chen123037/X100-Flight-Controller-Edu/hardware/proposals/L101_BOURNS_SRP1038A_NOT_APPROVED/README.md

# L101 紧凑10µH电感候选 — 未批准正式采用

**状态更新2026-10-23：本型号已获人工批准并正式集成，见[正式接受记录](../../../docs/L101_FORMAL_ACCEPTANCE.md)。目录名与以下未批准结论保留候选评估当时的历史状态。**

本候选基于正式 `6e1b539`（MCU向右1mm后的基线），唯一CAD执行器 `plant_kicad_v1` 生成。只评估 **Bourns SRP1038A-100M / LCSC C780184** 替代原 **SRP1265A-100M**；保持10µH、Buck IC、补偿阻容、MAIN_SW/5V_MAIN、MCU/IMU/气压计、板框和安装孔。`project/X100_CleanSheet.kicad_pro` 可独立打开；不得整项目覆盖正式工程。

## 实质检查

| 项目 | 结果 |
| --- | --- |
| 元件数 / 网络 | 201电气器件+4孔；网络0变更 |
| 非目标器件 | 其余204个PCB实体的封装/值/pad/net/UUID/path/位置保持 |
| L101 | B面(114,97,0°)；pad1 MAIN_SW、pad2 5V_MAIN；无孔、无VIP |
| fresh ERC / 原生parity | 0错误0警告 / 0问题 |
| 封装一致性 | 库与板上均明确SMD，原生lib mismatch=0；未排除检查 |
| 实体/孔/跨面PTH/关键上下重叠/插拔方向 | 检查为0 |
| 庭院 | 正式172→候选170，无新配对；不是全板DRC通过 |
| L101庭院面积 | 204.913→164.721mm²，节省 **40.192mm²** |
| 电感下缘至SWD孔排的Y投影空间 | 1.73→3.83mm；其余器件仍会限制实际放置 |
| 全板DRC / 未连接 | 599条报告 /411；尚未布线，不能制造 |

按原厂机械图选 **Lead Frame** 版本：外形最大11.5×10.3×4.0mm。推荐焊盘外跨13.6mm、内间距5.4mm、竖向3.5mm，因此每焊盘为 **4.1×3.5mm**，中心距9.5mm；不能把5.4mm误读成焊盘高度。庭院保持围绕最大全包络0.5mm。实际占地收益按焊盘/最大外形计算，不按商品图估算。

电感至D103开关焊盘的最短边距0.5→1.1mm，至C108输出焊盘4.7→6.45mm；是几何距离，不是实际铜线。后续必须重新完成短、宽开关节点、输出电流/反馈取样、GND回流和热布局；不能以面积变小代替电源回路检查。

## 参数与未实测边界

[Bourns原厂](https://www.bourns.com/docs/product-datasheets/srp1038a.pdf)列出10µH±20%、DCR最大30mΩ、Irms7.5A（规定测试条件下温升40°C）、Isat12A（25°C下降20%）；这些不是热态全条件最小值。原型号DCR最大16.5mΩ，换型会增加绕组损耗。未采用更小的4A Irms型号作为当前候选。

按25.2V输入、输出5.5V上界、400kHz、3.5A负载、L=6.4µH等**工程保护性假设**，同时计入1V续流压降和估计热态绕组压降，算得纹波1.950A、峰值4.475A、RMS3.545A。峰值很接近[TI](https://www.ti.com/lit/ds/symlink/tps54360b.pdf)规定的4.5A最低开环限流；这不保证全角落3.5A输出，实际负载预算与瞬态余量必须继续闭合。25°C绕组损耗估计0.377W、125°C估计0.525W，均未包含已测核心/交流损耗。

短路灵敏度计算用6.8A最高开环限流及**假定120ns**延迟得7.273A；TI只有60ns典型延迟，120ns不是保证上界。热态电感、完整频率折返、短路/恢复、补偿和实际温升均留待进一步设计审查及首板测试；本候选 **没有实测PASS，也没有POWER_SAFETY_REVIEW=PASS**。完整输入/假设/输出在 `PARAMETER_SCREEN.json`。

[立创对应记录](https://www.lcsc.com/product-detail/C780184.html)已核对完整型号；不混用`SRP1038AA-100M`。库存与最终采购条件尚须实际确认；未采购、未下单。批准新型号与制造放行是独立事项。`FORMAL_REPLACEMENT_APPROVED=NO`、`FABRICATION_READY=NO`。

本候选保留当前正式MCU/测点位置；未包含未批准的紧凑晶体或USB新电源集成。正式采用需人工确认新exact MPN，再按差异集成并对最新正式源重新检查。
