chen123037/X100-Flight-Controller-Edu/hardware/reviews/X100_C8_LAYOUT_REVIEW/README.md

# X100 c8 中文评审资料

**当前是未完成的布局/布线评审检查点，不能制造、不能下单。** 本目录用于独立评审，不代表把35个USB供电候选正式采用，也不是main的制造放行。

- [下载完整中文评审包](download/X100_中文评审包_c8.zip)；下载后解压再打开工程。
- [先看5页中文指引](00_先读我_中文评审指引.pdf) / [文字版](00_先读我_中文评审指引.md)。
- 唯一当前源入口：[01_KiCad工程_c8/X100_CleanSheet.kicad_pro](01_KiCad工程_c8/X100_CleanSheet.kicad_pro)。
- [11页原理图阅读副本](02_图纸与定位/原理图_c8.pdf)、[定位图](02_图纸与定位/)、[原始检查和网络清单](03_检查证据/)、[邀请文字与反馈模板](04_评审反馈/)。
- [c7回退](05_回退参考_c7/)仅供对照；不把回退板当成当前工程。

电路主体50×50 mm，安装耳总外廓70×52 mm，孔距60×42 mm；240个总封装**包含**65个测试点。四层，双面贴装；没有删除器件或功能。c8还有96项未连接，原理图一致性0，独立重跑ERC0；其它装配、电源及制造问题未关闭。具体范围以中文指引和证据为准。

PCB SHA256：`edc89ce874549e805f218a019f62ca5ebd7cc67f8088a04d4485a3e62591cce0`。

## 公开整理边界

60项源CAD/库表与本地c8逐字节一致；不改原理图、PCB、规则、库或器件身份。仅将公开文档/证据中的本机绝对路径改为包内相对位置或历史占位标记，并补充当前入口和许可说明。历史文档中的路径、命令、授权描述仅供追溯，不是本次评审授权。CAD内部既有资料字段保持原字节，打开工程依赖随附相对库表；缺失可选资料/3D模型不等于可改真实焊盘。

因此**远程ZIP是公开整理版本**，ZIP哈希与此前本地发送版本不同，源CAD哈希不变。校验清单在本目录；下载ZIP的校验值见download目录。

原创硬件、原创文档及KiCad派生库按原有不同许可处理，见[许可说明](07_许可说明/)。本目录不发布第三方厂商PDF、ArduPilot源码、工具服务器、私人聊天或执行缓存。没有生成Gerber/钻孔/CPL制造包，未采购、未下单。
