chen123037/X100-Flight-Controller-Edu/hardware/reviews/X100_C8_LAYOUT_REVIEW/00_先读我_中文评审指引.md

# X100 中文评审包 c8 - 请先读我

## 这次请您做什么

请独立评审现有布局可布性和关键电源设计，并提出具体修改方向。这不是投板验收，也不是默认委托您立即改完整板。请勿直接改原文件；如需试摆，请另存副本，实际工程修改方式和授权另与发起人确认。

先看根目录《00_先读我_中文评审指引.pdf》，再看 `02_图纸与定位/`。愿意深入核对时，用 **KiCad 10.0.6或兼容更新版本** 打开唯一当前入口：

`01_KiCad工程_c8/X100_CleanSheet.kicad_pro`

解压后再打开，不要直接在ZIP里打开。请勿把05目录的c7回退板当作当前工程；无需打开原作者电脑的E盘路径。自定义符号/封装库随工程提供，库表采用KIPRJMOD相对路径；3D模型部分依赖KiCad标准库，部分器件无模型。

## 当前事实及结论边界

- 当前PCB是c8，SHA256：`edc89ce874549e805f218a019f62ca5ebd7cc67f8088a04d4485a3e62591cce0`。
- 总封装240个，**已经包含65个测试点**，不是240+65；双面贴装。
- 电路主体50×50 mm，总外廓70×52 mm包含四个安装耳；四个Ø4 NPTH、孔距60×42 mm，双面Ø7安装包络。安装耳不用作普通器件和关键走线空间。
- 四层，In1保持连续GND；In2分配电源并允许有依据的精选信号，不全面开放。此前算法不收敛和“41%通道面积”都不证明板子必然无法布完。
- 96项未连接、原理图一致性0；间距/短路/孔距/线宽/板边等当前报告项为0，**不等于整板DRC通过**。
- 当前还报告3处铜区相交、丝印与悬空铜等；三类199条触及报告上限，不能当真实总数。Courtyard几何报告212对，其中6组有焊盘-他件Fab凸包交叠，三维实体干涉全部未确认。
- VBUS和CC已接通，不等于USB-only可启动、刷机、枚举或ESD性能通过。DP/DM现为F面0过孔，线宽0.1537mm；主路径0.50mm异网铜筛查只是局部几何检查，端部扇出、参考平面及SI仍需审查。
- 约40pF耦合、约1.01A载流、0.41mm最低线宽等均为带假设的计算估计，非实测、非安全保证；共用电源干线应按合并负载核算。不要把辅助脚本的固定截面输入当新布局验收值。
- 用户没有实板/电流仪表，电流、枚举、切换瞬态等须列首板Bring-up，不能因缺实板反复停止可完成的设计工作。

## 请重点回答

1. 保持50×50主体、四层及现有器件/功能，能否通过合理重新布局完成？请给依据，不以自动路由器失败作为物理无解证明。
2. 主Buck与MCU出线、电源5V干线应怎样联合调整？不要单独拖远D103并拉长开关回路。期望具体摆放/通道草图，不预设历史建议的某个位置一定可行。
3. U109、SD与USB区域是否还需要协同调整？96项剩余连接的合理完成顺序是什么？
4. 六处装配疑点哪些需核对原厂外形/高度，哪些需移位？
5. 如必须改变器件、层数、外形或测试点数量，请给出具体阻塞证据和最小必要变更，先建议、不直接修改。

## 已有约束和功能要求

- 保留现有240总封装、65测试点、功能及既定外形/孔。冻结选型包括STM32H743、BMI088、SPL06-001、8MHz HSE；J401为Amphenol124019772112A/C5430474，L101为BournsSRP1038A-100M/C780184。固定选型不等于所有器件位置都固定；可以提出成组重排建议，旧铜线不是绝对障碍。
- 标准过孔0.60/0.30 mm，clearance0.20、最小线宽0.15、孔间距0.45、全局孔铜0.25、foreign PTH孔铜0.35、铜到板边0.50 mm；禁止VIP/HDI/盲埋孔和全局降规则。具体已有局部特例见项目DRU，不推广使用。
- 叠层目标JLC3313/JLC04161H-3313四层、1.6mm系列，外1oz/内0.5oz；实际板厂材料、铜厚、阻抗及工艺未最终确认。
- USB-only要求A→C/C→C，优先MCU启动、USB枚举、刷写和参数配置，尽可能支持传感器桌面检测；microSD非强制USB负载。不得默认枚举前可取500mA或主机提供1.5A。允许分阶段启动、USB-only≤200MHz，VBAT目标400MHz。USB VBUS不得直接并5V_MAIN，保持反灌、切换和大负载隔离要求。
- 工程含原205实体之外35个USB供电候选；本次保留现状供评审，不代表具体候选方案、全部MPN和电源安全均已正式冻结通过。
- 此前允许J401局部标准过孔换层方案验证，c8实际未采用；若评审建议修改USB拓扑，须重新核查阻抗、回流与净空，不能机械沿用F面宽度结论。

## 包内怎么找

|目录/文件|用途|
|---|---|
|00_先读我_中文评审指引.pdf|短说明、定位图、评审问题|
|01_KiCad工程_c8|完整当前源工程和本地自定义库|
|02_图纸与定位|当前原理图PDF、原生PCB层SVG、中文全板/局部定位图|
|03_检查证据|原始及独立重跑DRC/ERC、96项开路明细、装配疑点、BOM、测试点、核验清单|
|04_评审反馈|可转发邀请文字和反馈模板|
|05_回退参考_c7|只读回退PCB，不是工作入口|
|06_历史原文_仅供追溯|原始交接和过程记录；绝对路径、阶段性判断、脚本命令可能过时，不作本次授权或可直接执行的验收方法|
|SHA256_文件校验清单.txt|包内文件完整性校验|

本次没有提供Gerber/钻孔/CPL制造包，也未授权采购、付款或下单。

原理图PDF末两页的导出视窗处理见“02_图纸与定位/图纸阅读说明.txt”；源CAD未改。

原始原理图部分器件文字/标签本来存在叠压。未为美化而修改源图；请结合符号属性、BOM及“03_检查证据/网络连接表_中文.csv”和原始XML网表核对电气关系。网络连接表是原理图连接，不表示PCB已经布通。

公开版本说明：源CAD保持原字节；仅公开文档/证据去本机路径并补充许可。历史材料不是本次修改授权。
