chen123037/X100-Flight-Controller-Edu/hardware/reviews/X100_C8_LAYOUT_REVIEW/06_历史原文_仅供追溯/Claude原始接手说明.md

# X100 PCB 人工接手说明（c8，2026-10-25）

## 0. 状态声明

- c8 已被用户接受为**当前工作检查点**，c7 保留作回退。**这不代表制造放行。**
- 本交接包**不是可下单版本**：没有生成 Gerber、钻孔和贴片文件，未授权采购和下单。
- Claude 已停止修改工程，等待人工接手。

## 1. 唯一接手工程

| 项目 | 路径 | PCB SHA256 |
|---|---|---|
| **唯一接手工程（在这里改）** | `.\project\X100_CleanSheet.kicad_pro` | `edc89ce874549e805f218a019f62ca5ebd7cc67f8088a04d4485a3e62591cce0` |
| c8 检查点（只读参考） | `HANDOFF_c8_PCB_ENGINEER\checkpoints\c8\X100_CleanSheet.kicad_pcb` | 同上 |
| c7 回退（只读参考） | `HANDOFF_c8_PCB_ENGINEER\checkpoints\c7\X100_CleanSheet.kicad_pcb` | `f9e5335f1552dc8f5db7a194ce065b6a1b20569c146dca23d1b594d87dfd987e` |

- `X100_Takeover\claude_route_1\project` 是 Claude 的工作副本，内容与上表相同，**已冻结，请不要在那里改**。
- `wing_A`（116 项回退）没有改动。
- 工程是自包含的：自定义库 `X100_Physical.pretty`、`X100_MountingHole.pretty` 和 4 个 `.kicad_sym` 都在 `project/` 里，库表用 `${KIPRJMOD}`。3D 模型引用 KiCad 10 自带库。
- 11 个原理图文件与 `wing_A` 逐字节一致。

## 2. 接手授权

用户明确允许接手者做以下事情：

- **协同重排布局：** 在保留全部 240 个器件、65 个测试点和全部电路功能的前提下，可以协同挪动任意器件，包括主 Buck 整组、U104、U105 组、U109、C121 等。
- **重布关键网络：** 必要时可以重布相关的关键网络，包括 USB D+/D−/CC/VBUS、主电源、HSE、SWD、VCAP 等。
- **旧铜线不是绝对限制：** 包括 Codex 和 Claude 在 c1–c8 布的线。为了修复布局，可以删除后重布。

仍然必须遵守的约束：

- **规则：** 4 层，板框和安装孔不变；间距 0.20 mm，最小线宽 0.15 mm，标准过孔 0.60/0.30 mm，孔到孔 0.45 mm，外来 PTH 孔到铜 0.35 mm，铜到板边 0.50 mm。
- **禁止：** 盘中孔、HDI、盲埋孔、全局降低规则。
- **层的用法：** In1 只走 GND；In2 不全面开放走信号。
- **USB：** D+/D− 主线段 0.5 mm 净空；VBUS 不能直接并到 5V_MAIN。
- **器件：** 选型和功能不变，J401、L101、STM32H743、BMI088、SPL06、8 MHz HSE 都已冻结。
- **重布后的复核：** 动过的关键网络（USB 阻抗和净空、HSE、功率回路）要按第 9 节重新验收，不能沿用旧结论。

## 3. 交接包内容

| 目录 | 内容 |
|---|---|
| `project/` | 完整 KiCad 工程（唯一接手工程），不含 MCP 自动备份 |
| `checkpoints/c7`、`checkpoints/c8` | 两个检查点的 PCB |
| `checks/` | c7/c8 的实际 KiCad DRC，各有加和不加 `--refill-zones` 两份；ERC（c7 时跑的，以及在本包工程上新跑的）；c8 电源载流复核；USB 净空检查；courtyard 重叠对；装配冲突证据 `assembly_conflicts_c8.csv`；剩余连接清单 `open_connections_c8.csv` |
| `bom/` | 从原理图导出的 BOM。导出时用的原理图与本工程逐字节一致 |
| `testpoints/` | 测试点登记表，c8 为当前，c7 供对照 |
| `tools/` + `evidence/` | 验收用脚本：USB 净空、电源载流、courtyard 重叠、本体侵入、测试点登记，以及 USB 主线段定义文件 |
| `history/TAKEOVER_STATUS.md` | Claude 接手过程的完整记录：检查点表、每轮改动、错误和更正 |
| `SHA256SUMS.txt` | 包内所有文件的哈希 |

## 4. c8 的实际检查结果（KiCad 10.0.6）

- **DRC**（`--severity-all --schematic-parity`；加不加 `--refill-zones` 结果一致）：
  - 未连接 **96**；
  - clearance、shorting、hole_clearance、track_width、copper_edge、pth_inside_courtyard 均为 0；
  - 原理图一致性 0；
  - zones_intersect 3，courtyards_overlap 199（被截断，实际 212 对），silk_over_copper 199（被截断），silk_overlap 199（被截断），silk_edge_clearance 13，text_height 2，track_dangling 35，via_dangling 20。
- **ERC**（`--severity-all`）：11 张图纸 0 条，见 `checks/c8_erc.json`，在本包工程上运行；c7 时的结果在 `checks/c7_erc.json`，同样为 0。原理图在 c7→c8 之间没有改动。
- **USB：** 主线段 0.5 mm 净空 0 处问题；D+/D− 只在 F.Cu，0 个过孔。
- **剩余未连接：** 96 项，逐项见 `checks/open_connections_c8.csv`。

## 5. 未关闭项（全部未通过，不得视为 PASS）

| 类别 | 状态 | 内容 |
|---|---|---|
| 布线 | **NOT_PASS** | 96 项未连接 |
| 铜区 | **NOT_CLOSED** | 3 处同网铜区重叠：In1 GND `b2e0f961-f47b-4a2b-bbe8-cf443c1398e5` 被另一 GND 铜区完全包含；In2 VBAT_PROTECTED `8b292de8`/`eb42d0b8`；In2 3V3_MCU `c3bfbec9`/`f806272c`。主 Buck 重排后，In2 的 VBAT_PROTECTED 铜区外形要重画。每次保存后存档里的填充都会过期，出图前必须重新填充 |
| 电源 | **NOT_CLOSED** | 5V_MAIN 干线：U104 和 U105 共用，约 1.7 A，现在 0.20 mm（计算值见第 8 节）。开关节点压在 MCU 下，耦合到 3V3 平面（计算值见第 8 节），EMI 未评估。5V_CORE/5V_CORE_MUX/USB_5V_LIMITED 链路有断点。VBAT_PROTECTED 到 C102 只有单过孔。热和压降都未验收 |
| 装配 | **NOT_CLOSED** | 6 处焊盘伸进其他器件本体的二维交叠（第 7 节）；courtyard 重叠 212 对；U403 改到 B 面后的工艺确认（第 6 节）；TP402、TP501 离异网铜只有 0.28/0.27 mm，探针可测性待确认 |
| 制造检查 | **NOT_PASS** | DRC_FINAL 未通过；丝印问题未整理；悬空铜 35/20；制造文件未生成；BOM 的 MPN 和厂家齐全，立创编号缺 227 个 |

## 6. U403（VBUS ESD）和 TP401 换到 B 面：用户已同意，附带条件

用户的条件是：型号、封装、引脚网络正确，并且满足装配、ESD 回流和测试可达性要求。逐项核对如下：

| 条件 | 核对结果 | 状态 |
|---|---|---|
| 型号、封装 | U403 仍是 TPD2E2U06QDBZRQ1、`X100_Physical:TI_TPD2E2U06_DBZ0003A`；TP401 仍是 `X100_Physical:TP0p6_Inline_NoPaste`。与 c7 相同，只是面别变了 | 已核对 |
| 引脚网络 | U403：1 = USB_VBUS_RAW，2 = 不连接，3 = GND；TP401：USB_VBUS_RAW。与 c7 相同；原理图一致性 0 | 已核对 |
| ESD 回流 | U403.3（GND）经约 0.4 mm 长、0.4 mm 宽的线直接到 In1 GND 过孔 (106.01,123.84)。U403.1 到 J401 右组 VBUS 过孔约 2.8 mm（B 面 0.25 mm 线）；左组 VBUS 引脚经 B 面并联铜到 U403 约 7 mm。这些是几何长度，没有做 ESD 仿真或测试 | 几何已核对，性能未验证 |
| 装配 | U403 的 courtyard 与其他器件不重叠，也没有本体侵入。它离 J401 两侧外壳 PTH 焊点的 B 面焊盘约 1.9 mm 和 2.1 mm。如果外壳脚用选择焊或手焊，需要按喷嘴或烙铁空间确认；如果用通孔回流，这一项不存在。U403 为 B 面贴装，要纳入 B 面贴片清单 | **待工艺确认** |
| 测试可达性 | TP401 是 0.6 mm 焊盘，从底面探测，离最近异网铜（U403.2，不连接）0.80 mm。按项目以往使用的同尺寸测试点评估，未按具体探针规格核对 | 待按探针规格确认 |

## 7. 六处装配问题（明细：`checks/assembly_conflicts_c8.csv`）

**判定方法：** 本体 = 封装 Fab 层图形的凸包，焊盘取 PCB 实际形状，只在二维平面上计算交叠面积。凸包可能把引脚轮廓或 1 脚标记也算进去，会偏大。**六项都只是二维几何交叠，没有一项确认了三维实体干涉。** D103、C121、Y201、TP802 的封装都没有 3D 模型，工程内无法做三维检查，需要按器件规格书外形尺寸或实物核对。

| # | 面 | 器件 | 二维证据 | 三维干涉 | 优先级 |
|---|---|---|---|---|---|
| 1 | B | D103（STPS8H100G，D2PAK）/ C121（180 µF OSCON） | D103 的 NC 引脚焊盘有 3.83 mm² 在 C121 本体轮廓内；courtyard 重叠 32.8 mm² | 未确认。NC 脚是实体引脚，可能与 OSCON 底座相碰，需要外形和高度数据 | 高，随区域 A 处理 |
| 2 | F | D102（SMB TVS）/ U103（SOT-23-5） | U103 第 1–3 脚焊盘各 0.14–0.16 mm² 在 D102 本体轮廓边缘内 | 未确认 | 中 |
| 3 | F | D102 / TP802 | TP802 焊盘 0.13 mm² 在 D102 本体内，本体轮廓重叠 0.19 mm² | 未确认 | 中，另影响探针可达性 |
| 4 | B | Y201（8 MHz 晶振）/ R806 | R806.1 焊盘 0.17 mm² 在 Y201 本体轮廓边缘内 | 未确认 | 低–中 |
| 5 | B | Y201 / R603 | R603.2 焊盘 0.17 mm² 在 Y201 本体轮廓边缘内 | 未确认 | 低–中 |
| 6 | F | C115 / U103 | C115.2 焊盘 0.07 mm² 在 U103 本体轮廓内（量很小，可能是凸包造成的） | 未确认 | 低 |

**更正：** 此前我在对话中写过"D103 的 NC 引脚会和 C121 底座相碰"，这是推断，没有经过三维确认。正确表述是：二维交叠 3.83 mm²，三维干涉待核对。

第 2–5 项我试过把相关器件挪 0.35–0.4 mm，都会和相邻过孔产生新的间距违规，所以没有写入，需要交互推挤处理。

## 8. 计算值及其假设（都是根据设计文件的计算，不是实测，也不构成安全 PASS）

### 8.1 开关节点耦合约 40 pF

- **公式：** 平板电容 C = ε0·εr·A/d。
- **假设：**
  - εr = 4.1，d = 0.0994 mm，都取自 PCB 文件叠层中的 3313 半固化片（B.Cu 到 In2）；
  - A = 109.1 mm²，是 B 面 MAIN_SW 铜（焊盘加走线，以 0.05 mm 栅格栅格化）与 In2 3V3_MCU 填充铜的重叠面积；
  - 忽略边缘场、铜厚、填充中的避让孔，不考虑频率特性；
  - 叠层参数没有经过板厂确认。
- **用途：** 只用来比较摆放方案的相对优劣，不能作为 EMI 结论。

### 8.2 载流能力（`tools/power_review.py`）

- **走线：** IPC-2221 外层公式 I = 0.048·ΔT^0.44·A^0.725，A 的单位是 mil²。
  - 外层铜厚按叠层 35 µm（1 oz），成品铜厚没有和板厂确认；
  - 内层按 17.5 µm，用系数 0.024；
  - ΔT 取 20 °C（VBUS 另按 10 °C 核算）；
  - 不考虑环境温度、相邻发热和散热条件。
- **过孔：** 0.3 mm 孔、镀层厚按 25 µm 假设，用内层公式算得约 1.22 A。
- **网络能力：** 沿铜连接图做最大流，单路径，忽略并联铜。各负载**分别**计算，没有把共用路径上的电流相加。
- **负载电流：** 都是设计假设值。U104 取 1.1 A（EXT 5V 预算 1 A 加余量）；U105 取 0.6 A；C108 取 2.45 A；USB VBUS 取 0.5 A，最终核算时按 0.65 A。

### 8.3 最低线宽（同 8.2 的公式和假设）

| 用途 | 电流 | 条件 | 最低线宽 |
|---|---|---|---|
| 5V_MAIN 干线 | U104 + U105 合计约 1.7 A | 温升 20 °C | ≥ 0.41 mm |
| VBUS | 0.65 A | 温升 10 °C | 约 0.17 mm |

- VBUS 现在用 0.25 mm；到 U106 的网络能力约 1.01 A，瓶颈是 U106 附近原有的 0.20 mm 段。
- 5V_MAIN 干线现在 0.20 mm，约 1.0 A。沿现有路径合法加宽的上限是 0.24–0.30 mm（按到相邻异网铜的距离计算）。

## 9. 需要人工处理的区域和动作（按优先级）

### 区域 A：主 Buck 和中央功率区（最先做，决定其他区域）

- **范围：** B 面 x 88–123、y 89–112，以及 F 面上的 R107、C109、R102、R103。
- **器件：**
  - 功率器件：D103、U101、L101、C108；
  - 输入电容：C101、C102、C103、C105、C106；
  - 自举电容 C107；
  - 反馈、补偿、RT：R104、R105、R106、C110；
  - C121。
- **动作：**
  1. 按 TI SNVSB93 第 10 节重排为紧凑功率回路：输入电容 → U101 VIN/GND → D103 阳极 → GND。L101 紧贴 D103 的 K 极焊盘，C108 紧贴 L101 的 5V 端。
  2. 让开关节点铜完全移出 U201 投影（U201 courtyard 下边 y = 100.1）。推荐把功率级放到南半部中间偏西，使 5V_MAIN 源靠近 U104 和 U105；原本在那里的小器件移到 MCU 下方的 B 面，C121 和 U105 组优先靠近 U107。
  3. 同时消除 D103/C121 交叠（第 7 节第 1 项）。
  4. 重画 In2 的 VBAT_PROTECTED 铜区，同时处理 3 处铜区重叠。
  5. 手工重布功率铜：
     - VBAT_PROTECTED 主路径 ≥ 1.6 A；
     - MAIN_SW 按最短最小面积走；
     - 5V_MAIN 到 U104/U105 至少 0.41 mm，或两条并联（第 8 节）。
- **背景数据：** c8 剩余未连接中，有 40 条的直线路径穿过 D103 焊盘、C121、L101 三块区域；16 条南北跨越，SD 总线 MCU 侧 6 根全部在内。

### 区域 B：J401 一带（c8 已基本完成）

- **剩余开路：**
  - USB_VBUS_SENSE 的 MCU 侧（In2 段末端 (108.45,109.75) 到 TP402/U402.4）；
  - VBUS_BUF_A（R403.2 到 R404，北上约 16 mm）；
  - USB_5V_LIMITED（U106.6 到 U105/C124，约 20 mm，随区域 A 调整 U105 位置）；
  - USB_CFG_ACTIVE ×2、USB_PWR_ILIM；
  - GND 小断点：U404.3 到 U109.10，以及 U302.5 旁一处。
- **待确认：** 第 6 节中 U403 的装配工艺和 TP401 的可测性确认。

### 区域 C：SD 总线（MCU → U109 → J501），11 项

- **MCU 侧 6 根：** U201 顶边和右边的引脚到 U109 顶排。依赖区域 A 先完成，然后走 MCU 下方的 B 面。
- **卡侧：** 从 U109 底排到 J501 的 F 面焊盘（y 123.94）和上拉电阻 R502–R506。
- J401 西侧两个外壳孔之间只够走 1 根线。建议 U109 往西靠近 J501，与区域 A 一起规划。

### 区域 D：MCU 周边长线（P2）

- PWM 到顶边连接器，UART、SPI1 到 IMU，CAN，I2C，ADC。
- 区域 A 在 MCU 下方开出 B 面通道后再交互布线。

### 区域 E：U104/EXT 5V 输出链

- U104 应同时靠近 5V_MAIN 源和 F102（PTC）及 EXT_5V 连接器；EXT_SWITCH_OUT 现在需要约 30 mm 才能到 F102。
- 随区域 A 一起定位。

## 10. 验收步骤（全部通过前不得出制造文件）

1. 重新填充铜区，然后跑 `kicad-cli pcb drc --severity-all --schematic-parity --refill-zones`：
   - 未连接 0；
   - clearance、shorting、hole_clearance、track_width、copper_edge、pth_inside_courtyard 均为 0；
   - 原理图一致性 0；
   - 不加 `--refill-zones` 再跑一次，结果要一致。
2. ERC 为 0。
3. `python tools/usb_keepaway.py <pcb>`：0 处问题，D+/D− 0 过孔。如果重布了 USB，还要重新评估阻抗和参考平面。
4. `[历史本机路径] tools/power_review.py <pcb> <out> --plane VBAT_PROTECTED=7.916 --plane 3V3_MCU=9.0`：所有负载 ok。共用路径的电流要相加后再核对。
5. `tools/crt_overlaps.py` 和 `tools/body_overlaps.py`：本体或焊盘侵入为 0；第 7 节各项按三维外形核对后关闭。
6. `tools/tp_register.py`：65 个测试点都在，登记表已更新，探针可测性按实际探针规格确认。
7. 铜区重叠 0；丝印整理完毕；悬空铜 0。

全部通过并经人工审核后，才能用 `kicad-cli pcb export gerbers`、`drill`、`pos` 和 `sch export bom` 生成制造文件。生成之后仍未授权采购和下单。
