chen123037/X100-Flight-Controller-Edu/hardware/reviews/X100_C8_LAYOUT_REVIEW/06_历史原文_仅供追溯/Claude过程记录.md

# X100 接手布线：当前状态（Claude，2026-10-25）

> **已转人工（2026-10-25）：**
> - 用户接受 c8 为当前工作检查点，c7 保留回退。这不代表制造放行。
> - 唯一接手工程：`.\project\X100_CleanSheet.kicad_pro`，PCB SHA256 `edc89ce874549e805f218a019f62ca5ebd7cc67f8088a04d4485a3e62591cce0`。
> - 接手说明见同目录的 `README_接手说明.md`。
> - 本目录 `claude_route_1/project` 已冻结，Claude 不再修改工程。
> - 本文件中的 40 pF、载流和最低线宽都是基于设计文件的计算值（假设见接手说明第 8 节），不是实测。
> - 装配冲突都是二维几何交叠，三维干涉尚未确认（接手说明第 7 节）。

## 1. 工作副本与检查点

- **工作工程：** `X100_Takeover/claude_route_1/project/`，由 `usb_integrated_1/project` 复制而来。所有 CAD 写入只通过 plant_kicad_v1：本会话的 MCP 服务，以及 `tools/plant_client.mjs`（启动同一个 KiCAD-MCP-Server 的 stdio 客户端）。pcbnew 只用于只读检查。
- **未改动：** 主工程 `wing_A`（116 项回退）和 `usb_integrated_1` 均未改动。原理图 11 个文件与 `wing_A` 逐字节一致。

| 检查点 | PCB SHA256 前 16 位 | KiCad 未连接 | 原理图一致性 | 说明 |
|---|---|---:|---:|---|
| c0 | 772cc70fd2c262a8 | 140 | 0 | 交接起点（usb_integrated_1） |
| c1 | 8971b3fb64260a76 | 107 | 0 | 写入 r5 布线（MCP，994 条请求全部成功） |
| c2 | 3a1ca14d0c037549 | 107 | 0 | VBAT 主电源铜皮和并联过孔（MCP） |
| c3 | 75bb96f68b0b8b52 | 107 | 0 | 334 段电源/GND 线加宽（MCP modify_trace），已重新填充铜区 |
| c4 | 9cc55637effa2be0 | 102 | 0 | 第二轮布线 r7（先在试验副本上经 KiCad 验证再写入），再加宽 12 段，已重新填充 |
| c5 | a0ea87e15e1dd0d0 | 102 | 0 | CC1/CC2 引出改造（见 4.1）；恢复 USB 主线段 0.5 mm 净空（c1–c4 被我的布线破坏，见 2.5）。先在试验副本上经 KiCad 验证，再逐条重放写入 |
| c6 | 0b3056d991b6d65b | 100 | 0 | 整板补布 r10（启用 USB 净空、按真实槽孔形状、余量 0.02 mm）：NRST、OUT3、EXT_I2C_SDA_PULLUP、EXT_I2C1_SDA、CURRENT_DIV、3V3_SD 各 −1；GND +2、3V3_MCU +1、3V3_SENSOR +1。关键网络铜几何与 c5 逐段一致 |
| c7 | f9e5335f1552dc8f | 100 | 0 | 电源/GND 再加宽 60 段。其中 3 段因栅格误差多放宽 0.005–0.011 mm，被 KiCad 报出间距违规，已经恢复原宽，现在为 0。**作为回退保留** |
| **c8（当前）** | edc89ce874549e80 | **96** | 0 | J401 一带布局与布线联合调整（候选 V2，见 2A）。USB_VBUS_RAW 两项断点接通，另外 SDMMC1_D0_CARD −1、CORE_BAT_SELECTED −1，没有网络变差。先在隔离副本 `runs/v2` 经 KiCad 验证，再由 plant_kicad_v1 `save_as` 写入工作工程 |

**c8 的 KiCad DRC（`--severity-all --schematic-parity`；加不加 `--refill-zones` 结果一致）：** 未连接 96；clearance、shorting、hole_clearance、track_width、copper_edge、pth_inside_courtyard 均为 0。USB 主线段 0.5 mm 净空：0 处问题。D+/D− 只在 F.Cu、线宽 0.1537、0 个过孔。原理图 11 个文件与 `wing_A` 逐字节一致。其余报告项：

- zones_intersect 3
- courtyards_overlap 199（被截断，实际 212 对，c7 为 220 对）
- silk_over_copper 199（被截断）
- silk_overlap 199（被截断）
- silk_edge_clearance 13
- text_height 2
- track_dangling 35
- via_dangling 20

KiCad 每类违规最多报告 199 条，所以 courtyard 和丝印这几类的真实数量不止此数。

**ERC（新跑）：** 全严重级别 0 条。

## 2. 本轮实际完成的修改

1. **布线（c1）：**
   - 新增 419 段线、100 个 0.6/0.3 过孔。
   - 拆掉并重布了 GND/3V3 的焊盘到过孔短线：392 段、81 个过孔。
   - 结果：未连接 140 → 107。
   - 读回比对：240 个器件位置不变；铜区不变；USB_DP/DM、SWDIO/SWCLK、VCAP1/2、MAIN_*（主 Buck 全部网络）、HSE 三网、VBAT_FUSED/PROTECTED、5V_MAIN 的原有铜几何全部保留；没有新增 In1/In2 走线。
2. **主电源（c2）：** 按最大流计算，假设外层 1 oz、内层 0.5 oz、温升 20 °C、IPC-2221，0.3 mm 过孔按约 1.22 A 计。

   | 网络 | 原来 | 现在 | 做法 |
   |---|---|---|---|
   | VBAT_RAW（J808→F101） | 1.22 A，单过孔 | 4.56 A | 删除旧单过孔路径；F/B 两面加 1.6 mm 铜；4 个并联过孔 |
   | VBAT_FUSED（F101→Q101 漏极） | 1.22 A，单过孔 | 5.57 A | F/B 两面加 1.5 mm 铜；5 个新增过孔 |
   | VBAT_PROTECTED（Q101 源极→U101/C101） | 1.22 A | 2.24 A | Q101 侧新增 1 个过孔接 In2 VBAT 层，加 0.8 mm F/B 铜 |
3. **加宽（c3）：** 只在间距允许的地方加宽，共 334 段，各网络加宽到的目标宽度如下：

   | 网络 | 目标宽度 |
   |---|---|
   | VBAT_* | 1.5 mm |
   | 5V_MAIN | 0.8 mm |
   | 5V_CORE_MUX、USB_VBUS_RAW | 0.5 mm |
   | 3V3_MCU、3V3_SD、GND | 0.4 mm |
   | 3V3_SENSOR | 0.3 mm |

   其余段因间距不足仍是窄线，见第 4 节。
4. **铜区填充：** 已用 MCP `refill_zones` 写盘。注意：交接时文件里的填充是过期的，不重新填充时 DRC 报 46 条 clearance 和 41 条 hole_clearance，都是过孔压在 In1/In2 平面上。**出 Gerber 前每次都必须重新填充。**

5. **我自己引入、又已修正的回退：USB 主线段 0.5 mm 净空。**
   - **经过：** 交接时（c0），用 Codex 同一判据检查 34 段 USB 主线段，0 处问题。我跑 r5/r7 时，布线器还不认识这条要求，把 3V3_MCU、GND 过孔，以及 EXT_I2C_SDA_PULLUP、SD_BUS_OE_N、SD_POWER_GOOD、SDMMC1_D3_CARD 的部分走线放进了 0.5 mm 以内。c1 有 32 处问题，c4 有 33 处。KiCad DRC 只查 0.2 mm，所以没有报出来。
   - **修正（c5）：** 删除这 18 个铜件，在布线器启用主线段净空约束后重布。结果 0 处问题。代价：EXT_I2C_SDA_PULLUP 和 3V3_MCU 各多 1 项未连接。这两项在 c0 本来就没接通，r5 之所以能接通，正是因为违反了净空。
6. **USB 接口侧改造（c5）：** 见 4.1。包括 D+/D− 扇出重走、两个 CC 过孔，以及 TP307、TP505 两个测试点移位。

## 2A. 本轮：布局与布线联合调整（c7 → c8）

按用户要求，本轮停止开发和反复调参布线器，改为调整摆放。新增的工具只做摆放检查（pcbnew 只读）：

- `tools/place_trial.py`：内存中试摆，检查 courtyard、焊盘间距、外来 PTH 孔、板边，并支持保留区（禁止进入的矩形）；
- `tools/rip_plan.py`：给出挪动器件后要删掉的旧铜，只清理本次挪动新产生的悬空短线，原有的半成品走线不动；
- `tools/crt_overlaps.py`、`tools/body_overlaps.py`：courtyard 重叠和本体侵入分类；
- `tools/tp_register.py`：测试点登记表。

布线器只按原 r10 配置运行，没有改代码、也没有改参数。

### 候选 U1（不采用）

- **做法：** 把 J401 下方 B 面的 R403、TP402、TP308、R304、TP501、TP502、TP504 移走，再补布。
- **KiCad 结果：** 未连接 101，比 c7 多 1；间距违规 0；USB_VBUS_RAW 仍是 2 项。
- **失败原因：**
  - 我把 TP402 放进了 VBUS 唯一的东出带（B 面 x 113–115、y 119.4–121）；
  - 布线器把 CC1/CC2 当作受保护网络，不会去动 c5 时留下的 CC2 过孔。

  这两点都是我的摆放错误，不是几何无解。

### 候选 V2（采用为 c8）

**挪动的器件**（全部只用 0.60/0.30 过孔，无盘中孔，规则未降低）：

| 器件 | 原位置 | 新位置 | 说明 |
|---|---|---|---|
| U403（VBUS ESD，TPD2E2U06） | F (103.30,116.30) | **B** (107.40,123.20) 180° | **换面，请确认**。新位置在 J401 正下方，VBUS 脚到右组 VBUS 过孔约 2.8 mm，GND 脚经约 0.4 mm 线直接到 In1 GND 过孔，比原位置更靠近连接器 |
| TP401（VBUS） | F (102.00,113.50) | **B** (110.20,124.20) | 测试点换面，从底面探测 |
| R403（VBUS 检测输入） | B (109.64,121.67) | B (116.90,120.00) | 靠近 U402 |
| TP402（VBUS_SENSE） | B (110.87,122.27) | B (113.00,123.40) | 紧挨 U402.4 |
| TP501（3V3_SD） | B (106.17,122.53) | B (97.60,117.40) | |
| TP502（SDMMC1_CK_CARD） | B (106.11,124.11) | B (87.60,119.20) | 靠近 J501 |
| TP504（SDMMC1_D0_CARD） | B (107.99,124.02) | B (89.20,119.20) | 靠近 J501 |

**手工布线和清理：**

- **VBUS 东出线：** B 面，0.25 mm，约 9.1 mm。从右组 VBUS 过孔 (108.74,119.51) 斜下，在东侧两个外壳孔之间 y=121.95 穿过：离上下焊盘 0.45 mm，离孔边 0.70 mm。之后沿 y=121.1 走到 R403.1，再用 1.45 mm 短线接到原有 VBUS 主线 (116.0,118.55)。
- **TP401：** 用一条竖线接到上述 VBUS 线。
- **删除 CC2 无用支线：** F 面 (112.74,119.1)→(110.1,119.1) 和悬空过孔 (110.1,119.1)。这段是我在 c5 留下的。
- **我自己引入并已修正的两个问题：**
  1. 布线器为了给 SDMMC1_D0_CARD 让路，拆掉了 J501.4（SD 卡 VDD）的 3V3_SD 供电线并且没能补回，原因是 TP502 被我放在原 D0_CARD 走线上。已把 TP502 改到不压任何走线的位置，并按 c7 原坐标恢复这几段铜。
  2. 修剪 D0_CARD 悬空短线时，新连线离 CMD_CARD 过孔只有 0.185 mm，KiCad 报出后已改为 0.15 mm 线宽，间距恢复到 0.235 mm。

**验证（KiCad，`runs/v2` 与写入后的 `project/` 结果相同）：**

- 未连接 100 → 96；
- 逐网络比较，只有减少没有增加：USB_VBUS_RAW −2、SDMMC1_D0_CARD −1、CORE_BAT_SELECTED −1；
- clearance、shorting、hole_clearance、track_width、copper_edge 均为 0，加不加 `--refill-zones` 一致；
- USB 主线段 0.5 mm 净空 0 处问题，D+/D− 仍 0 过孔；
- 读回比对：240 个器件，7 个移位；铜区不变；USB_DP/DM、SWD、VCAP、MAIN_*、HSE、VBAT_*、5V_MAIN 原有铜全部保留。

**VBUS 到保护和限流器件的连通（KiCad 读回）：**

- J401 A4/B9/A9/B4、U403（ESD）、TP401、R403、C401、C123、C136、U106（TPS2553 输入）、U112 现在是同一个网络；
- 最大流 1.01 A，瓶颈是 U106 附近原有的 0.20 mm 段；需求 0.65 A，合格。

### 主 Buck 整组调整评估（结论：需人工）

**主电源区确实挡住了 MCU 出线（实测）：**

- 开关节点 MAIN_SW 在 B 面共 139.7 mm² 铜，其中 127.8 mm² 在 U201 投影内，占 MCU 投影的 41%。
- 109 mm² 正对 In2 3V3_MCU 平面，平板耦合约 **40 pF**。**更正：** 上一版写的约 20 pF 是粗估偏小。
- c8 剩余未连接中，40 条的直线路径穿过 D103 焊盘、C121、L101 三块区域。南北向跨越 16 条，SD 总线 MCU 侧 6 根全部在内。
- **新发现的装配冲突：** D103 的 NC 引脚焊盘有 3.8 mm² 落在 C121（OSCON）本体下。

**为什么这一轮没有做出 CAD 候选：** 要把开关节点移出 MCU 投影并保持紧凑功率回路，就必须同时挪动 D103、U101、L101、C108、输入电容和补偿网络，以及原本在南半部的约 20 个小器件，共约 30 个。另外两件事 plant_kicad_v1 做不到：

- 重画 In2 的 VBAT_PROTECTED 铜区外形；
- 让走线跟随器件移动。

只挪器件不重布功率铜的"摆放候选"既无法验证功率回路，又会让全部功率网络断开，没有工程意义。

具体目标和步骤写在交接文件 `handoff/PCB_ENGINEER_HANDOFF.md` 的区域 A。

### U104 供电瓶颈（结论：需人工或配合 Buck 调整，更正了需求）

- **更正：** U104（1.1 A）和 U105（0.6 A）共用 L101 → 分支过孔 (100.22,110.92) 这段约 16 mm、0.20 mm 宽的 5V_MAIN 干线，合计约 1.7 A。上一版只按 U104 单独 1.1 A 判断，低估了问题。
- **实测：** 沿现有路径逐段计算到相邻异网铜的距离，合法加宽上限只有 0.24–0.30 mm（约 1.15–1.36 A），挡路的是 C121、C102、R102 的焊盘和 3V3/5V_CORE_MUX 过孔。1.7 A 需要 ≥ 0.41 mm（IPC-2221，外层 1 oz，温升 20 °C），或者两条并联路径。
- **结论：**
  - 原地加宽不能解决；
  - 走 In2 会切开 3V3 和 VBAT 平面，超出"不全面开放 In2"的范围，没有做；
  - 把 U105 组东移到 U106/C108 附近可以把干线负载降到 U104 单独的 1.1 A，但东侧按不新增 courtyard 重叠、不压非 GND 铜的条件，找不到合法位置。

  所以 U104 瓶颈要和主 Buck 一起重排。

### 制造问题（本轮推进）

- **真实装配冲突（焊盘或本体伸进别的器件本体）：** 6 对，清单见 `handoff/assembly_conflicts_c7.csv`，c8 未变。
  - 最严重的是 D103/C121。
  - 其余 5 对（D102/U103、D102/TP802、Y201/R603、Y201/R806、C115/U103）是 0.07–0.46 mm² 的边缘侵入。我试过把相关器件挪 0.35–0.4 mm，都会和相邻过孔产生新的间距违规，需要交互式推挤调整，没有写入。
- **courtyard 重叠：** 212 对，其中 206 对本体不相碰。
- **BOM：** 235 行的 MPN 和厂家都齐全，立创编号缺 227 个。
- **悬空铜：** 35/20（交接时 54/31），剩下的主要是还没接通网络的半成品走线。
- **制造文件：** 板子还有 96 项未连接，这一轮不生成 Gerber 和贴片文件，以免被误当成可下单的版本；导出步骤写在交接文件里。
- **铜区重叠：** 3 处，仍需授权，操作和以前一样。

## 3. 剩余未连接（c8：96 项；完整清单：`checks/c8_open_list.json`；以下分析基于 c7 的 100 项）

c7 共 100 项：P1 51 项，P2 49 项。

**按成因逐项分类**（工具：`tools/router2.py` 的 CLASSIFY 模式；结果：`runs/classify_c5.json`，基于 c5 的 104 条连接；只用 F/B 两层，执行 USB 0.5 mm 净空）：

| 类别 | 数量 | 含义 |
|---|---:|---|
| 固定焊盘/摆放所限 | 2 | 只保留焊盘、孔、板边，仍然无路 |
| 关键网络铜所挡 | 2 | 只被 USB/CC/SWD/VCAP/主电源/HSE/In2 的铜挡住 |
| 普通现有走线所挡 | 97 | 让开普通走线后各自都有路径 |
| 现在就能布 | 3 | 布线器排序问题，其中 2 项是我的模型与 KiCad 不一致的 GND |

- **固定焊盘/摆放所限：** 1 项 GND 落孔，1 项 TP402 的 USB_VBUS_SENSE。
- **关键网络铜所挡：** 2 项都是 U108 附近的 3V3_SD。
- **普通现有走线所挡：** 这说明剩下的主要是**整体通道容量（拥塞）问题**，而不是单点的几何死路。出现最多的阻挡网络依次是 GND 64、CORE_BAT_SELECTED 42、3V3_MCU 37、SDMMC1_D3_CARD 28、BMI088_GYRO_CS 25、EXT_FAULT 23、SD_BUS_OE_N 20。

**为什么剩下的布不完（实测证据，不是估算）：**
- **顺序拆线重布已到顶：** 多轮下来都停在约 100 项，c6 那轮 r10 只多布通了 2 项。
- **协商拥塞路由（PathFinder）不收敛：** 新写的协商拥塞模式会拆掉 268 组非关键旧线、88 个网络共 423 条连接，然后每轮全部重新协商。拥塞价格从每格 4 提高到每格 172（另一组参数从 20 到 80），重叠走线一直约 210–240 条，约 75 条连接放不下，不收敛。中途修过一个我自己的错误：拉直路径时会穿过别网的新线。修正后结论不变。
- **容量估算（c7，只用 F/B，保留关键网络铜）：**
  - 0.15 mm 线中心可合法通过的面积：F 面约 1320 mm²，B 面约 1189 mm²；
  - 待布的 276 条普通连接，最短曼哈顿长度合计约 2976 mm，按 0.35 mm 线距算，需要约 1041 mm² 的通道，约占自由面积的 41%；
  - 这还没算绕行和交叉需要的换层过孔，而且自由面积非常碎。
- **结论：** 以上三条和"逐项单独可布、合在一起布不下"的分类结果一致。在现有摆放和"只用外层"的前提下，这块板已经接近布线容量上限。这是很强的证据，但严格说还不是数学证明。

下面的分项数字是 c3 时的，只供参考。

- **P1（供电、USB、启动、复位、SD 电源控制），52 项。** 关键的有：
  - USB_CC1、USB_CC2 各 1 项；
  - USB_VBUS_RAW 2 项、USB_VBUS_SENSE 1 项、VBUS_BUF_A 2 项、USB_5V_LIMITED 1 项、USB_PWR_ILIM 1 项、USB_CFG_ACTIVE 2 项；
  - 5V_CORE_MUX 3 项、5V_CORE 1 项、CORE_BAT_SELECTED 3 项、CORE_ACTIVE 1 项；
  - NRST 2 项；
  - EXT_5V 3 项、EXT_SWITCH_OUT 2 项、EXT_FAULT 1 项；
  - 3V3_SD 5 项、3V3_SENSOR 3 项、3V3_MCU 3 项、SENSOR_LDO_IN 2 项、MCU_VDDA 1 项；
  - GND 3 项；
  - SD_* 控制 4 项。
- **P2（信号），55 项：**
  - SDMMC 主机侧和卡侧共 17 项；
  - PWM OUT1–5 共 5 项；
  - UART（TELEM/RC/GPS）共 9 项；
  - SPI1 和 BMI088 片选共 8 项；
  - CAN 4 项；
  - I2C 共 9 项；
  - ADC 3 项。

## 4. 已查实的具体卡点（不是估算）

1. **USB_CC1、USB_CC2 出口：已在隔离试验副本中解决（更正版）。**
   - **更正：** 上一版写 J401 的焊盘是 0.3×1.0 mm，这是错的。读回 PCB 实测：
     - A/B 两排信号焊盘都是 0.25×0.75 mm，A1/A12 两侧的 GND 焊盘是 0.30×0.75 mm；
     - A 排 y 范围 119.85–120.60，B 排 y 范围 121.10–121.85，两排之间的通道高 0.50 mm；
     - 相邻引脚间隙 0.25 mm；
     - 四个外壳脚是 PTH 椭圆孔，0.45×1.45/1.65 mm。

     据此，"CC 完全出不来、唯一出口是盘中孔"这个结论不成立，已撤回。
   - **按成因重新分类：**
     - **固定焊盘造成的（真实的几何限制）：** 一根 0.15 mm 线连同两侧 0.20 mm 间距需要 0.55 mm，所以 CC 不能从引脚之间横向穿出，也不能沿两排之间的通道走。单层拓扑上，D+ 直连 A6–B6 之后，D− 必须从一侧绕行，因此 CC1 落在 D− 的绕线圈内、CC2 落在 D+ 的绕线圈内。两个 CC 都必须在各自圈内打一个过孔换到 B 面。
     - **现有走线造成的（可以调整）：**
       - D+ 沿 B 排下方的那段离 B5 只有 0.22 mm，没有给 CC2 留下引出通道；
       - D− 的上横段离 A5 只有 0.67 mm，能过一根线，但放不下过孔；
       - B 面 TP307 到 BARO 过孔的斜线、TP505 到 U109.15 的短线，以及 VBUS 桥接线的一段，挡住了 U109 东侧唯一的走廊和 U109 下方那条向东的通道。
     - **可移动器件占位：** TP307、TP505 两个测试点（C131 已试过，没有合法的新位置，保留原位）。
     - **工具能力（我自己布线器的问题）：** 布线器把外壳脚的椭圆孔按直径 1.45 mm 的圆处理，误判少了约 0.5 mm 空间，已改成按实际槽形计算。另外布线器自带 0.03 mm 的安全余量，会漏掉只剩 0.05–0.08 mm 余量的合法通道。
   - **已实施（试验副本 `runs/usbfix/project`，全部经 plant_kicad_v1 写入）：**
     - **D− 扇出：** A7 先斜到 x=107.98，上横段从 y=119.1 抬到 118.62；
     - **D+ 扇出：** B 排下方那段降到 y=122.56，从两个外壳脚之间的缝里以 y=122.15 穿过，上横段抬到 118.45；
     - **CC2：** 从 B5 向下进入 B 排下方新开的通道，在 y=121.72 处穿过外壳脚之间，沿 x=112.74 上行，在 (112.56,119.06) 打过孔换到 B 面，接到原有 CC2 的 B 面走线；
     - **CC1：** 在 A5 正上方 (107.30,119.27) 打过孔，B 面沿 U109 下方的通道（离引脚 ≥0.2 mm）向东，在 (111.96,117.56) 打过孔回到 F 面，接到 CC1 原有的 F 面走线；
     - **TP307：** 移到 B 面 (113.90,118.40)，紧挨 BARO 过孔；
     - **TP505：** 移到 F 面 (110.20,116.90)，紧挨它原有的过孔。它只是一个裸测试焊盘，换面不影响装配，但测试面变了，请确认；
     - **SDMMC1_D1_CARD：** 删除了原来绕远的走线和孤立过孔；
     - **VBUS：** 删除了桥接线中挡路的几段。
   - **验证（KiCad DRC，`--severity-all --schematic-parity --refill-zones`，试验副本）：**
     - USB_CC1、USB_CC2 的未连接都从 1 变为 0；其余网络的未连接数与 c4 相同；
     - clearance、shorting、hole_clearance、track_width、copper_edge、pth_inside_courtyard 均为 0；原理图一致性 0；
     - D+/D− 仍然只在 F.Cu、线宽 0.1537、0 个过孔；主线段 36 条全部保留；
     - USB 主线段 0.50 mm 净空按 Codex 同一判据（34 段）检查：0 处问题。
   - **USB_VBUS_RAW 出口：c8 已解决（见 2A，靠调整 J401 一带的摆放，没有用 USB 换层）。** 下面保留的是 c7 时对"方案1"（J401 附近 USB 数据线局部换层）的评估：方案1单独解决不了，没有写入工程。
     - **载流核算（0.4 mm 不是真实下限）：**
       - **电流上限：** USB VBUS 经 TPS2553（U106）限流。HIGH 档 60.4 kΩ ±0.1%，限流 389.8–488.2 mA；LOW 档 50–100 mA（项目文档 `USB_CORE_STAGE3_REVIEW.md`、`USB_CORE_POWER_REVIEW.md`）。
       - **核算电流：** 按 0.5 A，加项目规则的 30% 余量，取 0.65 A。
       - **所需线宽：** IPC-2221 外层 1 oz、温升 10 °C 时只需约 0.17 mm；0.20 mm 线在温升 10 °C 时约可载 0.75 A。
       - **压降：** 0.25 mm 宽、20 mm 长、0.5 A 时约 20 mV。
       - **结论：** VBUS 用 0.25 mm、局部颈缩到 0.20 mm 都合规。0.4 mm 只是我布线器的预设宽度，不是物理限制。

       VBUS 卡住的原因是走廊被占用，而不是线宽。
     - **叠层和阻抗依据（如果采用换层）：**
       - **叠层对称：** PCB 文件中的叠层是 F.Cu / 3313 半固化片 0.0994 mm（εr 4.1）/ In1 / 芯板 1.265 mm / In2 / 3313 半固化片 0.0994 mm（εr 4.1）/ B.Cu，外层铜厚都是 35 µm。B 面微带线用 0.1537/0.20 几何时，阻抗模型与 F 面相同，前提是 In2 在走线下方是完整平面。
       - **参考平面：** J401 一带的 In2 是 **3V3_MCU 平面，不是 GND**。换层后回流要经 3V3 平面，并通过附近的 3V3–GND 去耦电容回到 GND；每个换层过孔旁都需要有去耦路径，B 面段要尽量短。
       - **ESD 路径：** 换层段位于连接器和 U401（TPD2E2U06）之间，ESD 器件仍在 MCU 之前，不会被旁路。每个过孔约增加 0.5 nH 电感。
       - **结论：** 不能直接沿用 F 面"90 Ω 已验收"的结论，必须按上面的条件另行复核。
     - **评估过的换层拓扑（都没有采用）：**
       - **T1：D+ 走 B 面，D− 在 F 面跨两排之间的通道直连。**
         - 过孔：D+ 3 个（A6 上方、B6 下方、TP403 附近），D− 0 个；B 面段约 3.5 mm 加 1.5 mm。
         - 失败原因：CC1 的过孔只能放在 A5 上方，而它在 B 面正好落在 C131.1（3V3_SD）上。C131 在 9 mm 范围内搜索，合法位置只有离 U109.20 约 8 mm、而且在 CC2 走廊里的 4 个点，去耦效果不可接受。
       - **T2：D− 走 B 面。** 和 T1 是同一个 CC1/C131 冲突，D− 回到 F 面的落点过孔也压在 C131 上。
       - **T3：保留 c5 的 D+ 通道斜线和 D− 上行段，把两个绕线圈都换成 B 面跳线。**
         - 过孔：D+ 2 个，B6 下方约 (107.90,122.75)、TP403 附近约 (109.75,119.20)；D− 2 个，B7 下方约 (106.60,122.70)、D− 上行段旁约 (108.20,118.90)。
         - B 面段：每根约 3.6–4 mm。支线：A/B 两排引脚并联形成约 2–4 mm 的固有支线，对 12 Mbps FS 可以忽略。
         - 失败原因：两个落点过孔都必须放在 U109 底排引脚（y=118.20）和 J401 之间那条约 1.7 mm 宽的 B 面带里，而这条带同时是 CC1 唯一的东向通道。跳线还在 B 面把左右两组 VBUS 隔开，两组需要各自出线，但都没有出路。
     - **不换层的替代尝试：** 把 R403 和 TP402 移开，腾出右侧两个外壳脚之间的 B 面缝隙，让 VBUS 向东接 U112.2。
       - 第一次放置时，我的检查脚本按"两个焊盘同一个网络"判断 R403，结果把它放到了一条现有 VBUS 走线上，产生了 1 处短路。KiCad DRC 当场报出，该副本作废，没有写入工程。
       - 修正为逐焊盘按网络检查后，R403 附近唯一的合法位置是 (113.25,115.0)，也就是 CC2 的 B 面走廊，离 J401 约 6 mm，会进一步堵塞走廊。
     - **结论：VBUS 是真实的空间冲突。** 下列东西都要挤过同一条约 1.7 mm 宽的 B 面带和 U109 东侧走廊：CC1、两组 VBUS、任何 USB 换层落点。四周被以下东西包围：
       - J401 的四个外壳脚（固定）；
       - U109（20 脚，不属于小范围移位）；
       - 9 个已没有合法新位置的小器件：C131、R403、TP402、TP308、R304、TP501、TP502、TP504、3V3_SENSOR 过孔。

       要解开，需要动 U109 或这组小器件，这超出现有"局部移位"的范围，需要裁决；或者交人工处理。
     - **测试点记录：** 见 `TESTPOINTS_c7.csv`（与 c5 相同），65 个测试点（F 面 37、B 面 28）。只有 TP505 和 TP307 有变化：
       - TP505 从 B 面移到 F 面 (110.20,116.90)，用户已接受，探针可从顶面接触，最近的器件是 1.4 mm 外的 U404；
       - TP307 仍在 B 面，移到 (113.90,118.40)。

2. **板中央 B 面被 D103 的 K 极大焊盘（MAIN_SW 开关节点，约 12×10 mm）占满，正好在 MCU U201 下方。** 两个后果：
   - MCU 的大部分长出线（SDMMC 到 U109、PWM 到排针、UART、SPI 到 IMU）只能在 F 面竞争有限的通道。剩余 P2 基本都属于这一类。
   - 叠层是 F / In1 GND / In2 3V3 / B，所以开关节点正对 In2 的 3V3 平面。按实际铜区重算：109 mm² 正对 3V3_MCU 平面，耦合约 40 pF（上一版粗估 20 pF 偏小，已更正）。开关沿会向 3V3 注入尖峰，必须纳入电源/EMI 审查。
3. **5V_MAIN 到 U104（EXT 5V 开关输入）：** 有一段约 28 mm 的跨板长线，其中 0.2 mm 的瓶颈段（B 面 (111.1,102.1) 附近）因间距不足无法加宽，约 1.01 A。**更正：** 这段干线同时供 U105，合计约 1.7 A，至少需要 0.41 mm，见 2A。
4. **其他电源余量：**
   - VBAT_PROTECTED 到 C102 是单过孔，约 1.22 A。C102 是第二颗输入电容，承受的是纹波电流，需要按实际纹波核算。
   - VBAT_PROTECTED 主路径 2.24 A ≥ 1.6 A（3S 满载输入），但没有达到 3 A 保险丝的等级。
5. **路由器实验结论：** 我实测了三种策略，未连接都收敛在约 100–110 项：
   - 只拆 GND/3V3 短线，只用 F/B；
   - 拆所有非关键旧线（改动 1364 处，侵入性太大，没有采用）；
   - 再加上 In2 上的精选低速控制线（约 95 项）。

   从 c3 再跑第二轮（r7），只多布通了 5 项（107→102），收益已经明显递减。说明在现有摆放下，外层通道和过孔位已经接近饱和。剩余连接需要局部挪动器件、人工推挤布线，或者开放更多内层。

## 5. 需要人工裁决的事项

1. **铜区重叠：** 3 处同网铜区重叠，plant_kicad_v1 没有删除或修改铜区的接口（`delete_graphic` 只处理图形，`delete_trace` 只处理走线）。具体修复操作：
   - In1 GND：删除内层铜区 `b2e0f961-f47b-4a2b-bbe8-cf443c1398e5`。它完全被外层 GND 铜区包含，且设置完全相同，删除后填充结果不变。
   - In2 VBAT_PROTECTED：铜区 `8b292de8` 和 `eb42d0b8` 只部分重叠，需要合并成一个外形相同、设置相同的铜区。
   - In2 3V3_MCU：铜区 `c3bfbec9` 和 `f806272c` 同样需要合并。

   最小权限需求是二选一：授权一次用 pcbnew 脚本只改这 3 处（按 UUID 操作，前后各跑一次 DRC 和填充比对）；或者授权给 MCP 服务器加一个铜区删除接口。
2. **In2 精选低速信号：** 是否允许走 In2，范围是 GENERAL_DIGITAL 和 LOW_SPEED_CONTROL 类，并完全避开 VBAT 区域。实验显示约能多布通 10–15 项，代价是 3V3 平面上会多出若干切口，最终是否接受要以平面连通性复核为准。
3. **USB VBUS 出口（CC1、CC2 已解决）：** 方案1（USB 数据线局部换层）已评估，单独不能解决，见 4.1。剩下的选择：
   - **移动 U109：** 例如向北移约 1.5 mm，把 U109 下方的 B 面带拓宽到约 3 mm。代价是要重布 U109 的 SDMMC 引线。
   - **整体外迁 J401 下方的 B 面小器件：** 需要接受 C131 离 U109.20 更远（约 8 mm），并逐个找合法位置。
   - **交人工推挤布线：** 处理这一块约 10×8 mm 的区域。
4. **D103 开关节点焊盘在 MCU 正下方：** 是否接受，还是重排主 Buck。重排会影响已经接通的主电源环路。
5. **剩余约 100 项需要的资源，至少选一项：**
   - (a) 开放 In2 走精选低速信号（试验约多布通 14 项）；
   - (b) 释放摆放空间，重点是 U109/J401 一带，以及 D103 压在 MCU 下方的开关节点；
   - (c) 交人工推挤布线。没有 (a) 或 (b) 的话，人工也会碰到同样的容量问题。
6. **剩余布线是否交给人工：** 推荐用 KiCad 交互式推挤布线完成剩余连接，我负责之后的全板复核。

### 本轮（c8）后的人工交接

本轮按用户要求，把现有工具做不了的部分整理成交接文件：`handoff/PCB_ENGINEER_HANDOFF.md`。

- **区域 A：** 主 Buck 和中央功率区，含 U104 干线、D103/C121 装配冲突、In2 铜区重画。
- **区域 B：** J401 一带的剩余项。
- **区域 C：** SD 总线（MCU 侧依赖区域 A）。
- **区域 D：** MCU 周边长线。
- **区域 E：** U104/EXT 5V 输出链。
- 另附制造问题清单和验收步骤。

**需要用户确认：** U403（VBUS ESD）从 F 面换到 B 面；TP401 从 F 面换到 B 面。

## 6. 状态标记（都有实证依据，未通过的一律不标 PASS）

- `PCB_DESIGN_COMPLETE = NO`：c8 还有 96 项未连接。
- `ERC_FINAL`：当前 ERC 为 0，但 PCB 尚未完成，不能作为最终结果。
- `DRC_FINAL = NOT_PASS`：96 项未连接、3 处 zones_intersect、6 对真实装配冲突、courtyard 和丝印未清理。
- `POWER_SAFETY_REVIEW = NOT_CLOSED`：
  - VBAT 并联过孔已补；USB VBUS 到 U106 已接通（1.01 A ≥ 0.65 A）；
  - 5V_MAIN 干线（U104 + U105 合计约 1.7 A，现在 0.20 mm）未解决；
  - 5V_CORE 链路仍有断点；
  - 开关节点 EMI（约 40 pF 耦合到 3V3）、热和压降都未验收。
- `PCB_MANUFACTURING_PACKAGE = NOT_READY`
- `READY_FOR_HUMAN_FABRICATION_APPROVAL = NO`
