chen123037/X100-Flight-Controller-Edu/hardware/reviews/X100_C8_LAYOUT_REVIEW/07_许可说明/项目文档许可.md

# 教学文档开放许可（Documentation License）

Documentation © project contributors<br>
Licensed under CC BY 4.0

项目原创教学文档采用 **Creative Commons Attribution 4.0 International（CC BY 4.0，SPDX：CC-BY-4.0）**。适用README.md、STATUS.md、HANDOFF.md及docs/中由项目贡献者原创的教学、架构解释、接手、验证计划与协作说明。

在许可证条件下可以复制、分享、修改和制作衍生教学文档，包括商业用途；须合理署名、提供许可链接并注明修改，不暗示原作者背书，不添加限制许可权利的额外条款。以上是便于学生理解的说明，正式条件见[CC BY 4.0官方许可页](https://creativecommons.org/licenses/by/4.0/)及[完整法律文本](https://creativecommons.org/licenses/by/4.0/legalcode.en)。

建议署名为“X100 project contributors”，保留[项目来源](https://github.com/chen123037/X100-Flight-Controller-Edu)、许可链接和已有适用通知；修改者说明改动及日期。

## 适用边界

- CERN-OHL-P-2.0许可正文、第三方KiCad库许可文件、第三方库文档/原许可通知、厂商datasheet/drawing/catalog及其引用内容不因放在本仓库或docs/中而改用CC BY 4.0。
- 本文对项目自行编写的说明适用CC BY 4.0；其中引用的第三方许可正文及原厂内容仍保留各自权利。原厂资料以外部链接提供，没有把第三方PDF复制进本仓库。
- 原创KiCad硬件设计和项目原创symbol/footprint部分采用[CERN-OHL-P-2.0](硬件许可_CERN-OHL-P-2.0.txt)；第三方库派生部分按[第三方说明](https://github.com/chen123037/X100-Flight-Controller-Edu/blob/feature/pcb-fabrication-readiness/docs/THIRD_PARTY_NOTICES.md)和[原许可文件](KiCad库原许可.md)执行。
- 当前未发布软件/固件源码，不附加MIT等软件许可。ArduPilot仅为外部软件目标，未复制进入本仓库；未来工具/固件许可另由维护者裁决。

开放许可允许依许可条件使用与制作，但不表示当前设计已经制造或飞行验收。当前c8仍未完成布线、NOT FABRICATION READY、NOT FLIGHT VALIDATED；真实工作门槛见[STATUS](https://github.com/chen123037/X100-Flight-Controller-Edu/blob/feature/pcb-fabrication-readiness/STATUS.md)。
