chen123037/X100-Flight-Controller-Edu/HANDOFF.md

# 当前六层工程接手说明

从[当前目录](hardware/current/X100_6L_DFM_ZERO_DANGER/)和[KiCad工程](hardware/current/X100_6L_DFM_ZERO_DANGER/project/X100_CleanSheet.kicad_pro)接手。下载[完整包](hardware/current/X100_6L_DFM_ZERO_DANGER/download/X100_六层当前版_工程制造及清单.zip)后解压；不要从旧hardware/X100_V1或c8开始改，也不要用旧Gerber或CPL下单。

当前全部连接完成，PCB DFM所报危险0。制造ZIP身份、35项计数、freshERC/DRC、网表和源文件校验在当前目录；56条库副本差异及468条黄色未被隐藏。该文件集是当前PCB订单输入资料，整板热接受及工厂工艺/生产稿确认仍需完成，不宣告所有放行项PASS。

## 保留的约束

STM32H743VIT6、BMI088、SPL06-001、8MHz晶振、Amphenol124019772112A及L101SRP1038A-100M保持。D103保留STPS8H100G-TR大封装。当前六层、安装耳及孔位、26TP、器件位号与实际源规则以新工程为准；旧四层/65TP约定已不是当前状态。

正常PCB编辑继续用plant_kicad_v1；仅已明确批准且工具无法表达的丝印/叠层/局部规则等例外可限定直接处理。不得全局降低规则、擅自移动器件或删除功能。新位置及架构重大变化按人工既有要求报告，已批准的同一器件或限定操作不重复申请。

## 下一步

1. 按当前真实铜与保留负载/环境闭合U101/D103整体热设计，明确计算/估计/待实测，不能凭DFM0代替。
2. 审核实际订单的六层叠层、沉金、高精字符、U101六孔树脂填孔＋电镀盖帽；其它孔保持用途与原Gerber开窗。
3. 结合已有裁决核对候选采购字段与完整MPN；当前原生CPL只供装联审稿，需审核面别/角度/吸附原点及贴片来源。
4. 保存生产稿与最终人工接受结论，再开展首板限流上电、USB/SD/CAN/传感器、温升、固件、无桨和分级飞行验证。

旧c8及旧正式源均保留。公开整理只复制当前源与证据，没有重新绘制PCB、改MCU引脚或修改源选型。
