chen123037/X100-Flight-Controller-Edu/docs/PUBLIC_REPO_AUDIT.md

# 公开仓库交接与文档审计（Public Handoff Audit）

日期：2026-10-13。**以下为文档交接提交前的历史staging审计快照。** 基线为`X100_V1_PRE_ROUTING_TEACHING_BASELINE`，来源为`PCB02C2_BLOCKER_CHECKPOINT`。本轮完成中文交接文档和派生采购表，不修改硬件、不恢复PCB设计。

| 项目 | 结论 |
| --- | --- |
| DOCUMENTATION_COVERAGE_AUDIT | COMPLETE：实际阅读12类内容，补足功能/接口/采购/术语/路线图 |
| CHINESE_PRIMARY_DOCUMENTATION | YES：中文主体，英文技术标识保留 |
| FEATURE_LIST_READY | YES：14类功能＋成熟度矩阵＋65个TP索引 |
| INTERFACE_PINOUT_READY | YES：16个J接口、79个逻辑pin；NC/电源/地/信号明确 |
| PROCUREMENT_LIST_READY | YES：178个派生归组/状态行；每板134个独立采购零件实例 |
| CHINESE_DEVICE_NAMES_READY / CHINESE_MODULE_NAMES_READY | YES / YES |
| GLOSSARY_READY / ROADMAP_READY | YES / YES：41词条；Stage0–11＋STAGE USB-PWR |
| README_NAVIGATION_READY / DOCUMENT_CROSSCHECK_PASS | YES / YES |
| HARDWARE_FILES_CHANGED | 0：全部53个公开硬件文件不变 |
| 工程BOM / 元件状态 | 200 / 203条，两个源CSV均未改动 |
| Fresh ERC / DRC | 0错误/0警告；644违规＋405未连接；真实J6013/J4014未隐藏；另有USB-only功能阻塞 |
| PCB | 201个电气封装＋4孔；45×45mm；30.5×30.5mm孔距，Ø4 NPTH |
| Routing / Tracks / Vias / Zones | NOT STARTED / 0 / 0 / 0 |
| 制造放行 / 飞行验证 | NO / NOT STARTED |
| 公开目录secret / personal-info /本机绝对路径扫描 | PASS / PASS / 0 |
| 硬件可移植性 | 已有基线PASS；本轮硬件hash保持，隔离副本fresh导出/检查成功 |
| GitHub目标 | chen123037/X100-Flight-Controller-Edu，人工已建立的公开仓库 |
| 首次push | 本轮未执行，文档人工review后再决定上传 |
| USB_ONLY_CORE_POWER_REQUIREMENT_DOCUMENTED | YES |
| USB_ONLY_CORE_POWER_CURRENT_IMPLEMENTATION | NOT_IMPLEMENTED |
| USB_ONLY_CORE_POWER_V1_REQUIREMENT | REQUIRED |
| USB_POWER_ECO_REQUIRED_BEFORE_PCB03 | YES |
| 最终自有硬件许可证 | 待人工选择；LICENSE_DECISION与第三方原许可保持 |

本记录随文档提交，具体commit hash以`git log -1`为准，提交说明为`Complete Chinese public handoff documentation`。提交前/后已核对文件允许清单与源hash；自动检查原始结果保留在公开目录外，不复制私人执行历史。

## 核验范围

- 正式57个源文件与既有67个checkpoint证据保持原hash。公开硬件53文件、原始BOM两个CSV和未授权路径保持字节不变。
- 隔离副本重新导出fresh netlist并执行ERC/DRC；201个component、逐pin连接与原冻结网表一致，PCB保持205个封装对象、四层且走线/过孔/铺铜为0。
- 接口表覆盖全部外部J连接器；每个Net/Pin原样保留，MP无Net、SH重复物理焊盘与明确NC分别解释。JP601终端默认OPEN/NO PASTE，无独立采购件，R602未推断为DNP。
- 派生采购表按源Value、MPN、厂家、封装、Footprint、规格/公差/介质/额定值和状态归组，Reference覆盖原200条＋JP601，另记录4孔与2个未采用候选；数量与源逐项核对。Workbook值及CSV回读一致，前导零不丢失。
- 文档交叉核对尺寸/孔距、三颗核心器件、USB/microSD/CAN exact MPN、201封装、routing状态、两类阻塞、终端机制与链接。中文仅解释，不翻译机器标识或重命名子页。
- 扫描文本、PNG真实文本/EXIF元数据、Git配置/日志与解压对象；不把压缩像素或二进制对象ID当文本。没有携带厂商PDF、临时脚本、checkpoint ZIP或本机日志。

## 仍缺的信息与门槛

USB-only核心供电架构/电流预算/反灌与双源审查、最小ECO和相关实板状态矩阵验收；J601局部器件位置释放的人工裁决；JLCPCB对USB4105-GF-A官方land的明确制造接受；microSD官方land/样品与装机访问证据；SPL06-001资料可追溯性；底面净空、热插拔/TVS/启动/反灌/热态实测；板级固件/台架/飞行验证；正式线束、外设、机械附件及最终硬件许可证。没有用文档完成替代上述验证。

## 当前精选文件清单

共83个内容文件。硬件及图片来自首次公开基线；本轮仅提交允许的Markdown与派生采购CSV。`BASELINE_HASHES.sha256`保留为初始基线校验快照，更新文档以Git版本为准。

```text
.gitattributes
.gitignore
HANDOFF.md
LICENSE_DECISION.md
README.md
STATUS.md
bom/X100_V1_BOM.csv
bom/X100_V1_PROCUREMENT_LIST.csv
bom/component_status.csv
docs/ARCHITECTURE.md
docs/BASELINE_HASHES.sha256
docs/BRINGUP_PLAN.md
docs/COMPONENT_SELECTION.md
docs/FEATURES.md
docs/GLOSSARY.md
docs/INTERFACES.md
docs/KNOWN_ISSUES.md
docs/PCB_RULES.md
docs/PORTABILITY.md
docs/POWER_ARCHITECTURE.md
docs/PROCUREMENT_GUIDE.md
docs/PUBLIC_REPO_AUDIT.md
docs/ROADMAP.md
docs/SOURCES.md
docs/THIRD_PARTY_NOTICES.md
hardware/X100_V1/01_POWER.kicad_sch
hardware/X100_V1/02_MCU.kicad_sch
hardware/X100_V1/03_SENSORS.kicad_sch
hardware/X100_V1/04_USB.kicad_sch
hardware/X100_V1/05_SD.kicad_sch
hardware/X100_V1/06_CAN.kicad_sch
hardware/X100_V1/07_UART_IO.kicad_sch
hardware/X100_V1/08_PWM_ADC_DEBUG.kicad_sch
hardware/X100_V1/X100_CleanSheet.kicad_dru
hardware/X100_V1/X100_CleanSheet.kicad_pcb
hardware/X100_V1/X100_CleanSheet.kicad_pro
hardware/X100_V1/X100_CleanSheet.kicad_sch
hardware/X100_V1/X100_MountingHole.pretty/MountingHole_4mm.kicad_mod
hardware/X100_V1/X100_Physical.kicad_sym
hardware/X100_V1/X100_Physical.pretty/Bosch_BMI088_LGA16.kicad_mod
hardware/X100_V1/X100_Physical.pretty/Bourns_SRN6045.kicad_mod
hardware/X100_V1/X100_Physical.pretty/Bourns_SRP1265A.kicad_mod
hardware/X100_V1/X100_Physical.pretty/CAN_SolderJumper_2_Open_Pad1p0x1p5_NoPaste.kicad_mod
hardware/X100_V1/X100_Physical.pretty/Goertek_SPL06_001_LGA8.kicad_mod
hardware/X100_V1/X100_Physical.pretty/Littelfuse1812L200_12DR.kicad_mod
hardware/X100_V1/X100_Physical.pretty/Official_Capacitor_SMD_C_0603_1608Metric.kicad_mod
hardware/X100_V1/X100_Physical.pretty/Official_Capacitor_SMD_C_0805_2012Metric.kicad_mod
hardware/X100_V1/X100_Physical.pretty/Official_Capacitor_SMD_C_1210_3225Metric.kicad_mod
hardware/X100_V1/X100_Physical.pretty/Official_Connector_Card_microSD_HC_Molex_104031-0811.kicad_mod
hardware/X100_V1/X100_Physical.pretty/Official_Connector_JST_JST_GH_SM04B-GHS-TB_1x04-1MP_P1.25mm_Horizontal.kicad_mod
hardware/X100_V1/X100_Physical.pretty/Official_Connector_JST_JST_GH_SM06B-GHS-TB_1x06-1MP_P1.25mm_Horizontal.kicad_mod
hardware/X100_V1/X100_Physical.pretty/Official_Connector_USB_USB_C_Receptacle_GCT_USB4105-xx-A_16P_TopMnt_Horizontal.kicad_mod
hardware/X100_V1/X100_Physical.pretty/Official_Diode_SMD_D_SMB.kicad_mod
hardware/X100_V1/X100_Physical.pretty/Official_Diode_SMD_D_SOD-123F.kicad_mod
hardware/X100_V1/X100_Physical.pretty/Official_Fuse_Fuse_Littelfuse-NANO2-451_453.kicad_mod
hardware/X100_V1/X100_Physical.pretty/Official_LED_SMD_LED_0805_2012Metric.kicad_mod
hardware/X100_V1/X100_Physical.pretty/Official_Package_QFP_LQFP-100_14x14mm_P0.5mm.kicad_mod
hardware/X100_V1/X100_Physical.pretty/Official_Package_SO_SOIC-8_3.9x4.9mm_P1.27mm.kicad_mod
hardware/X100_V1/X100_Physical.pretty/Official_Package_SO_TSSOP-14_4.4x5mm_P0.65mm.kicad_mod
hardware/X100_V1/X100_Physical.pretty/Official_Package_TO_SOT_SMD_SOT-23-5.kicad_mod
hardware/X100_V1/X100_Physical.pretty/Official_Package_TO_SOT_SMD_SOT-23-6.kicad_mod
hardware/X100_V1/X100_Physical.pretty/Official_Package_TO_SOT_SMD_TSOT-23-6.kicad_mod
hardware/X100_V1/X100_Physical.pretty/Official_Resistor_SMD_R_0805_2012Metric.kicad_mod
hardware/X100_V1/X100_Physical.pretty/Panasonic_OSCON_B6.kicad_mod
hardware/X100_V1/X100_Physical.pretty/Panasonic_OSCON_C6.kicad_mod
hardware/X100_V1/X100_Physical.pretty/Panasonic_OSCON_E12.kicad_mod
hardware/X100_V1/X100_Physical.pretty/STPS8H100G_D2PAK_A_K_TabK_NoVIP.kicad_mod
hardware/X100_V1/X100_Physical.pretty/Samtec_TSW10207GS_1x2_P2p54.kicad_mod
hardware/X100_V1/X100_Physical.pretty/Samtec_TSW10507GS_1x5_P2p54.kicad_mod
hardware/X100_V1/X100_Physical.pretty/TCAN3414_D0008A_SOIC8.kicad_mod
hardware/X100_V1/X100_Physical.pretty/TI_TPD2E2U06_DBZ0003A.kicad_mod
hardware/X100_V1/X100_Physical.pretty/TP0p6_Inline_NoPaste.kicad_mod
hardware/X100_V1/X100_Physical.pretty/TP1p5_NoPaste.kicad_mod
hardware/X100_V1/X100_Physical.pretty/TPS54360B_DDA0008B_NoVIP.kicad_mod
hardware/X100_V1/X100_Physical.pretty/Taitien_XJ_2Pad_5p5x2p0_P9p0.kicad_mod
hardware/X100_V1/X100_Physical.pretty/VBAT_PAD_PAIR_V1.kicad_mod
hardware/X100_V1/fp-lib-table
hardware/X100_V1/sym-lib-table
images/pcb_bottom.png
images/pcb_top.png
images/pcb_two_side_overlay.png
images/power_architecture.png
licenses/KICAD_LIBRARIES_LICENSE.md
```

## 不包含的材料

历史候选/TEST_ONLY铜板、原厂PDF/目录/图纸、原始运行日志/audit dump、本机manifest、缓存/autosave、临时Python/Node builder、checkpoint ZIP、unused库、参考工程原件和ArduPilot第三方源码。文档完成后STOP，不启动PCB03，不替用户选择许可证，不在review前push。

## 首次公开发布许可通知

2026-10-13人工已接受该文档基线，并授权首次公开push。原创硬件许可正式确定为CERN-OHL-P-2.0，原创教学文档为CC BY 4.0，见[当前许可决定](../LICENSE_DECISION.md)与[文档许可](LICENSE_DOCUMENTATION.md)。上文“许可证待选择”“review前不push”等描述记录的是此前staging节点，不是新许可/发布裁决；实际发布版本和push状态以Git提交及远程main为准。

许可与公开发布不改变工程门槛：三个布线前工作仍未完成，没有制造/飞行放行。本次不恢复任何PCB设计。
