chen123037/X100-Flight-Controller-Edu/hardware/current/X100_6L_DFM_ZERO_DANGER/evidence/power_reference/README.md

# 尚未关闭的电源与热审查参考

这些是当前六层源之前父级的计算参考，source_PCB_sha256以各文件原记录为准。没有把它们重新命名为当前V4实测、当前整板热PASS或制造放行。

保留6S输入、1.883A连续/2.448A容量工况、50°C环境、邻近热源敏感性和原极端风险。最后的局部检查没有建立必须再改某器件或铜的证据，但整体有效热阻、互热、实际制造工艺接受仍未关闭。

实际文件中POWER_SAFETY_REVIEW未签署，通过DFM不能覆盖。缺少的首板电流/温升实测与尚未完成的投板前设计判断分别记录。

公开复制去除本机绝对路径；原参考SHA和公开副本SHA见上级EVIDENCE_ORIGIN.json，不混作同一字节文件。
