chen123037/X100-Flight-Controller-Edu/hardware/reviews/X100_C8_LAYOUT_REVIEW/02_图纸与定位/图纸阅读说明.txt

本目录图片和SVG仅供定位，均以c8源工程生成；背面定位图按统一板坐标显示，未镜像。
原理图PDF共11页：前9页来自根图原生PDF导出；第10/11页源图元贴近纸张边界，为避免裁切，改用对应子图原生SVG扩大视窗后显示，另附完整视窗SVG便于矢量放大。仅调整导出文件画布，未改动任何源原理图、符号、网络或PCB。PDF不作为层级跳转入口，需精确导航时请用KiCad。
定位图不是1:1制造图，不能用于下单或三维装配判定。

原始原理图部分器件文字/标签本来存在叠压。未为美化而修改源图；请结合符号属性、BOM及“03_检查证据/网络连接表_中文.csv”和原始XML网表核对电气关系。网络连接表是原理图连接，不表示PCB已经布通。
