chen123037/X100-Flight-Controller-Edu/hardware/reviews/X100_C8_LAYOUT_REVIEW/04_评审反馈/评审意见填写模板.md

# X100 独立评审意见（请按实际判断填写）

本次仅评审，不默认授权改板、换器件、采购或下单。可直接在定位图上标注后回传。

1. 现有50×50电路主体、四层、240总封装（含65测试点）是否可行？
   - 结论：可行 / 可行但需重新布局 / 资料不足 / 需变更约束
   - 具体依据、受限区域及还需要的资料：
2. 主Buck、MCU出线、U104/U105：推荐怎样协同摆放？请给草图、坐标或关键走线通道；不要只写“太密”。
3. U109、SD总线与USB区域：可保留什么，建议怎样调整？
4. 六处二维装配疑点：哪些是真干涉，哪些是Fab凸包/间隙模型造成？还需哪些外形/高度数据？
5. 电源、USB及制造：还有哪些会阻止首板制造的实质问题？请区分已确认、估算及待测。
6. 若必须改器件、板框、层数或删测试点：请说明原因和最小必要变更，不默认已经批准。
7. 如果愿意继续做设计：建议工作范围、交付物及所需资料。请先与发起人确认修改方式和授权。
