chen123037/X100-Flight-Controller-Edu/docs/C8_WORK_SUMMARY.md

# X100 c8：工作归档与远程发布说明

## 这次发布解决什么

此前这些布局、布线及Claude续作主要保存在本地，远端仍停留于提交5a6129b的282项未连接候选。本次把最新c8源工程、c7回退、中文评审PDF/定位图、原理图/网表/BOM/测试点、原始和独立检查以及历史更正集中上传到[独立评审目录](../hardware/reviews/X100_C8_LAYOUT_REVIEW/)，并更新仓库主入口。不是制造发布，不覆盖旧正式源、不合并main、不采购下单。

## 工作脉络与实际结果

| 阶段 | 实际结果 / 比较边界 |
| --- | --- |
| 远端旧候选 | 282项未连接；原618条其它违规有类别截断，不能当完整总数 |
| 安装耳A与电源区重排 | 主体50×50、总外廓70×52、孔距60×42；主Buck、HSE、次级Buck及VCAP1局部工作保存。全板仍未完成 |
| Codex主支路 | 120→116项；SWDIO/SWCLK、关键主电源/HSE等连接保持。原DSN来源误标已纠正，不能比较成USB136→116 |
| USB整合c0 | 140项；USB数据、SWD、VCAP同时成立，部分其它支路被拆后待恢复。与主支路116不是同一路径优化比较 |
| Claude c1–c4 | 140→107→102；电源/地加宽、并联过孔及信号进展。但曾侵入USB主段0.50mm净空，不能把这些中间版当最终合规成果 |
| c5 | CC1/CC2已接通；修复上述USB净空回退，总数仍102。撤回错误焊盘尺寸和“只有VIP能出线”的结论 |
| c6/c7 | 100项；部分关键线接通同时部分GND/3V3支路回退，局部加宽误差已修复 |
| c8 | **96项**；VBUS−2、SDMMC1_D0_CARD−1、CORE_BAT_SELECTED−1，相对c7逐网只减不增；U403/TP401换B面，测试点清单更新；仍未制造通过 |

以上是在声明范围的工程结果，不是启动、SI、热态、ESD或电源安全测试。没有保留每个失败实验的临时副本、缓存或路由器开发代码；保留当前完整源、必要回退、证据及历史说明，避免误打开失败板。

## 当前证据和未关闭事项

源PCB SHA256：`edc89ce874549e805f218a019f62ca5ebd7cc67f8088a04d4485a3e62591cce0`。60项CAD/库表保持源字节；11张原理图；240总封装已包含65测试点。独立重跑ERC0、DRC96未连接/parity0；其它报告670条，其中三类各199触顶。完整计数、源文件校验和CSV明细见[检查证据](../hardware/reviews/X100_C8_LAYOUT_REVIEW/03_检查证据/)。

仍有主电源/MCU通道及U104/U105共用干线问题、96项连接、3处铜区相交、6组二维装配疑点、丝印/悬空铜和最终DFM。212对Courtyard重叠不是212处实体碰撞；6组也尚未做三维确认。约40pF、载流和最低线宽是模型估计。35个USB供电候选的正式接受尚未关闭；c8不是新器件/架构采购批准。

## 对外评审问题

请先判断现有四层/主体/器件下的可行性，给主Buck、MCU通道和U109/USB/SD区域的具体协同布局意见。不要用路由器不收敛或41%自由面积估算宣判不可完成，也不预设挪动一块就解决全部问题。若有必要变更，说明局部证据及最小方案。工程仍由负责人控制授权；本次外部委托是评审。

## 可追溯性与公开整理

`hardware/X100_V1`旧正式CAD未改。旧入口全文保存在[历史目录](history/pre_c8/)。最新评审目录的CAD不改字节；公开文档/证据只做路径去本机化和许可/入口补充，并重新计算清单。因此远程ZIP哈希不等于本地原ZIP，PCB及60项源CAD哈希相同；请用远程ZIP附带清单核对。

原始历史接手说明里有尚未独立验证的布局建议和带本机背景的旧命令，保留追溯但不作为可直接执行的验收规范。尤其不能给新布局传入旧固定平面截面值就宣布载流通过。

所有制造/电源/装配门槛保持未关闭，详见[STATUS](../STATUS.md)。本次提交仅归档和公开文档整理，没有继续CAD设计，也没有生成制造包。
