chen123037/X100-Flight-Controller-Edu/hardware/current/X100_6L_DFM_ZERO_DANGER/evidence/JLC_DFM_NATIVE_REPORT_0_DANGER.pdf

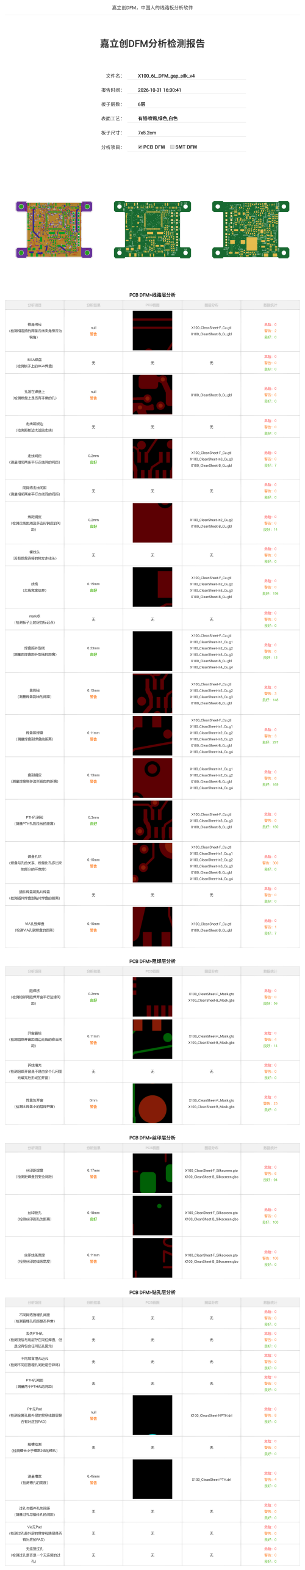
[picture p8: page 1]
