chen123037/X100-Flight-Controller-Edu/hardware/proposals/USB_CORE_MINIMAL_NOT_APPROVED/evidence/MOUNTING7_RESOLUTION.csv

Hole | Reference | OldSide | OldX_mm | OldY_mm | OldDistanceFromHoleCentre_mm | OldRadialIntrusion_mm | NewSide | NewX_mm | NewY_mm | NewAngle_deg | NewDistanceFromHoleCentre_mm | NewMarginBeyond7mmContact_mm
H1 | TP201 | F.Cu | 86.2 | 87.8 | 2.9808 | 0.5192 | F.Cu | 87.525 | 91.0 | 0.0 | 6.444232 | 2.944232
H1 | TP704 | F.Cu | 84.425 | 87.85 | 2.8001 | 0.6999 | F.Cu | 87.425 | 87.85 | 0.0 | 3.671597 | 0.171597
H1 | J702 | F.Cu | 80.705 | 91.0 | 2.5969 | 0.9031 | F.Cu | 80.705 | 92.8 | 270.0 | 3.624038 | 0.124038
H1 | J802 | F.Cu | 78.95 | 82.0 | 2.48 | 1.02 | F.Cu | 82.1 | 78.95 | 90.0 | 4.53 | 1.03
H1 | J601 | F.Cu | 89.3 | 80.705 | 2.4817 | 1.0183 | F.Cu | 91.55 | 80.705 | 180.0 | 3.624038 | 0.124038
H1 | R602 | B.Cu | 81.5 | 85.0 | 2.5812 | 0.9188 | B.Cu | 79.5 | 87.0 | 0.0 | 4.204914 | 0.704914
H1 | Y201 | B.Cu | 89.0 | 91.0 | 2.0 | 1.5 | B.Cu | 90.85 | 91.0 | 270.0 | 3.85 | 0.35
H1 | U601 | B.Cu | 83.0 | 89.5 | 2.3 | 1.2 | B.Cu | 83.0 | 90.8 | 0.0 | 3.6 | 0.1
H1 | F102 | B.Cu | 87.5 | 80.0 | 3.025 | 0.475 | B.Cu | 89.75 | 79.8 | 0.0 | 3.620311 | 0.120311
H2 | TP206 | F.Cu | 111.875 | 85.425 | 3.0978 | 0.4022 | F.Cu | 109.975 | 87.3 | 0.0 | 5.46014 | 1.96014
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
