chen123037/X100-Flight-Controller-Edu/hardware/current/X100_6L_DFM_ZERO_DANGER/images/U101六孔_板厂定位图.png

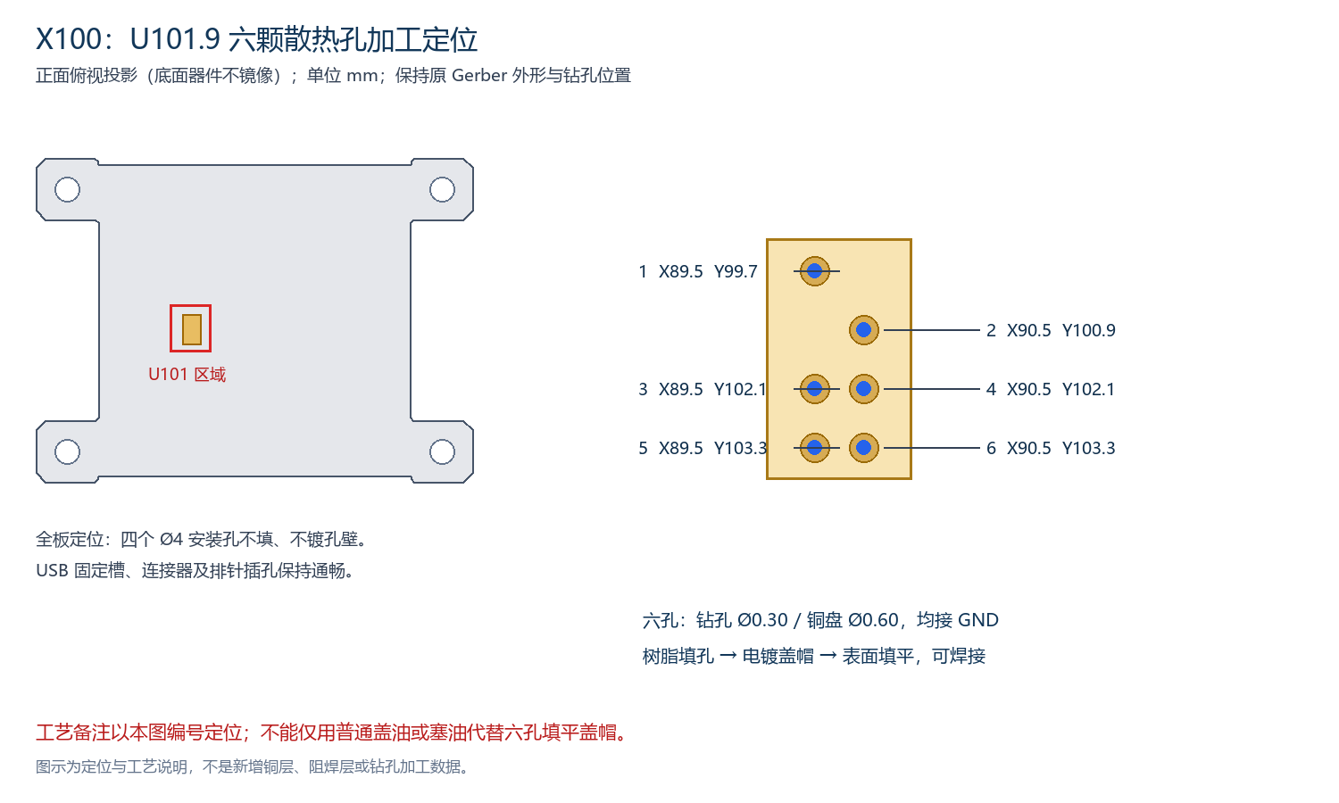
hardware/current/X100_6L_DFM_ZERO_DANGER/images/U101六孔_板厂定位图.png
