chen123037/X100-Flight-Controller-Edu/hardware/reviews/X100_C8_LAYOUT_REVIEW/02_图纸与定位/02_全板背面_定位.png

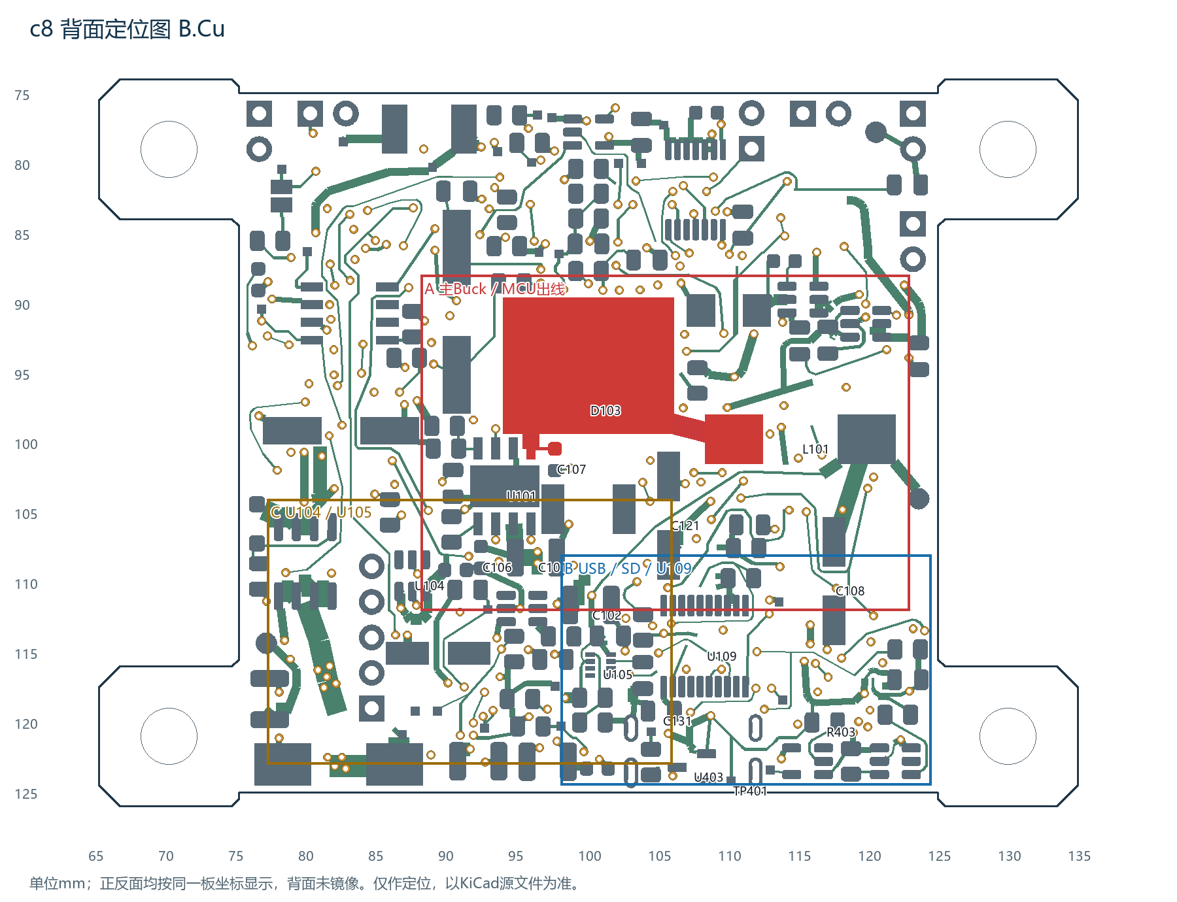
hardware/reviews/X100_C8_LAYOUT_REVIEW/02_图纸与定位/02_全板背面_定位.png
