chen123037/X100-Flight-Controller-Edu/images/pcb_bottom.png

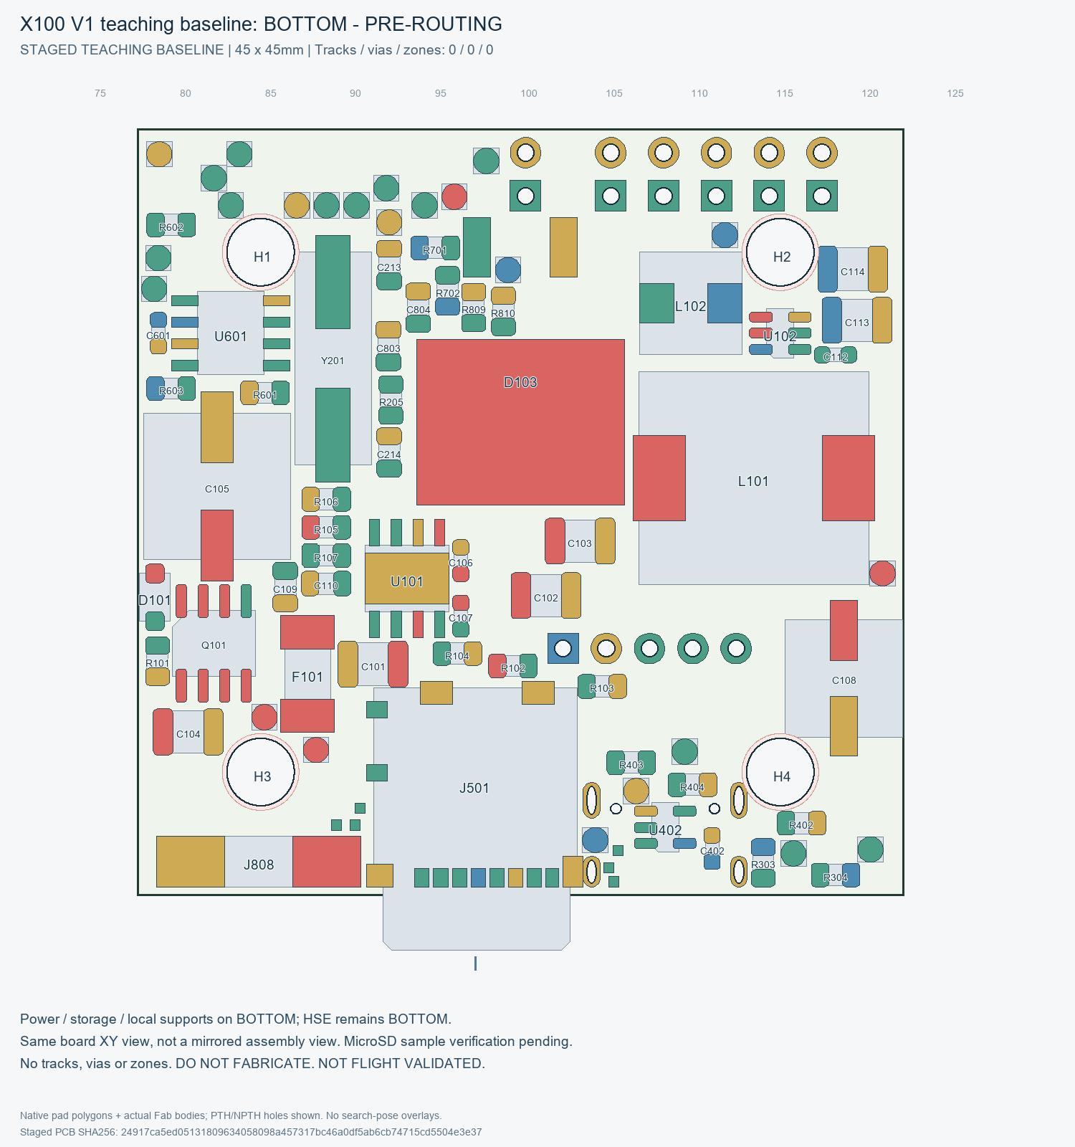
images/pcb_bottom.png
