chen123037/X100-Flight-Controller-Edu/images/pcb_top.png

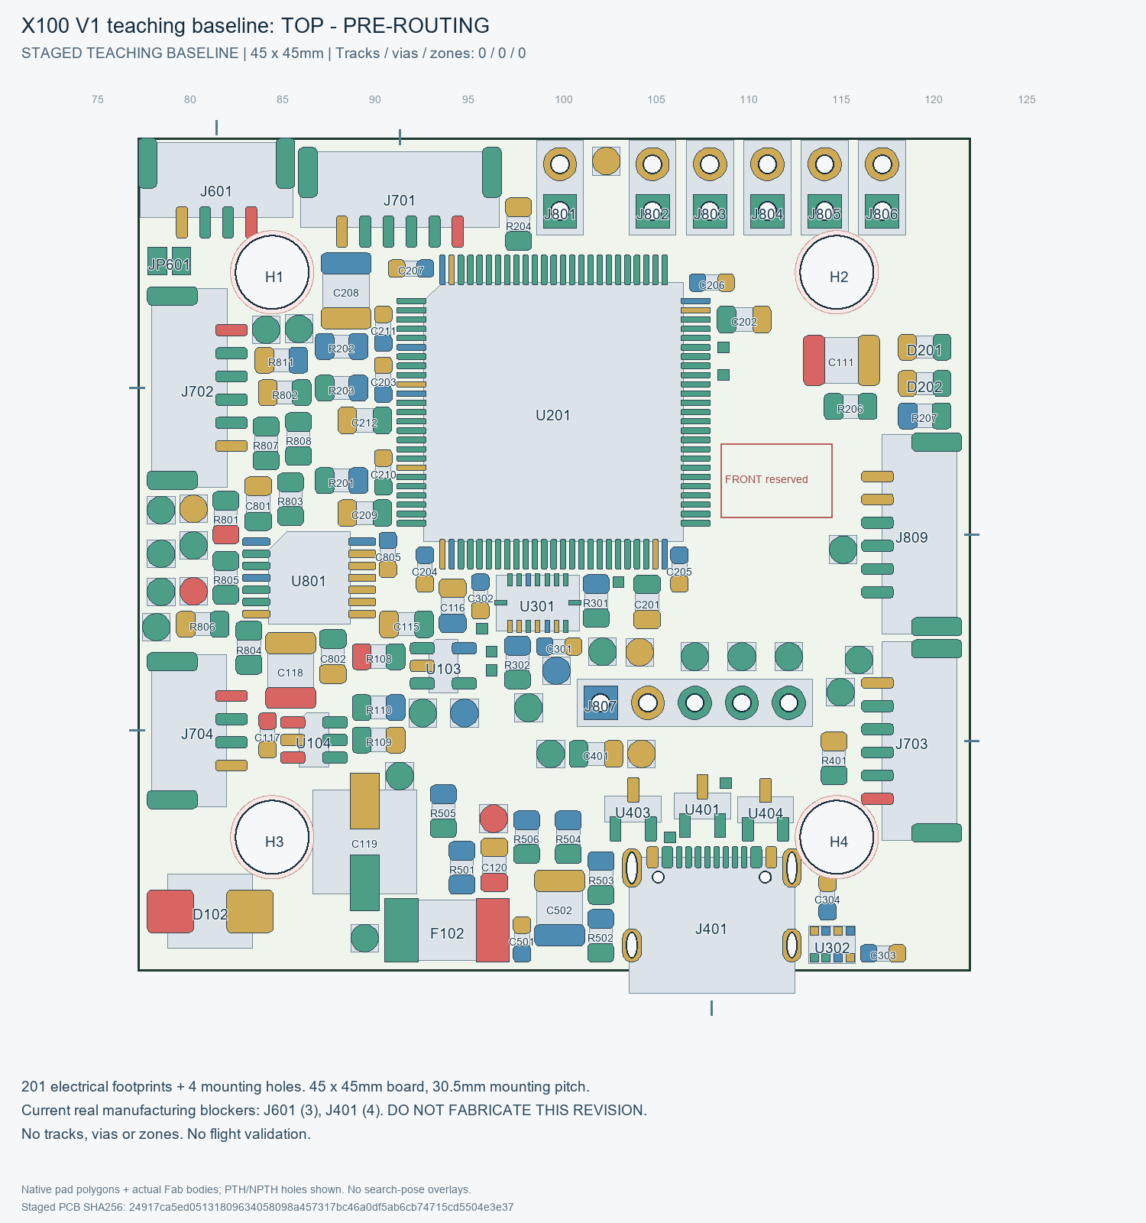
images/pcb_top.png
