chen123037/X100-Flight-Controller-Edu/bom/README.md

# 采购表版本说明

本目录原有X100_V1表保留旧基线。当前清单在[六层V4采购目录](../hardware/current/X100_6L_DFM_ZERO_DANGER/procurement/)，每板142件、62种完整MPN；不要混用旧表。
