chen123037/X100-Flight-Controller-Edu/hardware/reviews/X100_C8_LAYOUT_REVIEW/SHA256_文件校验清单.txt

23ff8075df856f728964ad8750c74fa365a63dfa081806e82a4c3e97258f8bfe  00_先读我_中文评审指引.md
81e4dab8dd814ba69ace195045c2f79a4ff388762a6aee3c030040c0933c1673  00_先读我_中文评审指引.pdf
1b176f6fd7c75d8ea54fec0c282f588efc34d2d59ae2af849bafeffc8a7ac844  01_KiCad工程_c8/01_POWER.kicad_sch
3fbe95efae237a714e35a142cbaff9fa0d2747b2bcc2a81e9ecbf4640b877d28  01_KiCad工程_c8/02_MCU.kicad_sch
2c29bd9cefd57bd8b0652e316582f997f7ba0e7da7a92c9cdd5123efc446ebf8  01_KiCad工程_c8/03_SENSORS.kicad_sch
b7d68c5ba31c5007ff669b53c3b0d8b7255111dd9b7d61240d0a16eaad0b5b21  01_KiCad工程_c8/04_USB.kicad_sch
c09c362c1889fea266f5e6500feeb570e35479e990832e532000019ec863e34d  01_KiCad工程_c8/05_SD.kicad_sch
dea08c1fba5f44b516f6acef46bd5d7b5b59f3222c294933f10eb5622afea50c  01_KiCad工程_c8/06_CAN.kicad_sch
fbb98f3d22e33f15bfe354b5184c26dfc1e4dbfbd45ed6a2f963ecf9123a1088  01_KiCad工程_c8/07_UART_IO.kicad_sch
909adca0b8e77b6d9fa93eff4da012abee65bad1777c68ace2181c30a2abd9e4  01_KiCad工程_c8/08_PWM_ADC_DEBUG.kicad_sch
78287c3bd2778cc77a12dc064522101eefad8597b62fac8a08d8753356e73d3d  01_KiCad工程_c8/09_USB_CORE_POWER.kicad_sch
49958105df973012a9f33268ef95787203859ab763b3fbb0432e924867ac3983  01_KiCad工程_c8/10_USB_STARTUP_GUARD.kicad_sch
683cb476f6bac22f1f5e770cf5a0bf52d59cae8fc0a1cff621fba05fdb7ca5d9  01_KiCad工程_c8/fp-lib-table
36b26679b5f8b85e53a9adbfb97b346ad98d0b0ea89faf0b1cf7e1ea4dd5ab3a  01_KiCad工程_c8/sym-lib-table
67a4b77d417e273567780b9734692ebecf81d9edf97b50260fc8a6da2a2b2753  01_KiCad工程_c8/X100_CleanSheet.kicad_dru
edc89ce874549e805f218a019f62ca5ebd7cc67f8088a04d4485a3e62591cce0  01_KiCad工程_c8/X100_CleanSheet.kicad_pcb
47a97c70127803c8c51a6c2855704843e65bb52e6c85d8d9a0d66e289dbb4c62  01_KiCad工程_c8/X100_CleanSheet.kicad_pro
4363f60996863842310f6a94ac33848a668c9e35ef8b19b12ba1206a501513a7  01_KiCad工程_c8/X100_CleanSheet.kicad_sch
cc22a34ddc498a617ac701c128fa977ae8623bcddcd97069d04a85012a71ba1c  01_KiCad工程_c8/X100_LayoutECO.kicad_sym
be65b6d4da99a7f06b14a5e6112c4807fc7c21293a05b4fb347146d4e4921840  01_KiCad工程_c8/X100_MountingHole.pretty/MountingHole_4mm.kicad_mod
309f190859be0617947fe3b7ed493d0c6389d19a76b99c2903e7c27419bf169a  01_KiCad工程_c8/X100_Physical.kicad_sym
41504b547d8337a8fa0140a9fcc4fccfbe90bd98082f67e641c90c1a1bbd471a  01_KiCad工程_c8/X100_Physical.pretty/Bosch_BMI088_LGA16.kicad_mod
34fb64221b7828b6fde230c08a38fe4bacaa8576a5690132afdd108b920715cb  01_KiCad工程_c8/X100_Physical.pretty/Bourns_SRN6045.kicad_mod
276104491364e6b8781bba3e62590e154d6a360652ba285788950f34c94f6065  01_KiCad工程_c8/X100_Physical.pretty/Bourns_SRP1038A_LeadFrame_NoVIP.kicad_mod
f45473cf5c39f7e8bfce8f1e18314d4ab614a1e86db2427bb25dacc9b7a18025  01_KiCad工程_c8/X100_Physical.pretty/Bourns_SRP1265A.kicad_mod
6c6077e60729219093fa2cbea8eed8afd3ab6b96b80bf5bdf34bb7bc336d322e  01_KiCad工程_c8/X100_Physical.pretty/CAN_SolderJumper_2_Open_Pad1p0x1p5_NoPaste.kicad_mod
13cce9b39aad3574296549bc8de7b041aa6cc8b5d336cec55586149c3c9c9a11  01_KiCad工程_c8/X100_Physical.pretty/Goertek_SPL06_001_LGA8.kicad_mod
09af666ca394992e5e09912e89b0d6cec6343b489611e57f1979fad762c723b4  01_KiCad工程_c8/X100_Physical.pretty/Littelfuse1812L200_12DR.kicad_mod
aadf4e0abd10763596907632fab028b64dc38a452377d5fa620d980432e8c1bf  01_KiCad工程_c8/X100_Physical.pretty/Official_Capacitor_SMD_C_0603_1608Metric.kicad_mod
eeeff7ab5f22f8631ff958be62e2c7e2c29e157dd2faf47994dc0b861f7b51af  01_KiCad工程_c8/X100_Physical.pretty/Official_Capacitor_SMD_C_0805_2012Metric.kicad_mod
4eb4fa98bd7bcc0a43d6b500b6c37f044f3ea1bca24d3f5280baaed7351939ee  01_KiCad工程_c8/X100_Physical.pretty/Official_Capacitor_SMD_C_1210_3225Metric.kicad_mod
16dc44f9b3e16f78e57cb0143fe96e938fae52231ab8e01feaf5f21728fc6ca2  01_KiCad工程_c8/X100_Physical.pretty/Official_Connector_Card_microSD_HC_Molex_104031-0811.kicad_mod
50ea5b0034d60dd7c3215fee12888d217c96d6f255f64ca0e32a1cb0042b3c55  01_KiCad工程_c8/X100_Physical.pretty/Official_Connector_JST_JST_GH_SM04B-GHS-TB_1x04-1MP_P1.25mm_Horizontal.kicad_mod
14db53fd1cdd0163ac39a0e4e0500a7341a47d8aa5ac784554dace3c422b8b30  01_KiCad工程_c8/X100_Physical.pretty/Official_Connector_JST_JST_GH_SM06B-GHS-TB_1x06-1MP_P1.25mm_Horizontal.kicad_mod
52ed0b41a37cefa1e35ef69590d278a3fe1d209edf988f5bdf7dc06530f47676  01_KiCad工程_c8/X100_Physical.pretty/Official_Connector_USB_USB_C_Receptacle_GCT_USB4105-xx-A_16P_TopMnt_Horizontal.kicad_mod
3ac27ca95ed031edcfb1bbc0f163230e47b1eb3231aa32b96d17497671d379d2  01_KiCad工程_c8/X100_Physical.pretty/Official_Diode_SMD_D_SMB.kicad_mod
685c2b406bfaadd1af05111d2b6893f91a625e4afd15afb00bea177036c52d26  01_KiCad工程_c8/X100_Physical.pretty/Official_Diode_SMD_D_SOD-123F.kicad_mod
692d14bfbfca312c18fd9065e700189cea59f87277bd700b7f23967a89274fcc  01_KiCad工程_c8/X100_Physical.pretty/Official_Fuse_Fuse_Littelfuse-NANO2-451_453.kicad_mod
a690163af994efe69147632a760506b2acf91798cbcdcee7aeec89bfe5890474  01_KiCad工程_c8/X100_Physical.pretty/Official_LED_SMD_LED_0805_2012Metric.kicad_mod
b8fb978910834165ee4ab8470821f628754a906c135c0a1251cefdf0271833a2  01_KiCad工程_c8/X100_Physical.pretty/Official_Package_QFP_LQFP-100_14x14mm_P0.5mm.kicad_mod
062024e5fbc4b5542d7181229f6bfdf8b96f1136db0e8bae48cd0385cca7fae7  01_KiCad工程_c8/X100_Physical.pretty/Official_Package_SO_SOIC-8_3.9x4.9mm_P1.27mm.kicad_mod
72bdeb51155231935f226795c910c1e74f649ac01213d875876445fabb94a850  01_KiCad工程_c8/X100_Physical.pretty/Official_Package_SO_TSSOP-14_4.4x5mm_P0.65mm.kicad_mod
236608ea82b665eb497ea31f9a4082af83b9de3bbd618c140815f97bef3e6179  01_KiCad工程_c8/X100_Physical.pretty/Official_Package_TO_SOT_SMD_SOT-23-5.kicad_mod
33ebc8379a9009def29d4871dfa7b360a595fc6893f94a39f38889e011bf0285  01_KiCad工程_c8/X100_Physical.pretty/Official_Package_TO_SOT_SMD_SOT-23-6.kicad_mod
167111c19f9d56a26972486aa601ce35ff05649e0ed3ce81e490d8d9642a3084  01_KiCad工程_c8/X100_Physical.pretty/Official_Package_TO_SOT_SMD_TSOT-23-6.kicad_mod
37eac152b7d45e4e4359796e4f3642e883ed5abe6a8d9420b4d150790a895af7  01_KiCad工程_c8/X100_Physical.pretty/Official_Resistor_SMD_R_0805_2012Metric.kicad_mod
96b98899207d64be53ebad02f09b6e9d9641cb01521d6780a475b433f05715ff  01_KiCad工程_c8/X100_Physical.pretty/Official_USB_C_Amphenol_124019772112A.kicad_mod
47ea6d7f403d06dba71f818677178b00c63dba44f13a36b105e2a1f12cadbd2f  01_KiCad工程_c8/X100_Physical.pretty/Panasonic_OSCON_B6.kicad_mod
fb380ba517445665db668aa7f48a77552e3e3bd80d8058ffa4dec676cff5575e  01_KiCad工程_c8/X100_Physical.pretty/Panasonic_OSCON_C6.kicad_mod
fa9fc14260fd92f17a4f3692dc94f10f3622fccb3abe48d9b466e348b83344d1  01_KiCad工程_c8/X100_Physical.pretty/Panasonic_OSCON_E12.kicad_mod
aaca430b0028f9548baf89c7b139f8e390012a8ceca15f8b310b889d990724be  01_KiCad工程_c8/X100_Physical.pretty/Samtec_TSW10207GS_1x2_P2p54.kicad_mod
73238f84ec5d4e5473588c55f910a82a32677d145a16335192ab1008cf031516  01_KiCad工程_c8/X100_Physical.pretty/Samtec_TSW10507GS_1x5_P2p54.kicad_mod
53189dec1bca26430cce15704f102558e6bc593f42d4f0ac8ba04ec5c8d7e18e  01_KiCad工程_c8/X100_Physical.pretty/STPS8H100G_D2PAK_A_K_TabK_NoVIP.kicad_mod
2ae88464b66e53b559e47377dfc0a6490fa3f1b65446ad13618d2d1a03beaeb7  01_KiCad工程_c8/X100_Physical.pretty/Taitien_XJ_2Pad_5p5x2p0_P9p0.kicad_mod
8cf968f692b21b8f742d06a8e3880ee48b4bea52a357430b64637f46a28efd6c  01_KiCad工程_c8/X100_Physical.pretty/TCAN3414_D0008A_SOIC8.kicad_mod
d9f8565fac481552647ec46c8191e005a691bd8eb30b0ee091252aebd4227511  01_KiCad工程_c8/X100_Physical.pretty/TI_TPD2E2U06_DBZ0003A.kicad_mod
5b8000f8e6e4827f10d08a2d5d5f0541c6a51df970bfa8d36f1c2c36b1b0c651  01_KiCad工程_c8/X100_Physical.pretty/TP0p6_Inline_NoPaste.kicad_mod
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
6e471d647db50527d0c75ee5f1a55a74012ab177c73282bef0bdc7f6562b7ded  07_许可说明/硬件许可_CERN-OHL-P-2.0.txt
fca7d1ab7e1aca0bf904426c08c8f043e8574fc4290038ed38a4b9e5e0e42ade  07_许可说明/项目文档许可.md
08b1b7490f67e623ee011aedc3fa042a79ec6f62c249240def9788188c3dec98  README.md
