chen123037/X100-Flight-Controller-Edu/bom/component_status.csv

Function | Reference | MPN | Package | Selection Status | Verification Status | In BOM | Procurement Policy | Reason | Notes
Power rail / protection support | C101 | C1210C106K5RACTU | 1210 | FINAL_SELECTED_FOR_V1 | NOT_TESTED | YES | SPECIFICATION_FROZEN_PREFERRED_BOM | Frozen V1 schematic/netlist choice | Specification selection frozen; preferred MPN is not mandatory
Power rail / protection support | C102 | C1210C106K5RACTU | 1210 | FINAL_SELECTED_FOR_V1 | NOT_TESTED | YES | SPECIFICATION_FROZEN_PREFERRED_BOM | Frozen V1 schematic/netlist choice | Specification selection frozen; preferred MPN is not mandatory
Power rail / protection support | C103 | C1210C106K5RACTU | 1210 | FINAL_SELECTED_FOR_V1 | NOT_TESTED | YES | SPECIFICATION_FROZEN_PREFERRED_BOM | Frozen V1 schematic/netlist choice | Specification selection frozen; preferred MPN is not mandatory
Power rail / protection support | C104 | C1210C106K5RACTU | 1210 | FINAL_SELECTED_FOR_V1 | NOT_TESTED | YES | SPECIFICATION_FROZEN_PREFERRED_BOM | Frozen V1 schematic/netlist choice | Specification selection frozen; preferred MPN is not mandatory
Power rail / protection support | C105 | 50SVPF39M | OS-CON E12 diameter8 height11.9 | FINAL_SELECTED_FOR_V1 | NOT_TESTED | YES | EXACT_MPN_FROZEN | Frozen V1 schematic/netlist choice | Bench/flight validation not completed
Power rail / protection support | C106 | C0603C104K5RACTU | 0603 | FINAL_SELECTED_FOR_V1 | NOT_TESTED | YES | SPECIFICATION_FROZEN_PREFERRED_BOM | Frozen V1 schematic/netlist choice | Specification selection frozen; preferred MPN is not mandatory
Power rail / protection support | C107 | C0603C104K5RACTU | 0603 | FINAL_SELECTED_FOR_V1 | NOT_TESTED | YES | SPECIFICATION_FROZEN_PREFERRED_BOM | Frozen V1 schematic/netlist choice | Specification selection frozen; preferred MPN is not mandatory
Power rail / protection support | C108 | 16SVPF180M | OS-CON C6 diameter6.3 height5.9 | FINAL_SELECTED_FOR_V1 | NOT_TESTED | YES | EXACT_MPN_FROZEN | Frozen V1 schematic/netlist choice | Bench/flight validation not completed
Power rail / protection support | C109 | C0805C223K5RACTU | 0805 | FINAL_SELECTED_FOR_V1 | NOT_TESTED | YES | SPECIFICATION_FROZEN_PREFERRED_BOM | Frozen V1 schematic/netlist choice | Specification selection frozen; preferred MPN is not mandatory
Power rail / protection support | C110 | C0805C241J5GACTU | 0805 | FINAL_SELECTED_FOR_V1 | NOT_TESTED | YES | SPECIFICATION_FROZEN_PREFERRED_BOM | Frozen V1 schematic/netlist choice | Specification selection frozen; preferred MPN is not mandatory
Power rail / protection support | C111 | C1210C106K5RACTU | 1210 | FINAL_SELECTED_FOR_V1 | NOT_TESTED | YES | SPECIFICATION_FROZEN_PREFERRED_BOM | Frozen V1 schematic/netlist choice | Specification selection frozen; preferred MPN is not mandatory
Power rail / protection support | C112 | C0603C104K5RACTU | 0603 | FINAL_SELECTED_FOR_V1 | NOT_TESTED | YES | SPECIFICATION_FROZEN_PREFERRED_BOM | Frozen V1 schematic/netlist choice | Specification selection frozen; preferred MPN is not mandatory
Power rail / protection support | C113 | C1210C226K4RACTU | 1210 | FINAL_SELECTED_FOR_V1 | NOT_TESTED | YES | SPECIFICATION_FROZEN_PREFERRED_BOM | Frozen V1 schematic/netlist choice | Specification selection frozen; preferred MPN is not mandatory
Power rail / protection support | C114 | C1210C226K4RACTU | 1210 | FINAL_SELECTED_FOR_V1 | NOT_TESTED | YES | SPECIFICATION_FROZEN_PREFERRED_BOM | Frozen V1 schematic/netlist choice | Specification selection frozen; preferred MPN is not mandatory
Power rail / protection support | C115 | C0805C225K4RACTU | 0805 | FINAL_SELECTED_FOR_V1 | NOT_TESTED | YES | SPECIFICATION_FROZEN_PREFERRED_BOM | Frozen V1 schematic/netlist choice | Specification selection frozen; preferred MPN is not mandatory
Power rail / protection support | C116 | C0805C225K4RACTU | 0805 | FINAL_SELECTED_FOR_V1 | NOT_TESTED | YES | SPECIFICATION_FROZEN_PREFERRED_BOM | Frozen V1 schematic/netlist choice | Specification selection frozen; preferred MPN is not mandatory
Power rail / protection support | C117 | C0603C104K5RACTU | 0603 | FINAL_SELECTED_FOR_V1 | NOT_TESTED | YES | SPECIFICATION_FROZEN_PREFERRED_BOM | Frozen V1 schematic/netlist choice | Specification selection frozen; preferred MPN is not mandatory
Power rail / protection support | C118 | C1210C106K5RACTU | 1210 | FINAL_SELECTED_FOR_V1 | NOT_TESTED | YES | SPECIFICATION_FROZEN_PREFERRED_BOM | Frozen V1 schematic/netlist choice | Specification selection frozen; preferred MPN is not mandatory
Power rail / protection support | C119 | 16SVPF82M | OS-CON B6 diameter5 height5.9 | FINAL_SELECTED_FOR_V1 | NOT_TESTED | YES | EXACT_MPN_FROZEN | Frozen V1 schematic/netlist choice | Bench/flight validation not completed
Power rail / protection support | C120 | C0805C105K4RACTU | 0805 | FINAL_SELECTED_FOR_V1 | NOT_TESTED | YES | SPECIFICATION_FROZEN_PREFERRED_BOM | Frozen V1 schematic/netlist choice | Specification selection frozen; preferred MPN is not mandatory
MCU / clock / reset support | C201 | C0805C225K4RACTU | 0805 | FINAL_SELECTED_FOR_V1 | NOT_TESTED | YES | SPECIFICATION_FROZEN_PREFERRED_BOM | Frozen V1 schematic/netlist choice | Specification selection frozen; preferred MPN is not mandatory
MCU / clock / reset support | C202 | C0805C225K4RACTU | 0805 | FINAL_SELECTED_FOR_V1 | NOT_TESTED | YES | SPECIFICATION_FROZEN_PREFERRED_BOM | Frozen V1 schematic/netlist choice | Specification selection frozen; preferred MPN is not mandatory
MCU / clock / reset support | C203 | C0603C104K5RACTU | 0603 | FINAL_SELECTED_FOR_V1 | NOT_TESTED | YES | SPECIFICATION_FROZEN_PREFERRED_BOM | Frozen V1 schematic/netlist choice | Specification selection frozen; preferred MPN is not mandatory
MCU / clock / reset support | C204 | C0603C104K5RACTU | 0603 | FINAL_SELECTED_FOR_V1 | NOT_TESTED | YES | SPECIFICATION_FROZEN_PREFERRED_BOM | Frozen V1 schematic/netlist choice | Specification selection frozen; preferred MPN is not mandatory
MCU / clock / reset support | C205 | C0603C104K5RACTU | 0603 | FINAL_SELECTED_FOR_V1 | NOT_TESTED | YES | SPECIFICATION_FROZEN_PREFERRED_BOM | Frozen V1 schematic/netlist choice | Specification selection frozen; preferred MPN is not mandatory
MCU / clock / reset support | C206 | C0603C104K5RACTU | 0603 | FINAL_SELECTED_FOR_V1 | NOT_TESTED | YES | SPECIFICATION_FROZEN_PREFERRED_BOM | Frozen V1 schematic/netlist choice | Specification selection frozen; preferred MPN is not mandatory
MCU / clock / reset support | C207 | C0603C104K5RACTU | 0603 | FINAL_SELECTED_FOR_V1 | NOT_TESTED | YES | SPECIFICATION_FROZEN_PREFERRED_BOM | Frozen V1 schematic/netlist choice | Specification selection frozen; preferred MPN is not mandatory
MCU / clock / reset support | C208 | C1210C106K5RACTU | 1210 | FINAL_SELECTED_FOR_V1 | NOT_TESTED | YES | SPECIFICATION_FROZEN_PREFERRED_BOM | Frozen V1 schematic/netlist choice | Specification selection frozen; preferred MPN is not mandatory
MCU / clock / reset support | C209 | C0805C225K4RACTU | 0805 | FINAL_SELECTED_FOR_V1 | NOT_TESTED | YES | SPECIFICATION_FROZEN_PREFERRED_BOM | Frozen V1 schematic/netlist choice | Specification selection frozen; preferred MPN is not mandatory
MCU / clock / reset support | C210 | C0603C104K5RACTU | 0603 | FINAL_SELECTED_FOR_V1 | NOT_TESTED | YES | SPECIFICATION_FROZEN_PREFERRED_BOM | Frozen V1 schematic/netlist choice | Specification selection frozen; preferred MPN is not mandatory
MCU / clock / reset support | C211 | C0603C104K5RACTU | 0603 | FINAL_SELECTED_FOR_V1 | NOT_TESTED | YES | SPECIFICATION_FROZEN_PREFERRED_BOM | Frozen V1 schematic/netlist choice | Specification selection frozen; preferred MPN is not mandatory
MCU / clock / reset support | C212 | C0805C104K5RACTU | 0805 | FINAL_SELECTED_FOR_V1 | NOT_TESTED | YES | SPECIFICATION_FROZEN_PREFERRED_BOM | Frozen V1 schematic/netlist choice | Specification selection frozen; preferred MPN is not mandatory
MCU / clock / reset support | C213 | CC0805JRNPO9BN330 | 0805 | FINAL_SELECTED_FOR_V1 | NOT_TESTED | YES | SPECIFICATION_FROZEN_PREFERRED_BOM | Frozen V1 schematic/netlist choice | Specification selection frozen; preferred MPN is not mandatory
MCU / clock / reset support | C214 | CC0805JRNPO9BN330 | 0805 | FINAL_SELECTED_FOR_V1 | NOT_TESTED | YES | SPECIFICATION_FROZEN_PREFERRED_BOM | Frozen V1 schematic/netlist choice | Specification selection frozen; preferred MPN is not mandatory
Sensor support | C301 | C0603C104K5RACTU | 0603 | FINAL_SELECTED_FOR_V1 | NOT_TESTED | YES | SPECIFICATION_FROZEN_PREFERRED_BOM | Frozen V1 schematic/netlist choice | Specification selection frozen; preferred MPN is not mandatory
Sensor support | C302 | C0603C104K5RACTU | 0603 | FINAL_SELECTED_FOR_V1 | NOT_TESTED | YES | SPECIFICATION_FROZEN_PREFERRED_BOM | Frozen V1 schematic/netlist choice | Specification selection frozen; preferred MPN is not mandatory
Sensor support | C303 | C0603C104K5RACTU | 0603 | FINAL_SELECTED_FOR_V1 | NOT_TESTED | YES | SPECIFICATION_FROZEN_PREFERRED_BOM | Frozen V1 schematic/netlist choice | Specification selection frozen; preferred MPN is not mandatory
Sensor support | C304 | C0603C104K5RACTU | 0603 | FINAL_SELECTED_FOR_V1 | NOT_TESTED | YES | SPECIFICATION_FROZEN_PREFERRED_BOM | Frozen V1 schematic/netlist choice | Specification selection frozen; preferred MPN is not mandatory
USB interface support | C401 | C0805C104K5RACTU | 0805 | FINAL_SELECTED_FOR_V1 | NOT_TESTED | YES | SPECIFICATION_FROZEN_PREFERRED_BOM | Frozen V1 schematic/netlist choice | Specification selection frozen; preferred MPN is not mandatory
USB interface support | C402 | C0603C104K5RACTU | 0603 | FINAL_SELECTED_FOR_V1 | NOT_TESTED | YES | SPECIFICATION_FROZEN_PREFERRED_BOM | Frozen V1 schematic/netlist choice | Specification selection frozen; preferred MPN is not mandatory
microSD / SDMMC support | C501 | C0603C104K5RACTU | 0603 | FINAL_SELECTED_FOR_V1 | NOT_TESTED | YES | SPECIFICATION_FROZEN_PREFERRED_BOM | Frozen V1 schematic/netlist choice | Specification selection frozen; preferred MPN is not mandatory
microSD / SDMMC support | C502 | C1210C106K5RACTU | 1210 | FINAL_SELECTED_FOR_V1 | NOT_TESTED | YES | SPECIFICATION_FROZEN_PREFERRED_BOM | Frozen V1 schematic/netlist choice | Specification selection frozen; preferred MPN is not mandatory
CAN interface support | C601 | C0603C104K5RACTU | 0603 | FINAL_SELECTED_FOR_V1 | NOT_TESTED | YES | SPECIFICATION_FROZEN_PREFERRED_BOM | Frozen V1 schematic/netlist choice | Specification selection frozen; preferred MPN is not mandatory
PWM / ADC / debug interface | C801 | C0805C104K5RACTU | 0805 | FINAL_SELECTED_FOR_V1 | NOT_TESTED | YES | SPECIFICATION_FROZEN_PREFERRED_BOM | Frozen V1 schematic/netlist choice | Specification selection frozen; preferred MPN is not mandatory
PWM / ADC / debug interface | C802 | C0805C104K5RACTU | 0805 | FINAL_SELECTED_FOR_V1 | NOT_TESTED | YES | SPECIFICATION_FROZEN_PREFERRED_BOM | Frozen V1 schematic/netlist choice | Specification selection frozen; preferred MPN is not mandatory
PWM / ADC / debug interface | C803 | C0805C223K5RACTU | 0805 | FINAL_SELECTED_FOR_V1 | NOT_TESTED | YES | SPECIFICATION_FROZEN_PREFERRED_BOM | Frozen V1 schematic/netlist choice | Specification selection frozen; preferred MPN is not mandatory
PWM / ADC / debug interface | C804 | C0805C223K5RACTU | 0805 | FINAL_SELECTED_FOR_V1 | NOT_TESTED | YES | SPECIFICATION_FROZEN_PREFERRED_BOM | Frozen V1 schematic/netlist choice | Specification selection frozen; preferred MPN is not mandatory
PWM / ADC / debug interface | C805 | C0603C104K5RACTU | 0603 | FINAL_SELECTED_FOR_V1 | NOT_TESTED | YES | SPECIFICATION_FROZEN_PREFERRED_BOM | Frozen V1 schematic/netlist choice | Specification selection frozen; preferred MPN is not mandatory
FC input TVS | D101 | BZT52H-C12,115 | SOD123F | FINAL_SELECTED_FOR_V1 | BENCH_VERIFY | YES | EXACT_MPN_FROZEN | Frozen V1 schematic/netlist choice | Bench/flight validation not completed
Power rail / protection support | D102 | SMBJ26CA-TR | SMB DO214AA | FINAL_SELECTED_FOR_V1 | NOT_TESTED | YES | EXACT_MPN_FROZEN | Frozen V1 schematic/netlist choice | Bench/flight validation not completed
Main buck rectifier | D103 | STPS8H100G-TR | D2PAK A/K/tabK | FINAL_SELECTED_FOR_V1 | NOT_TESTED | YES | EXACT_MPN_FROZEN | Frozen V1 schematic/netlist choice | Bench/flight validation not completed
MCU / clock / reset support | D201 | LTST-C170GKT | 0805 LED | FINAL_SELECTED_FOR_V1 | NOT_TESTED | YES | EXACT_MPN_FROZEN | Frozen V1 schematic/netlist choice | Bench/flight validation not completed
MCU / clock / reset support | D202 | LTST-C170GKT | 0805 LED | FINAL_SELECTED_FOR_V1 | NOT_TESTED | YES | EXACT_MPN_AUTHORIZED_PCB01F3; same LED as D201; not ordered | Frozen V1 schematic/netlist choice | Bench/flight validation not completed
FC input fuse | F101 | 0451003.MRL | NANO2 451 SMD | FINAL_SELECTED_FOR_V1 | BENCH_VERIFY | YES | EXACT_MPN_FROZEN | Frozen V1 schematic/netlist choice | Bench/flight validation not completed
Power rail / protection support | F102 | 1812L200/12DR | 1812 PTC | FINAL_SELECTED_FOR_V1 | NOT_TESTED | YES | EXACT_MPN_FROZEN | Frozen V1 schematic/netlist choice | Bench/flight validation not completed
USB-C interface | J401 | 124019772112A | USB-C dual-row SMT / 4 plated SH slots | FINAL_SELECTED_FOR_V1 | DESIGN_REVIEWED_BENCH_PENDING | YES | EXACT_MPN_FROZEN | User-approved exact connector replacement2026-10-22; native KiCad sync and pinmap checked | Amphenol / LCSC C5430474; nominal1.6mm top-mount geometry reviewed; physical solder/retention pending; no fabrication release
microSD / SDMMC1 4-bit storage | J501 | 1040310811 | microSD SMT push-pull8+2detect | FINAL_SELECTED_FOR_V1 | PENDING_SAMPLE_VERIFICATION | YES | EXACT_MPN_FROZEN | Frozen V1 schematic/netlist choice | Bench/flight validation not completed
External CAN connector | J601 | SM04B-GHS-TB(LF)(SN) | GH1.25 4P side-entry SMT | FINAL_SELECTED_FOR_V1 | NOT_TESTED | YES | EXACT_MPN_FROZEN | Frozen V1 schematic/netlist choice | Bench/flight validation not completed
UART / I2C / RC interface | J701 | SM06B-GHS-TB(LF)(SN) | GH1.25 6P side-entry SMT | FINAL_SELECTED_FOR_V1 | NOT_TESTED | YES | EXACT_MPN_FROZEN | Frozen V1 schematic/netlist choice | Bench/flight validation not completed
UART / I2C / RC interface | J702 | SM06B-GHS-TB(LF)(SN) | GH1.25 6P side-entry SMT | FINAL_SELECTED_FOR_V1 | NOT_TESTED | YES | EXACT_MPN_FROZEN | Frozen V1 schematic/netlist choice | Bench/flight validation not completed
UART / I2C / RC interface | J703 | SM06B-GHS-TB(LF)(SN) | GH1.25 6P side-entry SMT | FINAL_SELECTED_FOR_V1 | NOT_TESTED | YES | EXACT_MPN_FROZEN | Frozen V1 schematic/netlist choice | Bench/flight validation not completed
UART / I2C / RC interface | J704 | SM04B-GHS-TB(LF)(SN) | GH1.25 4P side-entry SMT | FINAL_SELECTED_FOR_V1 | NOT_TESTED | YES | EXACT_MPN_FROZEN | Frozen V1 schematic/netlist choice | Bench/flight validation not completed
PWM / ADC / debug interface | J801 | TSW-102-07-G-S | 1x2 2.54 THT top insertion | FINAL_SELECTED_FOR_V1 | NOT_TESTED | YES | EXACT_MPN_FROZEN | Frozen V1 schematic/netlist choice | Bench/flight validation not completed
PWM / ADC / debug interface | J802 | TSW-102-07-G-S | 1x2 2.54 THT top insertion | FINAL_SELECTED_FOR_V1 | NOT_TESTED | YES | EXACT_MPN_FROZEN | Frozen V1 schematic/netlist choice | Bench/flight validation not completed
PWM / ADC / debug interface | J803 | TSW-102-07-G-S | 1x2 2.54 THT top insertion | FINAL_SELECTED_FOR_V1 | NOT_TESTED | YES | EXACT_MPN_FROZEN | Frozen V1 schematic/netlist choice | Bench/flight validation not completed
PWM / ADC / debug interface | J804 | TSW-102-07-G-S | 1x2 2.54 THT top insertion | FINAL_SELECTED_FOR_V1 | NOT_TESTED | YES | EXACT_MPN_FROZEN | Frozen V1 schematic/netlist choice | Bench/flight validation not completed
PWM / ADC / debug interface | J805 | TSW-102-07-G-S | 1x2 2.54 THT top insertion | FINAL_SELECTED_FOR_V1 | NOT_TESTED | YES | EXACT_MPN_FROZEN | Frozen V1 schematic/netlist choice | Bench/flight validation not completed
PWM / ADC / debug interface | J806 | TSW-102-07-G-S | 1x2 2.54 THT top insertion | FINAL_SELECTED_FOR_V1 | NOT_TESTED | YES | EXACT_MPN_FROZEN | Frozen V1 schematic/netlist choice | Bench/flight validation not completed
PWM / ADC / debug interface | J807 | TSW-105-07-G-S | 1x5 2.54 THT top insertion | FINAL_SELECTED_FOR_V1 | NOT_TESTED | YES | EXACT_MPN_FROZEN | Frozen V1 schematic/netlist choice | Bench/flight validation not completed
FC battery input | J808 | VBAT_PAD_PAIR_V1 | top solder pads | FINAL_SELECTED_FOR_V1 | NOT_TESTED | YES | EXACT_MPN_FROZEN | Frozen V1 schematic/netlist choice | Bench/flight validation not completed
PWM / ADC / debug interface | J809 | SM06B-GHS-TB(LF)(SN) | GH1.25 6P side-entry SMT | FINAL_SELECTED_FOR_V1 | NOT_TESTED | YES | EXACT_MPN_FROZEN | Frozen V1 schematic/netlist choice | Bench/flight validation not completed
CAN 120R termination solder bridge | JP601 |  |  | FINAL_SELECTED_FOR_V1 | NOT_TESTED | NO |  | Frozen V1 schematic/netlist choice | Default OPEN; bridge ON; NO PASTE; no independent BOM component
Main 5V power inductor | L101 | SRP1038A-100M | Lead-frame SMD; case max11.5x10.3x4.0mm | FINAL_SELECTED_FOR_V1 | DATASHEET_AND_LAYOUT_VERIFIED; POWER_REVIEW_OPEN; NO_BENCH_PASS | YES | EXACT_MPN_FROZEN | User-authorized exact L101 replacement | User approved20261023; LCSC C780184; formal integration verified; load/thermal/short review remains open; no purchase/order authorization
Secondary 3V3 power inductor | L102 | SRN6045-4R7Y | 6x6x4.5 SMD visible end terminals | FINAL_SELECTED_FOR_V1 | NOT_TESTED | YES | EXACT_MPN_FROZEN | Frozen V1 schematic/netlist choice | Bench/flight validation not completed
Reverse-polarity protection | Q101 | DMP6023LSS-13 | SO8 | FINAL_SELECTED_FOR_V1 | BENCH_VERIFY | YES | EXACT_MPN_FROZEN | Frozen V1 schematic/netlist choice | Bench/flight validation not completed
Power rail / protection support | R101 | RC0805FR-0720KL | 0805 | FINAL_SELECTED_FOR_V1 | NOT_TESTED | YES | SPECIFICATION_FROZEN_PREFERRED_BOM | Frozen V1 schematic/netlist choice | Specification selection frozen; preferred MPN is not mandatory
Power rail / protection support | R102 | RC0805FR-07294KL | 0805 | FINAL_SELECTED_FOR_V1 | NOT_TESTED | YES | SPECIFICATION_FROZEN_PREFERRED_BOM | Frozen V1 schematic/netlist choice | Specification selection frozen; preferred MPN is not mandatory
Power rail / protection support | R103 | RC0805FR-0754K9L | 0805 | FINAL_SELECTED_FOR_V1 | NOT_TESTED | YES | SPECIFICATION_FROZEN_PREFERRED_BOM | Frozen V1 schematic/netlist choice | Specification selection frozen; preferred MPN is not mandatory
Power rail / protection support | R104 | RC0805FR-07200KL | 0805 | FINAL_SELECTED_FOR_V1 | NOT_TESTED | YES | SPECIFICATION_FROZEN_PREFERRED_BOM | Frozen V1 schematic/netlist choice | Specification selection frozen; preferred MPN is not mandatory
Power rail / protection support | R105 | RT0805BRD0752K3L | 0805 | FINAL_SELECTED_FOR_V1 | NOT_TESTED | YES | SPECIFICATION_FROZEN_PREFERRED_BOM | Frozen V1 schematic/netlist choice | Specification selection frozen; preferred MPN is not mandatory
Power rail / protection support | R106 | RT0805BRD0710KL | 0805 | FINAL_SELECTED_FOR_V1 | NOT_TESTED | YES | SPECIFICATION_FROZEN_PREFERRED_BOM | Frozen V1 schematic/netlist choice | Specification selection frozen; preferred MPN is not mandatory
Power rail / protection support | R107 | RC0805FR-0718K7L | 0805 | FINAL_SELECTED_FOR_V1 | NOT_TESTED | YES | SPECIFICATION_FROZEN_PREFERRED_BOM | Frozen V1 schematic/netlist choice | Specification selection frozen; preferred MPN is not mandatory
Power rail / protection support | R108 | RC0805FR-0710RL | 0805 | FINAL_SELECTED_FOR_V1 | NOT_TESTED | YES | SPECIFICATION_FROZEN_PREFERRED_BOM | Frozen V1 schematic/netlist choice | Specification selection frozen; preferred MPN is not mandatory
Power rail / protection support | R109 | RC0805FR-0722K1L | 0805 | FINAL_SELECTED_FOR_V1 | NOT_TESTED | YES | SPECIFICATION_FROZEN_PREFERRED_BOM | Frozen V1 schematic/netlist choice | Specification selection frozen; preferred MPN is not mandatory
Power rail / protection support | R110 | RC0805FR-0710KL | 0805 | FINAL_SELECTED_FOR_V1 | NOT_TESTED | YES | SPECIFICATION_FROZEN_PREFERRED_BOM | Frozen V1 schematic/netlist choice | Specification selection frozen; preferred MPN is not mandatory
MCU / clock / reset support | R201 | RC0805FR-0710RL | 0805 | FINAL_SELECTED_FOR_V1 | NOT_TESTED | YES | SPECIFICATION_FROZEN_PREFERRED_BOM | Frozen V1 schematic/netlist choice | Specification selection frozen; preferred MPN is not mandatory
MCU / clock / reset support | R202 | RC0805JR-070RL | 0805 | FINAL_SELECTED_FOR_V1 | NOT_TESTED | YES | SPECIFICATION_FROZEN_PREFERRED_BOM | Frozen V1 schematic/netlist choice | Specification selection frozen; preferred MPN is not mandatory
MCU / clock / reset support | R203 | RC0805FR-0710KL | 0805 | FINAL_SELECTED_FOR_V1 | NOT_TESTED | YES | SPECIFICATION_FROZEN_PREFERRED_BOM | Frozen V1 schematic/netlist choice | Specification selection frozen; preferred MPN is not mandatory
MCU / clock / reset support | R204 | RC0805FR-0710KL | 0805 | FINAL_SELECTED_FOR_V1 | NOT_TESTED | YES | SPECIFICATION_FROZEN_PREFERRED_BOM | Frozen V1 schematic/netlist choice | Specification selection frozen; preferred MPN is not mandatory
MCU / clock / reset support | R205 | RC0805FR-07120RL | 0805 | FINAL_SELECTED_FOR_V1 | NOT_TESTED | YES | SPECIFICATION_FROZEN_PREFERRED_BOM | Frozen V1 schematic/netlist choice | Specification selection frozen; preferred MPN is not mandatory
MCU / clock / reset support | R206 | RC0805FR-071KL | 0805 | FINAL_SELECTED_FOR_V1 | NOT_TESTED | YES | SPECIFICATION_FROZEN_PREFERRED_BOM | Frozen V1 schematic/netlist choice | Specification selection frozen; preferred MPN is not mandatory
MCU / clock / reset support | R207 | RC0805FR-071K2L | 0805 | FINAL_SELECTED_FOR_V1 | NOT_TESTED | YES | SPECIFICATION_FROZEN_PREFERRED_BOM; PCB01F3 prototype 1.2k authorized | Frozen V1 schematic/netlist choice | Specification selection frozen; preferred MPN is not mandatory
Sensor support | R301 | RC0805FR-0710KL | 0805 | FINAL_SELECTED_FOR_V1 | NOT_TESTED | YES | SPECIFICATION_FROZEN_PREFERRED_BOM | Frozen V1 schematic/netlist choice | Specification selection frozen; preferred MPN is not mandatory
Sensor support | R302 | RC0805FR-0710KL | 0805 | FINAL_SELECTED_FOR_V1 | NOT_TESTED | YES | SPECIFICATION_FROZEN_PREFERRED_BOM | Frozen V1 schematic/netlist choice | Specification selection frozen; preferred MPN is not mandatory
Sensor support | R303 | RC0805FR-074K7L | 0805 | FINAL_SELECTED_FOR_V1 | NOT_TESTED | YES | SPECIFICATION_FROZEN_PREFERRED_BOM | Frozen V1 schematic/netlist choice | Specification selection frozen; preferred MPN is not mandatory
Sensor support | R304 | RC0805FR-074K7L | 0805 | FINAL_SELECTED_FOR_V1 | NOT_TESTED | YES | SPECIFICATION_FROZEN_PREFERRED_BOM | Frozen V1 schematic/netlist choice | Specification selection frozen; preferred MPN is not mandatory
USB interface support | R401 | RC0805FR-075K1L | 0805 | FINAL_SELECTED_FOR_V1 | NOT_TESTED | YES | SPECIFICATION_FROZEN_PREFERRED_BOM | Frozen V1 schematic/netlist choice | Specification selection frozen; preferred MPN is not mandatory
USB interface support | R402 | RC0805FR-075K1L | 0805 | FINAL_SELECTED_FOR_V1 | NOT_TESTED | YES | SPECIFICATION_FROZEN_PREFERRED_BOM | Frozen V1 schematic/netlist choice | Specification selection frozen; preferred MPN is not mandatory
USB interface support | R403 | RC0805FR-0710KL | 0805 | FINAL_SELECTED_FOR_V1 | NOT_TESTED | YES | SPECIFICATION_FROZEN_PREFERRED_BOM | Frozen V1 schematic/netlist choice | Specification selection frozen; preferred MPN is not mandatory
USB interface support | R404 | RC0805FR-07100KL | 0805 | FINAL_SELECTED_FOR_V1 | NOT_TESTED | YES | SPECIFICATION_FROZEN_PREFERRED_BOM | Frozen V1 schematic/netlist choice | Specification selection frozen; preferred MPN is not mandatory
microSD / SDMMC support | R501 | RC0805JR-070RL | 0805 | FINAL_SELECTED_FOR_V1 | NOT_TESTED | YES | SPECIFICATION_FROZEN_PREFERRED_BOM | Frozen V1 schematic/netlist choice | Specification selection frozen; preferred MPN is not mandatory
microSD / SDMMC support | R502 | RC0805FR-0747KL | 0805 | FINAL_SELECTED_FOR_V1 | NOT_TESTED | YES | SPECIFICATION_FROZEN_PREFERRED_BOM | Frozen V1 schematic/netlist choice | Specification selection frozen; preferred MPN is not mandatory
microSD / SDMMC support | R503 | RC0805FR-0747KL | 0805 | FINAL_SELECTED_FOR_V1 | NOT_TESTED | YES | SPECIFICATION_FROZEN_PREFERRED_BOM | Frozen V1 schematic/netlist choice | Specification selection frozen; preferred MPN is not mandatory
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
PWM / ADC / debug interface | R810 | RC0805FR-071M3L | 0805 | FINAL_SELECTED_FOR_V1 | NOT_TESTED | YES | SPECIFICATION_FROZEN_PREFERRED_BOM | Frozen V1 schematic/netlist choice | Specification selection frozen; preferred MPN is not mandatory
PWM / ADC / debug interface | R811 | RC0805FR-071KL | 0805 | FINAL_SELECTED_FOR_V1 | NOT_TESTED | YES | SPECIFICATION_FROZEN_PREFERRED_BOM | Frozen V1 schematic/netlist choice | Specification selection frozen; preferred MPN is not mandatory
PCB test feature / VBAT_RAW | TP101 | PCB_TESTPAD_0P6_NO_PASTE | PCB feature: 0.6mm exposed round test land; no paste | FINAL_SELECTED_FOR_V1 | PCB_FEATURE | YES | EXACT_MPN_FROZEN | Frozen V1 schematic/netlist choice | PCB feature, no purchase; compact0.6mm land with unchanged0.5mm probe envelope; fine-tip probing
PCB test feature / VBAT_FUSED | TP102 | TP1p5 | 1.5mm top probe | FINAL_SELECTED_FOR_V1 | PCB_FEATURE | YES | EXACT_MPN_FROZEN | Frozen V1 schematic/netlist choice | PCB feature, not a purchased component
PCB test feature / VBAT_PROTECTED | TP103 | TP1p5 | 1.5mm top probe | FINAL_SELECTED_FOR_V1 | PCB_FEATURE | YES | EXACT_MPN_FROZEN | Frozen V1 schematic/netlist choice | PCB feature, not a purchased component
PCB test feature / 5V_MAIN | TP104 | TP1p5 | 1.5mm top probe | FINAL_SELECTED_FOR_V1 | PCB_FEATURE | YES | EXACT_MPN_FROZEN | Frozen V1 schematic/netlist choice | PCB feature, not a purchased component
PCB test feature / 3V3_MCU | TP105 | TP1p5 | 1.5mm top probe | FINAL_SELECTED_FOR_V1 | PCB_FEATURE | YES | EXACT_MPN_FROZEN | Frozen V1 schematic/netlist choice | PCB feature, not a purchased component
PCB test feature / SENSOR_LDO_IN | TP106 | PCB_TESTPAD_0P6_NO_PASTE | PCB feature: 0.6mm exposed round test land; no paste | FINAL_SELECTED_FOR_V1 | PCB_FEATURE | YES | EXACT_MPN_FROZEN | Frozen V1 schematic/netlist choice | PCB feature, no purchase; compact0.6mm land with unchanged0.5mm probe envelope; fine-tip probing
PCB test feature / 3V3_SENSOR | TP107 | PCB_TESTPAD_0P6_NO_PASTE | PCB feature: 0.6mm exposed round test land; no paste | FINAL_SELECTED_FOR_V1 | PCB_FEATURE | YES | EXACT_MPN_FROZEN | Frozen V1 schematic/netlist choice | PCB feature, no purchase; compact0.6mm land with unchanged0.5mm probe envelope; fine-tip probing
PCB test feature / EXT_SWITCH_OUT | TP108 | PCB_TESTPAD_0P6_NO_PASTE | PCB feature: 0.6mm exposed round test land; no paste | FINAL_SELECTED_FOR_V1 | PCB_FEATURE | YES | EXACT_MPN_FROZEN | Frozen V1 schematic/netlist choice | PCB feature, no purchase; compact0.6mm land with unchanged0.5mm probe envelope; fine-tip probing
PCB test feature / EXT_5V | TP109 | PCB_TESTPAD_0P6_NO_PASTE | PCB feature: 0.6mm exposed round test land; no paste | FINAL_SELECTED_FOR_V1 | PCB_FEATURE | YES | EXACT_MPN_FROZEN | Frozen V1 schematic/netlist choice | PCB feature, no purchase; compact0.6mm land with unchanged0.5mm probe envelope; fine-tip probing
PCB test feature / EXT_FAULT | TP110 | PCB_TESTPAD_0P6_NO_PASTE | PCB feature: 0.6mm exposed round test land; no paste | FINAL_SELECTED_FOR_V1 | PCB_FEATURE | YES | EXACT_MPN_FROZEN | Frozen V1 schematic/netlist choice | PCB feature, no purchase; compact0.6mm land with unchanged0.5mm probe envelope; fine-tip probing
PCB test feature / GND | TP111 | TP1p5 | 1.5mm top probe | FINAL_SELECTED_FOR_V1 | PCB_FEATURE | YES | EXACT_MPN_FROZEN | Frozen V1 schematic/netlist choice | PCB feature, not a purchased component
PCB test feature / NRST | TP201 | PCB_TESTPAD_0P6_NO_PASTE | PCB feature: 0.6mm exposed round test land; no paste | FINAL_SELECTED_FOR_V1 | PCB_FEATURE | YES | EXACT_MPN_FROZEN | Frozen V1 schematic/netlist choice | PCB feature, no purchase; compact0.6mm land with unchanged0.5mm probe envelope; fine-tip probing
PCB test feature / BOOT0 | TP202 | PCB_TESTPAD_0P6_NO_PASTE | PCB feature: 0.6mm exposed round test land; no paste | FINAL_SELECTED_FOR_V1 | PCB_FEATURE | YES | EXACT_MPN_FROZEN | Frozen V1 schematic/netlist choice | PCB feature, no purchase; compact0.6mm land with unchanged0.5mm probe envelope; fine-tip probing
PCB test feature / 3V3_MCU | TP203 | PCB_TESTPAD_0P6_NO_PASTE | PCB feature: 0.6mm exposed round test land; no paste | FINAL_SELECTED_FOR_V1 | PCB_FEATURE | YES | EXACT_MPN_FROZEN | Frozen V1 schematic/netlist choice | PCB feature, no purchase; compact0.6mm land with unchanged0.5mm probe envelope; fine-tip probing
PCB test feature / MCU_VDDA | TP204 | PCB_TESTPAD_0P6_NO_PASTE | PCB feature: 0.6mm exposed round test land; no paste | FINAL_SELECTED_FOR_V1 | PCB_FEATURE | YES | EXACT_MPN_FROZEN | Frozen V1 schematic/netlist choice | PCB feature, no purchase; compact0.6mm land with unchanged0.5mm probe envelope; fine-tip probing
PCB test feature / VCAP1 | TP205 | TP0p6 | 0.6mm inline probe | FINAL_SELECTED_FOR_V1 | PCB_FEATURE | YES | EXACT_MPN_FROZEN | Frozen V1 schematic/netlist choice | PCB feature, not a purchased component
PCB test feature / VCAP2 | TP206 | TP0p6 | 0.6mm inline probe | FINAL_SELECTED_FOR_V1 | PCB_FEATURE | YES | EXACT_MPN_FROZEN | Frozen V1 schematic/netlist choice | PCB feature, not a purchased component
PCB test feature / MCO1_DIAG_RESERVED | TP207 | TP0p6 | 0.6mm inline probe | FINAL_SELECTED_FOR_V1 | PCB_FEATURE | YES | EXACT_MPN_FROZEN | Frozen V1 schematic/netlist choice | PCB feature, not a purchased component
PCB test feature / GND | TP208 | PCB_TESTPAD_0P6_NO_PASTE | PCB feature: 0.6mm exposed round test land; no paste | FINAL_SELECTED_FOR_V1 | PCB_FEATURE | YES | EXACT_MPN_FROZEN | Frozen V1 schematic/netlist choice | PCB feature, no purchase; compact0.6mm land with unchanged0.5mm probe envelope; fine-tip probing
PCB test feature / 3V3_SENSOR | TP301 | PCB_TESTPAD_0P6_NO_PASTE | PCB feature: 0.6mm exposed round test land; no paste | FINAL_SELECTED_FOR_V1 | PCB_FEATURE | YES | EXACT_MPN_FROZEN | Frozen V1 schematic/netlist choice | PCB feature, no purchase; compact0.6mm land with unchanged0.5mm probe envelope; fine-tip probing
PCB test feature / SPI1_SCK | TP302 | TP0p6 | 0.6mm inline probe | FINAL_SELECTED_FOR_V1 | PCB_FEATURE | YES | EXACT_MPN_FROZEN | Frozen V1 schematic/netlist choice | PCB feature, not a purchased component
PCB test feature / SPI1_MOSI | TP303 | TP0p6 | 0.6mm inline probe | FINAL_SELECTED_FOR_V1 | PCB_FEATURE | YES | EXACT_MPN_FROZEN | Frozen V1 schematic/netlist choice | PCB feature, not a purchased component
PCB test feature / SPI1_MISO | TP304 | TP0p6 | 0.6mm inline probe | FINAL_SELECTED_FOR_V1 | PCB_FEATURE | YES | EXACT_MPN_FROZEN | Frozen V1 schematic/netlist choice | PCB feature, not a purchased component
PCB test feature / BMI088_ACC_CS | TP305 | PCB_TESTPAD_0P6_NO_PASTE | PCB feature: 0.6mm exposed round test land; no paste | FINAL_SELECTED_FOR_V1 | PCB_FEATURE | YES | EXACT_MPN_FROZEN | Frozen V1 schematic/netlist choice | PCB feature, no purchase; compact0.6mm land with unchanged0.5mm probe envelope; fine-tip probing
PCB test feature / BMI088_GYRO_CS | TP306 | PCB_TESTPAD_0P6_NO_PASTE | PCB feature: 0.6mm exposed round test land; no paste | FINAL_SELECTED_FOR_V1 | PCB_FEATURE | YES | EXACT_MPN_FROZEN | Frozen V1 schematic/netlist choice | PCB feature, no purchase; compact0.6mm land with unchanged0.5mm probe envelope; fine-tip probing
PCB test feature / BARO_I2C2_SCL | TP307 | PCB_TESTPAD_0P6_NO_PASTE | PCB feature: 0.6mm exposed round test land; no paste | FINAL_SELECTED_FOR_V1 | PCB_FEATURE | YES | EXACT_MPN_FROZEN | Frozen V1 schematic/netlist choice | PCB feature, no purchase; compact0.6mm land with unchanged0.5mm probe envelope; fine-tip probing
PCB test feature / BARO_I2C2_SDA | TP308 | PCB_TESTPAD_0P6_NO_PASTE | PCB feature: 0.6mm exposed round test land; no paste | FINAL_SELECTED_FOR_V1 | PCB_FEATURE | YES | EXACT_MPN_FROZEN | Frozen V1 schematic/netlist choice | PCB feature, no purchase; compact0.6mm land with unchanged0.5mm probe envelope; fine-tip probing
PCB test feature / GND | TP309 | PCB_TESTPAD_0P6_NO_PASTE | PCB feature: 0.6mm exposed round test land; no paste | FINAL_SELECTED_FOR_V1 | PCB_FEATURE | YES | EXACT_MPN_FROZEN | Frozen V1 schematic/netlist choice | PCB feature, no purchase; compact0.6mm land with unchanged0.5mm probe envelope; fine-tip probing
PCB test feature / USB_VBUS_RAW | TP401 | PCB_TESTPAD_0P6_NO_PASTE | PCB feature: 0.6mm exposed round test land; no paste | FINAL_SELECTED_FOR_V1 | PCB_FEATURE | YES | EXACT_MPN_FROZEN | Frozen V1 schematic/netlist choice | PCB feature, no purchase; compact0.6mm land with unchanged0.5mm probe envelope; fine-tip probing
PCB test feature / USB_VBUS_SENSE | TP402 | PCB_TESTPAD_0P6_NO_PASTE | PCB feature: 0.6mm exposed round test land; no paste | FINAL_SELECTED_FOR_V1 | PCB_FEATURE | YES | EXACT_MPN_FROZEN | Frozen V1 schematic/netlist choice | PCB feature, no purchase; compact0.6mm land with unchanged0.5mm probe envelope; fine-tip probing
PCB test feature / USB_DP | TP403 | TP0p6 | 0.6mm inline probe | FINAL_SELECTED_FOR_V1 | PCB_FEATURE | YES | EXACT_MPN_FROZEN | Frozen V1 schematic/netlist choice | PCB feature, not a purchased component
PCB test feature / USB_DM | TP404 | TP0p6 | 0.6mm inline probe | FINAL_SELECTED_FOR_V1 | PCB_FEATURE | YES | EXACT_MPN_FROZEN | Frozen V1 schematic/netlist choice | PCB feature, not a purchased component
PCB test feature / GND | TP405 | PCB_TESTPAD_0P6_NO_PASTE | PCB feature: 0.6mm exposed round test land; no paste | FINAL_SELECTED_FOR_V1 | PCB_FEATURE | YES | EXACT_MPN_FROZEN | Frozen V1 schematic/netlist choice | PCB feature, no purchase; compact0.6mm land with unchanged0.5mm probe envelope; fine-tip probing
PCB test feature / 3V3_SD | TP501 | PCB_TESTPAD_0P6_NO_PASTE | PCB feature: 0.6mm exposed round test land; no paste | FINAL_SELECTED_FOR_V1 | PCB_FEATURE | YES | EXACT_MPN_FROZEN | Frozen V1 schematic/netlist choice | PCB feature, no purchase; compact0.6mm land with unchanged0.5mm probe envelope; fine-tip probing
PCB test feature / SDMMC1_CK | TP502 | TP0p6 | 0.6mm inline probe | FINAL_SELECTED_FOR_V1 | PCB_FEATURE | YES | EXACT_MPN_FROZEN | Frozen V1 schematic/netlist choice | PCB feature, not a purchased component
PCB test feature / SDMMC1_CMD | TP503 | TP0p6 | 0.6mm inline probe | FINAL_SELECTED_FOR_V1 | PCB_FEATURE | YES | EXACT_MPN_FROZEN | Frozen V1 schematic/netlist choice | PCB feature, not a purchased component
PCB test feature / SDMMC1_D0 | TP504 | TP0p6 | 0.6mm inline probe | FINAL_SELECTED_FOR_V1 | PCB_FEATURE | YES | EXACT_MPN_FROZEN | Frozen V1 schematic/netlist choice | PCB feature, not a purchased component
PCB test feature / SDMMC1_D1 | TP505 | TP0p6 | 0.6mm inline probe | FINAL_SELECTED_FOR_V1 | PCB_FEATURE | YES | EXACT_MPN_FROZEN | Frozen V1 schematic/netlist choice | PCB feature, not a purchased component
PCB test feature / SDMMC1_D2 | TP506 | TP0p6 | 0.6mm inline probe | FINAL_SELECTED_FOR_V1 | PCB_FEATURE | YES | EXACT_MPN_FROZEN | Frozen V1 schematic/netlist choice | PCB feature, not a purchased component
PCB test feature / SDMMC1_D3 | TP507 | TP0p6 | 0.6mm inline probe | FINAL_SELECTED_FOR_V1 | PCB_FEATURE | YES | EXACT_MPN_FROZEN | Frozen V1 schematic/netlist choice | PCB feature, not a purchased component
PCB test feature / GND | TP508 | PCB_TESTPAD_0P6_NO_PASTE | PCB feature: 0.6mm exposed round test land; no paste | FINAL_SELECTED_FOR_V1 | PCB_FEATURE | YES | EXACT_MPN_FROZEN | Frozen V1 schematic/netlist choice | PCB feature, no purchase; compact0.6mm land with unchanged0.5mm probe envelope; fine-tip probing
PCB test feature / CAN_TX | TP601 | PCB_TESTPAD_0P6_NO_PASTE | PCB feature: 0.6mm exposed round test land; no paste | FINAL_SELECTED_FOR_V1 | PCB_FEATURE | YES | EXACT_MPN_FROZEN | Frozen V1 schematic/netlist choice | PCB feature, no purchase; compact0.6mm land with unchanged0.5mm probe envelope; fine-tip probing
PCB test feature / CAN_RX | TP602 | PCB_TESTPAD_0P6_NO_PASTE | PCB feature: 0.6mm exposed round test land; no paste | FINAL_SELECTED_FOR_V1 | PCB_FEATURE | YES | EXACT_MPN_FROZEN | Frozen V1 schematic/netlist choice | PCB feature, no purchase; compact0.6mm land with unchanged0.5mm probe envelope; fine-tip probing
PCB test feature / CANH | TP603 | PCB_TESTPAD_0P6_NO_PASTE | PCB feature: 0.6mm exposed round test land; no paste | FINAL_SELECTED_FOR_V1 | PCB_FEATURE | YES | EXACT_MPN_FROZEN | Frozen V1 schematic/netlist choice | PCB feature, no purchase; compact0.6mm land with unchanged0.5mm probe envelope; fine-tip probing
PCB test feature / CANL | TP604 | PCB_TESTPAD_0P6_NO_PASTE | PCB feature: 0.6mm exposed round test land; no paste | FINAL_SELECTED_FOR_V1 | PCB_FEATURE | YES | EXACT_MPN_FROZEN | Frozen V1 schematic/netlist choice | PCB feature, no purchase; compact0.6mm land with unchanged0.5mm probe envelope; fine-tip probing
PCB test feature / GND | TP605 | PCB_TESTPAD_0P6_NO_PASTE | PCB feature: 0.6mm exposed round test land; no paste | FINAL_SELECTED_FOR_V1 | PCB_FEATURE | YES | EXACT_MPN_FROZEN | Frozen V1 schematic/netlist choice | PCB feature, no purchase; compact0.6mm land with unchanged0.5mm probe envelope; fine-tip probing
PCB test feature / GPS_TX | TP701 | PCB_TESTPAD_0P6_NO_PASTE | PCB feature: 0.6mm exposed round test land; no paste | FINAL_SELECTED_FOR_V1 | PCB_FEATURE | YES | EXACT_MPN_FROZEN | Frozen V1 schematic/netlist choice | PCB feature, no purchase; compact0.6mm land with unchanged0.5mm probe envelope; fine-tip probing
PCB test feature / GPS_RX | TP702 | PCB_TESTPAD_0P6_NO_PASTE | PCB feature: 0.6mm exposed round test land; no paste | FINAL_SELECTED_FOR_V1 | PCB_FEATURE | YES | EXACT_MPN_FROZEN | Frozen V1 schematic/netlist choice | PCB feature, no purchase; compact0.6mm land with unchanged0.5mm probe envelope; fine-tip probing
PCB test feature / TELEM_TX | TP703 | PCB_TESTPAD_0P6_NO_PASTE | PCB feature: 0.6mm exposed round test land; no paste | FINAL_SELECTED_FOR_V1 | PCB_FEATURE | YES | EXACT_MPN_FROZEN | Frozen V1 schematic/netlist choice | PCB feature, no purchase; compact0.6mm land with unchanged0.5mm probe envelope; fine-tip probing
PCB test feature / TELEM_RX | TP704 | PCB_TESTPAD_0P6_NO_PASTE | PCB feature: 0.6mm exposed round test land; no paste | FINAL_SELECTED_FOR_V1 | PCB_FEATURE | YES | EXACT_MPN_FROZEN | Frozen V1 schematic/netlist choice | PCB feature, no purchase; compact0.6mm land with unchanged0.5mm probe envelope; fine-tip probing
PCB test feature / RC_TX | TP705 | PCB_TESTPAD_0P6_NO_PASTE | PCB feature: 0.6mm exposed round test land; no paste | FINAL_SELECTED_FOR_V1 | PCB_FEATURE | YES | EXACT_MPN_FROZEN | Frozen V1 schematic/netlist choice | PCB feature, no purchase; compact0.6mm land with unchanged0.5mm probe envelope; fine-tip probing
PCB test feature / RC_RX | TP706 | PCB_TESTPAD_0P6_NO_PASTE | PCB feature: 0.6mm exposed round test land; no paste | FINAL_SELECTED_FOR_V1 | PCB_FEATURE | YES | EXACT_MPN_FROZEN | Frozen V1 schematic/netlist choice | PCB feature, no purchase; compact0.6mm land with unchanged0.5mm probe envelope; fine-tip probing
PCB test feature / EXT_I2C1_SCL | TP707 | PCB_TESTPAD_0P6_NO_PASTE | PCB feature: 0.6mm exposed round test land; no paste | FINAL_SELECTED_FOR_V1 | PCB_FEATURE | YES | EXACT_MPN_FROZEN | Frozen V1 schematic/netlist choice | PCB feature, no purchase; compact0.6mm land with unchanged0.5mm probe envelope; fine-tip probing
PCB test feature / EXT_I2C1_SDA | TP708 | PCB_TESTPAD_0P6_NO_PASTE | PCB feature: 0.6mm exposed round test land; no paste | FINAL_SELECTED_FOR_V1 | PCB_FEATURE | YES | EXACT_MPN_FROZEN | Frozen V1 schematic/netlist choice | PCB feature, no purchase; compact0.6mm land with unchanged0.5mm probe envelope; fine-tip probing
PCB test feature / EXT_5V | TP709 | PCB_TESTPAD_0P6_NO_PASTE | PCB feature: 0.6mm exposed round test land; no paste | FINAL_SELECTED_FOR_V1 | PCB_FEATURE | YES | EXACT_MPN_FROZEN | Frozen V1 schematic/netlist choice | PCB feature, no purchase; compact0.6mm land with unchanged0.5mm probe envelope; fine-tip probing
PCB test feature / GND | TP710 | PCB_TESTPAD_0P6_NO_PASTE | PCB feature: 0.6mm exposed round test land; no paste | FINAL_SELECTED_FOR_V1 | PCB_FEATURE | YES | EXACT_MPN_FROZEN | Frozen V1 schematic/netlist choice | PCB feature, no purchase; compact0.6mm land with unchanged0.5mm probe envelope; fine-tip probing
PCB test feature / VBAT_DIV | TP801 | PCB_TESTPAD_0P6_NO_PASTE | PCB feature: 0.6mm exposed round test land; no paste | FINAL_SELECTED_FOR_V1 | PCB_FEATURE | YES | EXACT_MPN_FROZEN | Frozen V1 schematic/netlist choice | PCB feature, no purchase; compact0.6mm land with unchanged0.5mm probe envelope; fine-tip probing
PCB test feature / VBAT_ADC_PRE_PROTECTION | TP802 | PCB_TESTPAD_0P6_NO_PASTE | PCB feature: 0.6mm exposed round test land; no paste | FINAL_SELECTED_FOR_V1 | PCB_FEATURE | YES | EXACT_MPN_FROZEN | Frozen V1 schematic/netlist choice | PCB feature, no purchase; compact0.6mm land with unchanged0.5mm probe envelope; fine-tip probing
PCB test feature / VBAT_ADC | TP803 | PCB_TESTPAD_0P6_NO_PASTE | PCB feature: 0.6mm exposed round test land; no paste | FINAL_SELECTED_FOR_V1 | PCB_FEATURE | YES | EXACT_MPN_FROZEN | Frozen V1 schematic/netlist choice | PCB feature, no purchase; compact0.6mm land with unchanged0.5mm probe envelope; fine-tip probing
PCB test feature / CURRENT_IN_RAW | TP804 | PCB_TESTPAD_0P6_NO_PASTE | PCB feature: 0.6mm exposed round test land; no paste | FINAL_SELECTED_FOR_V1 | PCB_FEATURE | YES | EXACT_MPN_FROZEN | Frozen V1 schematic/netlist choice | PCB feature, no purchase; compact0.6mm land with unchanged0.5mm probe envelope; fine-tip probing
PCB test feature / CURRENT_ADC | TP805 | PCB_TESTPAD_0P6_NO_PASTE | PCB feature: 0.6mm exposed round test land; no paste | FINAL_SELECTED_FOR_V1 | PCB_FEATURE | YES | EXACT_MPN_FROZEN | Frozen V1 schematic/netlist choice | PCB feature, no purchase; compact0.6mm land with unchanged0.5mm probe envelope; fine-tip probing
PCB test feature / SWDIO | TP806 | PCB_TESTPAD_0P6_NO_PASTE | PCB feature: 0.6mm exposed round test land; no paste | FINAL_SELECTED_FOR_V1 | PCB_FEATURE | YES | EXACT_MPN_FROZEN | Frozen V1 schematic/netlist choice | PCB feature, no purchase; compact0.6mm land with unchanged0.5mm probe envelope; fine-tip probing
PCB test feature / SWCLK | TP807 | PCB_TESTPAD_0P6_NO_PASTE | PCB feature: 0.6mm exposed round test land; no paste | FINAL_SELECTED_FOR_V1 | PCB_FEATURE | YES | EXACT_MPN_FROZEN | Frozen V1 schematic/netlist choice | PCB feature, no purchase; compact0.6mm land with unchanged0.5mm probe envelope; fine-tip probing
PCB test feature / NRST | TP808 | PCB_TESTPAD_0P6_NO_PASTE | PCB feature: 0.6mm exposed round test land; no paste | FINAL_SELECTED_FOR_V1 | PCB_FEATURE | YES | EXACT_MPN_FROZEN | Frozen V1 schematic/netlist choice | PCB feature, no purchase; compact0.6mm land with unchanged0.5mm probe envelope; fine-tip probing
PCB test feature / GND | TP809 | PCB_TESTPAD_0P6_NO_PASTE | PCB feature: 0.6mm exposed round test land; no paste | FINAL_SELECTED_FOR_V1 | PCB_FEATURE | YES | EXACT_MPN_FROZEN | Frozen V1 schematic/netlist choice | PCB feature, no purchase; compact0.6mm land with unchanged0.5mm probe envelope; fine-tip probing
Main 5V buck | U101 | TPS54360BDDAR | DDA0008B HSOIC8 EP | FINAL_SELECTED_FOR_V1 | BENCH_VERIFY | YES | EXACT_MPN_FROZEN | Frozen V1 schematic/netlist choice | Bench/flight validation not completed
Secondary 3V3 buck | U102 | AP63203WU-7 | TSOT26 | FINAL_SELECTED_FOR_V1 | BENCH_VERIFY | YES | EXACT_MPN_FROZEN | Frozen V1 schematic/netlist choice | Bench/flight validation not completed
Sensor 3V3 LDO | U103 | TPS7A2033PDBVR | DBV5 SOT23-5 | FINAL_SELECTED_FOR_V1 | BENCH_VERIFY | YES | EXACT_MPN_FROZEN | Frozen V1 schematic/netlist choice | Bench/flight validation not completed
External 5V current limit switch | U104 | TPS2553DBVR | DBV6 SOT23-6 | FINAL_SELECTED_FOR_V1 | BENCH_VERIFY | YES | EXACT_MPN_FROZEN | Frozen V1 schematic/netlist choice | Bench/flight validation not completed
MCU / flight-control processor | U201 | STM32H743VIT6 | LQFP100 14x14 P0.5 | FINAL_SELECTED_FOR_V1 | BENCH_VERIFY | YES | EXACT_MPN_FROZEN | Frozen V1 schematic/netlist choice | Bench/flight validation not completed
IMU / accelerometer and gyroscope | U301 | BMI088 | LGA16 3x4.5 | FINAL_SELECTED_FOR_V1 | BENCH_VERIFY | YES | EXACT_MPN_FROZEN | Frozen V1 schematic/netlist choice | Bench/flight validation not completed
Barometer | U302 | SPL06-001 | LGA8 2x2.5 | FINAL_SELECTED_FOR_V1 | BENCH_VERIFY | YES | EXACT_MPN_FROZEN | Frozen V1 schematic/netlist choice | Bench/flight validation not completed
USB DP/DM ESD | U401 | TPD2E2U06QDBZRQ1 | DBZ / SOT-23-3 | FINAL_SELECTED_FOR_V1 | BENCH_VERIFY | YES | EXACT_MPN_AUTHORIZED_PCB01F3; supplier listed; not ordered | Frozen V1 schematic/netlist choice | Bench/flight validation not completed
USB VBUS logic sense | U402 | SN74LVC1G17DBVR | DBV5 SOT23-5 | FINAL_SELECTED_FOR_V1 | BENCH_VERIFY | YES | EXACT_MPN_FROZEN | Frozen V1 schematic/netlist choice | Bench/flight validation not completed
USB VBUS ESD | U403 | TPD2E2U06QDBZRQ1 | DBZ / SOT-23-3 | FINAL_SELECTED_FOR_V1 | BENCH_VERIFY | YES | EXACT_MPN_AUTHORIZED_PCB01F3; supplier listed; not ordered | Frozen V1 schematic/netlist choice | Bench/flight validation not completed
USB CC ESD | U404 | TPD2E2U06QDBZRQ1 | DBZ / SOT-23-3 | FINAL_SELECTED_FOR_V1 | BENCH_VERIFY | YES | EXACT_MPN_AUTHORIZED_PCB01F3; supplier listed; not ordered | Frozen V1 schematic/netlist choice | Bench/flight validation not completed
CAN transceiver | U601 | TCAN3414DR | TI D0008A SOIC-8 | FINAL_SELECTED_FOR_V1 | BENCH_VERIFY | YES | EXACT_MPN_FROZEN | Frozen V1 schematic/netlist choice | Bench/flight validation not completed
PWM / ADC / debug interface | U801 | TMUX1511PWR | PW14 TSSOP14 0.65mm visible leads | FINAL_SELECTED_FOR_V1 | NOT_TESTED | YES | EXACT_MPN_FROZEN | Frozen V1 schematic/netlist choice | Bench/flight validation not completed
MCU / clock / reset support | Y201 | XJHCELNANF-8M | HC49-class 2SMD 12.5x4.5x4 | FINAL_SELECTED_FOR_V1 | NOT_TESTED | YES | EXACT_MPN_FROZEN | Frozen V1 schematic/netlist choice | Bench/flight validation not completed
Alternative IMU |  | ICM-42688-P |  | NOT_SELECTED_FOR_V1 | NOT_SELECTED | NO |  | Frozen V1 uses BMI088 | Not in BOM; no new model comparison
Alternative barometer |  | DPS310 |  | NOT_SELECTED_FOR_V1 | NOT_SELECTED | NO |  | Frozen V1 uses SPL06-001 | Not in BOM; no new model comparison
