chen123037/X100-Flight-Controller-Edu/hardware/current/X100_6L_DFM_ZERO_DANGER/procurement/X100_当前淘宝器件清单.xlsx

Sheet: 采购汇总
X100 淘宝器件搜索与备料清单
板数 | 1 |  | 每板件数 | 142 |  | 计划件数 | 142 |  | 完整型号种数 | 62
每板142件、62种MPN。改变B4可计算整板用量；未含焊接损耗和备件。搜索链接不是验真商品链接。
候选字段仍涉及 C121、R105、U105、U106；保留原始状态，不自动视为已采购或重新否定已有人工裁决。
序号 | 类别 | 厂家 | 完整MPN | 封装 | 每板用量 | 计划用量 | 位号 | 待核对事项 | 淘宝搜索词 | 淘宝搜索链接 | 参数说明
1 | 电容 | KEMET | C1210C106K5RACTU | 1210 | 8 | 8 | C101,C102,C103,C104,C111,C118,C208,C502 | 核对完整型号与封装；店铺未验真 | KEMET C1210C106K5RACTU 1210 | https://s.taobao.com/search?q=KEMET%20C1210C106K5RACTU%201210 | 10u /50V X7R / 10u AP input / 10u switch input / 10u /50V MCU bulk >=4.7u effective / 10u /50V SD local
2 | 电容 | Panasonic | 50SVPF39M | OS-CON E12 diameter8 height11.9 | 1 | 1 | C105 | 核对完整型号与封装；店铺未验真 | Panasonic 50SVPF39M OS-CON E12 diameter8 height11.9 | https://s.taobao.com/search?q=Panasonic%2050SVPF39M%20OS-CON%20E12%20diameter8%20height11.9 | 39u /50V +VIN
3 | 电容 | KEMET | C0603C104K5RACTU | 0603 | 19 | 19 | C106,C107,C112,C117,C203,C204,C205,C206,C207,C210,C211,C301,C302,C303,C304,C402,C501,C601,C805 | 核对完整型号与封装；店铺未验真 | KEMET C0603C104K5RACTU 0603 | https://s.taobao.com/search?q=KEMET%20C0603C104K5RACTU%200603 | 100n /50V 0603 VIN loop / 100n BOOT-SW / 100n BST-SW / 100n switch input loop / 100n local VDD pin11 / 100n local VDD pin27 / 100n local VDD pin50 / 100n local VDD pin75 / 100n local VDD pin100 / 100n VDDA pin21/VREF20 / 100n MCU VBAT pin6 / 100n VDD3 loop / 100n VDDIO11 loop / 100n SPL VDD8 / 100n SPL VDDIO6 / 100n buffer VCC / 100n socket VDD loop / 100n VCC3 loop / 100n U801 VDD14
4 | 电容 | Panasonic | 16SVPF180M | OS-CON C6 diameter6.3 height5.9 | 2 | 2 | C108,C121 | 候选字段待核对：C121 | Panasonic 16SVPF180M OS-CON C6 diameter6.3 height5.9 | https://s.taobao.com/search?q=Panasonic%2016SVPF180M%20OS-CON%20C6%20diameter6.3%20height5.9 | 180u /16V +5V_MAIN / 180u /16V core mux hold-up (+ pin1)
5 | 电容 | KEMET | C0805C223K5RACTU | 0805 | 3 | 3 | C109,C803,C804 | 核对完整型号与封装；店铺未验真 | KEMET C0805C223K5RACTU 0805 | https://s.taobao.com/search?q=KEMET%20C0805C223K5RACTU%200805 | 22n COMP series / 22n X7R 50V ADC reservoir
6 | 电容 | KEMET | C0805C241J5GACTU | 0805 | 1 | 1 | C110 | 核对完整型号与封装；店铺未验真 | KEMET C0805C241J5GACTU 0805 | https://s.taobao.com/search?q=KEMET%20C0805C241J5GACTU%200805 | 240p COMP pole
7 | 电容 | KEMET | C1210C226K4RACTU | 1210 | 2 | 2 | C113,C114 | 核对完整型号与封装；店铺未验真 | KEMET C1210C226K4RACTU 1210 | https://s.taobao.com/search?q=KEMET%20C1210C226K4RACTU%201210 | 22u /16V
8 | 电容 | KEMET | C0805C225K4RACTU | 0805 | 5 | 5 | C115,C116,C201,C202,C209 | 核对完整型号与封装；店铺未验真 | KEMET C0805C225K4RACTU 0805 | https://s.taobao.com/search?q=KEMET%20C0805C225K4RACTU%200805 | 2.2u /16V input / 2.2u /16V output / 2.2u VCAP /16V / 2.2u VDDA
9 | 电容 | Panasonic | 16SVPF82M | OS-CON B6 diameter5 height5.9 | 1 | 1 | C119 | 核对完整型号与封装；店铺未验真 | Panasonic 16SVPF82M OS-CON B6 diameter5 height5.9 | https://s.taobao.com/search?q=Panasonic%2016SVPF82M%20OS-CON%20B6%20diameter5%20height5.9 | 82u /16V PTC-before bulk
10 | 电容 | KEMET | C0805C105K4RACTU | 0805 | 5 | 5 | C120,C123,C124,C125,C126 | 核对完整型号与封装；店铺未验真 | KEMET C0805C105K4RACTU 0805 | https://s.taobao.com/search?q=KEMET%20C0805C105K4RACTU%200805 | 1u EXT local / 1u /16V shared input bypass / 1u /16V / 1u /16V mux VIN1 / 1u /16V mux output
11 | 电容 | KEMET | C0805C104K5RACTU | 0805 | 4 | 4 | C212,C401,C801,C802 | 核对完整型号与封装；店铺未验真 | KEMET C0805C104K5RACTU 0805 | https://s.taobao.com/search?q=KEMET%20C0805C104K5RACTU%200805 | 100n reset / 100n clamp bypass only / 100n ADC LPF / 100n X7R 50V
12 | 电容 | YAGEO | CC0805JRNPO9BN330 | 0805 | 2 | 2 | C213,C214 | 核对完整型号与封装；店铺未验真 | YAGEO CC0805JRNPO9BN330 0805 | https://s.taobao.com/search?q=YAGEO%20CC0805JRNPO9BN330%200805 | 33p C0G /0805
13 | 二极管或LED | Nexperia | BZT52H-C12,115 | SOD123F | 1 | 1 | D101 | 核对完整型号与封装；店铺未验真 | Nexperia BZT52H-C12,115 SOD123F | https://s.taobao.com/search?q=Nexperia%20BZT52H-C12%2C115%20SOD123F | 12V VGS clamp K=source
14 | 二极管或LED | ST | SMBJ26CA-TR | SMB DO214AA | 1 | 1 | D102 | 核对完整型号与封装；店铺未验真 | ST SMBJ26CA-TR SMB DO214AA | https://s.taobao.com/search?q=ST%20SMBJ26CA-TR%20SMB%20DO214AA | 26V bidirectional TVS
15 | 二极管或LED | ST | STPS8H100G-TR | D2PAK A/K/tabK | 1 | 1 | D103 | 核对完整型号与封装；店铺未验真 | ST STPS8H100G-TR D2PAK A/K/tabK | https://s.taobao.com/search?q=ST%20STPS8H100G-TR%20D2PAK%20A/K/tabK | STPS8H100G-TR
16 | 二极管或LED | Lite-On | LTST-C170GKT | 0805 LED | 2 | 2 | D201,D202 | 核对完整型号与封装；店铺未验真 | Lite-On LTST-C170GKT 0805 LED | https://s.taobao.com/search?q=Lite-On%20LTST-C170GKT%200805%20LED | GREEN; PB0 HIGH=ON / GREEN; 3V3_MCU_PRESENT
17 | 保险丝 | Littelfuse | 0451003.MRL | NANO2 451 SMD | 1 | 1 | F101 | 核对完整型号与封装；店铺未验真 | Littelfuse 0451003.MRL NANO2 451 SMD | https://s.taobao.com/search?q=Littelfuse%200451003.MRL%20NANO2%20451%20SMD | 3A /125V
18 | 连接器 | Amphenol | 124019772112A | USB-C dual-row SMT / 4 plated SH slots | 1 | 1 | J401 | 核对完整型号与封装；店铺未验真 | Amphenol 124019772112A USB-C dual-row SMT / 4 plated SH slots | https://s.taobao.com/search | 124019772112A
19 | 连接器 | Molex | 1040310811 | microSD SMT push-pull8+2detect | 1 | 1 | J501 | 核对完整型号与封装；店铺未验真 | Molex 1040310811 microSD SMT push-pull8+2detect | https://s.taobao.com/search?q=Molex%201040310811%20microSD%20SMT%20push-pull8%2B2detect | 1040310811
20 | 连接器 | JST | SM04B-GHS-TB(LF)(SN) | GH1.25 4P side-entry SMT | 2 | 2 | J601,J704 | 核对完整型号与封装；店铺未验真 | JST SM04B-GHS-TB(LF)(SN) GH1.25 4P side-entry SMT | https://s.taobao.com/search?q=JST%20SM04B-GHS-TB%28LF%29%28SN%29%20GH1.25%204P%20side-entry%20SMT | SM04B-GHS-TB(LF)(SN)
21 | 连接器 | JST | SM06B-GHS-TB(LF)(SN) | GH1.25 6P side-entry SMT | 4 | 4 | J701,J702,J703,J809 | 核对完整型号与封装；店铺未验真 | JST SM06B-GHS-TB(LF)(SN) GH1.25 6P side-entry SMT | https://s.taobao.com/search?q=JST%20SM06B-GHS-TB%28LF%29%28SN%29%20GH1.25%206P%20side-entry%20SMT | SM06B-GHS-TB(LF)(SN) / CURRENT monitor only
22 | 连接器 | Samtec | TSW-102-07-G-S | 1x2 2.54 THT top insertion | 6 | 6 | J801,J802,J803,J804,J805,J806 | 核对完整型号与封装；店铺未验真 | Samtec TSW-102-07-G-S 1x2 2.54 THT top insertion | https://s.taobao.com/search?q=Samtec%20TSW-102-07-G-S%201x2%202.54%20THT%20top%20insertion | OUT1 /GND / OUT2 /GND / OUT3 /GND / OUT4 /GND / OUT5 /GND / OUT6 /GND
23 | 连接器 | Samtec | TSW-105-07-G-S | 1x5 2.54 THT top insertion | 1 | 1 | J807 | 核对完整型号与封装；店铺未验真 | Samtec TSW-105-07-G-S 1x5 2.54 THT top insertion | https://s.taobao.com/search?q=Samtec%20TSW-105-07-G-S%201x5%202.54%20THT%20top%20insertion | SWD:1REF2GND3IO4CLK5NRST
24 | 电感 | Bourns | SRP1038A-100M | Lead-frame SMD; case max11.5x10.3x4.0mm | 1 | 1 | L101 | 核对完整型号与封装；店铺未验真 | Bourns SRP1038A-100M Lead-frame SMD; case max11.5x10.3x4.0mm | https://s.taobao.com/search | 10uH
25 | 电感 | Bourns | SRN6045-4R7Y | 6x6x4.5 SMD visible end terminals | 1 | 1 | L102 | 核对完整型号与封装；店铺未验真 | Bourns SRN6045-4R7Y 6x6x4.5 SMD visible end terminals | https://s.taobao.com/search?q=Bourns%20SRN6045-4R7Y%206x6x4.5%20SMD%20visible%20end%20terminals | 4.7uH design-calculated at 5V
26 | MOS管 | Diodes | DMP6023LSS-13 | SO8 | 1 | 1 | Q101 | 核对完整型号与封装；店铺未验真 | Diodes DMP6023LSS-13 SO8 | https://s.taobao.com/search?q=Diodes%20DMP6023LSS-13%20SO8 | DMP6023LSS-13
27 | 电阻 | YAGEO | RC0805FR-0720KL | 0805 | 2 | 2 | R101,R806 | 核对完整型号与封装；店铺未验真 | YAGEO RC0805FR-0720KL 0805 | https://s.taobao.com/search?q=YAGEO%20RC0805FR-0720KL%200805 | 20k / 20k 1% scale20/42.1
28 | 电阻 | YAGEO | RC0805FR-07294KL | 0805 | 1 | 1 | R102 | 核对完整型号与封装；店铺未验真 | YAGEO RC0805FR-07294KL 0805 | https://s.taobao.com/search?q=YAGEO%20RC0805FR-07294KL%200805 | 294k
29 | 电阻 | YAGEO | RC0805FR-0754K9L | 0805 | 1 | 1 | R103 | 核对完整型号与封装；店铺未验真 | YAGEO RC0805FR-0754K9L 0805 | https://s.taobao.com/search?q=YAGEO%20RC0805FR-0754K9L%200805 | 54.9k
30 | 电阻 | YAGEO | RC0805FR-07200KL | 0805 | 1 | 1 | R104 | 核对完整型号与封装；店铺未验真 | YAGEO RC0805FR-07200KL 0805 | https://s.taobao.com/search?q=YAGEO%20RC0805FR-07200KL%200805 | 200k
31 | 电阻 | YAGEO | RT0805BRD0753K6L | 0805 | 1 | 1 | R105 | 候选字段待核对：R105 | YAGEO RT0805BRD0753K6L 0805 | https://s.taobao.com/search?q=YAGEO%20RT0805BRD0753K6L%200805 | 53.6k 0.1%
32 | 电阻 | YAGEO | RT0805BRD0710KL | 0805 | 3 | 3 | R106,R112,R802 | 核对完整型号与封装；店铺未验真 | YAGEO RT0805BRD0710KL 0805 | https://s.taobao.com/search?q=YAGEO%20RT0805BRD0710KL%200805 | 10k 0.1% / 10k 0.1% scale16
33 | 电阻 | YAGEO | RC0805FR-0718K7L | 0805 | 1 | 1 | R107 | 核对完整型号与封装；店铺未验真 | YAGEO RC0805FR-0718K7L 0805 | https://s.taobao.com/search?q=YAGEO%20RC0805FR-0718K7L%200805 | 18.7k
34 | 电阻 | YAGEO | RC0805FR-0710RL | 0805 | 2 | 2 | R108,R201 | 核对完整型号与封装；店铺未验真 | YAGEO RC0805FR-0710RL 0805 | https://s.taobao.com/search?q=YAGEO%20RC0805FR-0710RL%200805 | 10R RC sensor filter / 10R VDDA filter
35 | 电阻 | YAGEO | RC0805FR-0722K1L | 0805 | 2 | 2 | R109,R805 | 核对完整型号与封装；店铺未验真 | YAGEO RC0805FR-0722K1L 0805 | https://s.taobao.com/search?q=YAGEO%20RC0805FR-0722K1L%200805 | 22.1k limit / 22.1k 1% >=100V
36 | 电阻 | YAGEO | RC0805FR-0710KL | 0805 | 10 | 10 | R110,R114,R203,R204,R301,R302,R403,R603,R604,R811 | 核对完整型号与封装；店铺未验真 | YAGEO RC0805FR-0710KL 0805 | https://s.taobao.com/search?q=YAGEO%20RC0805FR-0710KL%200805 | 10k FAULT pullup / 10k ST pull-up / 10k reset pullup / 10k BOOT0 default LOW / 10k CS1 safe HIGH / 10k CS2 safe HIGH / 10k detection input / 10k TXD default recessive / 10k / 10k rail discharge; off bound 81.6mV
37 | 电阻 | Yageo | RT0805BRD0733K2L |  | 1 | 1 | R111 | 核对完整型号与封装；店铺未验真 | Yageo RT0805BRD0733K2L | https://s.taobao.com/search?q=Yageo%20RT0805BRD0733K2L%20 | 33.2k 0.1%
38 | 电阻 | YAGEO | RT0805BRD0749K9L |  | 1 | 1 | R113 | 核对完整型号与封装；店铺未验真 | YAGEO RT0805BRD0749K9L | https://s.taobao.com/search?q=YAGEO%20RT0805BRD0749K9L%20 | 49.9k 0.1%
39 | 电阻 | YAGEO | RC0805FR-07120RL | 0805 | 2 | 2 | R205,R602 | 核对完整型号与封装；店铺未验真 | YAGEO RC0805FR-07120RL 0805 | https://s.taobao.com/search?q=YAGEO%20RC0805FR-07120RL%200805 | 120R HSE series / 120R end termination
40 | 电阻 | YAGEO | RC0805FR-071KL | 0805 | 5 | 5 | R206,R803,R804,R807,R808 | 核对完整型号与封装；店铺未验真 | YAGEO RC0805FR-071KL 0805 | https://s.taobao.com/search?q=YAGEO%20RC0805FR-071KL%200805 | 1k LED current / 1k ADC series / 1k isolate ADC reservoir / 1k current limit
41 | 电阻 | YAGEO | RC0805FR-071K2L | 0805 | 1 | 1 | R207 | 核对完整型号与封装；店铺未验真 | YAGEO RC0805FR-071K2L 0805 | https://s.taobao.com/search?q=YAGEO%20RC0805FR-071K2L%200805 | 1.2k PWR current
42 | 电阻 | YAGEO | RC0805FR-074K7L | 0805 | 4 | 4 | R303,R304,R701,R702 | 核对完整型号与封装；店铺未验真 | YAGEO RC0805FR-074K7L 0805 | https://s.taobao.com/search?q=YAGEO%20RC0805FR-074K7L%200805 | 4.7k internal SCL pullup / 4.7k internal SDA pullup / 4.7k externalSCL pullup / 4.7k externalSDA pullup
43 | 电阻 | YAGEO | RC0805FR-075K1L | 0805 | 2 | 2 | R401,R402 | 核对完整型号与封装；店铺未验真 | YAGEO RC0805FR-075K1L 0805 | https://s.taobao.com/search?q=YAGEO%20RC0805FR-075K1L%200805 | 5.1k CC1 Rd / 5.1k CC2 Rd
44 | 电阻 | YAGEO | RC0805FR-07100KL | 0805 | 1 | 1 | R404 | 核对完整型号与封装；店铺未验真 | YAGEO RC0805FR-07100KL 0805 | https://s.taobao.com/search?q=YAGEO%20RC0805FR-07100KL%200805 | 100k unplug LOW
45 | 电阻 | YAGEO | RC0805JR-070RL | 0805 | 1 | 1 | R501 | 核对完整型号与封装；店铺未验真 | YAGEO RC0805JR-070RL 0805 | https://s.taobao.com/search?q=YAGEO%20RC0805JR-070RL%200805 | 0R SD service isolation
46 | 电阻 | YAGEO | RC0805FR-0747KL | 0805 | 5 | 5 | R502,R503,R504,R505,R506 | 核对完整型号与封装；店铺未验真 | YAGEO RC0805FR-0747KL 0805 | https://s.taobao.com/search?q=YAGEO%20RC0805FR-0747KL%200805 | 47k SD pullup
47 | 电阻 | YAGEO | RT0805BRD07150KL | 0805 | 1 | 1 | R801 | 核对完整型号与封装；店铺未验真 | YAGEO RT0805BRD07150KL 0805 | https://s.taobao.com/search?q=YAGEO%20RT0805BRD07150KL%200805 | 150k 0.1%
48 | 电阻 | YAGEO | RC0805FR-071M3L | 0805 | 2 | 2 | R809,R810 | 核对完整型号与封装；店铺未验真 | YAGEO RC0805FR-071M3L 0805 | https://s.taobao.com/search?q=YAGEO%20RC0805FR-071M3L%200805 | 1.3M 1% discharge/IOFF bound
49 | 芯片 | TI | TPS54360BDDAR | DDA0008B HSOIC8 EP | 1 | 1 | U101 | 核对完整型号与封装；店铺未验真 | TI TPS54360BDDAR DDA0008B HSOIC8 EP | https://s.taobao.com/search?q=TI%20TPS54360BDDAR%20DDA0008B%20HSOIC8%20EP | TPS54360BDDAR
50 | 芯片 | Diodes | AP63203WU-7 | TSOT26 | 1 | 1 | U102 | 核对完整型号与封装；店铺未验真 | Diodes AP63203WU-7 TSOT26 | https://s.taobao.com/search?q=Diodes%20AP63203WU-7%20TSOT26 | AP63203WU-7
51 | 芯片 | TI | TPS7A2033PDBVR | DBV5 SOT23-5 | 1 | 1 | U103 | 核对完整型号与封装；店铺未验真 | TI TPS7A2033PDBVR DBV5 SOT23-5 | https://s.taobao.com/search?q=TI%20TPS7A2033PDBVR%20DBV5%20SOT23-5 | TPS7A2033PDBVR
52 | 芯片 | TI | TPS2553DBVR | DBV6 SOT23-6 | 2 | 2 | U104,U106 | 候选字段待核对：U106 | TI TPS2553DBVR DBV6 SOT23-6 | https://s.taobao.com/search?q=TI%20TPS2553DBVR%20DBV6%20SOT23-6 | TPS2553DBVR
53 | 芯片 | Texas Instruments | TPS2116DRLR |  | 1 | 1 | U105 | 候选字段待核对：U105 | Texas Instruments TPS2116DRLR | https://s.taobao.com/search?q=Texas%20Instruments%20TPS2116DRLR%20 | TPS2116DRLR
54 | 芯片 | ST | STM32H743VIT6 | LQFP100 14x14 P0.5 | 1 | 1 | U201 | 核对完整型号与封装；店铺未验真 | ST STM32H743VIT6 LQFP100 14x14 P0.5 | https://s.taobao.com/search?q=ST%20STM32H743VIT6%20LQFP100%2014x14%20P0.5 | STM32H743VIT6
55 | 芯片 | Bosch | BMI088 | LGA16 3x4.5 | 1 | 1 | U301 | 核对完整型号与封装；店铺未验真 | Bosch BMI088 LGA16 3x4.5 | https://s.taobao.com/search?q=Bosch%20BMI088%20LGA16%203x4.5 | BMI088
56 | 芯片 | Goertek | SPL06-001 | LGA8 2x2.5 | 1 | 1 | U302 | 核对完整型号与封装；店铺未验真 | Goertek SPL06-001 LGA8 2x2.5 | https://s.taobao.com/search?q=Goertek%20SPL06-001%20LGA8%202x2.5 | SPL06-001
57 | 芯片 | TI | TPD4E1U06DBVR | DBV SOT-23-6 | 1 | 1 | U401 | 核对完整型号与封装；店铺未验真 | TI TPD4E1U06DBVR DBV SOT-23-6 | https://s.taobao.com/search?q=TI%20TPD4E1U06DBVR%20DBV%20SOT-23-6 | TPD4E1U06DBVR
58 | 芯片 | TI | SN74LVC1G17DBVR | DBV5 SOT23-5 | 1 | 1 | U402 | 核对完整型号与封装；店铺未验真 | TI SN74LVC1G17DBVR DBV5 SOT23-5 | https://s.taobao.com/search?q=TI%20SN74LVC1G17DBVR%20DBV5%20SOT23-5 | SN74LVC1G17DBVR
59 | 芯片 | Texas Instruments | TPD2E2U06QDBZRQ1 | DBZ / SOT-23-3 | 1 | 1 | U403 | 核对完整型号与封装；店铺未验真 | Texas Instruments TPD2E2U06QDBZRQ1 DBZ / SOT-23-3 | https://s.taobao.com/search?q=Texas%20Instruments%20TPD2E2U06QDBZRQ1%20DBZ%20/%20SOT-23-3 | TPD2E2U06QDBZRQ1
60 | 芯片 | Texas Instruments | TCAN3414DR | TI D0008A SOIC-8 | 1 | 1 | U601 | 核对完整型号与封装；店铺未验真 | Texas Instruments TCAN3414DR TI D0008A SOIC-8 | https://s.taobao.com/search?q=Texas%20Instruments%20TCAN3414DR%20TI%20D0008A%20SOIC-8 | TCAN3414DR
61 | 芯片 | TI | TMUX1511PWR | PW14 TSSOP14 0.65mm visible leads | 1 | 1 | U801 | 核对完整型号与封装；店铺未验真 | TI TMUX1511PWR PW14 TSSOP14 0.65mm visible leads | https://s.taobao.com/search?q=TI%20TMUX1511PWR%20PW14%20TSSOP14%200.65mm%20visible%20leads | TMUX1511PWR
62 | 晶振 | TAITIEN | XJHCELNANF-8M | HC49-class 2SMD 12.5x4.5x4 | 1 | 1 | Y201 | 核对完整型号与封装；店铺未验真 | TAITIEN XJHCELNANF-8M HC49-class 2SMD 12.5x4.5x4 | https://s.taobao.com/search?q=TAITIEN%20XJHCELNANF-8M%20HC49-class%202SMD%2012.5x4.5x4 | 8.000MHz /CL20pF

Sheet: 位号明细
当前六层工程：142 个采购位号
来源：当前六层V4 fresh网表；封装补充字段与同MPN父级BOM逐项核对。商家、现货和价格未核验。
位号 | 当前参数 | 厂家 | 完整MPN | 封装 | 每板数量 | 面别 | 原始选型状态 | 原始验证状态 | 规格要求 | PCB封装标识 | 淘宝搜索链接 | 原厂资料
C101 | 10u /50V X7R | KEMET | C1210C106K5RACTU | 1210 | 1 | 背面 | SPECIFICATION_FROZEN_PREFERRED_BOM |  | 精度：10%；耐压：>=50V；介质：X7R | X100_Physical:Official_Capacitor_SMD_C_1210_3225Metric | https://s.taobao.com/search?q=KEMET%20C1210C106K5RACTU%201210 | https://www.yageogroup.com/component-documentation/download/specsheet/C1210C106K5RACTU
C102 | 10u /50V X7R | KEMET | C1210C106K5RACTU | 1210 | 1 | 背面 | SPECIFICATION_FROZEN_PREFERRED_BOM |  | 精度：10%；耐压：>=50V；介质：X7R | X100_Physical:Official_Capacitor_SMD_C_1210_3225Metric | https://s.taobao.com/search?q=KEMET%20C1210C106K5RACTU%201210 | https://www.yageogroup.com/component-documentation/download/specsheet/C1210C106K5RACTU
C103 | 10u /50V X7R | KEMET | C1210C106K5RACTU | 1210 | 1 | 背面 | SPECIFICATION_FROZEN_PREFERRED_BOM |  | 精度：10%；耐压：>=50V；介质：X7R | X100_Physical:Official_Capacitor_SMD_C_1210_3225Metric | https://s.taobao.com/search?q=KEMET%20C1210C106K5RACTU%201210 | https://www.yageogroup.com/component-documentation/download/specsheet/C1210C106K5RACTU
C104 | 10u /50V X7R | KEMET | C1210C106K5RACTU | 1210 | 1 | 背面 | SPECIFICATION_FROZEN_PREFERRED_BOM |  | 精度：10%；耐压：>=50V；介质：X7R | X100_Physical:Official_Capacitor_SMD_C_1210_3225Metric | https://s.taobao.com/search?q=KEMET%20C1210C106K5RACTU%201210 | https://www.yageogroup.com/component-documentation/download/specsheet/C1210C106K5RACTU
C105 | 39u /50V +VIN | Panasonic | 50SVPF39M | OS-CON E12 diameter8 height11.9 | 1 | 正面 | EXACT_MPN_FROZEN |  |  | X100_Physical:Panasonic_OSCON_E12 | https://s.taobao.com/search?q=Panasonic%2050SVPF39M%20OS-CON%20E12%20diameter8%20height11.9 | https://industrial.panasonic.com/ww/products/pt/os-con/models/50SVPF39M
C106 | 100n /50V 0603 VIN loop | KEMET | C0603C104K5RACTU | 0603 | 1 | 背面 | SPECIFICATION_FROZEN_PREFERRED_BOM |  | 精度：10%；耐压：>=50V；介质：X7R | X100_Physical:Official_Capacitor_SMD_C_0603_1608Metric | https://s.taobao.com/search?q=KEMET%20C0603C104K5RACTU%200603 | https://www.yageogroup.com/component-documentation/download/specsheet/C0603C104K5RACTU
C107 | 100n BOOT-SW | KEMET | C0603C104K5RACTU | 0603 | 1 | 背面 | SPECIFICATION_FROZEN_PREFERRED_BOM |  | 精度：10%；耐压：>=50V；介质：X7R | X100_Physical:Official_Capacitor_SMD_C_0603_1608Metric | https://s.taobao.com/search?q=KEMET%20C0603C104K5RACTU%200603 | https://www.yageogroup.com/component-documentation/download/specsheet/C0603C104K5RACTU
C108 | 180u /16V +5V_MAIN | Panasonic | 16SVPF180M | OS-CON C6 diameter6.3 height5.9 | 1 | 背面 | EXACT_MPN_FROZEN |  |  | X100_Physical:Panasonic_OSCON_C6 | https://s.taobao.com/search?q=Panasonic%2016SVPF180M%20OS-CON%20C6%20diameter6.3%20height5.9 | https://industrial.panasonic.com/ww/products/pt/os-con/models/16SVPF180M
C109 | 22n COMP series | KEMET | C0805C223K5RACTU | 0805 | 1 | 背面 | SPECIFICATION_FROZEN_PREFERRED_BOM |  | 精度：10%；耐压：>=50V；介质：X7R | X100_Physical:Official_Capacitor_SMD_C_0805_2012Metric | https://s.taobao.com/search?q=KEMET%20C0805C223K5RACTU%200805 | https://www.yageogroup.com/component-documentation/download/specsheet/C0805C223K5RACTU
C110 | 240p COMP pole | KEMET | C0805C241J5GACTU | 0805 | 1 | 背面 | SPECIFICATION_FROZEN_PREFERRED_BOM |  | 精度：5%；耐压：>=50V；介质：C0G/NP0 | X100_Physical:Official_Capacitor_SMD_C_0805_2012Metric | https://s.taobao.com/search?q=KEMET%20C0805C241J5GACTU%200805 | https://www.yageogroup.com/component-documentation/download/specsheet/C0805C241J5GACTU
C111 | 10u AP input | KEMET | C1210C106K5RACTU | 1210 | 1 | 背面 | SPECIFICATION_FROZEN_PREFERRED_BOM |  | 精度：10%；耐压：>=50V；介质：X7R | X100_Physical:Official_Capacitor_SMD_C_1210_3225Metric | https://s.taobao.com/search?q=KEMET%20C1210C106K5RACTU%201210 | https://www.yageogroup.com/component-documentation/download/specsheet/C1210C106K5RACTU
C112 | 100n BST-SW | KEMET | C0603C104K5RACTU | 0603 | 1 | 背面 | SPECIFICATION_FROZEN_PREFERRED_BOM |  | 精度：10%；耐压：>=50V；介质：X7R | X100_Physical:Official_Capacitor_SMD_C_0603_1608Metric | https://s.taobao.com/search?q=KEMET%20C0603C104K5RACTU%200603 | https://www.yageogroup.com/component-documentation/download/specsheet/C0603C104K5RACTU
C113 | 22u /16V | KEMET | C1210C226K4RACTU | 1210 | 1 | 背面 | SPECIFICATION_FROZEN_PREFERRED_BOM |  | 精度：10%；耐压：>=16V；介质：X7R | X100_Physical:Official_Capacitor_SMD_C_1210_3225Metric | https://s.taobao.com/search?q=KEMET%20C1210C226K4RACTU%201210 | https://www.yageogroup.com/component-documentation/download/specsheet/C1210C226K4RACTU
C114 | 22u /16V | KEMET | C1210C226K4RACTU | 1210 | 1 | 背面 | SPECIFICATION_FROZEN_PREFERRED_BOM |  | 精度：10%；耐压：>=16V；介质：X7R | X100_Physical:Official_Capacitor_SMD_C_1210_3225Metric | https://s.taobao.com/search?q=KEMET%20C1210C226K4RACTU%201210 | https://www.yageogroup.com/component-documentation/download/specsheet/C1210C226K4RACTU
C115 | 2.2u /16V input | KEMET | C0805C225K4RACTU | 0805 | 1 | 正面 | SPECIFICATION_FROZEN_PREFERRED_BOM |  | 精度：10%；耐压：>=16V；介质：X7R | X100_Physical:Official_Capacitor_SMD_C_0805_2012Metric | https://s.taobao.com/search?q=KEMET%20C0805C225K4RACTU%200805 | https://www.yageogroup.com/component-documentation/download/specsheet/C0805C225K4RACTU
C116 | 2.2u /16V output | KEMET | C0805C225K4RACTU | 0805 | 1 | 正面 | SPECIFICATION_FROZEN_PREFERRED_BOM |  | 精度：10%；耐压：>=16V；介质：X7R | X100_Physical:Official_Capacitor_SMD_C_0805_2012Metric | https://s.taobao.com/search?q=KEMET%20C0805C225K4RACTU%200805 | https://www.yageogroup.com/component-documentation/download/specsheet/C0805C225K4RACTU
C117 | 100n switch input loop | KEMET | C0603C104K5RACTU | 0603 | 1 | 背面 | SPECIFICATION_FROZEN_PREFERRED_BOM |  | 精度：10%；耐压：>=50V；介质：X7R | X100_Physical:Official_Capacitor_SMD_C_0603_1608Metric | https://s.taobao.com/search?q=KEMET%20C0603C104K5RACTU%200603 | https://www.yageogroup.com/component-documentation/download/specsheet/C0603C104K5RACTU
C118 | 10u switch input | KEMET | C1210C106K5RACTU | 1210 | 1 | 背面 | SPECIFICATION_FROZEN_PREFERRED_BOM |  | 精度：10%；耐压：>=50V；介质：X7R | X100_Physical:Official_Capacitor_SMD_C_1210_3225Metric | https://s.taobao.com/search?q=KEMET%20C1210C106K5RACTU%201210 | https://www.yageogroup.com/component-documentation/download/specsheet/C1210C106K5RACTU
C119 | 82u /16V PTC-before bulk | Panasonic | 16SVPF82M | OS-CON B6 diameter5 height5.9 | 1 | 正面 | EXACT_MPN_FROZEN |  |  | X100_Physical:Panasonic_OSCON_B6 | https://s.taobao.com/search?q=Panasonic%2016SVPF82M%20OS-CON%20B6%20diameter5%20height5.9 | https://industrial.panasonic.com/ww/products/pt/os-con/models/16SVPF82M
C120 | 1u EXT local | KEMET | C0805C105K4RACTU | 0805 | 1 | 背面 | SPECIFICATION_FROZEN_PREFERRED_BOM |  | 精度：10%；耐压：>=16V；介质：X7R | X100_Physical:Official_Capacitor_SMD_C_0805_2012Metric | https://s.taobao.com/search?q=KEMET%20C0805C105K4RACTU%200805 | https://www.yageogroup.com/component-documentation/download/specsheet/C0805C105K4RACTU
C121 | 180u /16V core mux hold-up (+ pin1) | Panasonic | 16SVPF180M | OS-CON C6 diameter6.3 height5.9 | 1 | 背面 | EXACT_MPN; REUSE_SELECTED_16SVPF180M; CANDIDATE_ARCHITECTURE_UNAPPROVED; NO_PURCHASE | DATASHEET_CAPACITANCE_ESR_SCREEN; STARTUP_AND_HOLDUP_NOT_QUALIFIED |  | X100_Physical:Panasonic_OSCON_C6 | https://s.taobao.com/search?q=Panasonic%2016SVPF180M%20OS-CON%20C6%20diameter6.3%20height5.9 | https://industrial.panasonic.com/ww/products/pt/os-con/models/16SVPF180M
C123 | 1u /16V shared input bypass | KEMET | C0805C105K4RACTU | 0805 | 1 | 背面 | VALUE_SPEC_CONTROLLED; preferred MPN; availability not checked | CANDIDATE_SHARED_DECOUPLING; PLACEMENT_REQUIRED; NO_BENCH_PASS | 精度：10%；耐压：>=16V；介质：X7R | X100_Physical:Official_Capacitor_SMD_C_0805_2012Metric | https://s.taobao.com/search?q=KEMET%20C0805C105K4RACTU%200805
C124 | 1u /16V | KEMET | C0805C105K4RACTU |  | 1 | 背面 | VALUE_SPEC_CONTROLLED; preferred MPN; availability not checked | CANDIDATE; native ERC checked; functional/current/DFM not complete |  | X100_Physical:Official_Capacitor_SMD_C_0805_2012Metric | https://s.taobao.com/search?q=KEMET%20C0805C105K4RACTU%20
C125 | 1u /16V mux VIN1 | KEMET | C0805C105K4RACTU | 0805 | 1 | 背面 | VALUE_SPEC_CONTROLLED; preferred MPN; availability not checked | CANDIDATE_SHARED_DECOUPLING; PLACEMENT_REQUIRED; NO_BENCH_PASS | 精度：10%；耐压：>=16V；介质：X7R | X100_Physical:Official_Capacitor_SMD_C_0805_2012Metric | https://s.taobao.com/search?q=KEMET%20C0805C105K4RACTU%200805
C126 | 1u /16V mux output | KEMET | C0805C105K4RACTU |  | 1 | 背面 | VALUE_SPEC_CONTROLLED; preferred MPN; availability not checked | CANDIDATE; native ERC checked; functional/current/DFM not complete |  | X100_Physical:Official_Capacitor_SMD_C_0805_2012Metric | https://s.taobao.com/search?q=KEMET%20C0805C105K4RACTU%20
C201 | 2.2u VCAP /16V | KEMET | C0805C225K4RACTU | 0805 | 1 | 正面 | SPECIFICATION_FROZEN_PREFERRED_BOM |  | 精度：10%；耐压：>=16V；介质：X7R | X100_Physical:Official_Capacitor_SMD_C_0805_2012Metric | https://s.taobao.com/search?q=KEMET%20C0805C225K4RACTU%200805 | https://www.yageogroup.com/component-documentation/download/specsheet/C0805C225K4RACTU
C202 | 2.2u VCAP /16V | KEMET | C0805C225K4RACTU | 0805 | 1 | 背面 | SPECIFICATION_FROZEN_PREFERRED_BOM |  | 精度：10%；耐压：>=16V；介质：X7R | X100_Physical:Official_Capacitor_SMD_C_0805_2012Metric | https://s.taobao.com/search?q=KEMET%20C0805C225K4RACTU%200805 | https://www.yageogroup.com/component-documentation/download/specsheet/C0805C225K4RACTU
C203 | 100n local VDD pin11 | KEMET | C0603C104K5RACTU | 0603 | 1 | 背面 | SPECIFICATION_FROZEN_PREFERRED_BOM |  | 精度：10%；耐压：>=50V；介质：X7R | X100_Physical:Official_Capacitor_SMD_C_0603_1608Metric | https://s.taobao.com/search?q=KEMET%20C0603C104K5RACTU%200603 | https://www.yageogroup.com/component-documentation/download/specsheet/C0603C104K5RACTU
C204 | 100n local VDD pin27 | KEMET | C0603C104K5RACTU | 0603 | 1 | 正面 | SPECIFICATION_FROZEN_PREFERRED_BOM |  | 精度：10%；耐压：>=50V；介质：X7R | X100_Physical:Official_Capacitor_SMD_C_0603_1608Metric | https://s.taobao.com/search?q=KEMET%20C0603C104K5RACTU%200603 | https://www.yageogroup.com/component-documentation/download/specsheet/C0603C104K5RACTU
C205 | 100n local VDD pin50 | KEMET | C0603C104K5RACTU | 0603 | 1 | 背面 | SPECIFICATION_FROZEN_PREFERRED_BOM |  | 精度：10%；耐压：>=50V；介质：X7R | X100_Physical:Official_Capacitor_SMD_C_0603_1608Metric | https://s.taobao.com/search?q=KEMET%20C0603C104K5RACTU%200603 | https://www.yageogroup.com/component-documentation/download/specsheet/C0603C104K5RACTU
C206 | 100n local VDD pin75 | KEMET | C0603C104K5RACTU | 0603 | 1 | 正面 | SPECIFICATION_FROZEN_PREFERRED_BOM |  | 精度：10%；耐压：>=50V；介质：X7R | X100_Physical:Official_Capacitor_SMD_C_0603_1608Metric | https://s.taobao.com/search?q=KEMET%20C0603C104K5RACTU%200603 | https://www.yageogroup.com/component-documentation/download/specsheet/C0603C104K5RACTU
C207 | 100n local VDD pin100 | KEMET | C0603C104K5RACTU | 0603 | 1 | 背面 | SPECIFICATION_FROZEN_PREFERRED_BOM |  | 精度：10%；耐压：>=50V；介质：X7R | X100_Physical:Official_Capacitor_SMD_C_0603_1608Metric | https://s.taobao.com/search?q=KEMET%20C0603C104K5RACTU%200603 | https://www.yageogroup.com/component-documentation/download/specsheet/C0603C104K5RACTU
C208 | 10u /50V MCU bulk >=4.7u effective | KEMET | C1210C106K5RACTU | 1210 | 1 | 背面 | SPECIFICATION_FROZEN_PREFERRED_BOM |  | 精度：10%；耐压：>=50V；介质：X7R | X100_Physical:Official_Capacitor_SMD_C_1210_3225Metric | https://s.taobao.com/search?q=KEMET%20C1210C106K5RACTU%201210 | https://www.yageogroup.com/component-documentation/download/specsheet/C1210C106K5RACTU
C209 | 2.2u VDDA | KEMET | C0805C225K4RACTU | 0805 | 1 | 正面 | SPECIFICATION_FROZEN_PREFERRED_BOM |  | 精度：10%；耐压：>=16V；介质：X7R | X100_Physical:Official_Capacitor_SMD_C_0805_2012Metric | https://s.taobao.com/search?q=KEMET%20C0805C225K4RACTU%200805 | https://www.yageogroup.com/component-documentation/download/specsheet/C0805C225K4RACTU
C210 | 100n VDDA pin21/VREF20 | KEMET | C0603C104K5RACTU | 0603 | 1 | 正面 | SPECIFICATION_FROZEN_PREFERRED_BOM |  | 精度：10%；耐压：>=50V；介质：X7R | X100_Physical:Official_Capacitor_SMD_C_0603_1608Metric | https://s.taobao.com/search?q=KEMET%20C0603C104K5RACTU%200603 | https://www.yageogroup.com/component-documentation/download/specsheet/C0603C104K5RACTU
C211 | 100n MCU VBAT pin6 | KEMET | C0603C104K5RACTU | 0603 | 1 | 背面 | SPECIFICATION_FROZEN_PREFERRED_BOM |  | 精度：10%；耐压：>=50V；介质：X7R | X100_Physical:Official_Capacitor_SMD_C_0603_1608Metric | https://s.taobao.com/search?q=KEMET%20C0603C104K5RACTU%200603 | https://www.yageogroup.com/component-documentation/download/specsheet/C0603C104K5RACTU
C212 | 100n reset | KEMET | C0805C104K5RACTU | 0805 | 1 | 背面 | SPECIFICATION_FROZEN_PREFERRED_BOM |  | 精度：10%；耐压：>=50V；介质：X7R | X100_Physical:Official_Capacitor_SMD_C_0805_2012Metric | https://s.taobao.com/search?q=KEMET%20C0805C104K5RACTU%200805 | https://www.yageogroup.com/component-documentation/download/specsheet/C0805C104K5RACTU
C213 | 33p C0G /0805 | YAGEO | CC0805JRNPO9BN330 | 0805 | 1 | 正面 | SPECIFICATION_FROZEN_PREFERRED_BOM |  | 精度：5%；耐压：>=50V；介质：C0G/NP0 | X100_Physical:Official_Capacitor_SMD_C_0805_2012Metric | https://s.taobao.com/search?q=YAGEO%20CC0805JRNPO9BN330%200805 | https://www.yageogroup.com/component-documentation/download/specsheet/CC0805JRNPO9BN330
C214 | 33p C0G /0805 | YAGEO | CC0805JRNPO9BN330 | 0805 | 1 | 正面 | SPECIFICATION_FROZEN_PREFERRED_BOM |  | 精度：5%；耐压：>=50V；介质：C0G/NP0 | X100_Physical:Official_Capacitor_SMD_C_0805_2012Metric | https://s.taobao.com/search?q=YAGEO%20CC0805JRNPO9BN330%200805 | https://www.yageogroup.com/component-documentation/download/specsheet/CC0805JRNPO9BN330
C301 | 100n VDD3 loop | KEMET | C0603C104K5RACTU | 0603 | 1 | 背面 | SPECIFICATION_FROZEN_PREFERRED_BOM |  | 精度：10%；耐压：>=50V；介质：X7R | X100_Physical:Official_Capacitor_SMD_C_0603_1608Metric | https://s.taobao.com/search?q=KEMET%20C0603C104K5RACTU%200603 | https://www.yageogroup.com/component-documentation/download/specsheet/C0603C104K5RACTU
C302 | 100n VDDIO11 loop | KEMET | C0603C104K5RACTU | 0603 | 1 | 正面 | SPECIFICATION_FROZEN_PREFERRED_BOM |  | 精度：10%；耐压：>=50V；介质：X7R | X100_Physical:Official_Capacitor_SMD_C_0603_1608Metric | https://s.taobao.com/search?q=KEMET%20C0603C104K5RACTU%200603 | https://www.yageogroup.com/component-documentation/download/specsheet/C0603C104K5RACTU
C303 | 100n SPL VDD8 | KEMET | C0603C104K5RACTU | 0603 | 1 | 正面 | SPECIFICATION_FROZEN_PREFERRED_BOM |  | 精度：10%；耐压：>=50V；介质：X7R | X100_Physical:Official_Capacitor_SMD_C_0603_1608Metric | https://s.taobao.com/search?q=KEMET%20C0603C104K5RACTU%200603 | https://www.yageogroup.com/component-documentation/download/specsheet/C0603C104K5RACTU
C304 | 100n SPL VDDIO6 | KEMET | C0603C104K5RACTU | 0603 | 1 | 正面 | SPECIFICATION_FROZEN_PREFERRED_BOM |  | 精度：10%；耐压：>=50V；介质：X7R | X100_Physical:Official_Capacitor_SMD_C_0603_1608Metric | https://s.taobao.com/search?q=KEMET%20C0603C104K5RACTU%200603 | https://www.yageogroup.com/component-documentation/download/specsheet/C0603C104K5RACTU
C401 | 100n clamp bypass only | KEMET | C0805C104K5RACTU | 0805 | 1 | 背面 | SPECIFICATION_FROZEN_PREFERRED_BOM |  | 精度：10%；耐压：>=50V；介质：X7R | X100_Physical:Official_Capacitor_SMD_C_0805_2012Metric | https://s.taobao.com/search?q=KEMET%20C0805C104K5RACTU%200805 | https://www.yageogroup.com/component-documentation/download/specsheet/C0805C104K5RACTU
C402 | 100n buffer VCC | KEMET | C0603C104K5RACTU | 0603 | 1 | 背面 | SPECIFICATION_FROZEN_PREFERRED_BOM |  | 精度：10%；耐压：>=50V；介质：X7R | X100_Physical:Official_Capacitor_SMD_C_0603_1608Metric | https://s.taobao.com/search?q=KEMET%20C0603C104K5RACTU%200603 | https://www.yageogroup.com/component-documentation/download/specsheet/C0603C104K5RACTU
C501 | 100n socket VDD loop | KEMET | C0603C104K5RACTU | 0603 | 1 | 背面 | SPECIFICATION_FROZEN_PREFERRED_BOM |  | 精度：10%；耐压：>=50V；介质：X7R | X100_Physical:Official_Capacitor_SMD_C_0603_1608Metric | https://s.taobao.com/search?q=KEMET%20C0603C104K5RACTU%200603 | https://www.yageogroup.com/component-documentation/download/specsheet/C0603C104K5RACTU
C502 | 10u /50V SD local | KEMET | C1210C106K5RACTU | 1210 | 1 | 背面 | SPECIFICATION_FROZEN_PREFERRED_BOM |  | 精度：10%；耐压：>=50V；介质：X7R | X100_Physical:Official_Capacitor_SMD_C_1210_3225Metric | https://s.taobao.com/search?q=KEMET%20C1210C106K5RACTU%201210 | https://www.yageogroup.com/component-documentation/download/specsheet/C1210C106K5RACTU
C601 | 100n VCC3 loop | KEMET | C0603C104K5RACTU | 0603 | 1 | 背面 | SPECIFICATION_FROZEN_PREFERRED_BOM |  | 精度：10%；耐压：>=50V；介质：X7R | X100_Physical:Official_Capacitor_SMD_C_0603_1608Metric | https://s.taobao.com/search?q=KEMET%20C0603C104K5RACTU%200603 | https://www.yageogroup.com/component-documentation/download/specsheet/C0603C104K5RACTU
C801 | 100n ADC LPF | KEMET | C0805C104K5RACTU | 0805 | 1 | 正面 | SPECIFICATION_FROZEN_PREFERRED_BOM |  | 精度：10%；耐压：>=50V；介质：X7R | X100_Physical:Official_Capacitor_SMD_C_0805_2012Metric | https://s.taobao.com/search?q=KEMET%20C0805C104K5RACTU%200805 | https://www.yageogroup.com/component-documentation/download/specsheet/C0805C104K5RACTU
C802 | 100n X7R 50V | KEMET | C0805C104K5RACTU | 0805 | 1 | 背面 | SPECIFICATION_FROZEN_PREFERRED_BOM |  | 精度：10%；耐压：>=50V；介质：X7R | X100_Physical:Official_Capacitor_SMD_C_0805_2012Metric | https://s.taobao.com/search?q=KEMET%20C0805C104K5RACTU%200805 | https://www.yageogroup.com/component-documentation/download/specsheet/C0805C104K5RACTU
C803 | 22n X7R 50V ADC reservoir | KEMET | C0805C223K5RACTU | 0805 | 1 | 正面 | SPECIFICATION_FROZEN_PREFERRED_BOM |  | 精度：10%；耐压：>=50V；介质：X7R | X100_Physical:Official_Capacitor_SMD_C_0805_2012Metric | https://s.taobao.com/search?q=KEMET%20C0805C223K5RACTU%200805 | https://www.yageogroup.com/component-documentation/download/specsheet/C0805C223K5RACTU
C804 | 22n X7R 50V ADC reservoir | KEMET | C0805C223K5RACTU | 0805 | 1 | 正面 | SPECIFICATION_FROZEN_PREFERRED_BOM |  | 精度：10%；耐压：>=50V；介质：X7R | X100_Physical:Official_Capacitor_SMD_C_0805_2012Metric | https://s.taobao.com/search?q=KEMET%20C0805C223K5RACTU%200805 | https://www.yageogroup.com/component-documentation/download/specsheet/C0805C223K5RACTU
C805 | 100n U801 VDD14 | KEMET | C0603C104K5RACTU | 0603 | 1 | 正面 | SPECIFICATION_FROZEN_PREFERRED_BOM |  | 精度：10%；耐压：>=50V；介质：X7R | X100_Physical:Official_Capacitor_SMD_C_0603_1608Metric | https://s.taobao.com/search?q=KEMET%20C0603C104K5RACTU%200603 | https://www.yageogroup.com/component-documentation/download/specsheet/C0603C104K5RACTU
D101 | 12V VGS clamp K=source | Nexperia | BZT52H-C12,115 | SOD123F | 1 | 背面 | EXACT_MPN_FROZEN |  |  | X100_Physical:Official_Diode_SMD_D_SOD-123F | https://s.taobao.com/search?q=Nexperia%20BZT52H-C12%2C115%20SOD123F | https://assets.nexperia.com/documents/data-sheet/BZT52H_SER.pdf
D102 | 26V bidirectional TVS | ST | SMBJ26CA-TR | SMB DO214AA | 1 | 正面 | EXACT_MPN_FROZEN |  |  | X100_Physical:Official_Diode_SMD_D_SMB | https://s.taobao.com/search?q=ST%20SMBJ26CA-TR%20SMB%20DO214AA | https://www.st.com/resource/en/datasheet/smbj26ca.pdf
D103 | STPS8H100G-TR | ST | STPS8H100G-TR | D2PAK A/K/tabK | 1 | 背面 | EXACT_MPN_FROZEN |  |  | X100_Physical:STPS8H100G_D2PAK_A_K_TabK_NoVIP | https://s.taobao.com/search?q=ST%20STPS8H100G-TR%20D2PAK%20A/K/tabK | https://www.st.com/resource/en/datasheet/stps8h100.pdf
D201 | GREEN; PB0 HIGH=ON | Lite-On | LTST-C170GKT | 0805 LED | 1 | 正面 | EXACT_MPN_FROZEN |  |  | X100_Physical:Official_LED_SMD_LED_0805_2012Metric | https://s.taobao.com/search?q=Lite-On%20LTST-C170GKT%200805%20LED | https://optoelectronics.liteon.com/upload/download/DS22-2000-003/LTST-C170GKT.pdf
D202 | GREEN; 3V3_MCU_PRESENT | Lite-On | LTST-C170GKT | 0805 LED | 1 | 正面 | EXACT_MPN_AUTHORIZED_PCB01F3; same LED as D201; not ordered |  |  | X100_Physical:Official_LED_SMD_LED_0805_2012Metric | https://s.taobao.com/search?q=Lite-On%20LTST-C170GKT%200805%20LED | https://optoelectronics.liteon.com/upload/download/DS22-2000-003/LTST-C170GKT.pdf
F101 | 3A /125V | Littelfuse | 0451003.MRL | NANO2 451 SMD | 1 | 正面 | EXACT_MPN_FROZEN |  |  | X100_Physical:Official_Fuse_Fuse_Littelfuse-NANO2-451_453 | https://s.taobao.com/search?q=Littelfuse%200451003.MRL%20NANO2%20451%20SMD | https://www.littelfuse.com/assetdocs/fuse-451-and-453-datasheet?assetguid=533cd5cc-956c-4243-867f-6ab5a62f6ba1
J401 | 124019772112A | Amphenol | 124019772112A | USB-C dual-row SMT / 4 plated SH slots | 1 | 正面 | EXACT_MPN_FROZEN | DESIGN_REVIEWED_BENCH_PENDING |  | X100_Physical:Official_USB_C_Amphenol_124019772112A | https://s.taobao.com/search | https://cdn.amphenol-cs.com/media/wysiwyg/files/drawing/c12401977-3.pdf
J501 | 1040310811 | Molex | 1040310811 | microSD SMT push-pull8+2detect | 1 | 正面 | EXACT_MPN_FROZEN |  |  | X100_Physical:Official_Connector_Card_microSD_HC_Molex_104031-0811 | https://s.taobao.com/search?q=Molex%201040310811%20microSD%20SMT%20push-pull8%2B2detect | https://www.molex.com/pdm_docs/sd/1040310811_sd.pdf
J601 | SM04B-GHS-TB(LF)(SN) | JST | SM04B-GHS-TB(LF)(SN) | GH1.25 4P side-entry SMT | 1 | 正面 | EXACT_MPN_FROZEN |  |  | X100_Physical:Official_Connector_JST_JST_GH_SM04B-GHS-TB_1x04-1MP_P1.25mm_Horizontal | https://s.taobao.com/search?q=JST%20SM04B-GHS-TB%28LF%29%28SN%29%20GH1.25%204P%20side-entry%20SMT | https://www.jst-mfg.com/product/pdf/eng/eGH.pdf
J701 | SM06B-GHS-TB(LF)(SN) | JST | SM06B-GHS-TB(LF)(SN) | GH1.25 6P side-entry SMT | 1 | 正面 | EXACT_MPN_FROZEN |  |  | X100_Physical:Official_Connector_JST_JST_GH_SM06B-GHS-TB_1x06-1MP_P1.25mm_Horizontal | https://s.taobao.com/search?q=JST%20SM06B-GHS-TB%28LF%29%28SN%29%20GH1.25%206P%20side-entry%20SMT | https://www.jst-mfg.com/product/pdf/eng/eGH.pdf
J702 | SM06B-GHS-TB(LF)(SN) | JST | SM06B-GHS-TB(LF)(SN) | GH1.25 6P side-entry SMT | 1 | 正面 | EXACT_MPN_FROZEN |  |  | X100_Physical:Official_Connector_JST_JST_GH_SM06B-GHS-TB_1x06-1MP_P1.25mm_Horizontal | https://s.taobao.com/search?q=JST%20SM06B-GHS-TB%28LF%29%28SN%29%20GH1.25%206P%20side-entry%20SMT | https://www.jst-mfg.com/product/pdf/eng/eGH.pdf
J703 | SM06B-GHS-TB(LF)(SN) | JST | SM06B-GHS-TB(LF)(SN) | GH1.25 6P side-entry SMT | 1 | 正面 | EXACT_MPN_FROZEN |  |  | X100_Physical:Official_Connector_JST_JST_GH_SM06B-GHS-TB_1x06-1MP_P1.25mm_Horizontal | https://s.taobao.com/search?q=JST%20SM06B-GHS-TB%28LF%29%28SN%29%20GH1.25%206P%20side-entry%20SMT | https://www.jst-mfg.com/product/pdf/eng/eGH.pdf
J704 | SM04B-GHS-TB(LF)(SN) | JST | SM04B-GHS-TB(LF)(SN) | GH1.25 4P side-entry SMT | 1 | 正面 | EXACT_MPN_FROZEN |  |  | X100_Physical:Official_Connector_JST_JST_GH_SM04B-GHS-TB_1x04-1MP_P1.25mm_Horizontal | https://s.taobao.com/search?q=JST%20SM04B-GHS-TB%28LF%29%28SN%29%20GH1.25%204P%20side-entry%20SMT | https://www.jst-mfg.com/product/pdf/eng/eGH.pdf
J801 | OUT1 /GND | Samtec | TSW-102-07-G-S | 1x2 2.54 THT top insertion | 1 | 正面 | EXACT_MPN_FROZEN |  |  | X100_Physical:Samtec_TSW10207GS_1x2_P2p54 | https://s.taobao.com/search?q=Samtec%20TSW-102-07-G-S%201x2%202.54%20THT%20top%20insertion | https://www.samtec.com/products/tsw-102-07-g-s
J802 | OUT2 /GND | Samtec | TSW-102-07-G-S | 1x2 2.54 THT top insertion | 1 | 正面 | EXACT_MPN_FROZEN |  |  | X100_Physical:Samtec_TSW10207GS_1x2_P2p54 | https://s.taobao.com/search?q=Samtec%20TSW-102-07-G-S%201x2%202.54%20THT%20top%20insertion | https://www.samtec.com/products/tsw-102-07-g-s
J803 | OUT3 /GND | Samtec | TSW-102-07-G-S | 1x2 2.54 THT top insertion | 1 | 正面 | EXACT_MPN_FROZEN |  |  | X100_Physical:Samtec_TSW10207GS_1x2_P2p54 | https://s.taobao.com/search?q=Samtec%20TSW-102-07-G-S%201x2%202.54%20THT%20top%20insertion | https://www.samtec.com/products/tsw-102-07-g-s
J804 | OUT4 /GND | Samtec | TSW-102-07-G-S | 1x2 2.54 THT top insertion | 1 | 正面 | EXACT_MPN_FROZEN |  |  | X100_Physical:Samtec_TSW10207GS_1x2_P2p54 | https://s.taobao.com/search?q=Samtec%20TSW-102-07-G-S%201x2%202.54%20THT%20top%20insertion | https://www.samtec.com/products/tsw-102-07-g-s
J805 | OUT5 /GND | Samtec | TSW-102-07-G-S | 1x2 2.54 THT top insertion | 1 | 正面 | EXACT_MPN_FROZEN |  |  | X100_Physical:Samtec_TSW10207GS_1x2_P2p54 | https://s.taobao.com/search?q=Samtec%20TSW-102-07-G-S%201x2%202.54%20THT%20top%20insertion | https://www.samtec.com/products/tsw-102-07-g-s
J806 | OUT6 /GND | Samtec | TSW-102-07-G-S | 1x2 2.54 THT top insertion | 1 | 正面 | EXACT_MPN_FROZEN |  |  | X100_Physical:Samtec_TSW10207GS_1x2_P2p54 | https://s.taobao.com/search?q=Samtec%20TSW-102-07-G-S%201x2%202.54%20THT%20top%20insertion | https://www.samtec.com/products/tsw-102-07-g-s
J807 | SWD:1REF2GND3IO4CLK5NRST | Samtec | TSW-105-07-G-S | 1x5 2.54 THT top insertion | 1 | 正面 | EXACT_MPN_FROZEN |  |  | X100_Physical:Samtec_TSW10507GS_1x5_P2p54 | https://s.taobao.com/search?q=Samtec%20TSW-105-07-G-S%201x5%202.54%20THT%20top%20insertion | https://www.samtec.com/products/tsw-105-07-g-s
J809 | CURRENT monitor only | JST | SM06B-GHS-TB(LF)(SN) | GH1.25 6P side-entry SMT | 1 | 正面 | EXACT_MPN_FROZEN |  |  | X100_Physical:Official_Connector_JST_JST_GH_SM06B-GHS-TB_1x06-1MP_P1.25mm_Horizontal | https://s.taobao.com/search?q=JST%20SM06B-GHS-TB%28LF%29%28SN%29%20GH1.25%206P%20side-entry%20SMT | https://www.jst-mfg.com/product/pdf/eng/eGH.pdf
L101 | 10uH | Bourns | SRP1038A-100M | Lead-frame SMD; case max11.5x10.3x4.0mm | 1 | 背面 | EXACT_MPN_FROZEN; USER_APPROVED_20261023; NO_PURCHASE | DATASHEET_AND_LAYOUT_VERIFIED; POWER_REVIEW_OPEN; NO_BENCH_PASS |  | X100_Physical:Bourns_SRP1038A_LeadFrame_NoVIP | https://s.taobao.com/search | https://www.bourns.com/docs/product-datasheets/srp1038a.pdf
L102 | 4.7uH design-calculated at 5V | Bourns | SRN6045-4R7Y | 6x6x4.5 SMD visible end terminals | 1 | 背面 | EXACT_MPN_FROZEN |  |  | X100_Physical:Bourns_SRN6045 | https://s.taobao.com/search?q=Bourns%20SRN6045-4R7Y%206x6x4.5%20SMD%20visible%20end%20terminals | https://www.bourns.com/docs/product-datasheets/srn6045.pdf
Q101 | DMP6023LSS-13 | Diodes | DMP6023LSS-13 | SO8 | 1 | 背面 | EXACT_MPN_FROZEN |  |  | X100_Physical:Official_Package_SO_SOIC-8_3.9x4.9mm_P1.27mm | https://s.taobao.com/search?q=Diodes%20DMP6023LSS-13%20SO8 | https://www.diodes.com/assets/Datasheets/DMP6023LSS.pdf
R101 | 20k | YAGEO | RC0805FR-0720KL | 0805 | 1 | 背面 | SPECIFICATION_FROZEN_PREFERRED_BOM |  | 精度：1%; TCR<=100ppm/C；耐压：>=100V；功率：>=0.125W | X100_Physical:Official_Resistor_SMD_R_0805_2012Metric | https://s.taobao.com/search?q=YAGEO%20RC0805FR-0720KL%200805 | https://www.yageogroup.com/component-documentation/download/specsheet/RC0805FR-0720KL
R102 | 294k | YAGEO | RC0805FR-07294KL | 0805 | 1 | 背面 | SPECIFICATION_FROZEN_PREFERRED_BOM |  | 精度：1%; TCR<=100ppm/C；耐压：>=100V；功率：>=0.125W | X100_Physical:Official_Resistor_SMD_R_0805_2012Metric | https://s.taobao.com/search?q=YAGEO%20RC0805FR-07294KL%200805 | https://www.yageogroup.com/component-documentation/download/specsheet/RC0805FR-07294KL
R103 | 54.9k | YAGEO | RC0805FR-0754K9L | 0805 | 1 | 背面 | SPECIFICATION_FROZEN_PREFERRED_BOM |  | 精度：1%; TCR<=100ppm/C；耐压：>=100V；功率：>=0.125W | X100_Physical:Official_Resistor_SMD_R_0805_2012Metric | https://s.taobao.com/search?q=YAGEO%20RC0805FR-0754K9L%200805 | https://www.yageogroup.com/component-documentation/download/specsheet/RC0805FR-0754K9L
R104 | 200k | YAGEO | RC0805FR-07200KL | 0805 | 1 | 背面 | SPECIFICATION_FROZEN_PREFERRED_BOM |  | 精度：1%; TCR<=100ppm/C；耐压：>=100V；功率：>=0.125W | X100_Physical:Official_Resistor_SMD_R_0805_2012Metric | https://s.taobao.com/search?q=YAGEO%20RC0805FR-07200KL%200805 | https://www.yageogroup.com/component-documentation/download/specsheet/RC0805FR-07200KL
R105 | 53.6k 0.1% | YAGEO | RT0805BRD0753K6L | 0805 | 1 | 背面 | CANDIDATE_ONLY; DOMESTIC_SOURCE_NOT_VERIFIED; NO_PURCHASE | HUMAN_APPROVED_CANDIDATE_ONLY; 5Vsetpointpaperreviewpending; notfinalselected | 精度：0.1%; TCR<=25ppm/C；耐压：>=100V；功率：>=0.125W | X100_Physical:Official_Resistor_SMD_R_0805_2012Metric | https://s.taobao.com/search?q=YAGEO%20RT0805BRD0753K6L%200805 | https://www.yageogroup.com/component-documentation/download/specsheet/RT0805BRD0753K6L
R106 | 10k 0.1% | YAGEO | RT0805BRD0710KL | 0805 | 1 | 背面 | SPECIFICATION_FROZEN_PREFERRED_BOM |  | 精度：0.1%; TCR<=25ppm/C；耐压：>=100V；功率：>=0.125W | X100_Physical:Official_Resistor_SMD_R_0805_2012Metric | https://s.taobao.com/search?q=YAGEO%20RT0805BRD0710KL%200805 | https://www.yageogroup.com/component-documentation/download/specsheet/RT0805BRD0710KL
R107 | 18.7k | YAGEO | RC0805FR-0718K7L | 0805 | 1 | 背面 | SPECIFICATION_FROZEN_PREFERRED_BOM |  | 精度：1%; TCR<=100ppm/C；耐压：>=100V；功率：>=0.125W | X100_Physical:Official_Resistor_SMD_R_0805_2012Metric | https://s.taobao.com/search?q=YAGEO%20RC0805FR-0718K7L%200805 | https://www.yageogroup.com/component-documentation/download/specsheet/RC0805FR-0718K7L
R108 | 10R RC sensor filter | YAGEO | RC0805FR-0710RL | 0805 | 1 | 背面 | SPECIFICATION_FROZEN_PREFERRED_BOM |  | 精度：1%; TCR<=100ppm/C；耐压：>=100V；功率：>=0.125W | X100_Physical:Official_Resistor_SMD_R_0805_2012Metric | https://s.taobao.com/search?q=YAGEO%20RC0805FR-0710RL%200805 | https://www.yageogroup.com/component-documentation/download/specsheet/RC0805FR-0710RL
R109 | 22.1k limit | YAGEO | RC0805FR-0722K1L | 0805 | 1 | 背面 | SPECIFICATION_FROZEN_PREFERRED_BOM |  | 精度：1%; TCR<=100ppm/C；耐压：>=100V；功率：>=0.125W | X100_Physical:Official_Resistor_SMD_R_0805_2012Metric | https://s.taobao.com/search?q=YAGEO%20RC0805FR-0722K1L%200805 | https://www.yageogroup.com/component-documentation/download/specsheet/RC0805FR-0722K1L
R110 | 10k FAULT pullup | YAGEO | RC0805FR-0710KL | 0805 | 1 | 背面 | SPECIFICATION_FROZEN_PREFERRED_BOM |  | 精度：1%; TCR<=100ppm/C；耐压：>=100V；功率：>=0.125W | X100_Physical:Official_Resistor_SMD_R_0805_2012Metric | https://s.taobao.com/search?q=YAGEO%20RC0805FR-0710KL%200805 | https://www.yageogroup.com/component-documentation/download/specsheet/RC0805FR-0710KL
R111 | 33.2k 0.1% | Yageo | RT0805BRD0733K2L |  | 1 | 背面 | VALUE_SPEC_CONTROLLED; preferred MPN; availability not checked | CANDIDATE; native ERC checked; functional/current/DFM not complete |  | X100_Physical:Official_Resistor_SMD_R_0805_2012Metric | https://s.taobao.com/search?q=Yageo%20RT0805BRD0733K2L%20
R112 | 10k 0.1% | Yageo | RT0805BRD0710KL |  | 1 | 背面 | VALUE_SPEC_CONTROLLED; preferred MPN; availability not checked | CANDIDATE; native ERC checked; functional/current/DFM not complete |  | X100_Physical:Official_Resistor_SMD_R_0805_2012Metric | https://s.taobao.com/search?q=Yageo%20RT0805BRD0710KL%20
R113 | 49.9k 0.1% | YAGEO | RT0805BRD0749K9L |  | 1 | 背面 | VALUE_SPEC_CONTROLLED; preferred MPN; availability not checked | USER_APPROVED_SINGLE_LIMIT; conservative design envelope 473-584mA; first-board measurement pending |  | X100_Physical:Official_Resistor_SMD_R_0805_2012Metric | https://s.taobao.com/search?q=YAGEO%20RT0805BRD0749K9L%20 | https://yageogroup.com/component-documentation/download/specsheet/RT0805BRD0749K9L
R114 | 10k ST pull-up | Yageo | RC0805FR-0710KL |  | 1 | 背面 | VALUE_SPEC_CONTROLLED; preferred MPN; availability not checked | CANDIDATE; native ERC checked; functional/current/DFM not complete |  | X100_Physical:Official_Resistor_SMD_R_0805_2012Metric | https://s.taobao.com/search?q=Yageo%20RC0805FR-0710KL%20
R201 | 10R VDDA filter | YAGEO | RC0805FR-0710RL | 0805 | 1 | 正面 | SPECIFICATION_FROZEN_PREFERRED_BOM |  | 精度：1%; TCR<=100ppm/C；耐压：>=100V；功率：>=0.125W | X100_Physical:Official_Resistor_SMD_R_0805_2012Metric | https://s.taobao.com/search?q=YAGEO%20RC0805FR-0710RL%200805 | https://www.yageogroup.com/component-documentation/download/specsheet/RC0805FR-0710RL
R203 | 10k reset pullup | YAGEO | RC0805FR-0710KL | 0805 | 1 | 背面 | SPECIFICATION_FROZEN_PREFERRED_BOM |  | 精度：1%; TCR<=100ppm/C；耐压：>=100V；功率：>=0.125W | X100_Physical:Official_Resistor_SMD_R_0805_2012Metric | https://s.taobao.com/search?q=YAGEO%20RC0805FR-0710KL%200805 | https://www.yageogroup.com/component-documentation/download/specsheet/RC0805FR-0710KL
R204 | 10k BOOT0 default LOW | YAGEO | RC0805FR-0710KL | 0805 | 1 | 背面 | SPECIFICATION_FROZEN_PREFERRED_BOM |  | 精度：1%; TCR<=100ppm/C；耐压：>=100V；功率：>=0.125W | X100_Physical:Official_Resistor_SMD_R_0805_2012Metric | https://s.taobao.com/search?q=YAGEO%20RC0805FR-0710KL%200805 | https://www.yageogroup.com/component-documentation/download/specsheet/RC0805FR-0710KL
R205 | 120R HSE series | YAGEO | RC0805FR-07120RL | 0805 | 1 | 正面 | SPECIFICATION_FROZEN_PREFERRED_BOM |  | 精度：1%; TCR<=100ppm/C；耐压：>=100V；功率：>=0.125W | X100_Physical:Official_Resistor_SMD_R_0805_2012Metric | https://s.taobao.com/search?q=YAGEO%20RC0805FR-07120RL%200805 | https://www.yageogroup.com/component-documentation/download/specsheet/RC0805FR-07120RL
R206 | 1k LED current | YAGEO | RC0805FR-071KL | 0805 | 1 | 正面 | SPECIFICATION_FROZEN_PREFERRED_BOM |  | 精度：1%; TCR<=100ppm/C；耐压：>=100V；功率：>=0.125W | X100_Physical:Official_Resistor_SMD_R_0805_2012Metric | https://s.taobao.com/search?q=YAGEO%20RC0805FR-071KL%200805 | https://www.yageogroup.com/component-documentation/download/specsheet/RC0805FR-071KL
R207 | 1.2k PWR current | YAGEO | RC0805FR-071K2L | 0805 | 1 | 正面 | SPECIFICATION_FROZEN_PREFERRED_BOM; PCB01F3 prototype 1.2k authorized |  | 精度：1%; TCR<=100ppm/C；耐压：>=100V；功率：>=0.125W | X100_Physical:Official_Resistor_SMD_R_0805_2012Metric | https://s.taobao.com/search?q=YAGEO%20RC0805FR-071K2L%200805 | https://www.yageogroup.com/component-documentation/download/specsheet/RC0805FR-071K2L
R301 | 10k CS1 safe HIGH | YAGEO | RC0805FR-0710KL | 0805 | 1 | 背面 | SPECIFICATION_FROZEN_PREFERRED_BOM |  | 精度：1%; TCR<=100ppm/C；耐压：>=100V；功率：>=0.125W | X100_Physical:Official_Resistor_SMD_R_0805_2012Metric | https://s.taobao.com/search?q=YAGEO%20RC0805FR-0710KL%200805 | https://www.yageogroup.com/component-documentation/download/specsheet/RC0805FR-0710KL
R302 | 10k CS2 safe HIGH | YAGEO | RC0805FR-0710KL | 0805 | 1 | 背面 | SPECIFICATION_FROZEN_PREFERRED_BOM |  | 精度：1%; TCR<=100ppm/C；耐压：>=100V；功率：>=0.125W | X100_Physical:Official_Resistor_SMD_R_0805_2012Metric | https://s.taobao.com/search?q=YAGEO%20RC0805FR-0710KL%200805 | https://www.yageogroup.com/component-documentation/download/specsheet/RC0805FR-0710KL
R303 | 4.7k internal SCL pullup | YAGEO | RC0805FR-074K7L | 0805 | 1 | 正面 | SPECIFICATION_FROZEN_PREFERRED_BOM |  | 精度：1%; TCR<=100ppm/C；耐压：>=100V；功率：>=0.125W | X100_Physical:Official_Resistor_SMD_R_0805_2012Metric | https://s.taobao.com/search?q=YAGEO%20RC0805FR-074K7L%200805 | https://www.yageogroup.com/component-documentation/download/specsheet/RC0805FR-074K7L
R304 | 4.7k internal SDA pullup | YAGEO | RC0805FR-074K7L | 0805 | 1 | 正面 | SPECIFICATION_FROZEN_PREFERRED_BOM |  | 精度：1%; TCR<=100ppm/C；耐压：>=100V；功率：>=0.125W | X100_Physical:Official_Resistor_SMD_R_0805_2012Metric | https://s.taobao.com/search?q=YAGEO%20RC0805FR-074K7L%200805 | https://www.yageogroup.com/component-documentation/download/specsheet/RC0805FR-074K7L
R401 | 5.1k CC1 Rd | YAGEO | RC0805FR-075K1L | 0805 | 1 | 背面 | SPECIFICATION_FROZEN_PREFERRED_BOM |  | 精度：1%; TCR<=100ppm/C；耐压：>=100V；功率：>=0.125W | X100_Physical:Official_Resistor_SMD_R_0805_2012Metric | https://s.taobao.com/search?q=YAGEO%20RC0805FR-075K1L%200805 | https://www.yageogroup.com/component-documentation/download/specsheet/RC0805FR-075K1L
R402 | 5.1k CC2 Rd | YAGEO | RC0805FR-075K1L | 0805 | 1 | 背面 | SPECIFICATION_FROZEN_PREFERRED_BOM |  | 精度：1%; TCR<=100ppm/C；耐压：>=100V；功率：>=0.125W | X100_Physical:Official_Resistor_SMD_R_0805_2012Metric | https://s.taobao.com/search?q=YAGEO%20RC0805FR-075K1L%200805 | https://www.yageogroup.com/component-documentation/download/specsheet/RC0805FR-075K1L
R403 | 10k detection input | YAGEO | RC0805FR-0710KL | 0805 | 1 | 背面 | SPECIFICATION_FROZEN_PREFERRED_BOM |  | 精度：1%; TCR<=100ppm/C；耐压：>=100V；功率：>=0.125W | X100_Physical:Official_Resistor_SMD_R_0805_2012Metric | https://s.taobao.com/search?q=YAGEO%20RC0805FR-0710KL%200805 | https://www.yageogroup.com/component-documentation/download/specsheet/RC0805FR-0710KL
R404 | 100k unplug LOW | YAGEO | RC0805FR-07100KL | 0805 | 1 | 背面 | SPECIFICATION_FROZEN_PREFERRED_BOM |  | 精度：1%; TCR<=100ppm/C；耐压：>=100V；功率：>=0.125W | X100_Physical:Official_Resistor_SMD_R_0805_2012Metric | https://s.taobao.com/search?q=YAGEO%20RC0805FR-07100KL%200805 | https://www.yageogroup.com/component-documentation/download/specsheet/RC0805FR-07100KL
R501 | 0R SD service isolation | YAGEO | RC0805JR-070RL | 0805 | 1 | 背面 | SPECIFICATION_FROZEN_PREFERRED_BOM |  | 精度：jumper；耐压：>=100V；功率：>=0.125W | X100_Physical:Official_Resistor_SMD_R_0805_2012Metric | https://s.taobao.com/search?q=YAGEO%20RC0805JR-070RL%200805 | https://www.yageogroup.com/component-documentation/download/specsheet/RC0805JR-070RL
R502 | 47k SD pullup | YAGEO | RC0805FR-0747KL | 0805 | 1 | 背面 | SPECIFICATION_FROZEN_PREFERRED_BOM |  | 精度：1%; TCR<=100ppm/C；耐压：>=100V；功率：>=0.125W | X100_Physical:Official_Resistor_SMD_R_0805_2012Metric | https://s.taobao.com/search?q=YAGEO%20RC0805FR-0747KL%200805 | https://www.yageogroup.com/component-documentation/download/specsheet/RC0805FR-0747KL
R503 | 47k SD pullup | YAGEO | RC0805FR-0747KL | 0805 | 1 | 背面 | SPECIFICATION_FROZEN_PREFERRED_BOM |  | 精度：1%; TCR<=100ppm/C；耐压：>=100V；功率：>=0.125W | X100_Physical:Official_Resistor_SMD_R_0805_2012Metric | https://s.taobao.com/search?q=YAGEO%20RC0805FR-0747KL%200805 | https://www.yageogroup.com/component-documentation/download/specsheet/RC0805FR-0747KL
R504 | 47k SD pullup | YAGEO | RC0805FR-0747KL | 0805 | 1 | 背面 | SPECIFICATION_FROZEN_PREFERRED_BOM |  | 精度：1%; TCR<=100ppm/C；耐压：>=100V；功率：>=0.125W | X100_Physical:Official_Resistor_SMD_R_0805_2012Metric | https://s.taobao.com/search?q=YAGEO%20RC0805FR-0747KL%200805 | https://www.yageogroup.com/component-documentation/download/specsheet/RC0805FR-0747KL
R505 | 47k SD pullup | YAGEO | RC0805FR-0747KL | 0805 | 1 | 背面 | SPECIFICATION_FROZEN_PREFERRED_BOM |  | 精度：1%; TCR<=100ppm/C；耐压：>=100V；功率：>=0.125W | X100_Physical:Official_Resistor_SMD_R_0805_2012Metric | https://s.taobao.com/search?q=YAGEO%20RC0805FR-0747KL%200805 | https://www.yageogroup.com/component-documentation/download/specsheet/RC0805FR-0747KL
R506 | 47k SD pullup | YAGEO | RC0805FR-0747KL | 0805 | 1 | 背面 | SPECIFICATION_FROZEN_PREFERRED_BOM |  | 精度：1%; TCR<=100ppm/C；耐压：>=100V；功率：>=0.125W | X100_Physical:Official_Resistor_SMD_R_0805_2012Metric | https://s.taobao.com/search?q=YAGEO%20RC0805FR-0747KL%200805 | https://www.yageogroup.com/component-documentation/download/specsheet/RC0805FR-0747KL
R602 | 120R end termination | YAGEO | RC0805FR-07120RL | 0805 | 1 | 背面 | SPECIFICATION_FROZEN_PREFERRED_BOM |  | 精度：1%; TCR<=100ppm/C；耐压：>=100V；功率：>=0.125W | X100_Physical:Official_Resistor_SMD_R_0805_2012Metric | https://s.taobao.com/search?q=YAGEO%20RC0805FR-07120RL%200805 | https://www.yageogroup.com/component-documentation/download/specsheet/RC0805FR-07120RL
R603 | 10k TXD default recessive | YAGEO | RC0805FR-0710KL | 0805 | 1 | 背面 | SPECIFICATION_FROZEN_PREFERRED_BOM |  | 精度：1%; TCR<=100ppm/C；耐压：>=100V；功率：>=0.125W | X100_Physical:Official_Resistor_SMD_R_0805_2012Metric | https://s.taobao.com/search?q=YAGEO%20RC0805FR-0710KL%200805 | https://www.yageogroup.com/component-documentation/download/specsheet/RC0805FR-0710KL
R604 | 10k | YAGEO | RC0805FR-0710KL | 0805 | 1 | 背面 | SPECIFICATION_FROZEN_PREFERRED_BOM |  | 精度：1%; TCR<=100ppm/C；耐压：>=100V；功率：>=0.125W | X100_Physical:Official_Resistor_SMD_R_0805_2012Metric | https://s.taobao.com/search?q=YAGEO%20RC0805FR-0710KL%200805 | https://www.yageogroup.com/component-documentation/download/specsheet/RC0805FR-0710KL
R701 | 4.7k externalSCL pullup | YAGEO | RC0805FR-074K7L | 0805 | 1 | 背面 | SPECIFICATION_FROZEN_PREFERRED_BOM |  | 精度：1%; TCR<=100ppm/C；耐压：>=100V；功率：>=0.125W | X100_Physical:Official_Resistor_SMD_R_0805_2012Metric | https://s.taobao.com/search?q=YAGEO%20RC0805FR-074K7L%200805 | https://www.yageogroup.com/component-documentation/download/specsheet/RC0805FR-074K7L
R702 | 4.7k externalSDA pullup | YAGEO | RC0805FR-074K7L | 0805 | 1 | 背面 | SPECIFICATION_FROZEN_PREFERRED_BOM |  | 精度：1%; TCR<=100ppm/C；耐压：>=100V；功率：>=0.125W | X100_Physical:Official_Resistor_SMD_R_0805_2012Metric | https://s.taobao.com/search?q=YAGEO%20RC0805FR-074K7L%200805 | https://www.yageogroup.com/component-documentation/download/specsheet/RC0805FR-074K7L
R801 | 150k 0.1% | YAGEO | RT0805BRD07150KL | 0805 | 1 | 正面 | SPECIFICATION_FROZEN_PREFERRED_BOM |  | 精度：0.1%; TCR<=25ppm/C；耐压：>=100V；功率：>=0.125W | X100_Physical:Official_Resistor_SMD_R_0805_2012Metric | https://s.taobao.com/search?q=YAGEO%20RT0805BRD07150KL%200805 | https://www.yageogroup.com/component-documentation/download/specsheet/RT0805BRD07150KL
R802 | 10k 0.1% scale16 | YAGEO | RT0805BRD0710KL | 0805 | 1 | 正面 | SPECIFICATION_FROZEN_PREFERRED_BOM |  | 精度：0.1%; TCR<=25ppm/C；耐压：>=100V；功率：>=0.125W | X100_Physical:Official_Resistor_SMD_R_0805_2012Metric | https://s.taobao.com/search?q=YAGEO%20RT0805BRD0710KL%200805 | https://www.yageogroup.com/component-documentation/download/specsheet/RT0805BRD0710KL
R803 | 1k ADC series | YAGEO | RC0805FR-071KL | 0805 | 1 | 正面 | SPECIFICATION_FROZEN_PREFERRED_BOM |  | 精度：1%; TCR<=100ppm/C；耐压：>=100V；功率：>=0.125W | X100_Physical:Official_Resistor_SMD_R_0805_2012Metric | https://s.taobao.com/search?q=YAGEO%20RC0805FR-071KL%200805 | https://www.yageogroup.com/component-documentation/download/specsheet/RC0805FR-071KL
R804 | 1k isolate ADC reservoir | YAGEO | RC0805FR-071KL | 0805 | 1 | 正面 | SPECIFICATION_FROZEN_PREFERRED_BOM |  | 精度：1%; TCR<=100ppm/C；耐压：>=100V；功率：>=0.125W | X100_Physical:Official_Resistor_SMD_R_0805_2012Metric | https://s.taobao.com/search?q=YAGEO%20RC0805FR-071KL%200805 | https://www.yageogroup.com/component-documentation/download/specsheet/RC0805FR-071KL
R805 | 22.1k 1% >=100V | YAGEO | RC0805FR-0722K1L | 0805 | 1 | 正面 | SPECIFICATION_FROZEN_PREFERRED_BOM |  | 精度：1%; TCR<=100ppm/C；耐压：>=100V；功率：>=0.125W | X100_Physical:Official_Resistor_SMD_R_0805_2012Metric | https://s.taobao.com/search?q=YAGEO%20RC0805FR-0722K1L%200805 | https://www.yageogroup.com/component-documentation/download/specsheet/RC0805FR-0722K1L
R806 | 20k 1% scale20/42.1 | YAGEO | RC0805FR-0720KL | 0805 | 1 | 正面 | SPECIFICATION_FROZEN_PREFERRED_BOM |  | 精度：1%; TCR<=100ppm/C；耐压：>=100V；功率：>=0.125W | X100_Physical:Official_Resistor_SMD_R_0805_2012Metric | https://s.taobao.com/search?q=YAGEO%20RC0805FR-0720KL%200805 | https://www.yageogroup.com/component-documentation/download/specsheet/RC0805FR-0720KL
R807 | 1k current limit | YAGEO | RC0805FR-071KL | 0805 | 1 | 背面 | SPECIFICATION_FROZEN_PREFERRED_BOM |  | 精度：1%; TCR<=100ppm/C；耐压：>=100V；功率：>=0.125W | X100_Physical:Official_Resistor_SMD_R_0805_2012Metric | https://s.taobao.com/search?q=YAGEO%20RC0805FR-071KL%200805 | https://www.yageogroup.com/component-documentation/download/specsheet/RC0805FR-071KL
R808 | 1k isolate ADC reservoir | YAGEO | RC0805FR-071KL | 0805 | 1 | 正面 | SPECIFICATION_FROZEN_PREFERRED_BOM |  | 精度：1%; TCR<=100ppm/C；耐压：>=100V；功率：>=0.125W | X100_Physical:Official_Resistor_SMD_R_0805_2012Metric | https://s.taobao.com/search?q=YAGEO%20RC0805FR-071KL%200805 | https://www.yageogroup.com/component-documentation/download/specsheet/RC0805FR-071KL
R809 | 1.3M 1% discharge/IOFF bound | YAGEO | RC0805FR-071M3L | 0805 | 1 | 正面 | SPECIFICATION_FROZEN_PREFERRED_BOM |  | 精度：1%; TCR<=100ppm/C；耐压：>=100V；功率：>=0.125W | X100_Physical:Official_Resistor_SMD_R_0805_2012Metric | https://s.taobao.com/search?q=YAGEO%20RC0805FR-071M3L%200805 | preferred BOM only; specification controls
R810 | 1.3M 1% discharge/IOFF bound | YAGEO | RC0805FR-071M3L | 0805 | 1 | 正面 | SPECIFICATION_FROZEN_PREFERRED_BOM |  | 精度：1%; TCR<=100ppm/C；耐压：>=100V；功率：>=0.125W | X100_Physical:Official_Resistor_SMD_R_0805_2012Metric | https://s.taobao.com/search?q=YAGEO%20RC0805FR-071M3L%200805 | preferred BOM only; specification controls
R811 | 10k rail discharge; off bound 81.6mV | Yageo | RC0805FR-0710KL | 0805 | 1 | 背面 | SPECIFICATION_FROZEN_PREFERRED_BOM | CANDIDATE: Ioff 8uA x Rmax 10.2k = 81.6mV; no physical test | 精度：1%; TCR<=100ppm/C；耐压：>=100V；功率：>=0.125W | X100_Physical:Official_Resistor_SMD_R_0805_2012Metric | https://s.taobao.com/search?q=Yageo%20RC0805FR-0710KL%200805 | https://www.yageogroup.com/component-documentation/download/specsheet/RC0805FR-071KL
U101 | TPS54360BDDAR | TI | TPS54360BDDAR | DDA0008B HSOIC8 EP | 1 | 背面 | EXACT_MPN_FROZEN |  |  | X100_Physical:TPS54360B_DDA0008B_NoVIP | https://s.taobao.com/search?q=TI%20TPS54360BDDAR%20DDA0008B%20HSOIC8%20EP | https://www.ti.com/lit/ds/symlink/tps54360b.pdf
U102 | AP63203WU-7 | Diodes | AP63203WU-7 | TSOT26 | 1 | 背面 | EXACT_MPN_FROZEN |  |  | X100_Physical:Official_Package_TO_SOT_SMD_TSOT-23-6 | https://s.taobao.com/search?q=Diodes%20AP63203WU-7%20TSOT26 | https://www.diodes.com/assets/Datasheets/AP63200-AP63201-AP63203-AP63205.pdf
U103 | TPS7A2033PDBVR | TI | TPS7A2033PDBVR | DBV5 SOT23-5 | 1 | 正面 | EXACT_MPN_FROZEN |  |  | X100_Physical:Official_Package_TO_SOT_SMD_SOT-23-5 | https://s.taobao.com/search?q=TI%20TPS7A2033PDBVR%20DBV5%20SOT23-5 | https://www.ti.com/lit/ds/symlink/tps7a20.pdf
U104 | TPS2553DBVR | TI | TPS2553DBVR | DBV6 SOT23-6 | 1 | 背面 | EXACT_MPN_FROZEN |  |  | X100_Physical:Official_Package_TO_SOT_SMD_SOT-23-6 | https://s.taobao.com/search?q=TI%20TPS2553DBVR%20DBV6%20SOT23-6 | https://www.ti.com/lit/ds/symlink/tps2553.pdf
U105 | TPS2116DRLR | Texas Instruments | TPS2116DRLR |  | 1 | 背面 | EXACT_MPN_CANDIDATE; NOT_APPROVED; NO_ORDER | CANDIDATE; native ERC checked; functional/current/DFM not complete |  | Package_TO_SOT_SMD:SOT-583-8 | https://s.taobao.com/search?q=Texas%20Instruments%20TPS2116DRLR%20 | https://www.ti.com/lit/ds/symlink/tps2116.pdf
U106 | TPS2553DBVR | Texas Instruments | TPS2553DBVR |  | 1 | 背面 | EXACT_MPN_CANDIDATE; NOT_APPROVED; NO_ORDER | CANDIDATE; native ERC checked; functional/current/DFM not complete |  | X100_Physical:Official_Package_TO_SOT_SMD_SOT-23-6 | https://s.taobao.com/search?q=Texas%20Instruments%20TPS2553DBVR%20 | https://www.ti.com/lit/ds/symlink/tps2553.pdf
U201 | STM32H743VIT6 | ST | STM32H743VIT6 | LQFP100 14x14 P0.5 | 1 | 正面 | EXACT_MPN_FROZEN |  |  | X100_Physical:Official_Package_QFP_LQFP-100_14x14mm_P0.5mm | https://s.taobao.com/search?q=ST%20STM32H743VIT6%20LQFP100%2014x14%20P0.5 | https://www.st.com/resource/en/datasheet/stm32h743vi.pdf
U301 | BMI088 | Bosch | BMI088 | LGA16 3x4.5 | 1 | 正面 | EXACT_MPN_FROZEN |  |  | X100_Physical:Bosch_BMI088_LGA16 | https://s.taobao.com/search?q=Bosch%20BMI088%20LGA16%203x4.5 | https://www.bosch-sensortec.com/media/boschsensortec/downloads/datasheets/bst-bmi088-ds001.pdf
U302 | SPL06-001 | Goertek | SPL06-001 | LGA8 2x2.5 | 1 | 正面 | EXACT_MPN_FROZEN |  |  | X100_Physical:Goertek_SPL06_001_LGA8 | https://s.taobao.com/search?q=Goertek%20SPL06-001%20LGA8%202x2.5 | ${KIPRJMOD}/../../docs/Components/Barometer/SPL06-001/Goertek_SPL06-001_Datasheet_V7.0.pdf
U401 | TPD4E1U06DBVR | TI | TPD4E1U06DBVR | DBV SOT-23-6 | 1 | 正面 | USER_APPROVED_OPTIMIZATION; no purchase | Schematic candidate; PCB/ESD system test pending |  | Package_TO_SOT_SMD:SOT-23-6 | https://s.taobao.com/search?q=TI%20TPD4E1U06DBVR%20DBV%20SOT-23-6 | https://www.ti.com/lit/ds/symlink/tpd4e1u06.pdf
U402 | SN74LVC1G17DBVR | TI | SN74LVC1G17DBVR | DBV5 SOT23-5 | 1 | 背面 | EXACT_MPN_FROZEN |  |  | X100_Physical:Official_Package_TO_SOT_SMD_SOT-23-5 | https://s.taobao.com/search?q=TI%20SN74LVC1G17DBVR%20DBV5%20SOT23-5 | https://www.ti.com/lit/ds/symlink/sn74lvc1g17.pdf
U403 | TPD2E2U06QDBZRQ1 | Texas Instruments | TPD2E2U06QDBZRQ1 | DBZ / SOT-23-3 | 1 | 背面 | EXACT_MPN_AUTHORIZED_PCB01F3; supplier listed; not ordered |  |  | X100_Physical:TI_TPD2E2U06_DBZ0003A | https://s.taobao.com/search?q=Texas%20Instruments%20TPD2E2U06QDBZRQ1%20DBZ%20/%20SOT-23-3 | https://www.ti.com/lit/ds/symlink/tpd2e2u06-q1.pdf
U601 | TCAN3414DR | Texas Instruments | TCAN3414DR | TI D0008A SOIC-8 | 1 | 背面 | EXACT_MPN_FROZEN |  |  | X100_Physical:TCAN3414_D0008A_SOIC8 | https://s.taobao.com/search?q=Texas%20Instruments%20TCAN3414DR%20TI%20D0008A%20SOIC-8 | https://www.ti.com/lit/ds/symlink/tcan3414.pdf
U801 | TMUX1511PWR | TI | TMUX1511PWR | PW14 TSSOP14 0.65mm visible leads | 1 | 正面 | EXACT_MPN_FROZEN |  |  | X100_Physical:Official_Package_SO_TSSOP-14_4.4x5mm_P0.65mm | https://s.taobao.com/search?q=TI%20TMUX1511PWR%20PW14%20TSSOP14%200.65mm%20visible%20leads | https://www.ti.com/lit/ds/symlink/tmux1511.pdf
Y201 | 8.000MHz /CL20pF | TAITIEN | XJHCELNANF-8M | HC49-class 2SMD 12.5x4.5x4 | 1 | 正面 | EXACT_MPN_FROZEN |  |  | X100_Physical:Taitien_XJ_2Pad_5p5x2p0_P9p0 | https://s.taobao.com/search?q=TAITIEN%20XJHCELNANF-8M%20HC49-class%202SMD%2012.5x4.5x4 | https://www.taitien.com/wp-content/uploads/2015/12/AT-0020_XJ.pdf

Sheet: 配套与不采购
配套采购与不需采购的板上实体
线束来源：JST GH 官方系列页；microSD沿用项目已记录规格，完整卡型号尚未冻结。
项目 | 完整型号或未定项 | 一板参考量 | 本次板数用量 | 采购说明 | 来源
GH 4P成品线或对插壳 | GHR-04V-S | 2 | 2 | 对应J601/J704；GH 1.25mm，线序按板上引脚；不是PH/SH。成品线与壳+端子方案二选一。 | https://www.jst-mfg.com/product/index.php?lang=2&series=105
GH 6P成品线或对插壳 | GHR-06V-S | 4 | 4 | 对应J701/J702/J703/J809；两端线序、长度及外围设备接口未冻结。 | https://www.jst-mfg.com/product/index.php?lang=2&series=105
GH压接端子（买成品线可不另买） | SSHL-002T-P0.2 | 32 | 32 | 只计算本板一端6个GH接口全部接满的触点数；完整双端线束另计。 | https://www.jst-mfg.com/product/index.php?lang=2&series=105
microSD卡本体 | 未冻结完整型号 | 1 | 1 | 已有要求：microSDHC 16/32GB、3.3V、FAT32；启动/初始化/读写峰值均≤200mA需完整型号资料或验证。Molex1040310811是卡座。 | 项目已记录的配套要求
USB数据线 | 完整型号未冻结 | 未定 | 未定 | 需带数据功能；验证USB-A→C与C→C兼容性，不能只买充电线。 | 项目已记录的配套要求
电池引线/外接插头 | 线径、插头及长度未冻结 | 未定 | 未定 | J808是PCB直接焊线焊盘，不采购一个名为VBAT_PAD_PAIR_V1的连接器。 | 项目已记录的配套要求
安装件 | M3尼龙螺钉/尼龙平垫圈，长度未冻结 | 未定 | 未定 | 四个Ø4 NPTH，正反面接触包络最大Ø7；安装高度/螺钉长度另定。 | 项目已记录的配套要求
SWD调试器/转接线 | 未冻结完整型号 | 未定 | 未定 | 须支持STM32H743；J807为1×5、2.54mm接口，按引脚表接线。 | 项目已记录的配套要求
以下32个PCB实体不采购元器件：26个测点、4个安装孔、JP601焊锡桥、J808焊线焊盘。
位号 | 名称 | 不采购原因
TP101 | VBAT_RAW | PCB裸铜测点，无需购买测试点元件
TP103 | VBAT_PROTECTED | PCB裸铜测点，无需购买测试点元件
TP104 | 5V_MAIN | PCB裸铜测点，无需购买测试点元件
TP105 | 3V3_MCU | PCB裸铜测点，无需购买测试点元件
TP106 | SENSOR_LDO_IN | PCB裸铜测点，无需购买测试点元件
TP107 | 3V3_SENSOR | PCB裸铜测点，无需购买测试点元件
TP109 | EXT_5V | PCB裸铜测点，无需购买测试点元件
TP110 | EXT_FAULT | PCB裸铜测点，无需购买测试点元件
TP111 | GND | PCB裸铜测点，无需购买测试点元件
TP202 | BOOT0 | PCB裸铜测点，无需购买测试点元件
TP204 | MCU_VDDA | PCB裸铜测点，无需购买测试点元件
TP205 | VCAP1 | PCB裸铜测点，无需购买测试点元件
TP206 | VCAP2 | PCB裸铜测点，无需购买测试点元件
TP208 | GND | PCB裸铜测点，无需购买测试点元件
TP302 | SPI1_SCK | PCB裸铜测点，无需购买测试点元件
TP303 | SPI1_MOSI | PCB裸铜测点，无需购买测试点元件
TP304 | SPI1_MISO | PCB裸铜测点，无需购买测试点元件
TP305 | BMI088_ACC_CS | PCB裸铜测点，无需购买测试点元件
TP306 | BMI088_GYRO_CS | PCB裸铜测点，无需购买测试点元件
TP307 | BARO_I2C2_SCL | PCB裸铜测点，无需购买测试点元件
TP308 | BARO_I2C2_SDA | PCB裸铜测点，无需购买测试点元件
TP401 | USB_VBUS_RAW | PCB裸铜测点，无需购买测试点元件
TP405 | GND | PCB裸铜测点，无需购买测试点元件
TP501 | 3V3_SD | PCB裸铜测点，无需购买测试点元件
JP601 | CAN TERM 120R / OPEN | PCB焊锡跳线，不购买开关
J808 | BATTERY/bench3S-6S ONLY | 直接焊线焊盘，不购买上板连接器
TP803 | VBAT_ADC | PCB裸铜测点，无需购买测试点元件
TP805 | CURRENT_ADC | PCB裸铜测点，无需购买测试点元件
H1 | Ø4 NPTH | PCB安装孔，不是BOM实物；螺钉另列配套
H2 | Ø4 NPTH | PCB安装孔，不是BOM实物；螺钉另列配套
H3 | Ø4 NPTH | PCB安装孔，不是BOM实物；螺钉另列配套
H4 | Ø4 NPTH | PCB安装孔，不是BOM实物；螺钉另列配套
