chen123037/X100-Flight-Controller-Edu/hardware/current/X100_6L_DFM_ZERO_DANGER/procurement/actual_sourcing/README.md

[Excel完整表](X100_62种器件_实际货源核查.xlsx) · [原型号CSV](62种原型号_已核商品货源.csv) · [候选CSV](同封装替代候选_未改工程.csv)

# X100：62种器件实际货源核查

核查日期：2026-10-31。按当前六层V4清单逐项核对62种完整MPN、每板142件；本轮没有改原理图、PCB或工程BOM，也没有加购物车、询价联系卖家或下单。

## 结论

- **54种原型号**：国内立创自营商品页显示现货，数量可覆盖一块板及起订量。
- **2种原型号**：立创海外代购可下单。C110原240pF电容1颗起、8–14个工作日；AP63203WU-7原型号23颗起、10–20个工作日。
- **1种数量不足**：C0603C104K5RACTU现货10颗，每板需19颗，不能写成已能买齐。
- **4种自营无现货**：R105、R107、R809/R810用料及原Y201晶振；已分别给出同封装候选及实际供货页。
- **1种由用户确认淘宝有售**：SPL06-001。立创旧SKU停售，不能据此说淘宝无货；用户已确认刚搜到在售，但没有提供链接，我方没有核实具体卖家、MOQ和交期。

TCAN3414DR已补核到国内立创C22396693、SOIC-8、现货729、1颗起订；此前列表懒加载漏读第二条的初查结论已撤回。不能买成TCAN3414DRBR的SON封装。

淘宝页面被当前浏览器安全策略拦截，本轮未绕过限制。淘宝栏均明确写未读取详情，不伪称淘宝缺货。其余已核渠道均给出真实商品详情页，不用搜索链接代替。

“最快4小时发货”仅为页面宣传的最早发货时间，不能解释为保证4小时发货或4小时送达。所有库存和交期都可能变化，付款前以实际订单页面为准；本报告不是到货真伪、芯片硅版本或功能验收。

## 全部62项

| 序号 | 原MPN | 一板用量 | 状态 | 渠道 | 库存 | MOQ | 页面发货/交期 | 商品详情 |
|---:|---|---:|---|---|---:|---:|---|---|
| 1 | C1210C106K5RACTU | 8 | 自营现货足一板 | 立创国内自营 | 80 | 1 | 最快4小时发货 | [商品页](https://item.szlcsc.com/2259740.html) |
| 2 | 50SVPF39M | 1 | 自营现货足一板 | 立创国内自营 | 39 | 1 | 最快4小时发货 | [商品页](https://item.szlcsc.com/226507.html) |
| 3 | C0603C104K5RACTU | 19 | 自营数量不足 | 立创国内自营 | 10 | 10 | 数量不足；补货交期未给出 | [商品页](https://item.szlcsc.com/139116.html) |
| 4 | 16SVPF180M | 2 | 自营现货足一板 | 立创国内自营 | 21 | 1 | 最快4小时发货 | [商品页](https://item.szlcsc.com/147592.html) |
| 5 | C0805C223K5RACTU | 3 | 自营现货足一板 | 立创国内自营 | 840 | 20 | 最快4小时发货 | [商品页](https://item.szlcsc.com/454915.html) |
| 6 | C0805C241J5GACTU | 1 | 原型号代购可下单 | 立创海外代购/DigiKey | 3974 | 1 | 8-14个工作日 | [商品页](https://item.szlcsc.com/details/Digikey/399-C0805C241J5GACTUCT-ND.html) |
| 7 | C1210C226K4RACTU | 2 | 自营现货足一板 | 立创国内自营 | 13 | 1 | 最快4小时发货 | [商品页](https://item.szlcsc.com/5999456.html) |
| 8 | C0805C225K4RACTU | 5 | 自营现货足一板 | 立创国内自营 | 3540 | 10 | 最快4小时发货 | [商品页](https://item.szlcsc.com/2259629.html) |
| 9 | 16SVPF82M | 1 | 自营现货足一板 | 立创国内自营 | 1490 | 1 | 最快4小时发货 | [商品页](https://item.szlcsc.com/189743.html) |
| 10 | C0805C105K4RACTU | 5 | 自营现货足一板 | 立创国内自营 | 2370 | 10 | 最快4小时发货 | [商品页](https://item.szlcsc.com/2259428.html) |
| 11 | C0805C104K5RACTU | 4 | 自营现货足一板 | 立创国内自营 | 200 | 10 | 最快4小时发货 | [商品页](https://item.szlcsc.com/3531109.html) |
| 12 | CC0805JRNPO9BN330 | 2 | 自营现货足一板 | 立创国内自营 | 951000 | 100 | 最快4小时发货 | [商品页](https://item.szlcsc.com/108331.html) |
| 13 | BZT52H-C12,115 | 1 | 自营现货足一板 | 立创国内自营 | 50460 | 20 | 最快4小时发货 | [商品页](https://item.szlcsc.com/268471.html) |
| 14 | SMBJ26CA-TR | 1 | 自营现货足一板 | 立创国内自营 | 580 | 5 | 最快4小时发货 | [商品页](https://item.szlcsc.com/144972.html) |
| 15 | STPS8H100G-TR | 1 | 自营现货足一板 | 立创国内自营 | 7 | 1 | 最快4小时发货 | [商品页](https://item.szlcsc.com/221913.html) |
| 16 | LTST-C170GKT | 2 | 自营现货足一板 | 立创国内自营 | 27220 | 20 | 最快4小时发货 | [商品页](https://item.szlcsc.com/136366.html) |
| 17 | 0451003.MRL | 1 | 自营现货足一板 | 立创国内自营 | 33080 | 5 | 最快4小时发货 | [商品页](https://item.szlcsc.com/14638.html) |
| 18 | 124019772112A | 1 | 自营现货足一板 | 立创国内自营 | 7024 | 1 | 最快4小时发货 | [商品页](https://item.szlcsc.com/6306263.html) |
| 19 | 1040310811 | 1 | 自营现货足一板 | 立创国内自营 | 48704 | 1 | 最快4小时发货 | [商品页](https://item.szlcsc.com/613200.html) |
| 20 | SM04B-GHS-TB(LF)(SN) | 2 | 自营现货足一板 | 立创国内自营 | 21700 | 5 | 最快4小时发货 | [商品页](https://item.szlcsc.com/207060.html) |
| 21 | SM06B-GHS-TB(LF)(SN) | 4 | 自营现货足一板 | 立创国内自营 | 21835 | 5 | 最快4小时发货 | [商品页](https://item.szlcsc.com/144367.html) |
| 22 | TSW-102-07-G-S | 6 | 自营现货足一板 | 立创国内自营 | 1420 | 5 | 最快4小时发货 | [商品页](https://item.szlcsc.com/8374910.html) |
| 23 | TSW-105-07-G-S | 1 | 自营现货足一板 | 立创国内自营 | 20 | 1 | 最快4小时发货 | [商品页](https://item.szlcsc.com/6932074.html) |
| 24 | SRP1038A-100M | 1 | 自营现货足一板 | 立创国内自营 | 700 | 1 | 3个工作日 | [商品页](https://item.szlcsc.com/832151.html) |
| 25 | SRN6045-4R7Y | 1 | 自营现货足一板 | 立创国内自营 | 1180 | 1 | 最快4小时发货 | [商品页](https://item.szlcsc.com/832177.html) |
| 26 | DMP6023LSS-13 | 1 | 自营现货足一板 | 立创国内自营 | 1301 | 1 | 最快4小时发货 | [商品页](https://item.szlcsc.com/166253.html) |
| 27 | RC0805FR-0720KL | 2 | 自营现货足一板 | 立创国内自营 | 2165700 | 100 | 最快4小时发货 | [商品页](https://item.szlcsc.com/115810.html) |
| 28 | RC0805FR-07294KL | 1 | 自营现货足一板 | 立创国内自营 | 2600 | 100 | 最快4小时发货 | [商品页](https://item.szlcsc.com/490948.html) |
| 29 | RC0805FR-0754K9L | 1 | 自营现货足一板 | 立创国内自营 | 4100 | 100 | 最快4小时发货 | [商品页](https://item.szlcsc.com/148826.html) |
| 30 | RC0805FR-07200KL | 1 | 自营现货足一板 | 立创国内自营 | 718300 | 100 | 最快4小时发货 | [商品页](https://item.szlcsc.com/115806.html) |
| 31 | RT0805BRD0753K6L | 1 | 自营无现货 | 立创国内自营 | 0 | 20 | 无现货；订货交期未给出 | [商品页](https://item.szlcsc.com/925632.html) |
| 32 | RT0805BRD0710KL | 3 | 自营现货足一板 | 立创国内自营 | 550920 | 20 | 最快4小时发货 | [商品页](https://item.szlcsc.com/112000.html) |
| 33 | RC0805FR-0718K7L | 1 | 自营无现货 | 立创国内自营 | 0 | 100 | 无现货；订货交期未给出 | [商品页](https://item.szlcsc.com/262295.html) |
| 34 | RC0805FR-0710RL | 2 | 自营现货足一板 | 立创国内自营 | 1296800 | 50 | 最快4小时发货 | [商品页](https://item.szlcsc.com/97551.html) |
| 35 | RC0805FR-0722K1L | 2 | 自营现货足一板 | 立创国内自营 | 6300 | 100 | 最快4小时发货 | [商品页](https://item.szlcsc.com/262255.html) |
| 36 | RC0805FR-0710KL | 10 | 自营现货足一板 | 立创国内自营 | 1383000 | 100 | 最快4小时发货 | [商品页](https://item.szlcsc.com/85546.html) |
| 37 | RT0805BRD0733K2L | 1 | 自营现货足一板 | 立创国内自营 | 910 | 10 | 最快4小时发货 | [商品页](https://item.szlcsc.com/925492.html) |
| 38 | RT0805BRD0749K9L | 1 | 自营现货足一板 | 立创国内自营 | 14740 | 20 | 最快4小时发货 | [商品页](https://item.szlcsc.com/476225.html) |
| 39 | RC0805FR-07120RL | 2 | 自营现货足一板 | 立创国内自营 | 138000 | 100 | 最快4小时发货 | [商品页](https://item.szlcsc.com/115485.html) |
| 40 | RC0805FR-071KL | 5 | 自营现货足一板 | 立创国内自营 | 3130100 | 100 | 最快4小时发货 | [商品页](https://item.szlcsc.com/96985.html) |
| 41 | RC0805FR-071K2L | 1 | 自营现货足一板 | 立创国内自营 | 439000 | 100 | 最快4小时发货 | [商品页](https://item.szlcsc.com/115770.html) |
| 42 | RC0805FR-074K7L | 4 | 自营现货足一板 | 立创国内自营 | 3851700 | 100 | 最快4小时发货 | [商品页](https://item.szlcsc.com/61868.html) |
| 43 | RC0805FR-075K1L | 2 | 自营现货足一板 | 立创国内自营 | 784900 | 100 | 最快4小时发货 | [商品页](https://item.szlcsc.com/85545.html) |
| 44 | RC0805FR-07100KL | 1 | 自营现货足一板 | 立创国内自营 | 1292100 | 100 | 最快4小时发货 | [商品页](https://item.szlcsc.com/97550.html) |
| 45 | RC0805JR-070RL | 1 | 自营现货足一板 | 立创国内自营 | 3031300 | 100 | 最快4小时发货 | [商品页](https://item.szlcsc.com/97549.html) |
| 46 | RC0805FR-0747KL | 5 | 自营现货足一板 | 立创国内自营 | 273600 | 100 | 最快4小时发货 | [商品页](https://item.szlcsc.com/137631.html) |
| 47 | RT0805BRD07150KL | 1 | 自营现货足一板 | 立创国内自营 | 57270 | 10 | 最快4小时发货 | [商品页](https://item.szlcsc.com/148243.html) |
| 48 | RC0805FR-071M3L | 2 | 自营无现货 | 立创国内自营 | 0 | 100 | 无现货；订货交期未给出 | [商品页](https://item.szlcsc.com/490822.html) |
| 49 | TPS54360BDDAR | 1 | 自营现货足一板 | 立创国内自营 | 52830 | 1 | 最快4小时发货 | [商品页](https://item.szlcsc.com/542861.html) |
| 50 | AP63203WU-7 | 1 | 原型号代购可下单 | 立创海外代购/Mouser | 4207 | 23 | 10-20个工作日 | [商品页](https://item.szlcsc.com/details/Mouser/621-AP63203WU-7.html) |
| 51 | TPS7A2033PDBVR | 1 | 自营现货足一板 | 立创国内自营 | 125435 | 5 | 最快4小时发货 | [商品页](https://item.szlcsc.com/3067417.html) |
| 52 | TPS2553DBVR | 2 | 自营现货足一板 | 立创国内自营 | 43671 | 1 | 最快4小时发货 | [商品页](https://item.szlcsc.com/56292.html) |
| 53 | TPS2116DRLR | 1 | 自营现货足一板 | 立创国内自营 | 49894 | 1 | 3个工作日 | [商品页](https://item.szlcsc.com/3798578.html) |
| 54 | STM32H743VIT6 | 1 | 自营现货足一板 | 立创国内自营 | 7626 | 1 | 最快4小时发货 | [商品页](https://item.szlcsc.com/115649.html) |
| 55 | BMI088 | 1 | 自营现货足一板 | 立创国内自营 | 8948 | 1 | 最快4小时发货 | [商品页](https://item.szlcsc.com/239391.html) |
| 56 | SPL06-001 | 1 | 淘宝用户确认有售；详情未核 | 立创国内自营 | 未显示 | 停售/未核 | 停售；淘宝交期未核 | [商品页](https://item.szlcsc.com/2782076.html) |
| 57 | TPD4E1U06DBVR | 1 | 自营现货足一板 | 立创国内自营 | 20570 | 5 | 最快4小时发货 | [商品页](https://item.szlcsc.com/125968.html) |
| 58 | SN74LVC1G17DBVR | 1 | 自营现货足一板 | 立创国内自营 | 17625 | 5 | 最快4小时发货 | [商品页](https://item.szlcsc.com/8313.html) |
| 59 | TPD2E2U06QDBZRQ1 | 1 | 自营现货足一板 | 立创国内自营 | 1815 | 5 | 最快4小时发货 | [商品页](https://item.szlcsc.com/497721.html) |
| 60 | TCAN3414DR | 1 | 自营现货足一板 | 立创国内自营 | 729 | 1 | 最快4小时发货 | [商品页](https://item.szlcsc.com/24002530.html) |
| 61 | TMUX1511PWR | 1 | 自营现货足一板 | 立创国内自营 | 696 | 1 | 最快4小时发货 | [商品页](https://item.szlcsc.com/3071427.html) |
| 62 | XJHCELNANF-8M | 1 | 自营无现货 | 立创国内自营 | 0 | 5 | 无现货；订货交期未给出 | [商品页](https://item.szlcsc.com/124568.html) |

## 同封装候选：未采用、未改工程

### C106,C107,C112,C117,C203,C204,C205,C206,C207,C210,C211,C301,C302,C303,C304,C402,C501,C601,C805：C0603C104K5RACTU

候选 **CL10B104KB8NNNC**，[直接商品页](https://item.szlcsc.com/1943.html)。页面库存1901800（现货），MOQ 100，最快4小时发货。

已核：同0603、100nF、±10%、50V、X7R。

边界：原19个位号；直流偏压/温度后的有效容值与所在支路要求仍按原设计复核。

### C110：C0805C241J5GACTU

候选 **CC0805JRNPO9BN241**，[直接商品页](https://item.szlcsc.com/536696.html)。页面库存11500（现货），MOQ 50，最快4小时发货。

已核：同0805、240pF、±5%、50V、NP0/C0G。

边界：原型号也有DigiKey代购；此项仅作较快国内备选，不自动换补偿件。

### R105：RT0805BRD0753K6L

候选 **ERA-6AEB5362V**，[直接商品页](https://item.szlcsc.com/details/Digikey/P53.6KDACT-ND.html)。页面库存17290（库存），MOQ 1，8-14个工作日。

已核：同0805、53.6kΩ、±0.1%、125mW、±25ppm/℃。

边界：保持R105阻值与精度；Panasonic ERA6A原厂表核对机械与电压额定，未改原工程。

### R107：RC0805FR-0718K7L

候选 **0805W8F1872T5E**，[直接商品页](https://item.szlcsc.com/18187.html)。页面库存19800（现货），MOQ 100，最快4小时发货。

已核：同0805、18.7kΩ、±1%、125mW；150V、±100ppm/℃。

边界：R107为补偿器件，阻值不变；不得擅自以18k或20k代替。

### R809,R810：RC0805FR-071M3L

候选 **0805W8F1304T5E**，[直接商品页](https://item.szlcsc.com/26852.html)。页面库存500（现货），MOQ 100，最快4小时发货。

已核：同0805、1.3MΩ、±1%、125mW；150V、±100ppm/℃。

边界：对应R809/R810；高阻支路的漏电/噪声要求仍保留。

### Y201：XJHCELNANF-8M

候选 **XJHCCLNANF-8.000000MHZ**，[直接商品页](https://item.szlcsc.com/539042.html)。页面库存740（现货），MOQ 5，最快4小时发货。

已核：同TAITIEN XJ/HC-49S-SMD、8MHz、CL20pF、-40～85℃，初始/稳定度±20ppm。

边界：原为±30ppm；温区不缩小。同系列机械初筛，ESR/驱动功率与启动裕量仍按原厂资料复核；未改晶振或负载电容。

### U102：AP63203WU-7

候选 **AP63203QWU-7**，[直接商品页](https://item.szlcsc.com/5961413.html)。页面库存3000（库存），MOQ 3000，31-33个工作日。

已核：同TSOT26、固定3.3V、2A、1.1MHz、VIN3.8～32V。

边界：汽车级备选，不能以型号相近就认定已逐脚验收；立创该条目MOQ3000、交期31–33工作日，不推荐首板为此采购整盘；优先原AP63203代购。

## 没有混进可购清单的近似件

- AR05BTC5362未查到；商城自动返回的是AR02BTC5362、0402，不是0805，未当作R105替代。
- XJHBBCNANF-8.000000MHZ虽有现货，但温区-20～70℃缩小，不选它代替原-40～85℃晶振；优先同温区的XJHCCLNANF候选。
- AP63205WU-7输出为5V，不能因为同TSOT26就替换AP63203的3.3V。
- SPA06-003虽为同LGA8且有立创现货，但不是SPL06-001；没有因此替换冻结气压计或声称驱动相同。

## 本轮不能给的保证

不能说62种原型号全都有国内小量现货。SPL06的淘宝商品详情尚未核实；5个立创供货缺口对应的候选只完成同封装/主要参数初筛，不是正式采纳，也不代表全网原料都买不到。原型号若能落实淘宝或其它可靠渠道，仍可优先保留，不必为了这张表换料。C110和R105可选择国内/代购不同方案；AP63203原型能代购但MOQ23是实际采购条件。

STM32H743VIT6页面有货不代表承诺项目要求的硅修订版V，仍需交货或来料核对；所有候选不自动覆盖原有电气/温度/偏压/启动约束。

资料依据：实际浏览器中立创商品详情的型号、封装、库存、MOQ及交期字段；逐项摘录在sourcing_report_data.json的quote。R105候选另参考[Panasonic ERA A原厂规格](https://industrial.panasonic.com/cdbs/www-data/pdf/RDM0000/AOA0000C307.pdf)，APQ备选参考[Diodes原厂资料](https://www.diodes.com/datasheet/download/AP63200Q%20AP63201Q%20AP63203Q%20AP63205Q.pdf)。没有以网站“相似度”代替引脚和性能结论。
