chen123037/X100-Flight-Controller-Edu/hardware/current/X100_6L_DFM_ZERO_DANGER/procurement/actual_sourcing/X100_62种器件_实际货源核查.xlsx

Sheet: 62项实际货源
X100：62种器件实际货源核查
种数 | 62 |  | 单板件数 | 142 |  | 国内足量 | 54 |  | 原型代购 | 2
核查日期：2026-10-31。库存与起订量来自实际商品页；“最快4小时”不是最迟发货/到货保证。代购交期按页面原文。
SPL06-001：用户确认淘宝有售，具体商品/MOQ/交期待核。淘宝访问受安全策略限制，不将未访问写成缺货；工程及原BOM未改。
本表保留完整商品URL，可复制打开；随附Markdown清单提供可直接点击的同一批商品链接。
序号 | 原完整MPN | 位号 | 一板用量 | 封装 | 供货结论 | 渠道 | 商品直达URL | 页面库存 | 起订量 | 发货或交期原文 | 淘宝核查情况 | 重要说明
1 | C1210C106K5RACTU | C101,C102,C103,C104,C111,C118,C208,C502 | 8 | 1210 | 自营现货足一板 | 立创国内自营 | https://item.szlcsc.com/2259740.html | 80 | 1 | 最快4小时发货 | 浏览器安全策略拦截；未核实，不表示缺货
2 | 50SVPF39M | C105 | 1 | OS-CON E12 diameter8 height11.9 | 自营现货足一板 | 立创国内自营 | https://item.szlcsc.com/226507.html | 39 | 1 | 最快4小时发货 | 浏览器安全策略拦截；未核实，不表示缺货
3 | C0603C104K5RACTU | C106,C107,C112,C117,C203,C204,C205,C206,C207,C210,C211,C301,C302,C303,C304,C402,C501,C601,C805 | 19 | 0603 | 自营数量不足 | 立创国内自营 | https://item.szlcsc.com/139116.html | 10 | 10 | 数量不足；补货交期未给出 | 浏览器安全策略拦截；未核实，不表示缺货 | 现货10，单板需19，不足9；不把SMT库存与零售库存混算
4 | 16SVPF180M | C108,C121 | 2 | OS-CON C6 diameter6.3 height5.9 | 自营现货足一板 | 立创国内自营 | https://item.szlcsc.com/147592.html | 21 | 1 | 最快4小时发货 | 浏览器安全策略拦截；未核实，不表示缺货 | 源工程候选字段涉及：C121；本轮不改字段或型号
5 | C0805C223K5RACTU | C109,C803,C804 | 3 | 0805 | 自营现货足一板 | 立创国内自营 | https://item.szlcsc.com/454915.html | 840 | 20 | 最快4小时发货 | 浏览器安全策略拦截；未核实，不表示缺货
6 | C0805C241J5GACTU | C110 | 1 | 0805 | 原型号代购可下单 | 立创海外代购/DigiKey | https://item.szlcsc.com/details/Digikey/399-C0805C241J5GACTUCT-ND.html | 3974 | 1 | 8-14个工作日 | 浏览器安全策略拦截；未核实，不表示缺货
7 | C1210C226K4RACTU | C113,C114 | 2 | 1210 | 自营现货足一板 | 立创国内自营 | https://item.szlcsc.com/5999456.html | 13 | 1 | 最快4小时发货 | 浏览器安全策略拦截；未核实，不表示缺货
8 | C0805C225K4RACTU | C115,C116,C201,C202,C209 | 5 | 0805 | 自营现货足一板 | 立创国内自营 | https://item.szlcsc.com/2259629.html | 3540 | 10 | 最快4小时发货 | 浏览器安全策略拦截；未核实，不表示缺货
9 | 16SVPF82M | C119 | 1 | OS-CON B6 diameter5 height5.9 | 自营现货足一板 | 立创国内自营 | https://item.szlcsc.com/189743.html | 1490 | 1 | 最快4小时发货 | 浏览器安全策略拦截；未核实，不表示缺货
10 | C0805C105K4RACTU | C120,C123,C124,C125,C126 | 5 | 0805 | 自营现货足一板 | 立创国内自营 | https://item.szlcsc.com/2259428.html | 2370 | 10 | 最快4小时发货 | 浏览器安全策略拦截；未核实，不表示缺货
11 | C0805C104K5RACTU | C212,C401,C801,C802 | 4 | 0805 | 自营现货足一板 | 立创国内自营 | https://item.szlcsc.com/3531109.html | 200 | 10 | 最快4小时发货 | 浏览器安全策略拦截；未核实，不表示缺货
12 | CC0805JRNPO9BN330 | C213,C214 | 2 | 0805 | 自营现货足一板 | 立创国内自营 | https://item.szlcsc.com/108331.html | 951000 | 100 | 最快4小时发货 | 浏览器安全策略拦截；未核实，不表示缺货
13 | BZT52H-C12,115 | D101 | 1 | SOD123F | 自营现货足一板 | 立创国内自营 | https://item.szlcsc.com/268471.html | 50460 | 20 | 最快4小时发货 | 浏览器安全策略拦截；未核实，不表示缺货
14 | SMBJ26CA-TR | D102 | 1 | SMB DO214AA | 自营现货足一板 | 立创国内自营 | https://item.szlcsc.com/144972.html | 580 | 5 | 最快4小时发货 | 浏览器安全策略拦截；未核实，不表示缺货
15 | STPS8H100G-TR | D103 | 1 | D2PAK A/K/tabK | 自营现货足一板 | 立创国内自营 | https://item.szlcsc.com/221913.html | 7 | 1 | 最快4小时发货 | 浏览器安全策略拦截；未核实，不表示缺货
16 | LTST-C170GKT | D201,D202 | 2 | 0805 LED | 自营现货足一板 | 立创国内自营 | https://item.szlcsc.com/136366.html | 27220 | 20 | 最快4小时发货 | 浏览器安全策略拦截；未核实，不表示缺货
17 | 0451003.MRL | F101 | 1 | NANO2 451 SMD | 自营现货足一板 | 立创国内自营 | https://item.szlcsc.com/14638.html | 33080 | 5 | 最快4小时发货 | 浏览器安全策略拦截；未核实，不表示缺货
18 | 124019772112A | J401 | 1 | USB-C dual-row SMT / 4 plated SH slots | 自营现货足一板 | 立创国内自营 | https://item.szlcsc.com/6306263.html | 7024 | 1 | 最快4小时发货 | 浏览器安全策略拦截；未核实，不表示缺货
19 | 1040310811 | J501 | 1 | microSD SMT push-pull8+2detect | 自营现货足一板 | 立创国内自营 | https://item.szlcsc.com/613200.html | 48704 | 1 | 最快4小时发货 | 浏览器安全策略拦截；未核实，不表示缺货
20 | SM04B-GHS-TB(LF)(SN) | J601,J704 | 2 | GH1.25 4P side-entry SMT | 自营现货足一板 | 立创国内自营 | https://item.szlcsc.com/207060.html | 21700 | 5 | 最快4小时发货 | 浏览器安全策略拦截；未核实，不表示缺货
21 | SM06B-GHS-TB(LF)(SN) | J701,J702,J703,J809 | 4 | GH1.25 6P side-entry SMT | 自营现货足一板 | 立创国内自营 | https://item.szlcsc.com/144367.html | 21835 | 5 | 最快4小时发货 | 浏览器安全策略拦截；未核实，不表示缺货
22 | TSW-102-07-G-S | J801,J802,J803,J804,J805,J806 | 6 | 1x2 2.54 THT top insertion | 自营现货足一板 | 立创国内自营 | https://item.szlcsc.com/8374910.html | 1420 | 5 | 最快4小时发货 | 浏览器安全策略拦截；未核实，不表示缺货
23 | TSW-105-07-G-S | J807 | 1 | 1x5 2.54 THT top insertion | 自营现货足一板 | 立创国内自营 | https://item.szlcsc.com/6932074.html | 20 | 1 | 最快4小时发货 | 浏览器安全策略拦截；未核实，不表示缺货
24 | SRP1038A-100M | L101 | 1 | Lead-frame SMD; case max11.5x10.3x4.0mm | 自营现货足一板 | 立创国内自营 | https://item.szlcsc.com/832151.html | 700 | 1 | 3个工作日 | 浏览器安全策略拦截；未核实，不表示缺货
25 | SRN6045-4R7Y | L102 | 1 | 6x6x4.5 SMD visible end terminals | 自营现货足一板 | 立创国内自营 | https://item.szlcsc.com/832177.html | 1180 | 1 | 最快4小时发货 | 浏览器安全策略拦截；未核实，不表示缺货
26 | DMP6023LSS-13 | Q101 | 1 | SO8 | 自营现货足一板 | 立创国内自营 | https://item.szlcsc.com/166253.html | 1301 | 1 | 最快4小时发货 | 浏览器安全策略拦截；未核实，不表示缺货
27 | RC0805FR-0720KL | R101,R806 | 2 | 0805 | 自营现货足一板 | 立创国内自营 | https://item.szlcsc.com/115810.html | 2165700 | 100 | 最快4小时发货 | 浏览器安全策略拦截；未核实，不表示缺货
28 | RC0805FR-07294KL | R102 | 1 | 0805 | 自营现货足一板 | 立创国内自营 | https://item.szlcsc.com/490948.html | 2600 | 100 | 最快4小时发货 | 浏览器安全策略拦截；未核实，不表示缺货
29 | RC0805FR-0754K9L | R103 | 1 | 0805 | 自营现货足一板 | 立创国内自营 | https://item.szlcsc.com/148826.html | 4100 | 100 | 最快4小时发货 | 浏览器安全策略拦截；未核实，不表示缺货
30 | RC0805FR-07200KL | R104 | 1 | 0805 | 自营现货足一板 | 立创国内自营 | https://item.szlcsc.com/115806.html | 718300 | 100 | 最快4小时发货 | 浏览器安全策略拦截；未核实，不表示缺货
31 | RT0805BRD0753K6L | R105 | 1 | 0805 | 自营无现货 | 立创国内自营 | https://item.szlcsc.com/925632.html | 0 | 20 | 无现货；订货交期未给出 | 浏览器安全策略拦截；未核实，不表示缺货 | 页面显示0现货；即使旁边有最快4小时宣传，也不记为可发货；源工程候选字段涉及：R105；本轮不改字段或型号
32 | RT0805BRD0710KL | R106,R112,R802 | 3 | 0805 | 自营现货足一板 | 立创国内自营 | https://item.szlcsc.com/112000.html | 550920 | 20 | 最快4小时发货 | 浏览器安全策略拦截；未核实，不表示缺货
33 | RC0805FR-0718K7L | R107 | 1 | 0805 | 自营无现货 | 立创国内自营 | https://item.szlcsc.com/262295.html | 0 | 100 | 无现货；订货交期未给出 | 浏览器安全策略拦截；未核实，不表示缺货 | 页面显示0现货；即使旁边有最快4小时宣传，也不记为可发货
34 | RC0805FR-0710RL | R108,R201 | 2 | 0805 | 自营现货足一板 | 立创国内自营 | https://item.szlcsc.com/97551.html | 1296800 | 50 | 最快4小时发货 | 浏览器安全策略拦截；未核实，不表示缺货
35 | RC0805FR-0722K1L | R109,R805 | 2 | 0805 | 自营现货足一板 | 立创国内自营 | https://item.szlcsc.com/262255.html | 6300 | 100 | 最快4小时发货 | 浏览器安全策略拦截；未核实，不表示缺货
36 | RC0805FR-0710KL | R110,R114,R203,R204,R301,R302,R403,R603,R604,R811 | 10 | 0805 | 自营现货足一板 | 立创国内自营 | https://item.szlcsc.com/85546.html | 1383000 | 100 | 最快4小时发货 | 浏览器安全策略拦截；未核实，不表示缺货
37 | RT0805BRD0733K2L | R111 | 1 | 0805 | 自营现货足一板 | 立创国内自营 | https://item.szlcsc.com/925492.html | 910 | 10 | 最快4小时发货 | 浏览器安全策略拦截；未核实，不表示缺货
38 | RT0805BRD0749K9L | R113 | 1 | 0805 | 自营现货足一板 | 立创国内自营 | https://item.szlcsc.com/476225.html | 14740 | 20 | 最快4小时发货 | 浏览器安全策略拦截；未核实，不表示缺货
39 | RC0805FR-07120RL | R205,R602 | 2 | 0805 | 自营现货足一板 | 立创国内自营 | https://item.szlcsc.com/115485.html | 138000 | 100 | 最快4小时发货 | 浏览器安全策略拦截；未核实，不表示缺货
40 | RC0805FR-071KL | R206,R803,R804,R807,R808 | 5 | 0805 | 自营现货足一板 | 立创国内自营 | https://item.szlcsc.com/96985.html | 3130100 | 100 | 最快4小时发货 | 浏览器安全策略拦截；未核实，不表示缺货
41 | RC0805FR-071K2L | R207 | 1 | 0805 | 自营现货足一板 | 立创国内自营 | https://item.szlcsc.com/115770.html | 439000 | 100 | 最快4小时发货 | 浏览器安全策略拦截；未核实，不表示缺货
42 | RC0805FR-074K7L | R303,R304,R701,R702 | 4 | 0805 | 自营现货足一板 | 立创国内自营 | https://item.szlcsc.com/61868.html | 3851700 | 100 | 最快4小时发货 | 浏览器安全策略拦截；未核实，不表示缺货
43 | RC0805FR-075K1L | R401,R402 | 2 | 0805 | 自营现货足一板 | 立创国内自营 | https://item.szlcsc.com/85545.html | 784900 | 100 | 最快4小时发货 | 浏览器安全策略拦截；未核实，不表示缺货
44 | RC0805FR-07100KL | R404 | 1 | 0805 | 自营现货足一板 | 立创国内自营 | https://item.szlcsc.com/97550.html | 1292100 | 100 | 最快4小时发货 | 浏览器安全策略拦截；未核实，不表示缺货
45 | RC0805JR-070RL | R501 | 1 | 0805 | 自营现货足一板 | 立创国内自营 | https://item.szlcsc.com/97549.html | 3031300 | 100 | 最快4小时发货 | 浏览器安全策略拦截；未核实，不表示缺货
46 | RC0805FR-0747KL | R502,R503,R504,R505,R506 | 5 | 0805 | 自营现货足一板 | 立创国内自营 | https://item.szlcsc.com/137631.html | 273600 | 100 | 最快4小时发货 | 浏览器安全策略拦截；未核实，不表示缺货
47 | RT0805BRD07150KL | R801 | 1 | 0805 | 自营现货足一板 | 立创国内自营 | https://item.szlcsc.com/148243.html | 57270 | 10 | 最快4小时发货 | 浏览器安全策略拦截；未核实，不表示缺货
48 | RC0805FR-071M3L | R809,R810 | 2 | 0805 | 自营无现货 | 立创国内自营 | https://item.szlcsc.com/490822.html | 0 | 100 | 无现货；订货交期未给出 | 浏览器安全策略拦截；未核实，不表示缺货 | 页面显示0现货；即使旁边有最快4小时宣传，也不记为可发货
49 | TPS54360BDDAR | U101 | 1 | DDA0008B HSOIC8 EP | 自营现货足一板 | 立创国内自营 | https://item.szlcsc.com/542861.html | 52830 | 1 | 最快4小时发货 | 浏览器安全策略拦截；未核实，不表示缺货
50 | AP63203WU-7 | U102 | 1 | TSOT26 | 原型号代购可下单 | 立创海外代购/Mouser | https://item.szlcsc.com/details/Mouser/621-AP63203WU-7.html | 4207 | 23 | 10-20个工作日 | 浏览器安全策略拦截；未核实，不表示缺货 | 国内自营0现货；该代购页MOQ为23，不是价格表1+就能买1颗
51 | TPS7A2033PDBVR | U103 | 1 | DBV5 SOT23-5 | 自营现货足一板 | 立创国内自营 | https://item.szlcsc.com/3067417.html | 125435 | 5 | 最快4小时发货 | 浏览器安全策略拦截；未核实，不表示缺货
52 | TPS2553DBVR | U104,U106 | 2 | DBV6 SOT23-6 | 自营现货足一板 | 立创国内自营 | https://item.szlcsc.com/56292.html | 43671 | 1 | 最快4小时发货 | 浏览器安全策略拦截；未核实，不表示缺货 | 源工程候选字段涉及：U106；本轮不改字段或型号
53 | TPS2116DRLR | U105 | 1 | SOT-583-8 | 自营现货足一板 | 立创国内自营 | https://item.szlcsc.com/3798578.html | 49894 | 1 | 3个工作日 | 浏览器安全策略拦截；未核实，不表示缺货 | 源工程候选字段涉及：U105；本轮不改字段或型号
54 | STM32H743VIT6 | U201 | 1 | LQFP100 14x14 P0.5 | 自营现货足一板 | 立创国内自营 | https://item.szlcsc.com/115649.html | 7626 | 1 | 最快4小时发货 | 浏览器安全策略拦截；未核实，不表示缺货 | 网页完整MPN有货，但没有保证项目所需硅修订版V；交货承诺/来料标记仍需核对
55 | BMI088 | U301 | 1 | LGA16 3x4.5 | 自营现货足一板 | 立创国内自营 | https://item.szlcsc.com/239391.html | 8948 | 1 | 最快4小时发货 | 浏览器安全策略拦截；未核实，不表示缺货
56 | SPL06-001 | U302 | 1 | LGA8 2x2.5 | 淘宝用户确认有售；详情未核 | 立创国内自营 | https://item.szlcsc.com/2782076.html | 未显示 | 未核/停售 | 停售；淘宝交期未核 | 用户确认淘宝有售；我方未读取商品详情 | 立创当前SKU已停售；负责人已确认淘宝有售；具体商品链接、MOQ和交期未独立核实，保留原型号
57 | TPD4E1U06DBVR | U401 | 1 | DBV SOT-23-6 | 自营现货足一板 | 立创国内自营 | https://item.szlcsc.com/125968.html | 20570 | 5 | 最快4小时发货 | 浏览器安全策略拦截；未核实，不表示缺货
58 | SN74LVC1G17DBVR | U402 | 1 | DBV5 SOT23-5 | 自营现货足一板 | 立创国内自营 | https://item.szlcsc.com/8313.html | 17625 | 5 | 最快4小时发货 | 浏览器安全策略拦截；未核实，不表示缺货
59 | TPD2E2U06QDBZRQ1 | U403 | 1 | DBZ / SOT-23-3 | 自营现货足一板 | 立创国内自营 | https://item.szlcsc.com/497721.html | 1815 | 5 | 最快4小时发货 | 浏览器安全策略拦截；未核实，不表示缺货
60 | TCAN3414DR | U601 | 1 | TI D0008A SOIC-8 | 自营现货足一板 | 立创国内自营 | https://item.szlcsc.com/24002530.html | 729 | 1 | 最快4小时发货 | 用户确认淘宝有售；我方未读取商品详情 | 已复核完整列表第二条：C22396693、SOIC-8；不是TCAN3414DRBR的SON封装
61 | TMUX1511PWR | U801 | 1 | PW14 TSSOP14 0.65mm visible leads | 自营现货足一板 | 立创国内自营 | https://item.szlcsc.com/3071427.html | 696 | 1 | 最快4小时发货 | 浏览器安全策略拦截；未核实，不表示缺货
62 | XJHCELNANF-8M | Y201 | 1 | HC49-class 2SMD 12.5x4.5x4 | 自营无现货 | 立创国内自营 | https://item.szlcsc.com/124568.html | 0 | 5 | 无现货；订货交期未给出 | 浏览器安全策略拦截；未核实，不表示缺货 | 页面显示0现货；即使旁边有最快4小时宣传，也不记为可发货

Sheet: 同封装候选未采用
同封装替代候选：未采用、未改工程
5个立创供货缺口对应100nF电容、R105、R107、R809/R810及Y201；不是强制换料，原型若能落实仍可保留。另含240pF及APQ备选。
原MPN | 位号 | 候选MPN | 已核匹配项目 | 使用建议 | 候选商品页 | 页面库存 | 库存类型 | MOQ | 页面交期 | 差异及待核事项 | 已写入工程
C0603C104K5RACTU | C106,C107,C112,C117,C203,C204,C205,C206,C207,C210,C211,C301,C302,C303,C304,C402,C501,C601,C805 | CL10B104KB8NNNC | 同0603、100nF、±10%、50V、X7R | 国内现货候选 | https://item.szlcsc.com/1943.html | 1901800 | 现货 | 100 | 最快4小时发货 | 原19个位号；直流偏压/温度后的有效容值与所在支路要求仍按原设计复核 | 否
C0805C241J5GACTU | C110 | CC0805JRNPO9BN241 | 同0805、240pF、±5%、50V、NP0/C0G | 可选国内候选 | https://item.szlcsc.com/536696.html | 11500 | 现货 | 50 | 最快4小时发货 | 原型号也有DigiKey代购；此项仅作较快国内备选，不自动换补偿件 | 否
RT0805BRD0753K6L | R105 | ERA-6AEB5362V | 同0805、53.6kΩ、±0.1%、125mW、±25ppm/℃ | 代购候选 | https://item.szlcsc.com/details/Digikey/P53.6KDACT-ND.html | 17290 | 库存 | 1 | 8-14个工作日 | 保持R105阻值与精度；Panasonic ERA6A原厂表核对机械与电压额定，未改原工程 | 否
RC0805FR-0718K7L | R107 | 0805W8F1872T5E | 同0805、18.7kΩ、±1%、125mW；150V、±100ppm/℃ | 国内现货候选 | https://item.szlcsc.com/18187.html | 19800 | 现货 | 100 | 最快4小时发货 | R107为补偿器件，阻值不变；不得擅自以18k或20k代替 | 否
RC0805FR-071M3L | R809,R810 | 0805W8F1304T5E | 同0805、1.3MΩ、±1%、125mW；150V、±100ppm/℃ | 国内现货候选 | https://item.szlcsc.com/26852.html | 500 | 现货 | 100 | 最快4小时发货 | 对应R809/R810；高阻支路的漏电/噪声要求仍保留 | 否
XJHCELNANF-8M | Y201 | XJHCCLNANF-8.000000MHZ | 同TAITIEN XJ/HC-49S-SMD、8MHz、CL20pF、-40～85℃，初始/稳定度±20ppm | 同系列现货候选 | https://item.szlcsc.com/539042.html | 740 | 现货 | 5 | 最快4小时发货 | 原为±30ppm；温区不缩小。同系列机械初筛，ESR/驱动功率与启动裕量仍按原厂资料复核；未改晶振或负载电容 | 否
AP63203WU-7 | U102 | AP63203QWU-7 | 同TSOT26、固定3.3V、2A、1.1MHz、VIN3.8～32V | 备用但不适合小量 | https://item.szlcsc.com/5961413.html | 3000 | 库存 | 3000 | 31-33个工作日 | 汽车级备选，不能以型号相近就认定已逐脚验收；立创该条目MOQ3000、交期31–33工作日，不推荐首板为此采购整盘；优先原AP63203代购 | 否
未混入候选的近似件
型号 | 原因 | 结论
AR02BTC5362 | 0402，不是R105所需0805 | 排除
XJHBBCNANF-8.000000MHZ | 温区-20～70℃，缩小于原-40～85℃ | 不推荐等效替代
AP63205WU-7 | 固定5V，不是AP63203的3.3V | 排除
SPA06-003 | 不是SPL06-001；未据此更换冻结气压计或承诺驱动相同 | 保持原型
本页所有替代均仅为候选。原AP63203有MOQ23的代购通道，优先保留原型，APQ的MOQ3000不适合首板。
资料：各行实际商品页；R105另核Panasonic ERA A原厂规格。晶振同系列同温区初筛；ESR/驱动/启动等仍沿用原设计要求。
