chen123037/X100-Flight-Controller-Edu/docs/PROCUREMENT_GUIDE.md

# 当前器件采购入口

当前采用[六层V4的采购清单](../hardware/current/X100_6L_DFM_ZERO_DANGER/procurement/)，每板142个器件实例、62种完整MPN。

- [Excel](../hardware/current/X100_6L_DFM_ZERO_DANGER/procurement/X100_当前淘宝器件清单.xlsx)：B4改采购板数，数量自动重算。
- [62种型号汇总](../hardware/current/X100_6L_DFM_ZERO_DANGER/procurement/淘宝采购汇总_62种.csv)和[142位号明细](../hardware/current/X100_6L_DFM_ZERO_DANGER/procurement/器件位号明细_142项.csv)。
- [线束、卡和安装件](../hardware/current/X100_6L_DFM_ZERO_DANGER/procurement/配套线束及另购事项.csv)另列；不把26TP、4孔、JP601或J808板上焊线焊盘买成电子元件。

清单核对当前源图的厂家/完整MPN/值/封装，未核验淘宝店铺、价格、库存、批次或真伪。不得因搜索到“相似型号”直接替换冻结件；R105当前53.6k0.1%和大封装D103尤其要核对。C121/R105/U105/U106保留候选原字段，结合已有人工裁决核对，不把本清单当作新采购批准。

`bom/`原有X100_V1文件是旧45mm基线，c8采购表是历史240封装阶段；均不覆盖上面的当前清单。完整型号、1板用量、淘宝搜索入口及配套依据以当前清单为准。
