chen123037/X100-Flight-Controller-Edu/hardware/current/X100_6L_DFM_ZERO_DANGER/manufacturing/嘉立创下单参数与六孔说明.md

[六孔板厂定位图](../images/U101六孔_板厂定位图.png) · [本目录制造ZIP](X100_6L_DFM_gap_silk_v4.zip)

# X100 嘉立创下单参数与 U101 六孔说明

## 当前结论

468 条黄色提示不要求全部改为绿色。当前精确 Gerber ZIP 的 PCB DFM 所报危险为 0，ERC 为 0，KiCad 电气错误、未连接和一致性差异为 0。

可以把这份文件提交板厂进行工艺审稿。项目原先要求的完整制造放行仍未完成：现有 U101/D103 整板热审查没有签署通过。这个缺口包含投板前的热设计判断，不能简单当成“以后实测即可”，也不能由 DFM 零危险代替。如果选择先制作验证样板，应明确仍存在这项未闭合的设计风险。

本说明没有改 PCB、Gerber、钻孔、BOM 或封装。

## 填写参数

| 界面项目 | 本板填写 |
|---|---|
| 文件 | X100_6L_DFM_gap_silk_v4.zip |
| 文件校验 | SHA256 85254aca1ba4356953ddff8653cff87964dce0b77bb30dd6c1584126908b1bfc |
| 板材 | FR-4，使用指定叠层对应材料 |
| 层数 | 6 层 |
| 板厚 | 1.6 mm |
| 层压结构 | JLC06161H-3313，不自动换为 7628 |
| 外层完成铜厚 | 1 oz |
| 内层铜厚 | 0.5 oz，与指定叠层一致 |
| 表面处理 | 沉金 ENIG，常规金厚；不要按报告表头的默认喷锡填写 |
| 阻焊/字符颜色 | 绿油、白字 |
| 字符工艺 | 高精字符，本板部分字高为 0.8 mm；不要按普通字符的 1.0 mm 下限直接放大或删字 |
| 最小钻孔 | 0.20 mm；不是全部孔均为 0.30 mm |
| 最小线宽/线距 | 按文件识别；若必须选档，4/4 mil 或能覆盖该文件的更细工艺，不能选 6/6 mil |
| 过孔工艺 | 树脂塞孔＋电镀盖帽/填平（盘中孔工艺）；见下一节 |
| 过孔表面阻焊 | 按 Gerber；普通过孔盖油，U101.9 散热焊盘按文件开窗并保持可焊 |
| 外形 | 按 Gerber 异形外框，含四个安装耳，外廓约 70×52 mm；不要改成实心矩形 |
| 外形成型 | 如有精锣选项，采用精锣，保留板框、安装孔和连接器位置 |
| 拼板/出货 | 裸 PCB 可选单片出货；后续 SMT 工艺边、拼板另作装联审稿 |
| 电测 | 选择电测/飞针测试，不取消测试 |
| 阻抗相关 | 指定上述叠层，USB 差分目标 90 Ω；涉及工程改线宽/间距时先提供生产稿确认，不直接改已提交文件 |
| 半孔/盲埋孔/HDI/金手指 | 本设计无这些工艺，不因盘中孔而改选 HDI |
| 数量 | 按实际需要；本表不代替数量与价格确认 |

官方叠层查询：https://www.jlc.com/portal/server_guide_36372.html

官方字符规范：https://m.jlc.com/portal/t6i10417.html 。其中高精字符允许最小字高 0.8 mm、线宽 0.1 mm；本板采用高精字符的原因是已有部分 0.8 mm 字高。

## 树脂塞孔和电镀盖帽怎么选

嘉立创当前官方能力表写明：六层及以上多层板过孔默认“过孔塞树脂＋电镀盖帽”。因此页面可能以六层默认工艺体现，不一定提供“只塞六颗”的单独按钮。下单时选包含“树脂塞孔＋电镀盖帽/盘中孔”的工艺，并在工程审稿中明确实际填孔范围；不能把默认全板处理范围误认为只处理六颗。

官方能力表：https://www.jlc.com/portal/vtechnology.html

官方过孔加工说明：https://www.jlc.com/portal/server_guide_15544.html

这三个属性应分别理解：

1. 孔内：树脂填充。
2. 孔口：电镀铜盖帽并填平，形成可焊表面。
3. 最外面：是否盖阻焊油墨，按 Gerber 开窗决定。

“盖油”不能代替“树脂填充＋电镀盖帽”。六颗 U101 孔都在 B 面 U101.9 的 GND 散热焊盘内，最终散热焊盘要平整、连续、可焊，不能把整个散热焊盘盖油。

附件 `U101六孔_板厂定位图.png` 从本次已检查 PCB 的原生几何生成，采用正面俯视投影；底面器件不镜像。坐标对照如下，单位 mm：

| 编号 | KiCad X | KiCad Y 向下 | 原钻孔文件 X | 原钻孔文件 Y |
|---|---:|---:|---:|---:|
| 1 | 89.5 | 99.7 | 89.5 | -99.7 |
| 2 | 90.5 | 100.9 | 90.5 | -100.9 |
| 3 | 89.5 | 102.1 | 89.5 | -102.1 |
| 4 | 90.5 | 102.1 | 90.5 | -102.1 |
| 5 | 89.5 | 103.3 | 89.5 | -103.3 |
| 6 | 90.5 | 103.3 | 90.5 | -103.3 |

六颗均为钻孔 Ø0.30 mm、铜盘 Ø0.60 mm、GND 网络。坐标以原文件为准；工厂若改拼板原点，应按附件所在器件和六孔图样对应，不能直接套用平移前坐标。

四个 Ø4.0 mm NPTH 安装孔、排针/连接器插孔和 J401 固定槽必须保持通畅。J401 0.45 mm 镀铜固定槽保持原 Gerber 尺寸，不为通用 DFM 阈值主动加大。其它小过孔若按六层默认树脂填孔，应由工厂列明范围，并保持原 Gerber 的盖油和开窗要求。

## 可复制到下单备注

> X100 六层验证样板。1.6 mm，外层1 oz、内层0.5 oz，指定 JLC06161H-3313，绿油白字，沉金，高精字符。B 面 U101.9 的六颗 GND 散热孔（钻孔Ø0.30/铜盘Ø0.60，见附件编号1–6）必须树脂塞孔＋电镀盖帽填平，保证散热焊盘平整连续可焊，普通盖油或塞油不能替代。请确认六层默认填孔的实际范围。安装孔、排针/连接器插孔及USB固定槽保持通畅；J401固定槽0.45 mm按原文件，不加大。铜层、开窗、极性及方向标记按Gerber制作，需调整时先提供生产稿确认。

## 黄色提示怎么处理

| 软件所报类别 | 处理方式 |
|---|---|
| 孔环 300 条 | 当前普通过孔为0.60/0.30、USB两孔为0.50/0.20，名义径向环宽均0.15 mm；不需要为了消除黄色批量扩大铜盘。按实际孔型与板厂工艺审稿。 |
| 丝印线宽 100 条 | 保留现有丝印，选择高精字符工艺；不需要重新移动器件。 |
| 孔落焊盘 6 条 | 对应 U101 已批准的六孔，必须实现上面的填孔盖帽工艺，不能仅“忽略”。 |
| 槽宽 4 条 | 保留 J401 原厂0.45 mm槽。官方多层板最小有铜槽宽0.35 mm；本轮已按此复检。 |
| Pth无Pad 8 条 | 报告该行引用 NPTH 文件；本包 NPTH 文件只有四个Ø4安装孔。保留非金属化安装孔，不因这项提示补铜或改成电镀孔。 |
| 负开窗 25 条 | 由工厂按原阻焊文件与当前1:1开窗能力核对，不统一放大所有开窗。 |
| 其余间距、开窗、锐角等 25 条 | 保留在审稿清单；不能仅凭“黄色”一概说没有风险，也不需要机械地全部改成绿色。 |

所有数量为软件显示计数，并非独立物理对象总数。本指导没有把剩余黄色项逐条标记为最终接受。

## 尚未完成的设计结论

现有电源审查仍为 `POWER_SAFETY_REVIEW = NOT_SIGNED_OFF`。6S、高负载及保留环境条件下，U101/D103 的整板热扩散、互热和有效热阻没有完成工程接受；不能把“没有新证据要求改器件”写成“热设计已经通过”。DFM 零危险也不能覆盖该缺口。

本说明提供工艺填写和板厂审稿依据，不将项目完整制造放行或飞行能力预先标为 PASS。裸PCB、SMT装联和首板功能/温升/无桨测试应分别记录结果。
