chen123037/X100-Flight-Controller-Edu/hardware/current/X100_6L_DFM_ZERO_DANGER/manufacturing/CPL_REVIEW_NOTE.md

# 当前CPL原生导出

本目录CPL_native_all_REVIEW_ONLY.csv直接读取当前PCB导出，单位mm、绝对原点、两面、底面不人为取反X。当前R113坐标已随源更新；旧CPL不适用。

它仍是装联审稿资料，不代表已通过贴片方吸附原点、角度定义、顶/底面和实物来料核对；测试点/焊盘等排除、SMT/混合件与手焊排针分类需结合当前采购表，不直接把全部位置行当作贴片订单。
