chen123037/X100-Flight-Controller-Edu/docs/evidence/USB_CLOCK_FEASIBILITY_20261022/result.txt

original_400=0 original_200=1 candidate_200=0 candidate_400=0
