chen123037/X100-Flight-Controller-Edu/docs/history/pre_6L_DFM/HISTORY_NOTE.md

# 历史入口快照

本目录保存更新六层DFM零危险入口前的README、STATUS、HANDOFF及相关文档原文。它们的相对链接原本从仓库根目录或docs解析，历史引用不作为当前导航。

当前入口为[六层工程](../../../hardware/current/X100_6L_DFM_ZERO_DANGER/)。c8工程本体仍在hardware/reviews/X100_C8_LAYOUT_REVIEW，旧45mm正式源仍在hardware/X100_V1；本次未覆盖。
