chen123037/X100-Flight-Controller-Edu/docs/history/pre_6L_DFM/HANDOFF.md

# X100 接手与独立评审

**当前从[c8评审工程](hardware/reviews/X100_C8_LAYOUT_REVIEW/01_KiCad工程_c8/X100_CleanSheet.kicad_pro)开始，不从旧hardware/X100_V1开始。** 下载[ZIP](hardware/reviews/X100_C8_LAYOUT_REVIEW/download/X100_中文评审包_c8.zip)后解压，先读00开头的中文PDF，再打开工程。使用KiCad10.0.6或兼容更新版本及官方标准库；本地自定义库随包。

本次给外部人员的任务是独立评审可布性、电源布局和具体修改方向，不默认委托立即改板或授权制造。完整[中文指引](hardware/reviews/X100_C8_LAYOUT_REVIEW/00_先读我_中文评审指引.md)、[邀请文字/反馈模板](hardware/reviews/X100_C8_LAYOUT_REVIEW/04_评审反馈/)以及[当前状态](STATUS.md)均已准备。

请优先看主Buck与MCU出线、U104/U105的共用5V干线、U109与USB/SD协同位置，并给草图或具体通道建议。不要把所有器件位置或旧铜线当成物理冻结；也不要单独拉远D103、用长SW线换空间。若必须变更器件、板框、层数或测试点数量，请说明具体必要性，先建议、再由负责人裁决。

保持既定50×50主体及安装耳/孔、四层、240总封装含65测试点、冻结选型和功能；In1连续GND，In2不全面开放，标准0.60/0.30过孔，clearance0.20、最小线宽0.15、孔间距0.45、foreign PTH孔铜0.35及全局板边0.50mm。实际既有局部规则见c8 DRU，不能泛化或全局放宽。J401及L101批准型号不再重复询问；35个USB供电候选并未因此全部正式采用。

若后续承接设计，应与负责人明确修改方式/授权；AI阶段仍遵守plant_kicad_v1执行约束。任何修改在新副本进行，保留c8/c7回退；动过的关键网络、功率/回流、USB模型、晶振/VCAP及装配均重查，不能沿用旧PASS。旧正式源及采购表不由此自动升级。

按[新路线图](docs/ROADMAP.md)推进到完整布线与制造审查；生成制造文件不等于允许采购、付款或下单。当前没有可制造版本。
