chen123037/X100-Flight-Controller-Edu/docs/history/pre_6L_DFM/docs/ROADMAP.md

# X100 后续推进路线图

当前是c8布局/布线未完成、独立评审待进行；不是制造或飞行放行。[最新状态](../STATUS.md) / [接手入口](../HANDOFF.md)。

1. **独立布局评审。** 保持现有主体、四层和器件，判断主Buck/MCU/U109区域如何协同调整；给出具体摆放或通道建议。失败路由实验不是不可布证明。
2. **明确实施范围并重排。** 在新副本按评审结果调整布局、相关功率铜和必要信号，保留c8/c7；不把旧线当正确性依据，不删功能或全局降规则。重大器件/架构/制造变更另裁决。
3. **完成全部连接。** 关闭96项余线，先供电/启动/复位及关键回流，再传感器、SD/CAN/ADC和其余接口；每阶段源文件读回、KiCad检查和checkpoint。
4. **设计与候选接受。** 闭合电源最差负载、限流/反灌/切换、压降/热/回流、HSE、VCAP、USB SI与参考平面；明确35个USB供电候选的最终接受。资料估算与实测分开，缺实板的动态项目纳入首板计划。
5. **完整制造审查。** fresh ERC/DRC/parity、所有开路/铜区/丝印/装配疑点、插拔/支撑/焊接和探针、BOM/封装/面别、JLC3313实际CAM与下单参数。不能把199类别截断误当实际总数。
6. **制造包与人工验收。** 生成并独立复核Gerber/钻孔/制造说明及必要BOM/CPL，证据充分才标READY_FOR_HUMAN_FABRICATION_APPROVAL=YES，然后等待最终确认。不自动下单或付款。
7. **首板Bring-up、固件和台架。** 收料及断电检查、限流上电、USB枚举/电流/挂起/源切换、传感器/SD/CAN/IO测试及ArduPilot板级适配。静态编译和CAD通过不证明实板行为。
8. **集成与飞行。** 机械/线束、EMI/振动、去桨地面台架、故障安全及人工批准的分级试飞，保留各自证据边界。

旧Stage表保存在[历史路线图](history/pre_c8/ROADMAP_5a6129b.md)，不再把其中“尚未开始布线/45mm孔位不得改”等历史状态用于阻断已授权工作。
