chen123037/X100-Flight-Controller-Edu/hardware/proposals/USB_CORE_STAGE3_NOT_APPROVED/CANDIDATE_SCHEMATIC_NOT_FOR_FAB.pdf

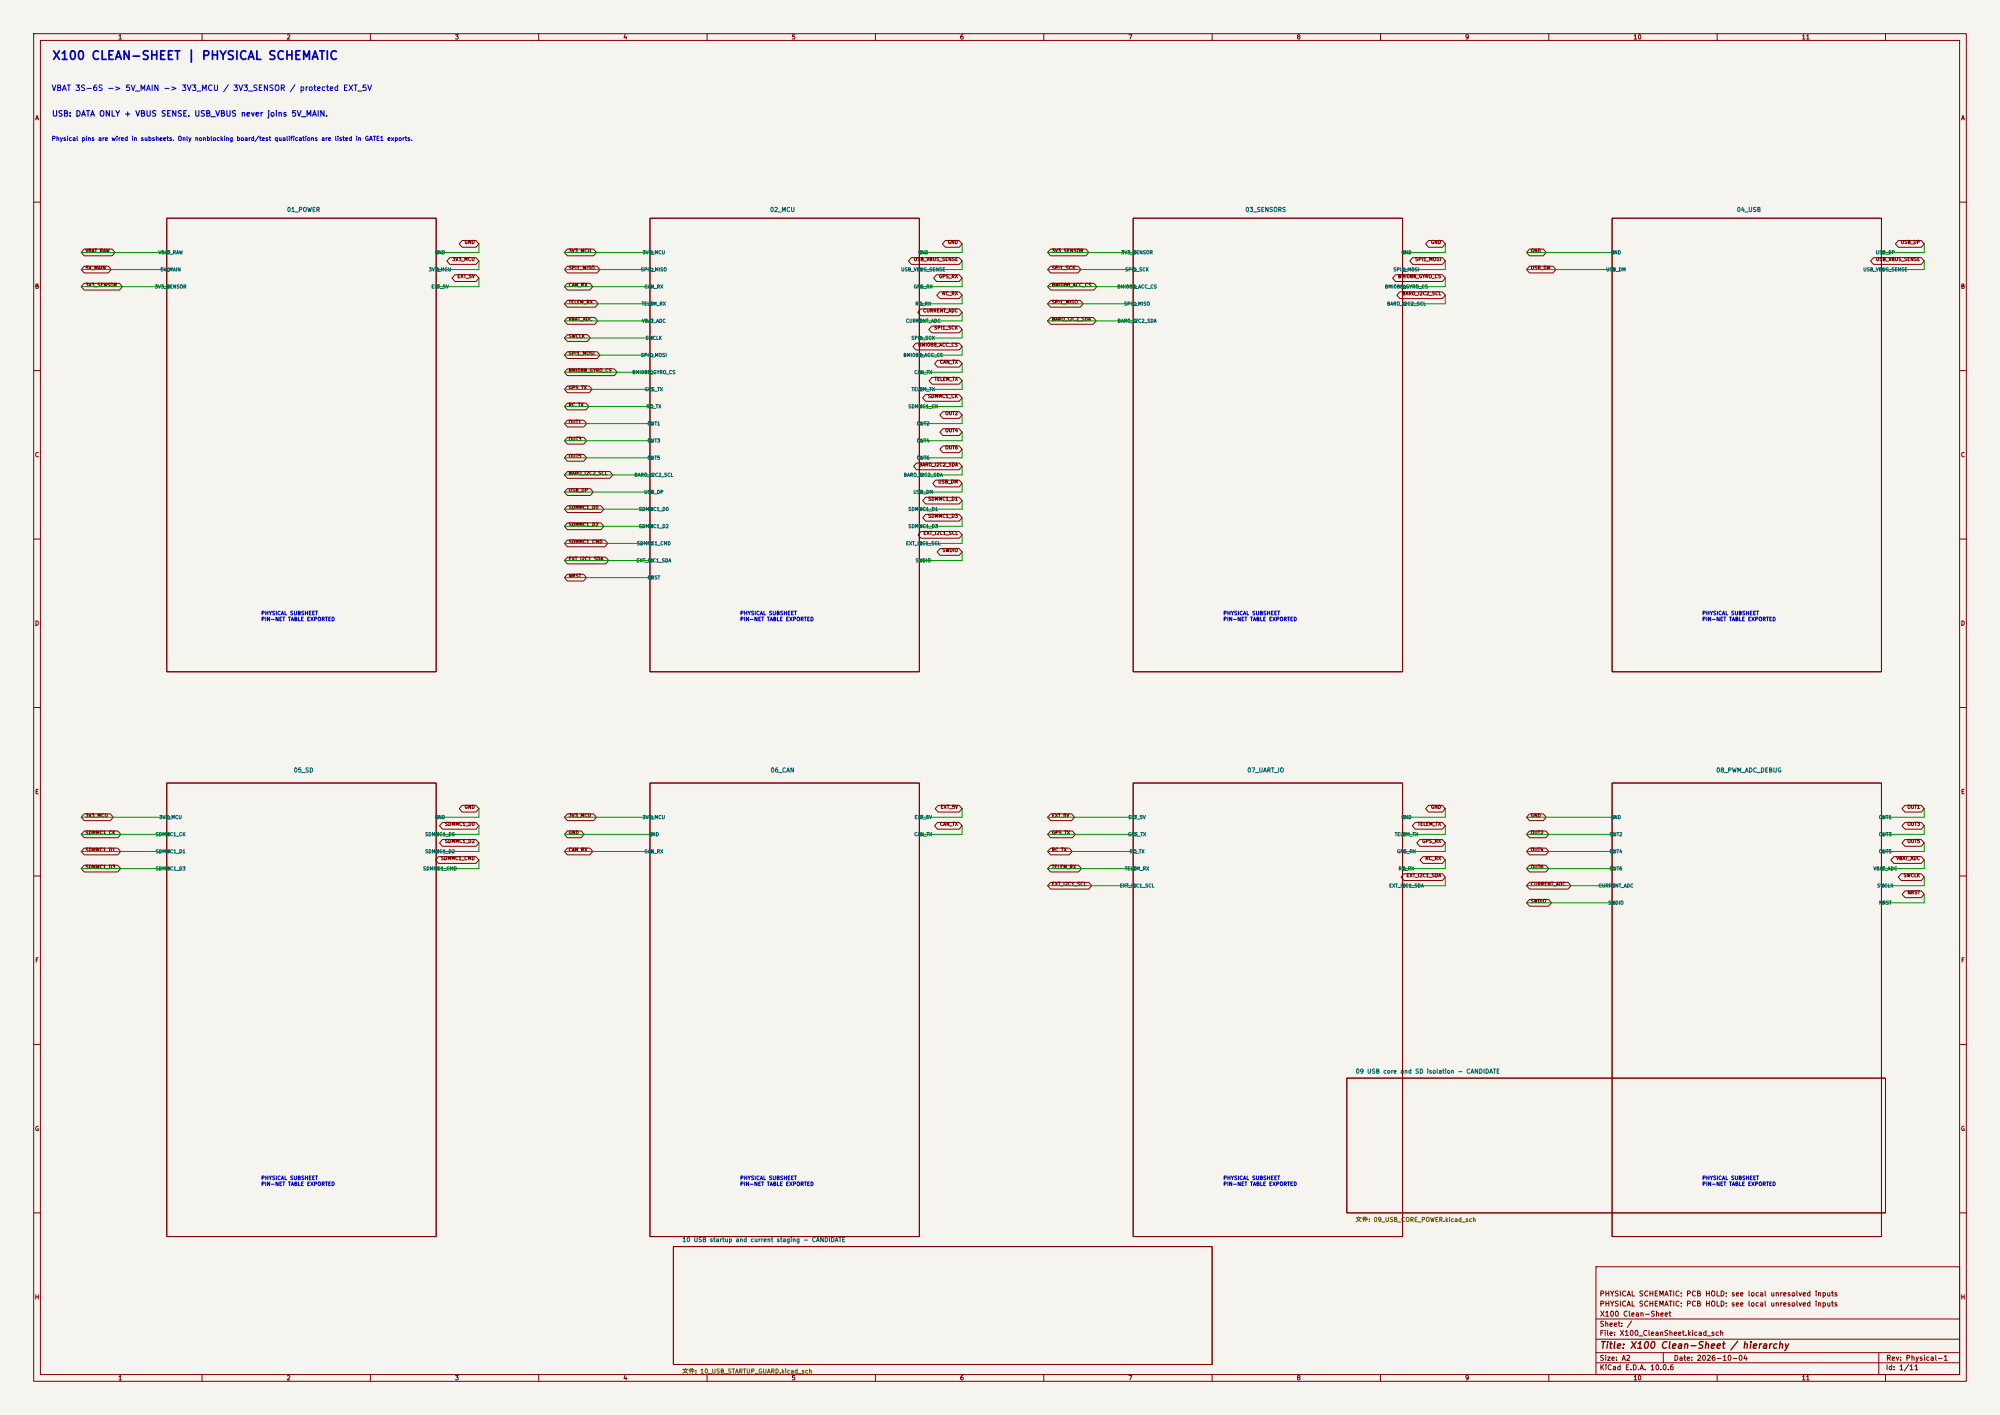
[picture p26: page 1]

X100 CLEAN-SHEET | PHYSICAL SCHEMATIC

USB: DATA ONLY + VBUS SENSE. USB_VBUS never joins 5V_MAIN.

Physical pins are wired in subsheets. Only nonblocking board/test qualifications are listed in GATE1 exports.

PHYSICAL SUBSHEET PIN-NET TABLE EXPORTED

09 USB core and SD isolation - CANDIDATE 文件: 09_USB_CORE_POWER.kicad_sch

10 USB startup and current staging - CANDIDATE 文件: 10_USB_STARTUP_GUARD.kicad_sch

PHYSICAL SCHEMATIC; PCB HOLD; see local unresolved inputs
X100 Clean-Sheet
Sheet: /
File: X100_CleanSheet.kicad_sch
Title: X100 Clean-Sheet / hierarchy

Size: A2 | Rev: Physical-1
KiCad E.D.A. 10.0.6 | Id: 1/11

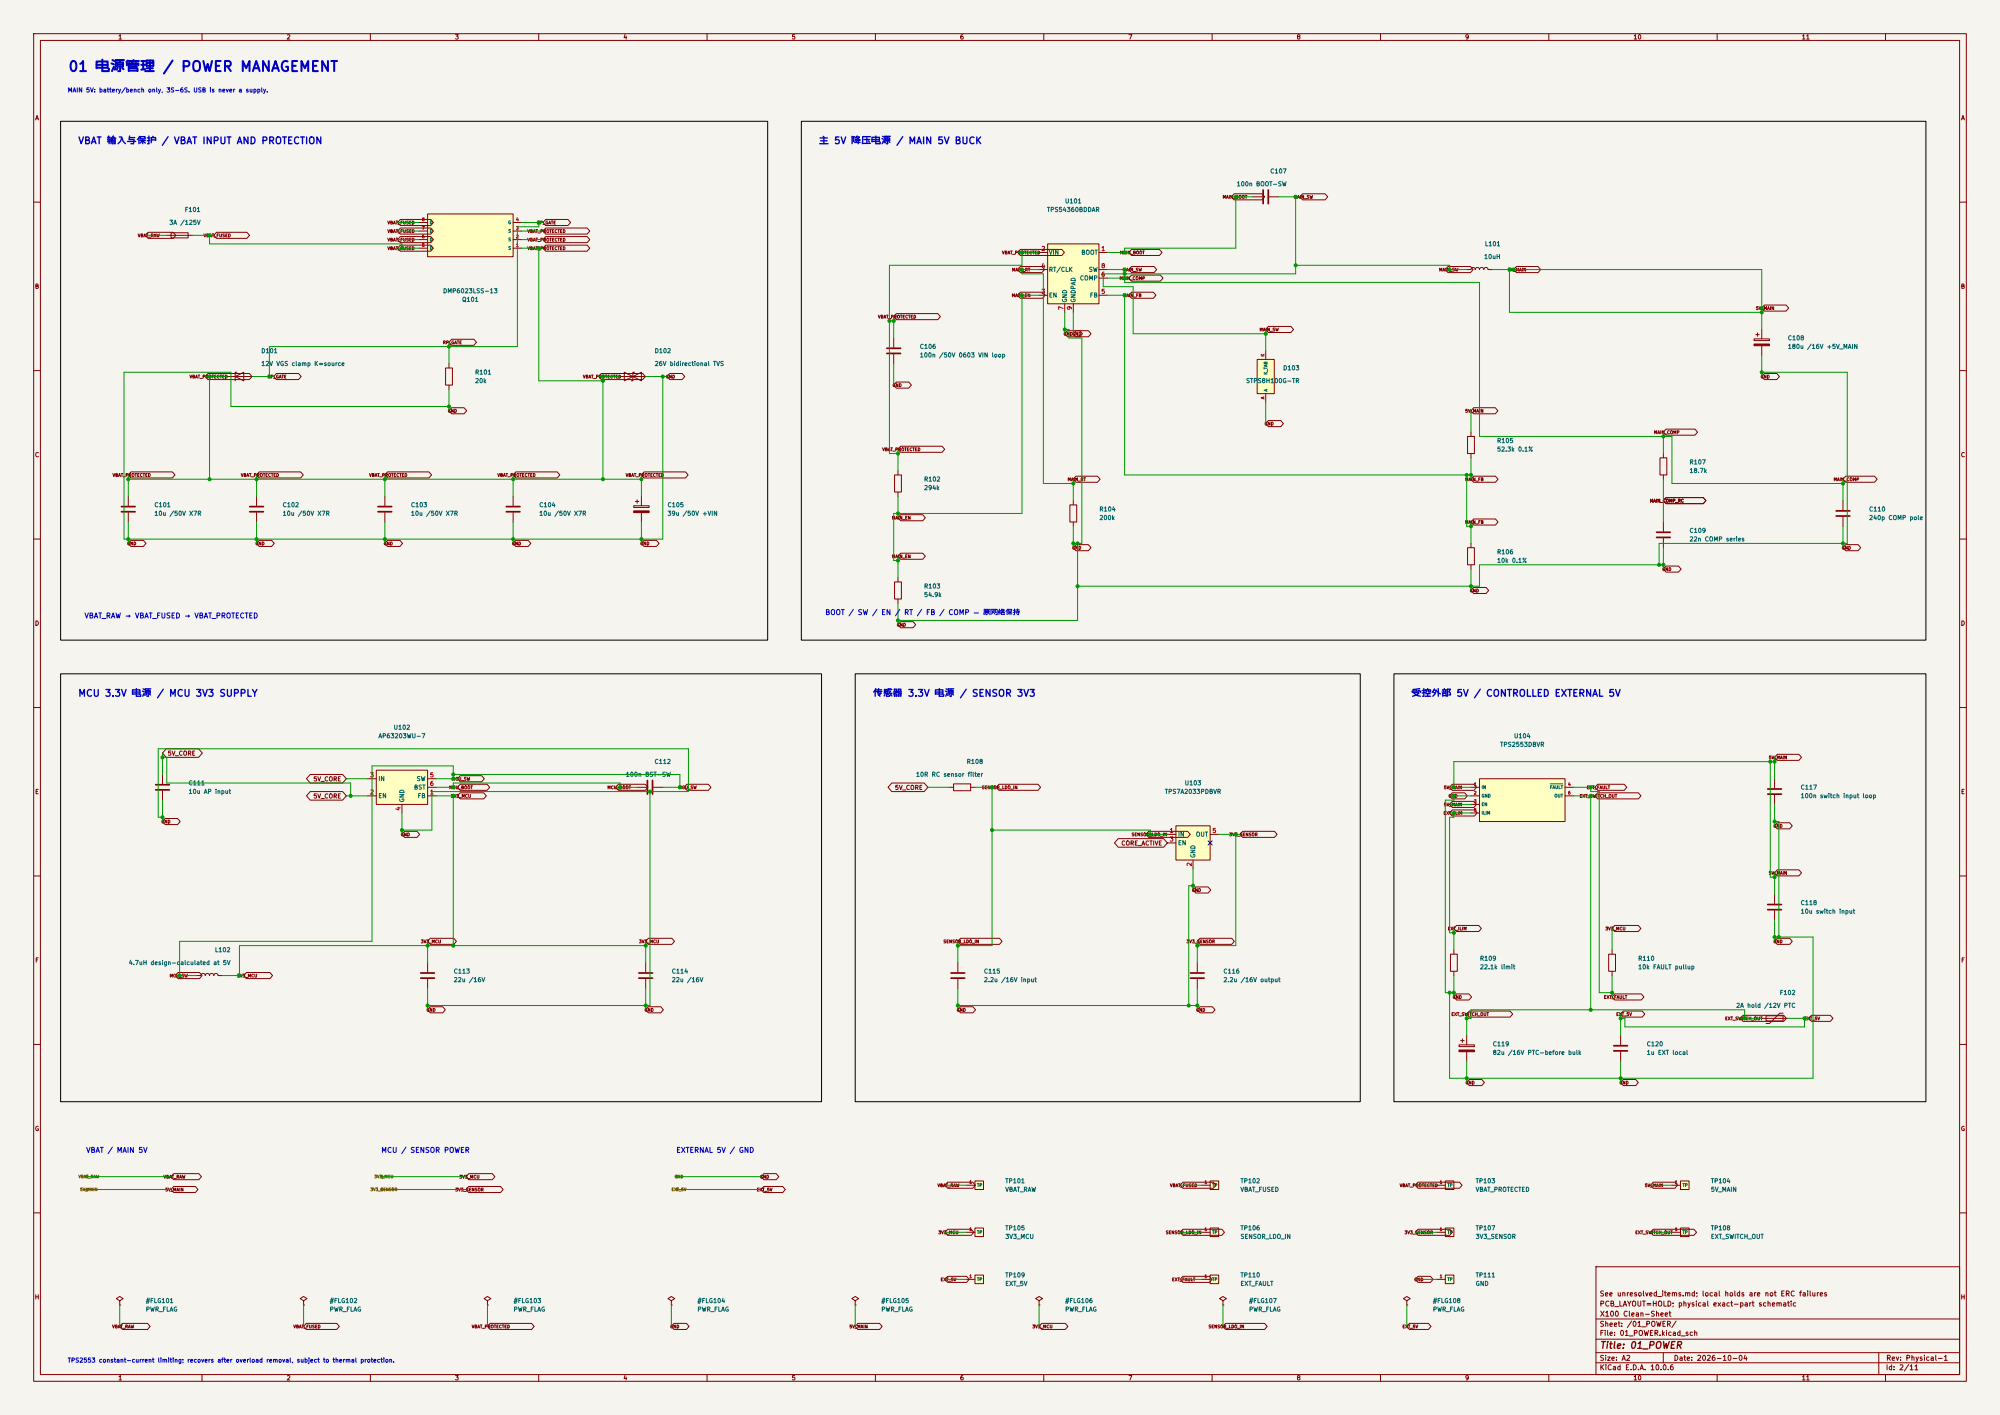
[picture p27: page 2]

MAIN 5V: battery/bench only, 3S-6S. USB is never a supply.

VBAT 输入与保护 / VBAT INPUT AND PROTECTION

BOOT / SW / EN / RT / FB / COMP — 原网络保持

See unresolved_items.md; local holds are not ERC failures
PCB_LAYOUT=HOLD; physical exact-part schematic

TPS2553 constant-current limiting; recovers after overload removal, subject to thermal protection.

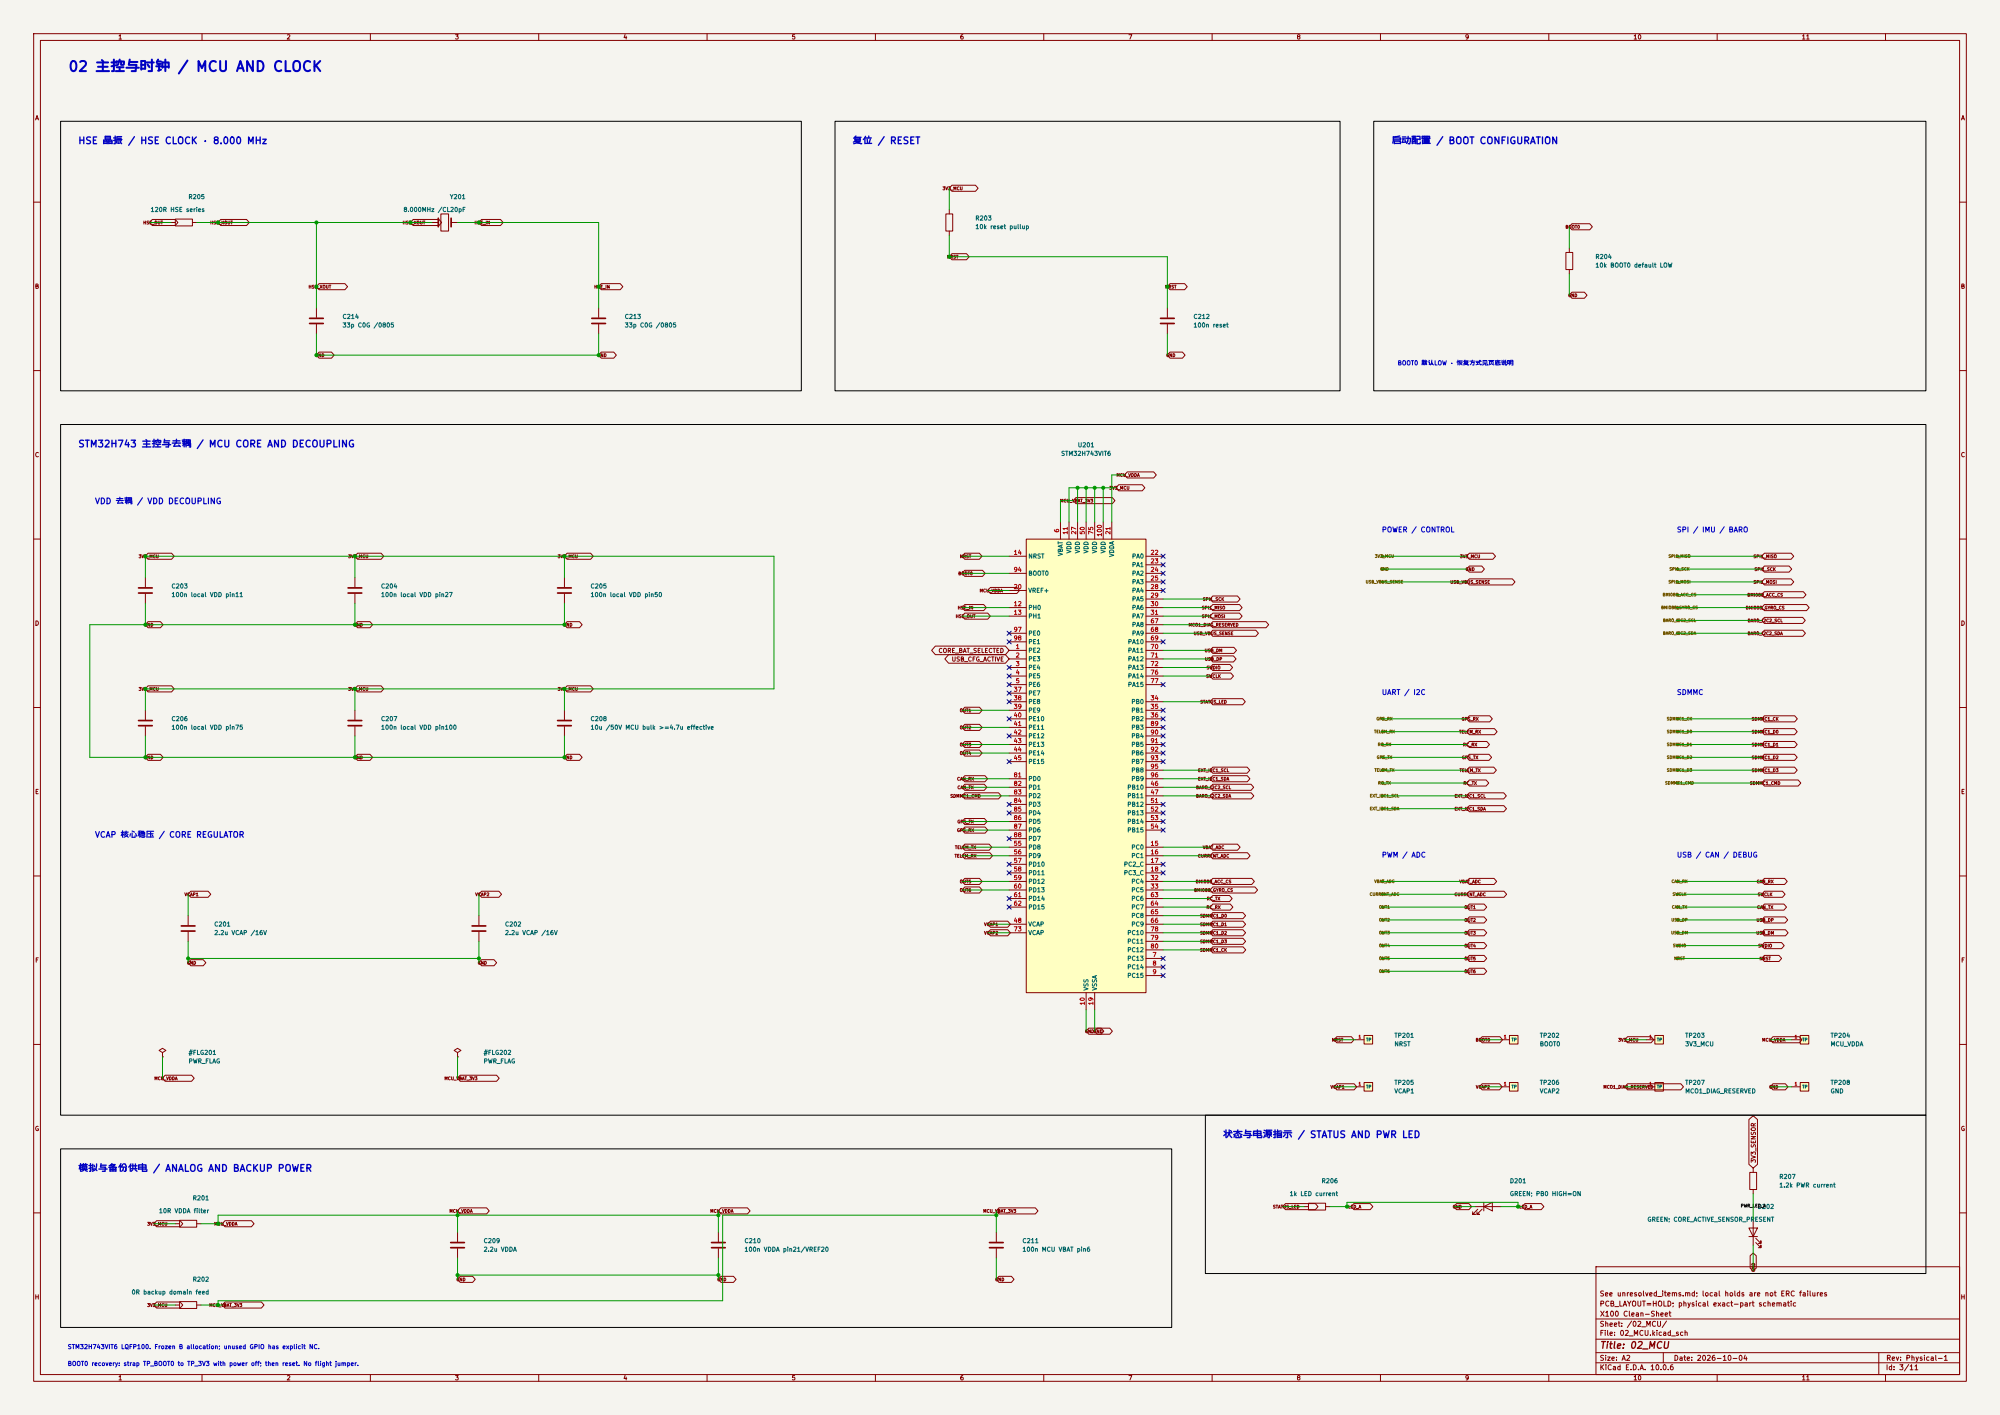
[picture p28: page 3]

02 主控与时钟 / MCU AND CLOCK

HSE 晶振 / HSE CLOCK · 8.000 MHz

STM32H743 主控与去耦 / MCU CORE AND DECOUPLING

VDD 去耦 / VDD DECOUPLING

VCAP 核心稳压 / CORE REGULATOR

状态与电源指示 / STATUS AND PWR LED

模拟与备份供电 / ANALOG AND BACKUP POWER

BOOT0 recovery: strap TP_BOOT0 to TP_3V3 with power off; then reset. No flight jumper. STM32H743VIT6 LQFP100. Frozen B allocation; unused GPIO has explicit NC.

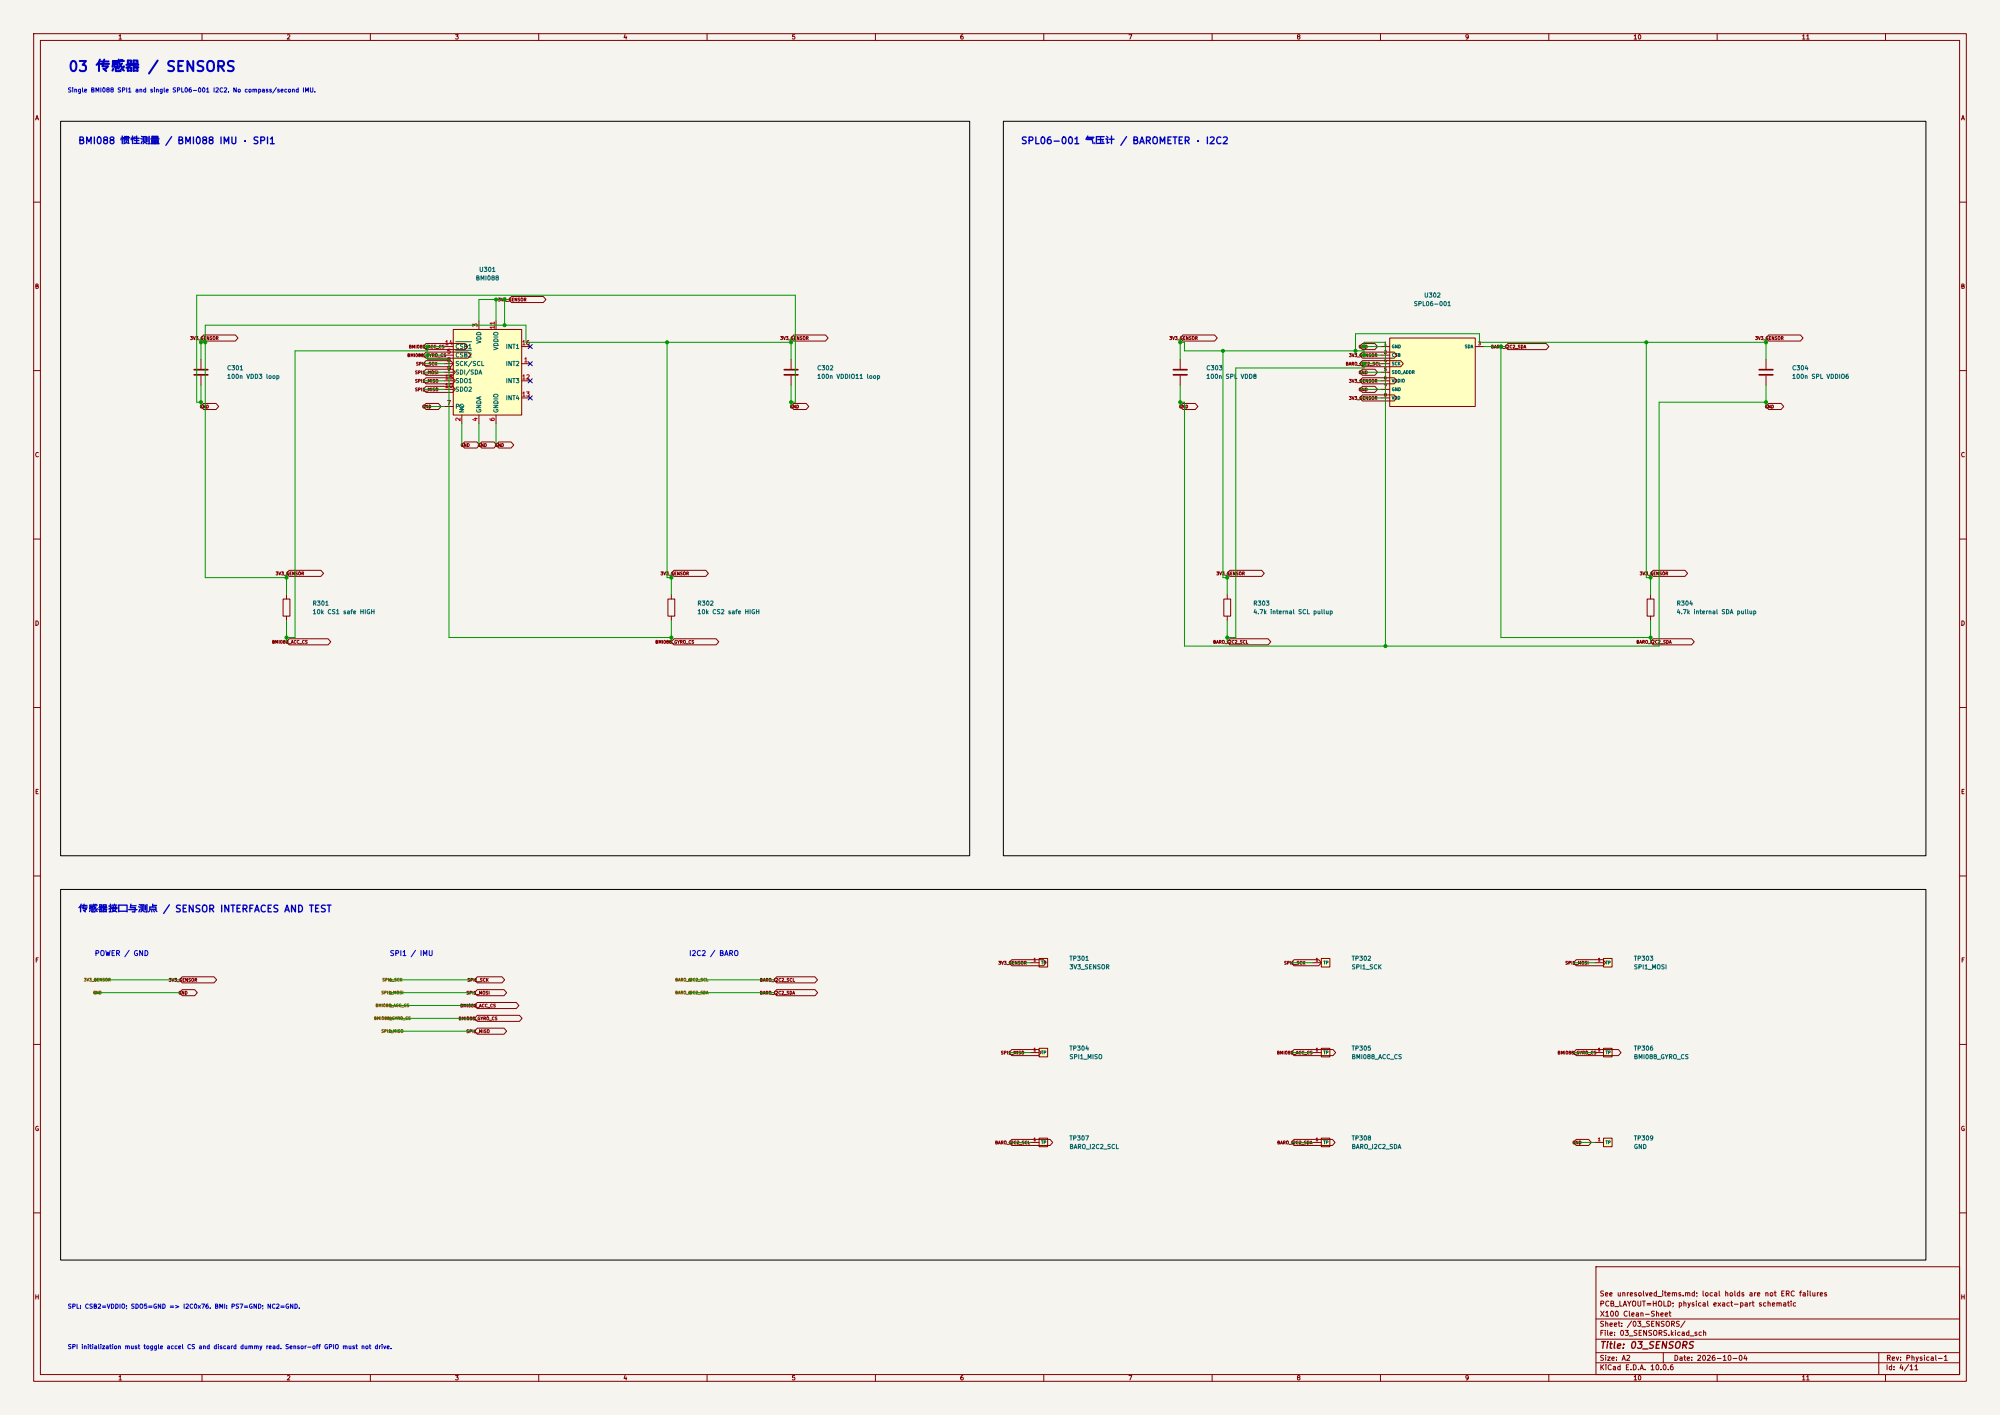
[picture p29: page 4]

Single BMI088 SPI1 and single SPL06-001 I2C2. No compass/second IMU. BMI088 惯性测量 / BMI088 IMU · SPI1

传感器接口与测点 / SENSOR INTERFACES AND TEST

SPL: CSB2=VDDIO; SDO5=GND => I2C0x76. BMI: PS7=GND; NC2=GND. SPI initialization must toggle accel CS and discard dummy read. Sensor-off GPIO must not drive.

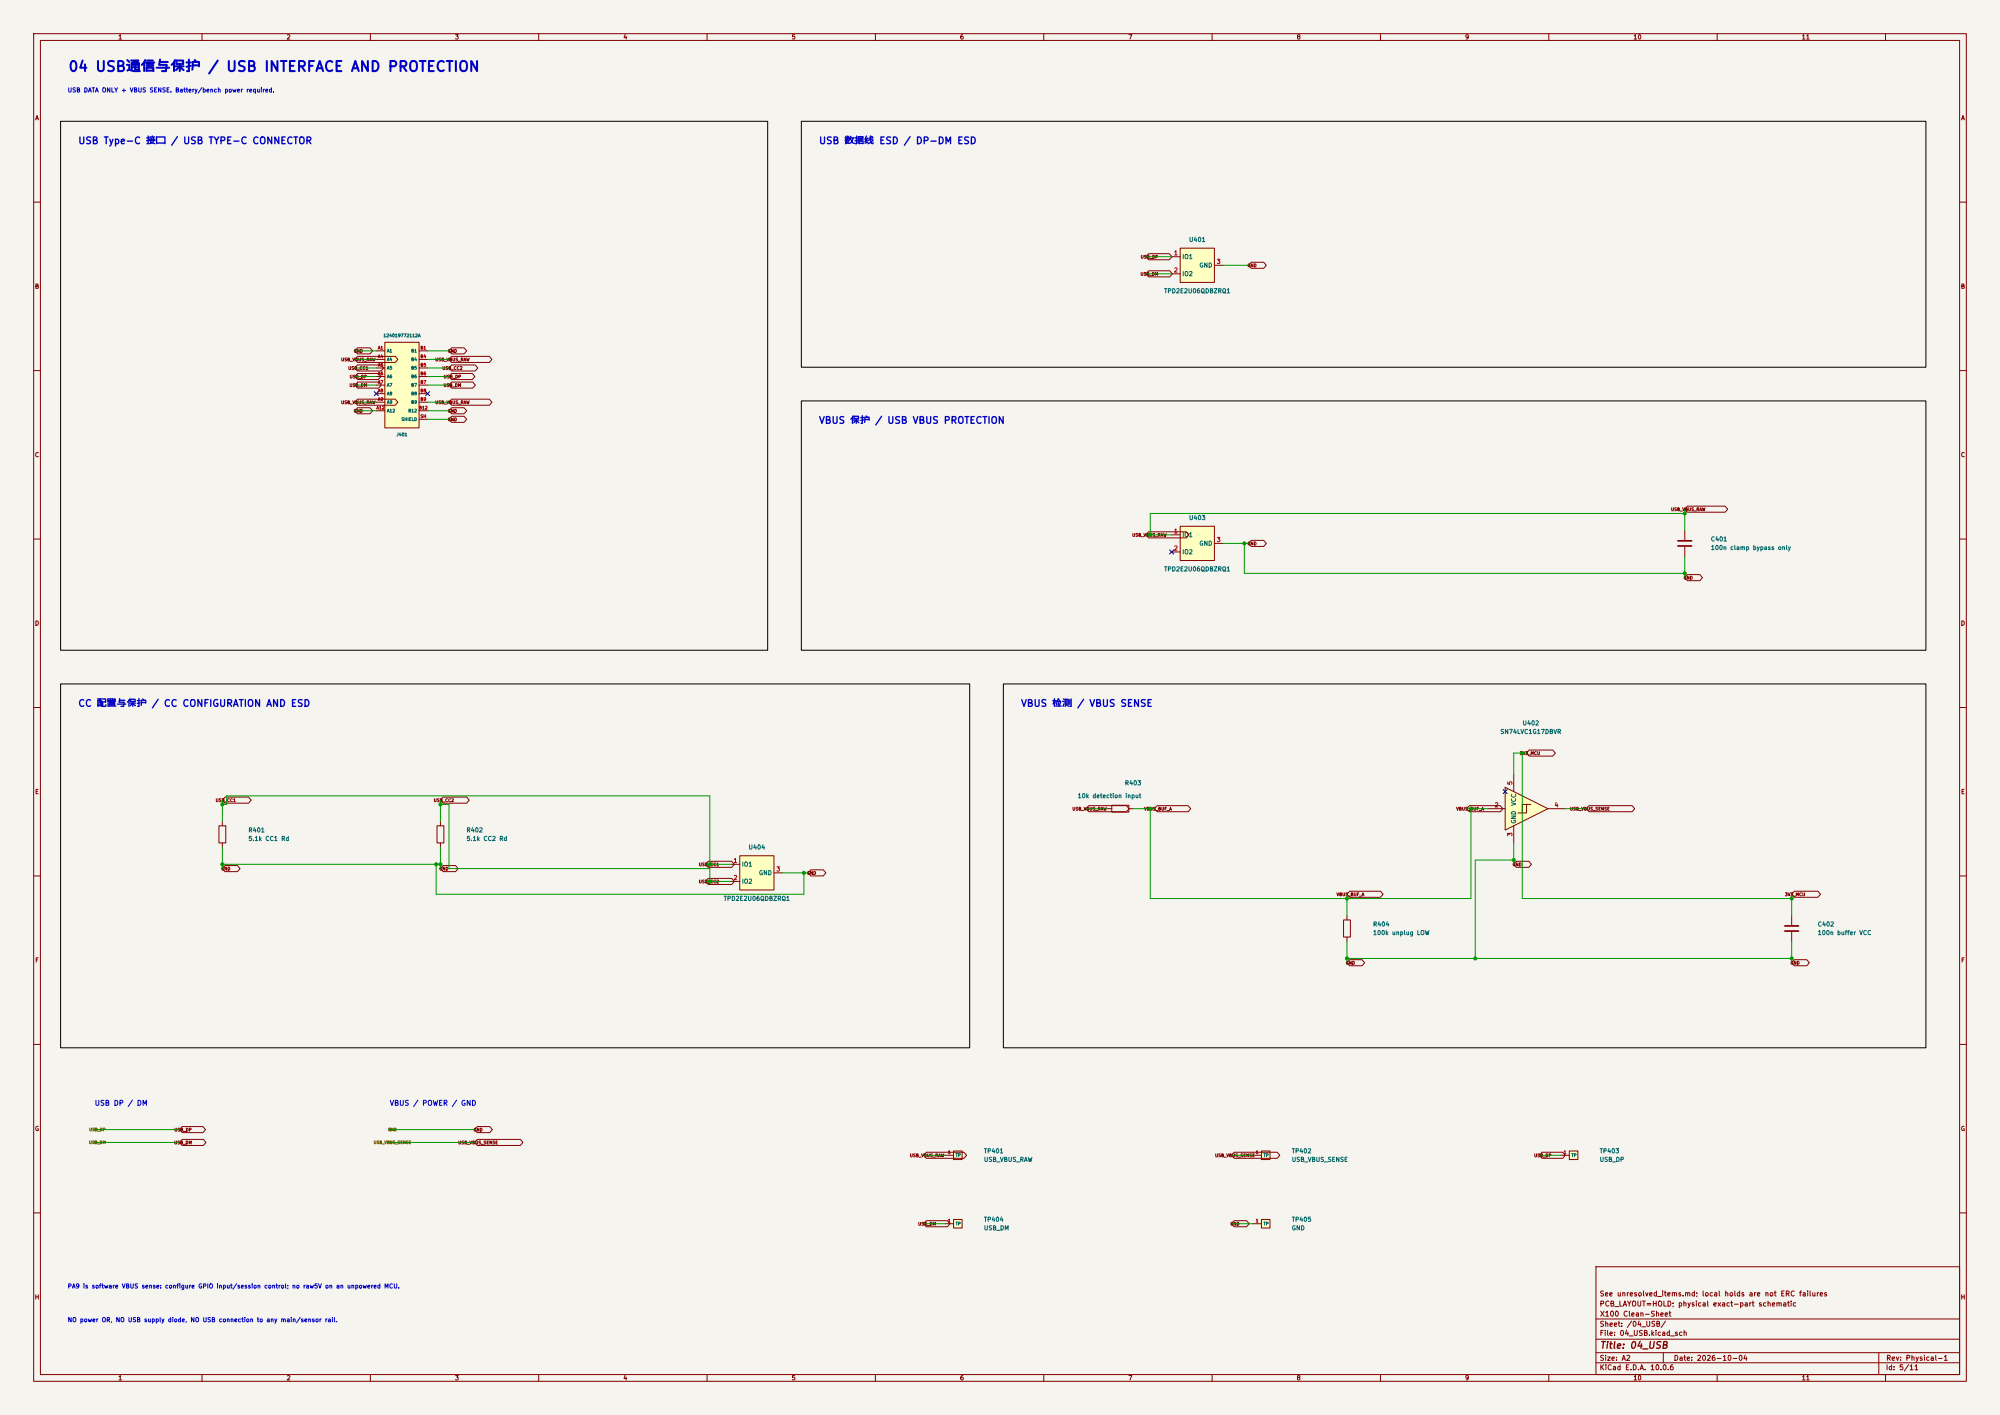
[picture p30: page 5]

04 USB通信与保护 / USB INTERFACE AND PROTECTION

USB DATA ONLY + VBUS SENSE. Battery/bench power required.

USB Type-C 接口 / USB TYPE-C CONNECTOR

USB 数据线 ESD / DP-DM ESD

VBUS 保护 / USB VBUS PROTECTION

PA9 is software VBUS sense: configure GPIO input/session control; no raw5V on an unpowered MCU.

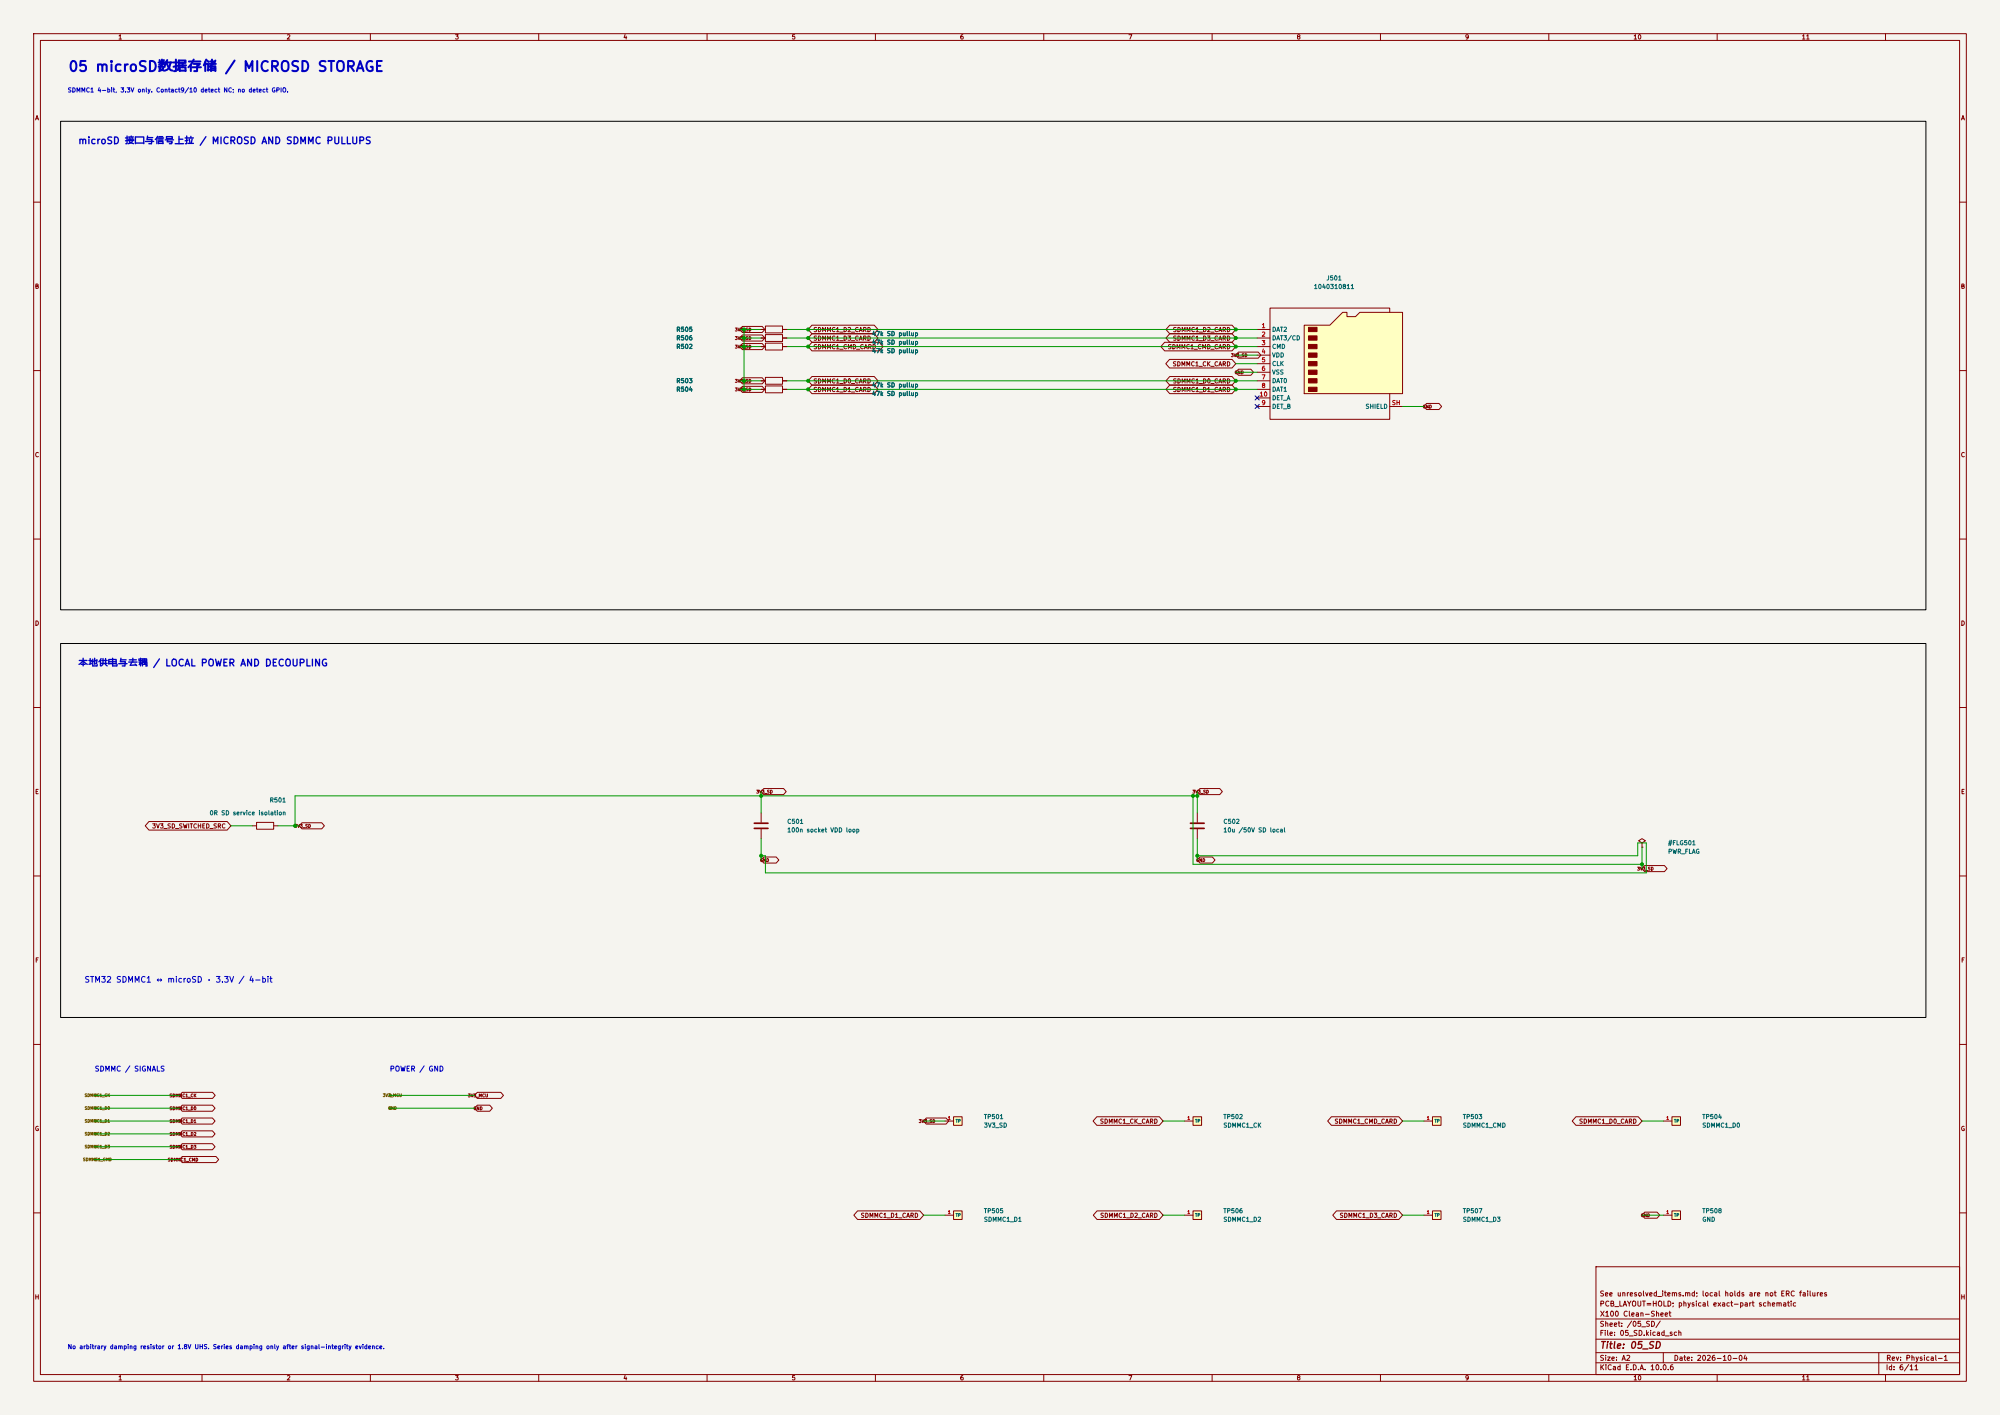
[picture p31: page 6]

SDMMC1 4-bit, 3.3V only. Contact9/10 detect NC; no detect GPIO. 05 microSD数据存储 / MICROSD STORAGE

microSD 接口与信号上拉 / MICROSD AND SDMMC PULLUPS

本地供电与去耦 / LOCAL POWER AND DECOUPLING

No arbitrary damping resistor or 1.8V UHS. Series damping only after signal-integrity evidence. STM32 SDMMC1 ↔ microSD · 3.3V / 4-bit

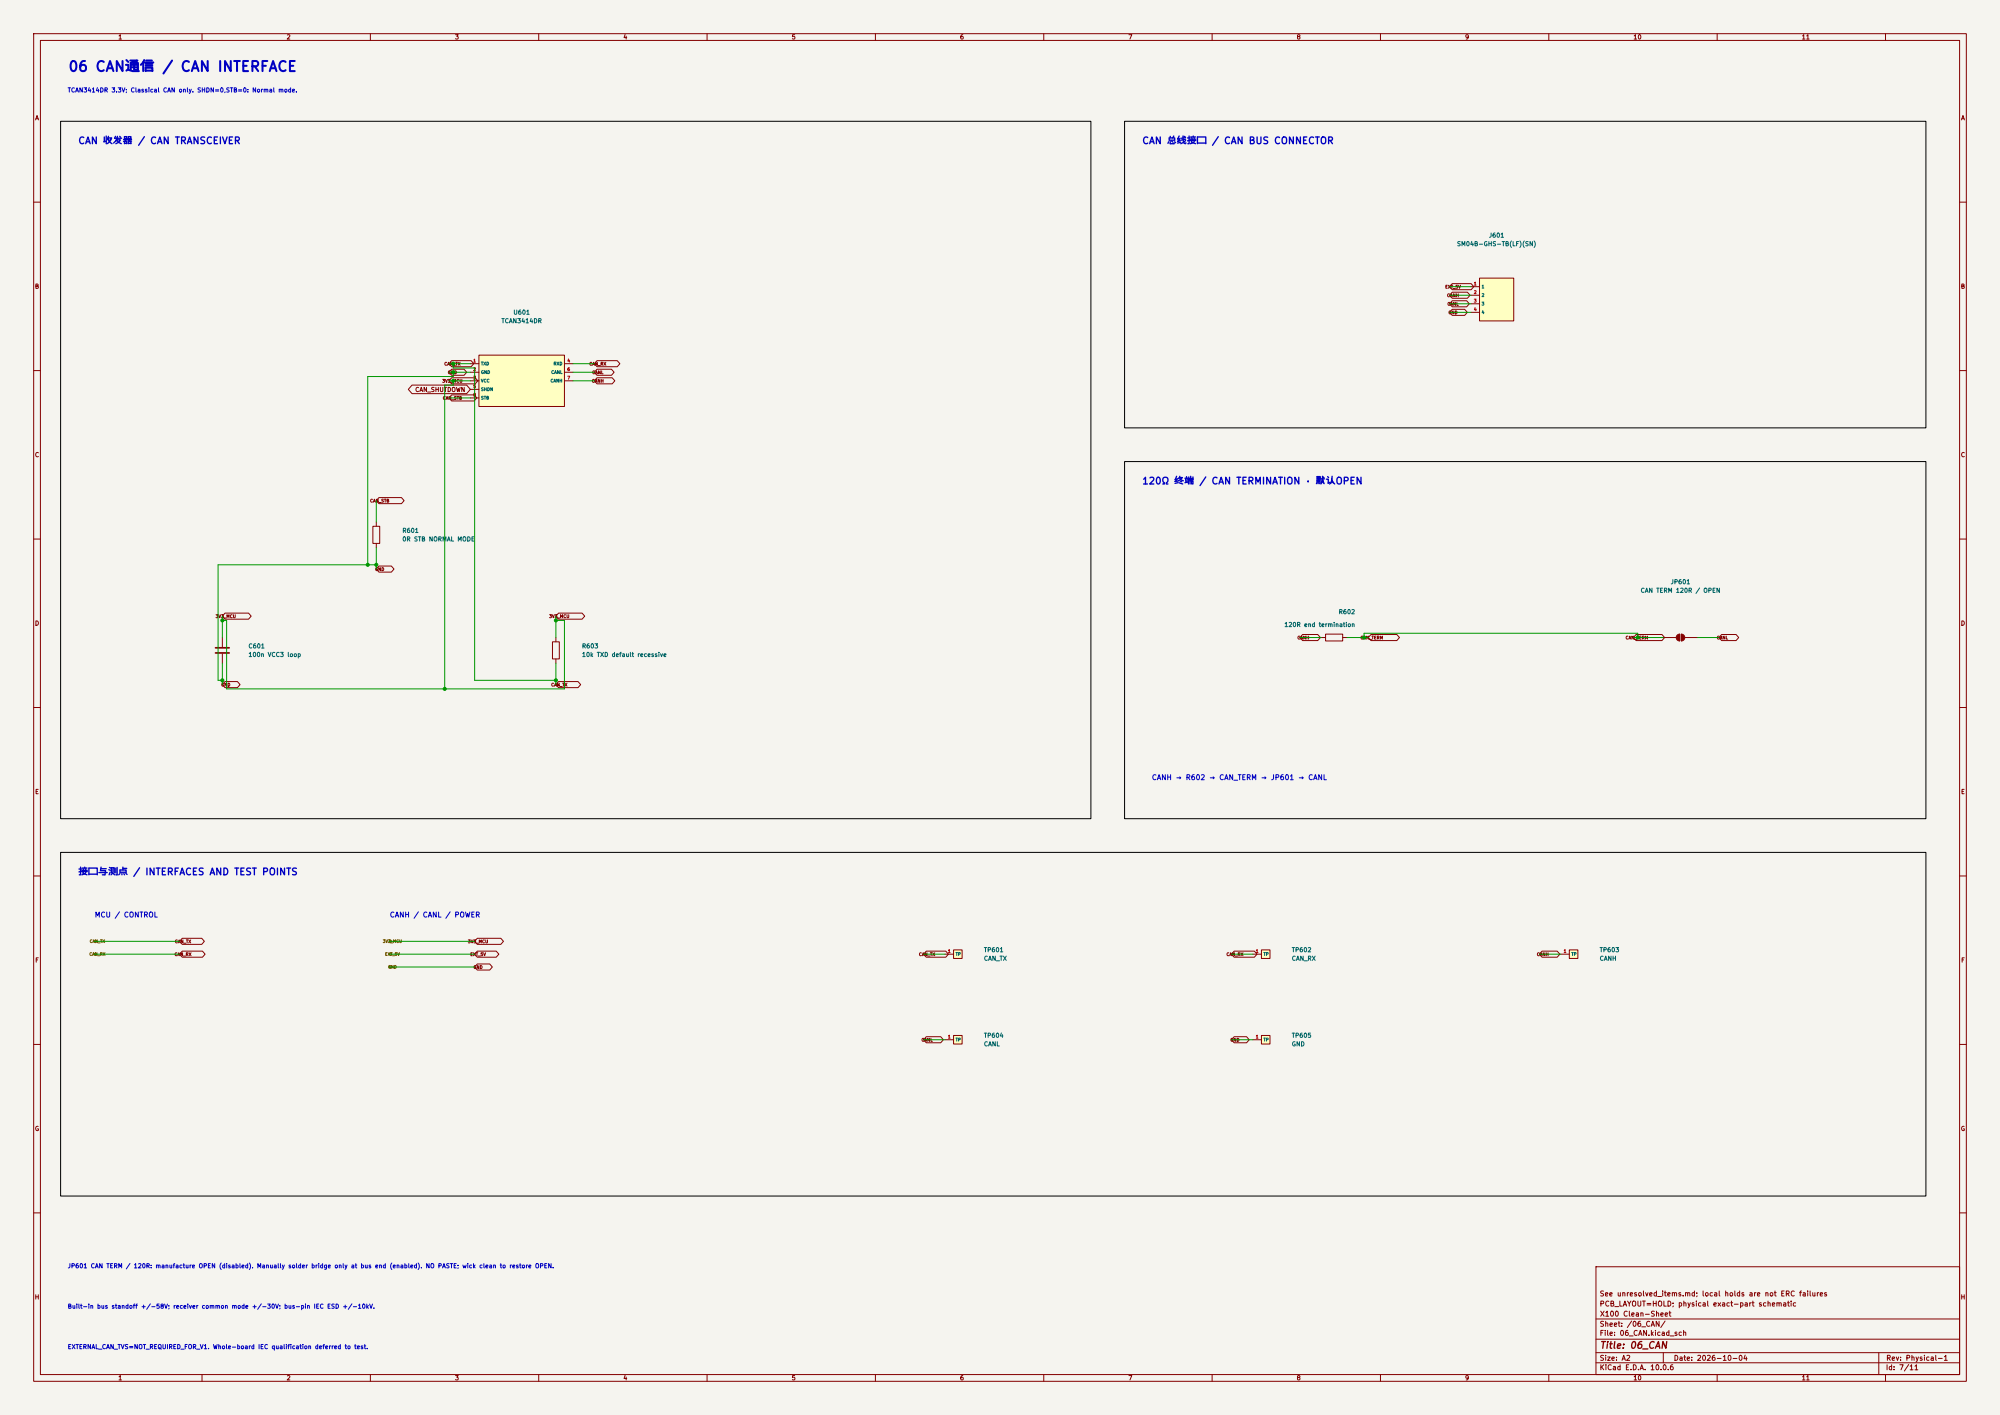
[picture p32: page 7]

TCAN3414DR 3.3V; Classical CAN only. SHDN=0,STB=0: Normal mode.

SM04B-GHS-TB(LF)(SN)

120Ω 终端 / CAN TERMINATION · 默认OPEN

接口与测点 / INTERFACES AND TEST POINTS

Built-in bus standoff +/-58V; receiver common mode +/-30V; bus-pin IEC ESD +/-10kV. EXTERNAL_CAN_TVS=NOT_REQUIRED_FOR_V1. Whole-board IEC qualification deferred to test. JP601 CAN TERM / 120R: manufacture OPEN (disabled). Manually solder bridge only at bus end (enabled). NO PASTE; wick clean to restore OPEN.

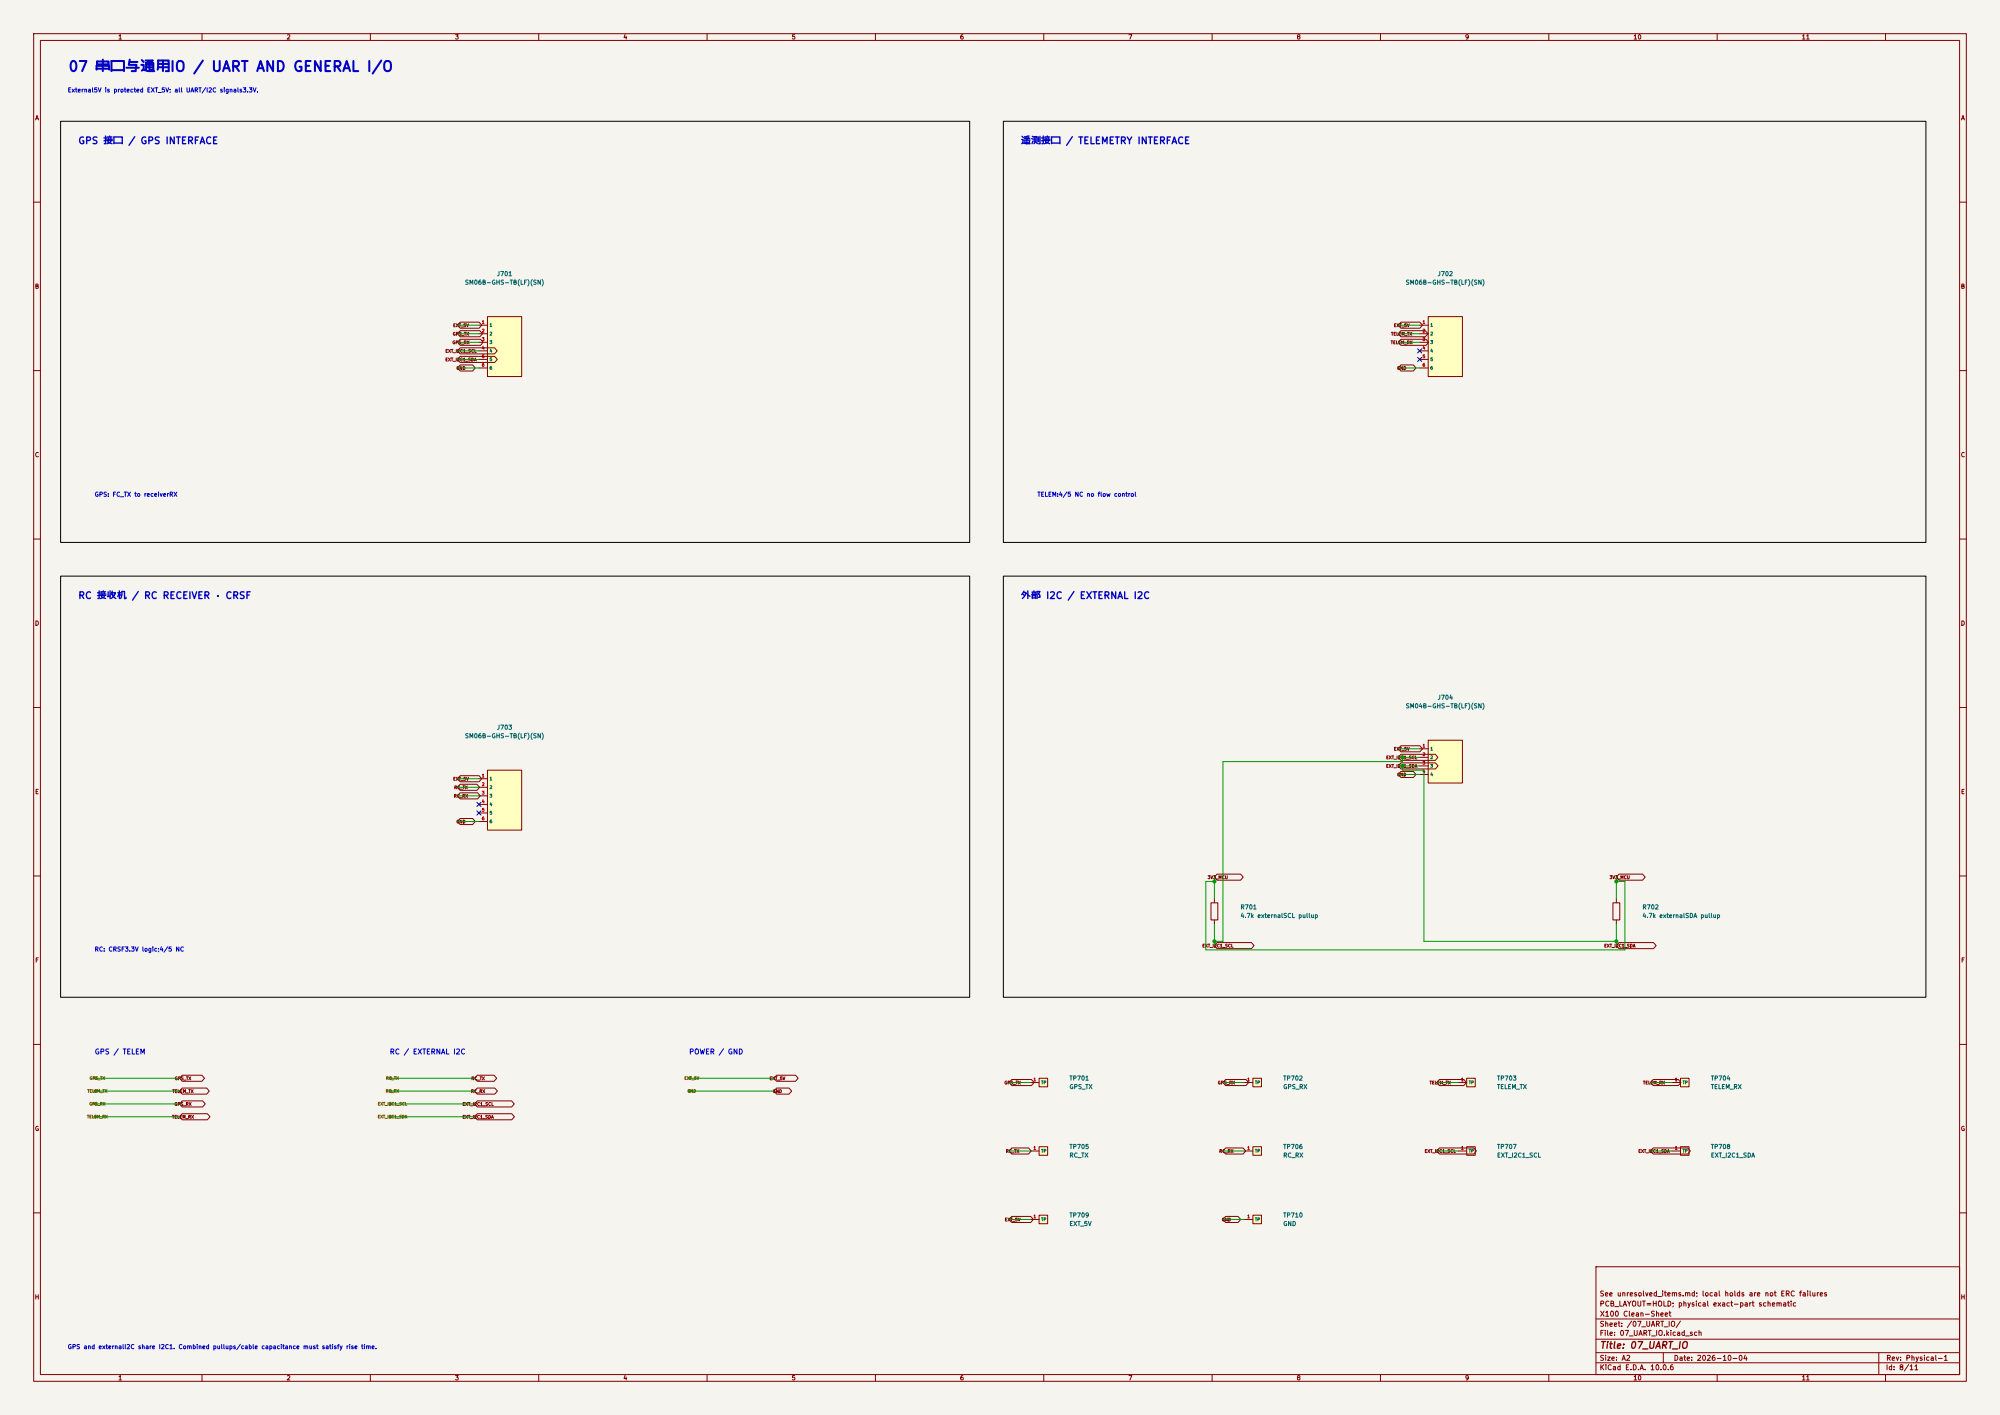
[picture p33: page 8]

07 串口与通用IO / UART AND GENERAL I/O

External5V is protected EXT_5V; all UART/I2C signals3.3V.

GPS 接口 / GPS INTERFACE

SM06B-GHS-TB(LF)(SN)

GPS: FC_TX to receiverRX RC 接收机 / RC RECEIVER · CRSF

TELEM:4/5 NC no flow control 外部 I2C / EXTERNAL I2C

SM04B-GHS-TB(LF)(SN)

GPS and externalI2C share I2C1. Combined pullups/cable capacitance must satisfy rise time. GPS / TELEM

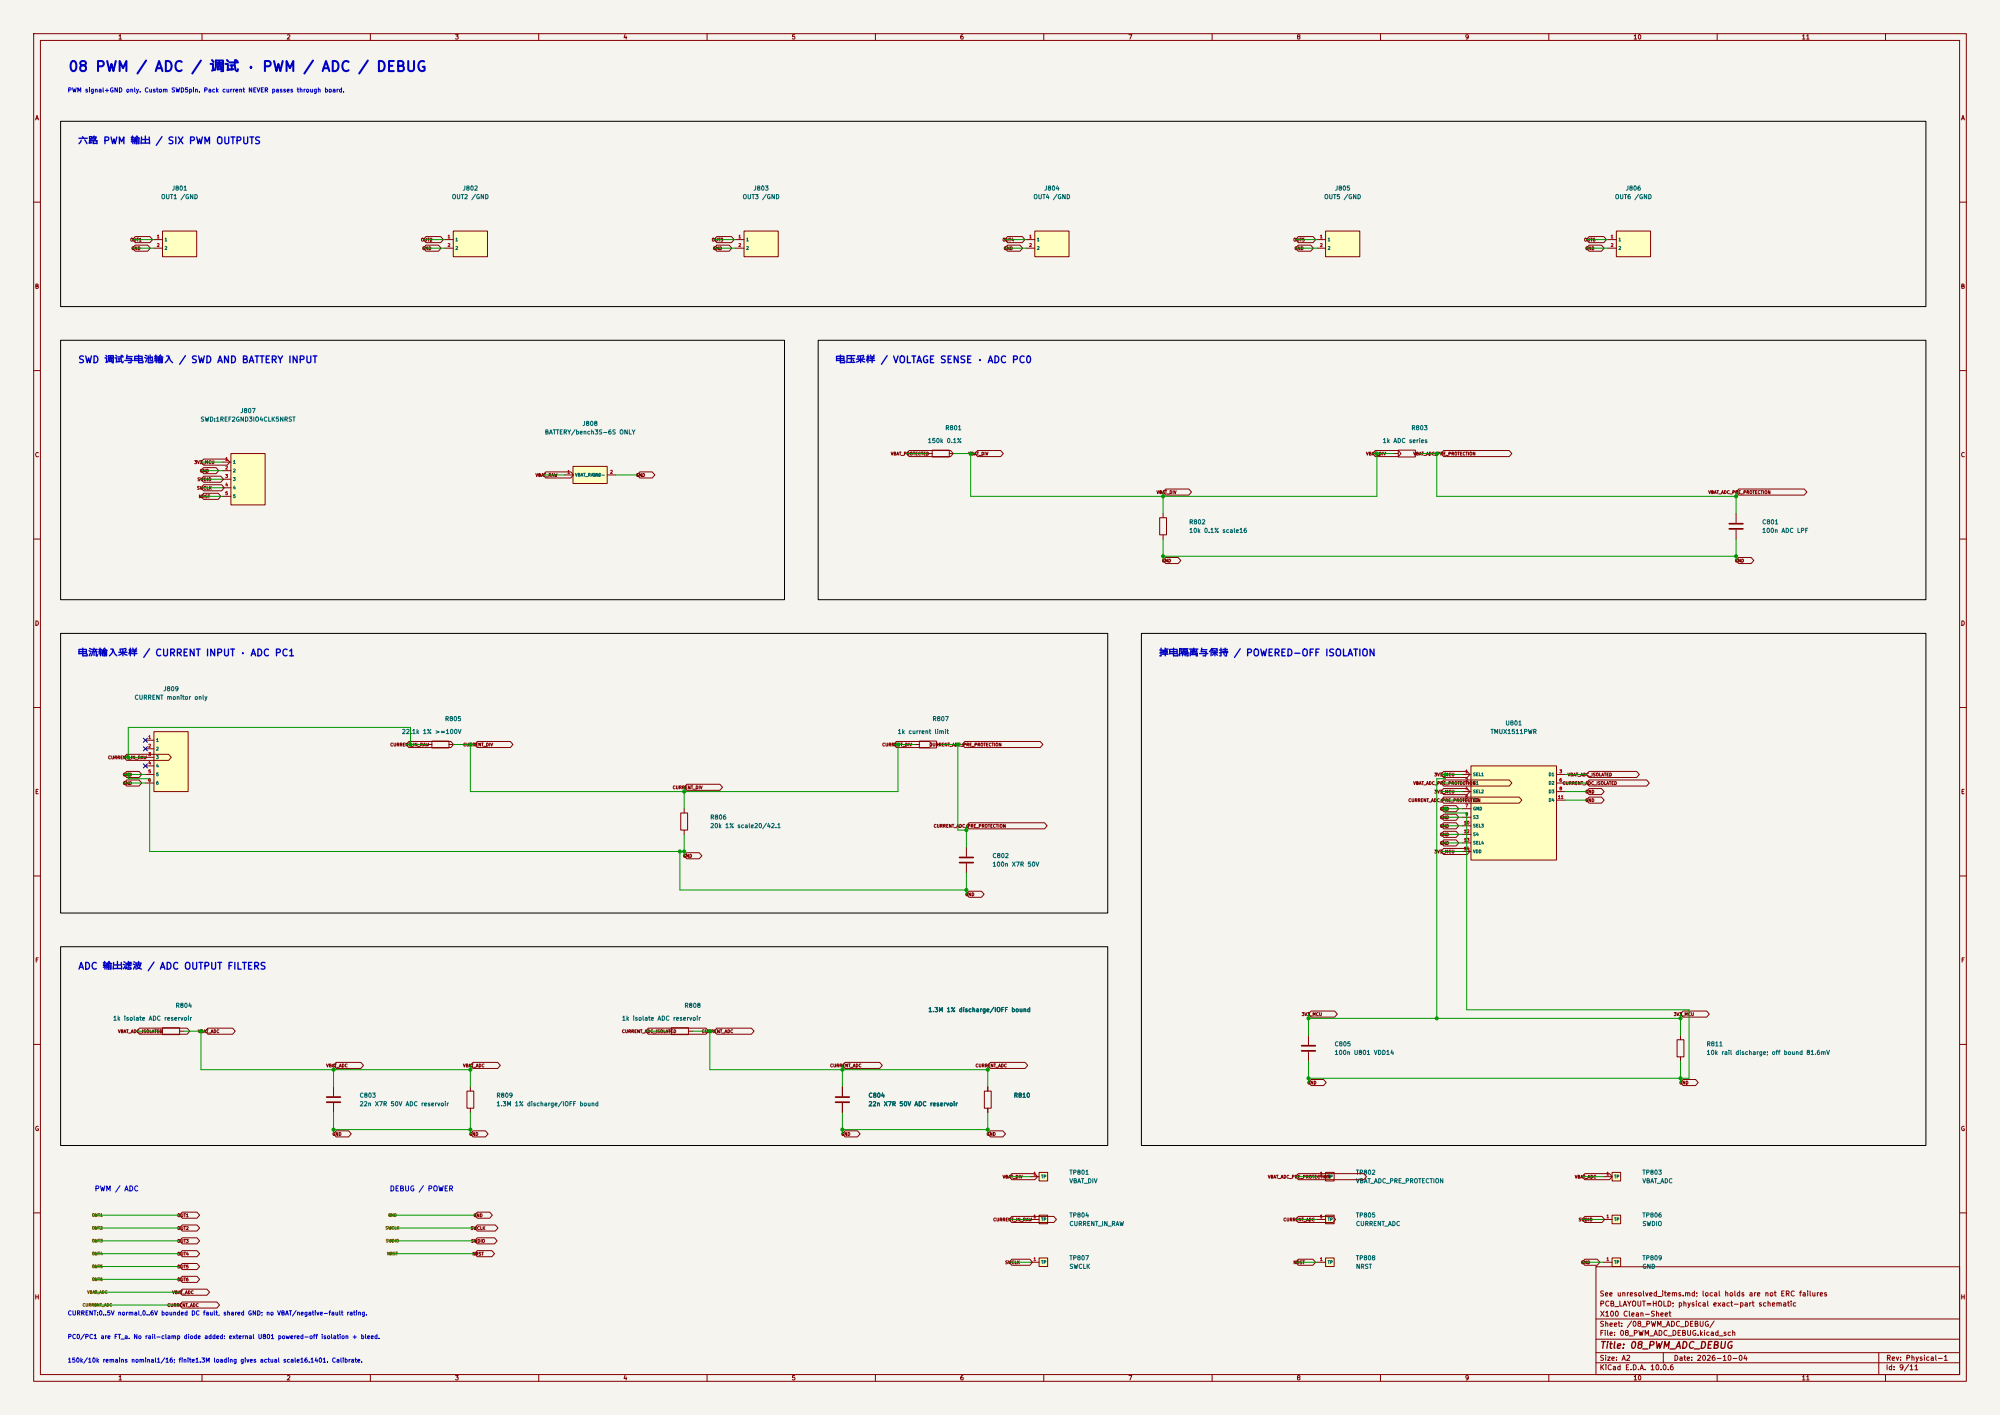
[picture p34: page 9]

08 PWM / ADC / 调试 · PWM / ADC / DEBUG

PWM signal+GND only. Custom SWD5pin. Pack current NEVER passes through board.

六路 PWM 输出 / SIX PWM OUTPUTS

SWD 调试与电池输入 / SWD AND BATTERY INPUT
SWCLK NRST GND

电压采样 / VOLTAGE SENSE · ADC PC0

电流输入采样 / CURRENT INPUT · ADC PC1

掉电隔离与保持 / POWERED-OFF ISOLATION

ADC 输出滤波 / ADC OUTPUT FILTERS

1k isolate ADC reservoir SWCLK

10k rail discharge; off bound 81.6mV

PC0/PC1 are FT_a. No rail-clamp diode added: external U801 powered-off isolation + bleed. PWM / ADC

CURRENT_ADC
CURRENT:0..5V normal,0..6V bounded DC fault, shared GND; no VBAT/negative-fault rating.

150k/10k remains nominal1/16; finite1.3M loading gives actual scale16.1401. Calibrate.

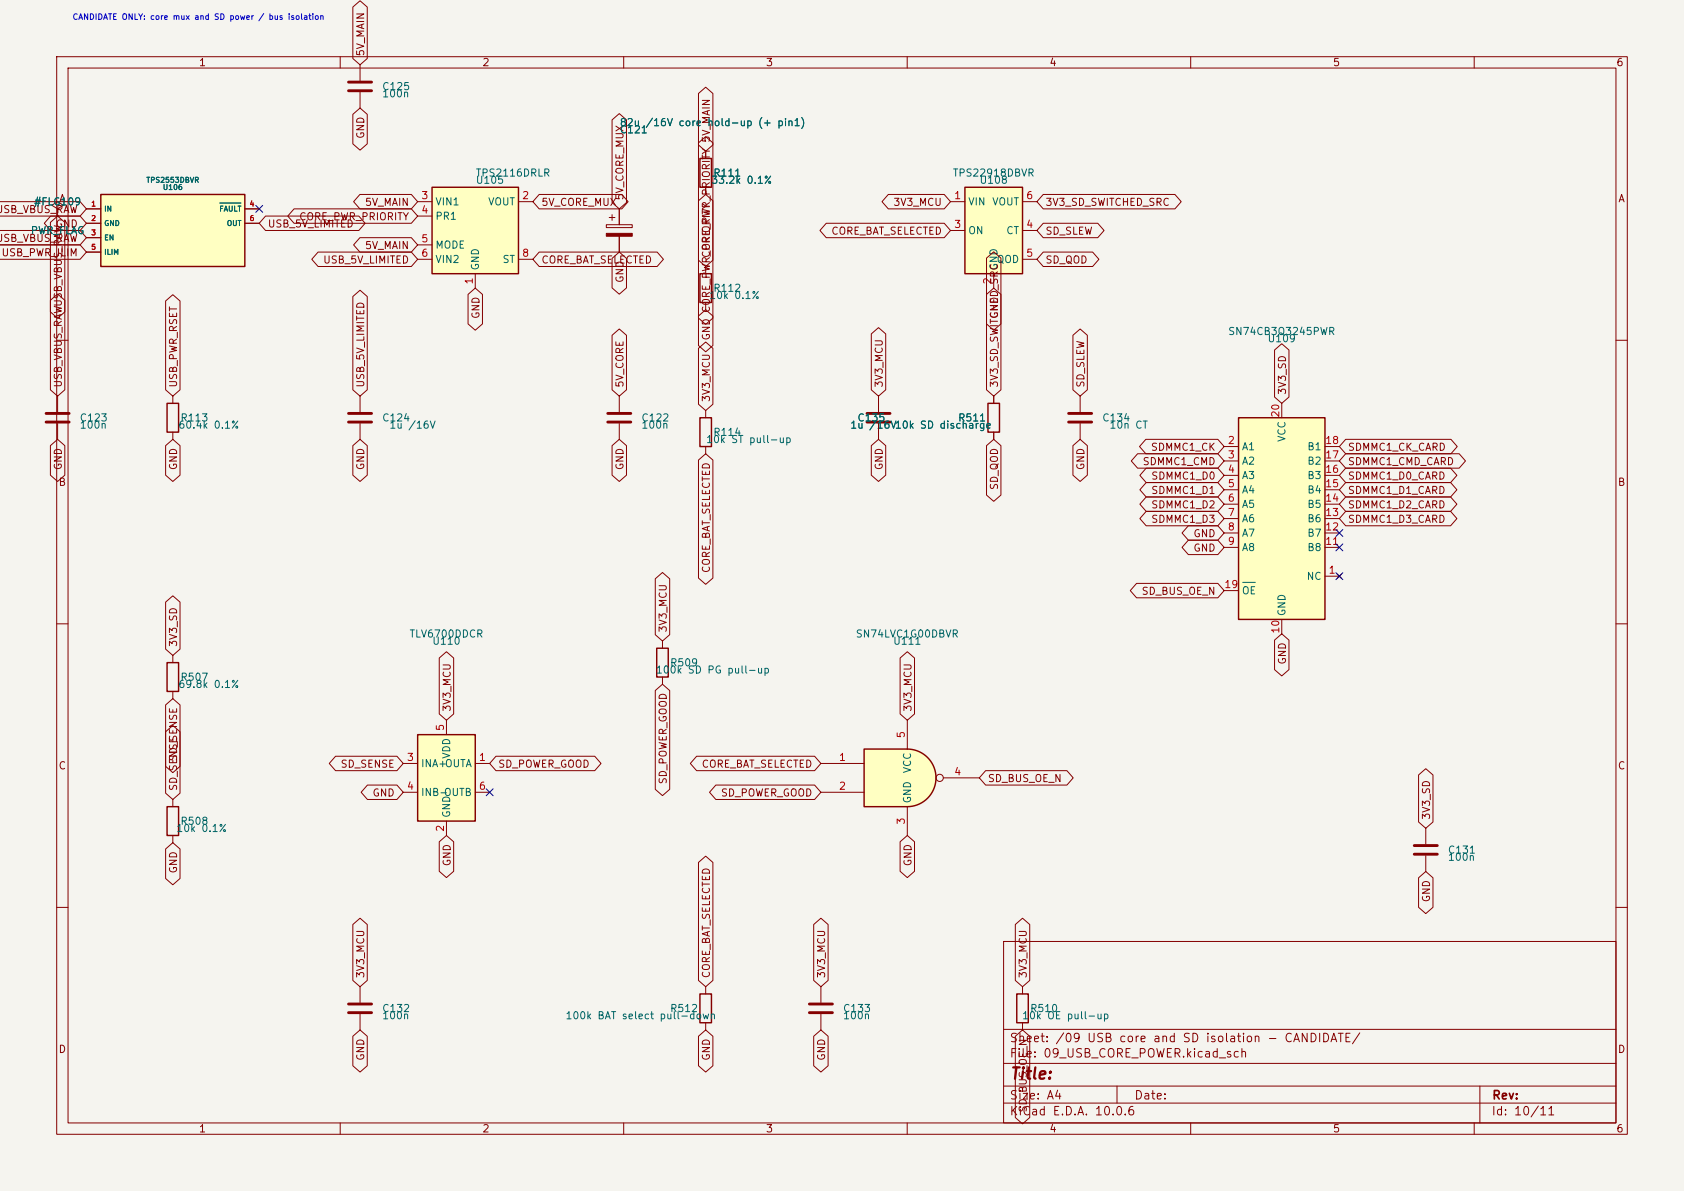
[picture p35: page 10]

CANDIDATE ONLY: core mux and SD power / bus isolation U106
USB_VBUS_RAW
R512 100k BAT select pull-down GND
SD_QOD 3V3_MCU

R510 10k OE pull-up R509 100k SD PG pull-up

Sheet: /09 USB core and SD isolation - CANDIDATE/
File: 09_USB_CORE_POWER.kicad_sch
Title:

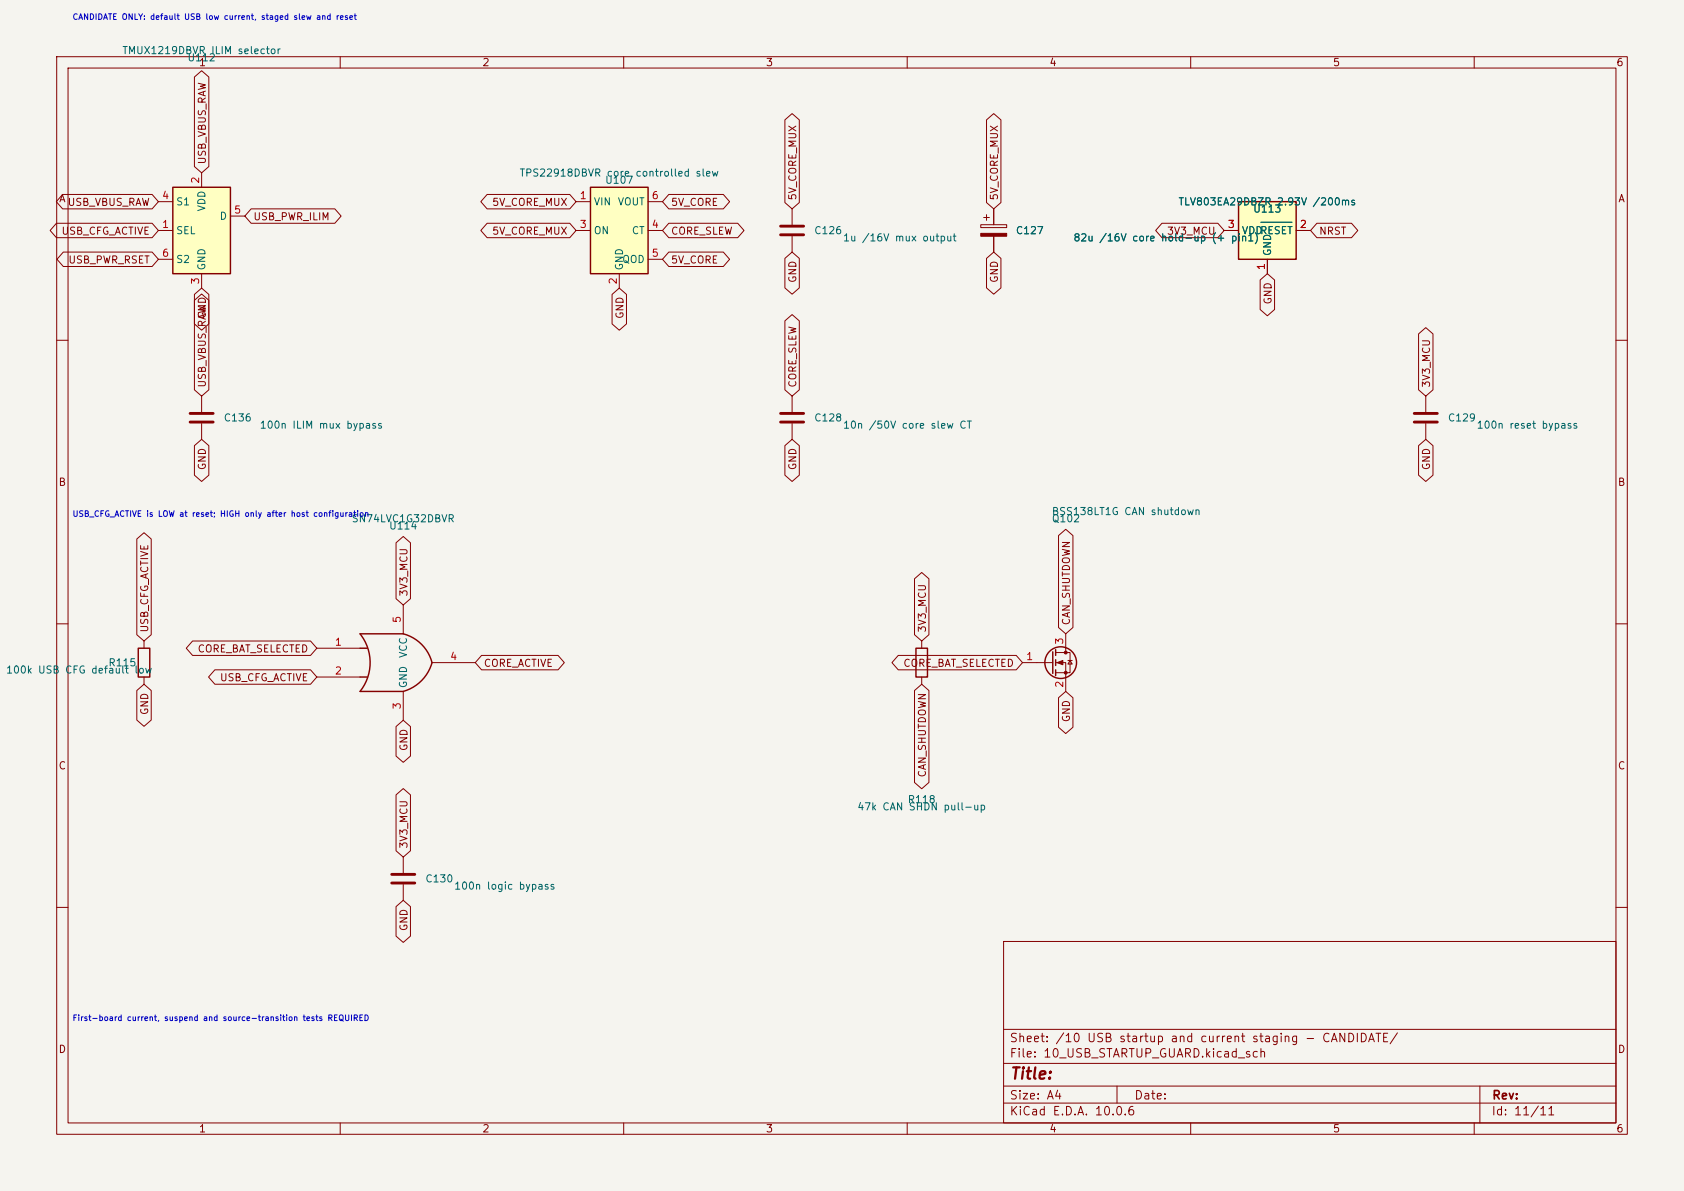
[picture p36: page 11]

CANDIDATE ONLY: default USB low current, staged slew and reset USB_CFG_ACTIVE is LOW at reset; HIGH only after host configuration
USB_PWR_ILIM USB_VBUS_RAW GND
Sheet: /10 USB startup and current staging - CANDIDATE/ GND

2 3 Q102 BSS138LT1G CAN shutdown C129100n reset bypass SEL 1 VDD

C130100n logic bypass C136 100n ILIM mux bypass R115 100k USB CFG default low

First-board current, suspend and source-transition tests REQUIRED
