chen123037/X100-Flight-Controller-Edu/(list of files, drawings)

Other design files:
docs/PCB_READINESS_CHECK.json
