chen123037/X100-Flight-Controller-Edu/hardware/proposals/J401_AMPHENOL_UNAPPROVED/X100_CleanSheet.kicad_pcb

## KiCad design hardware/proposals/J401_AMPHENOL_UNAPPROVED/X100_CleanSheet.kicad_pcb (2026-11-03)

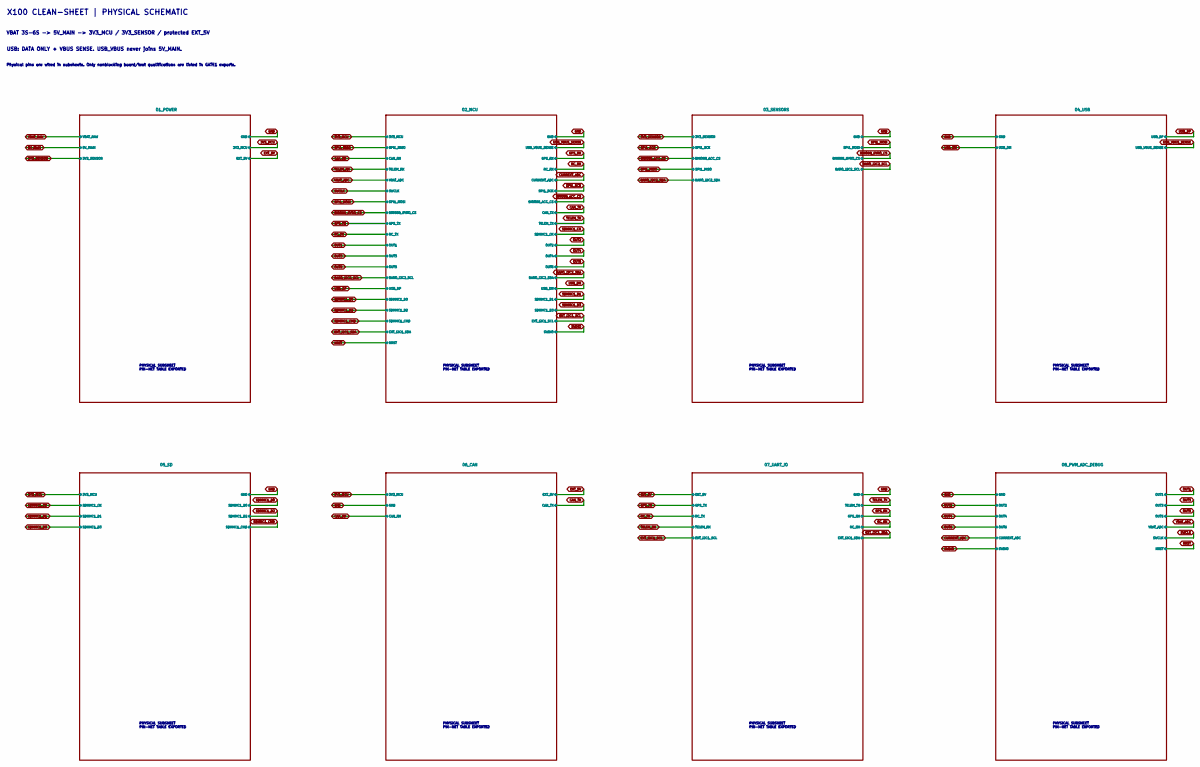
[picture p42: schematic X100_CleanSheet.kicad_sch, X100 Clean-Sheet / hierarchy]

Notes on the sheet:
X100 CLEAN-SHEET | PHYSICAL SCHEMATIC
VBAT 3S-6S -> 5V_MAIN -> 3V3_MCU / 3V3_SENSOR / protected EXT_5V
USB: DATA ONLY + VBUS SENSE. USB_VBUS never joins 5V_MAIN.
Physical pins are wired in subsheets. Only nonblocking board/test qualifications are listed in GATE1 exports.
PHYSICAL SUBSHEET PIN-NET TABLE EXPORTED

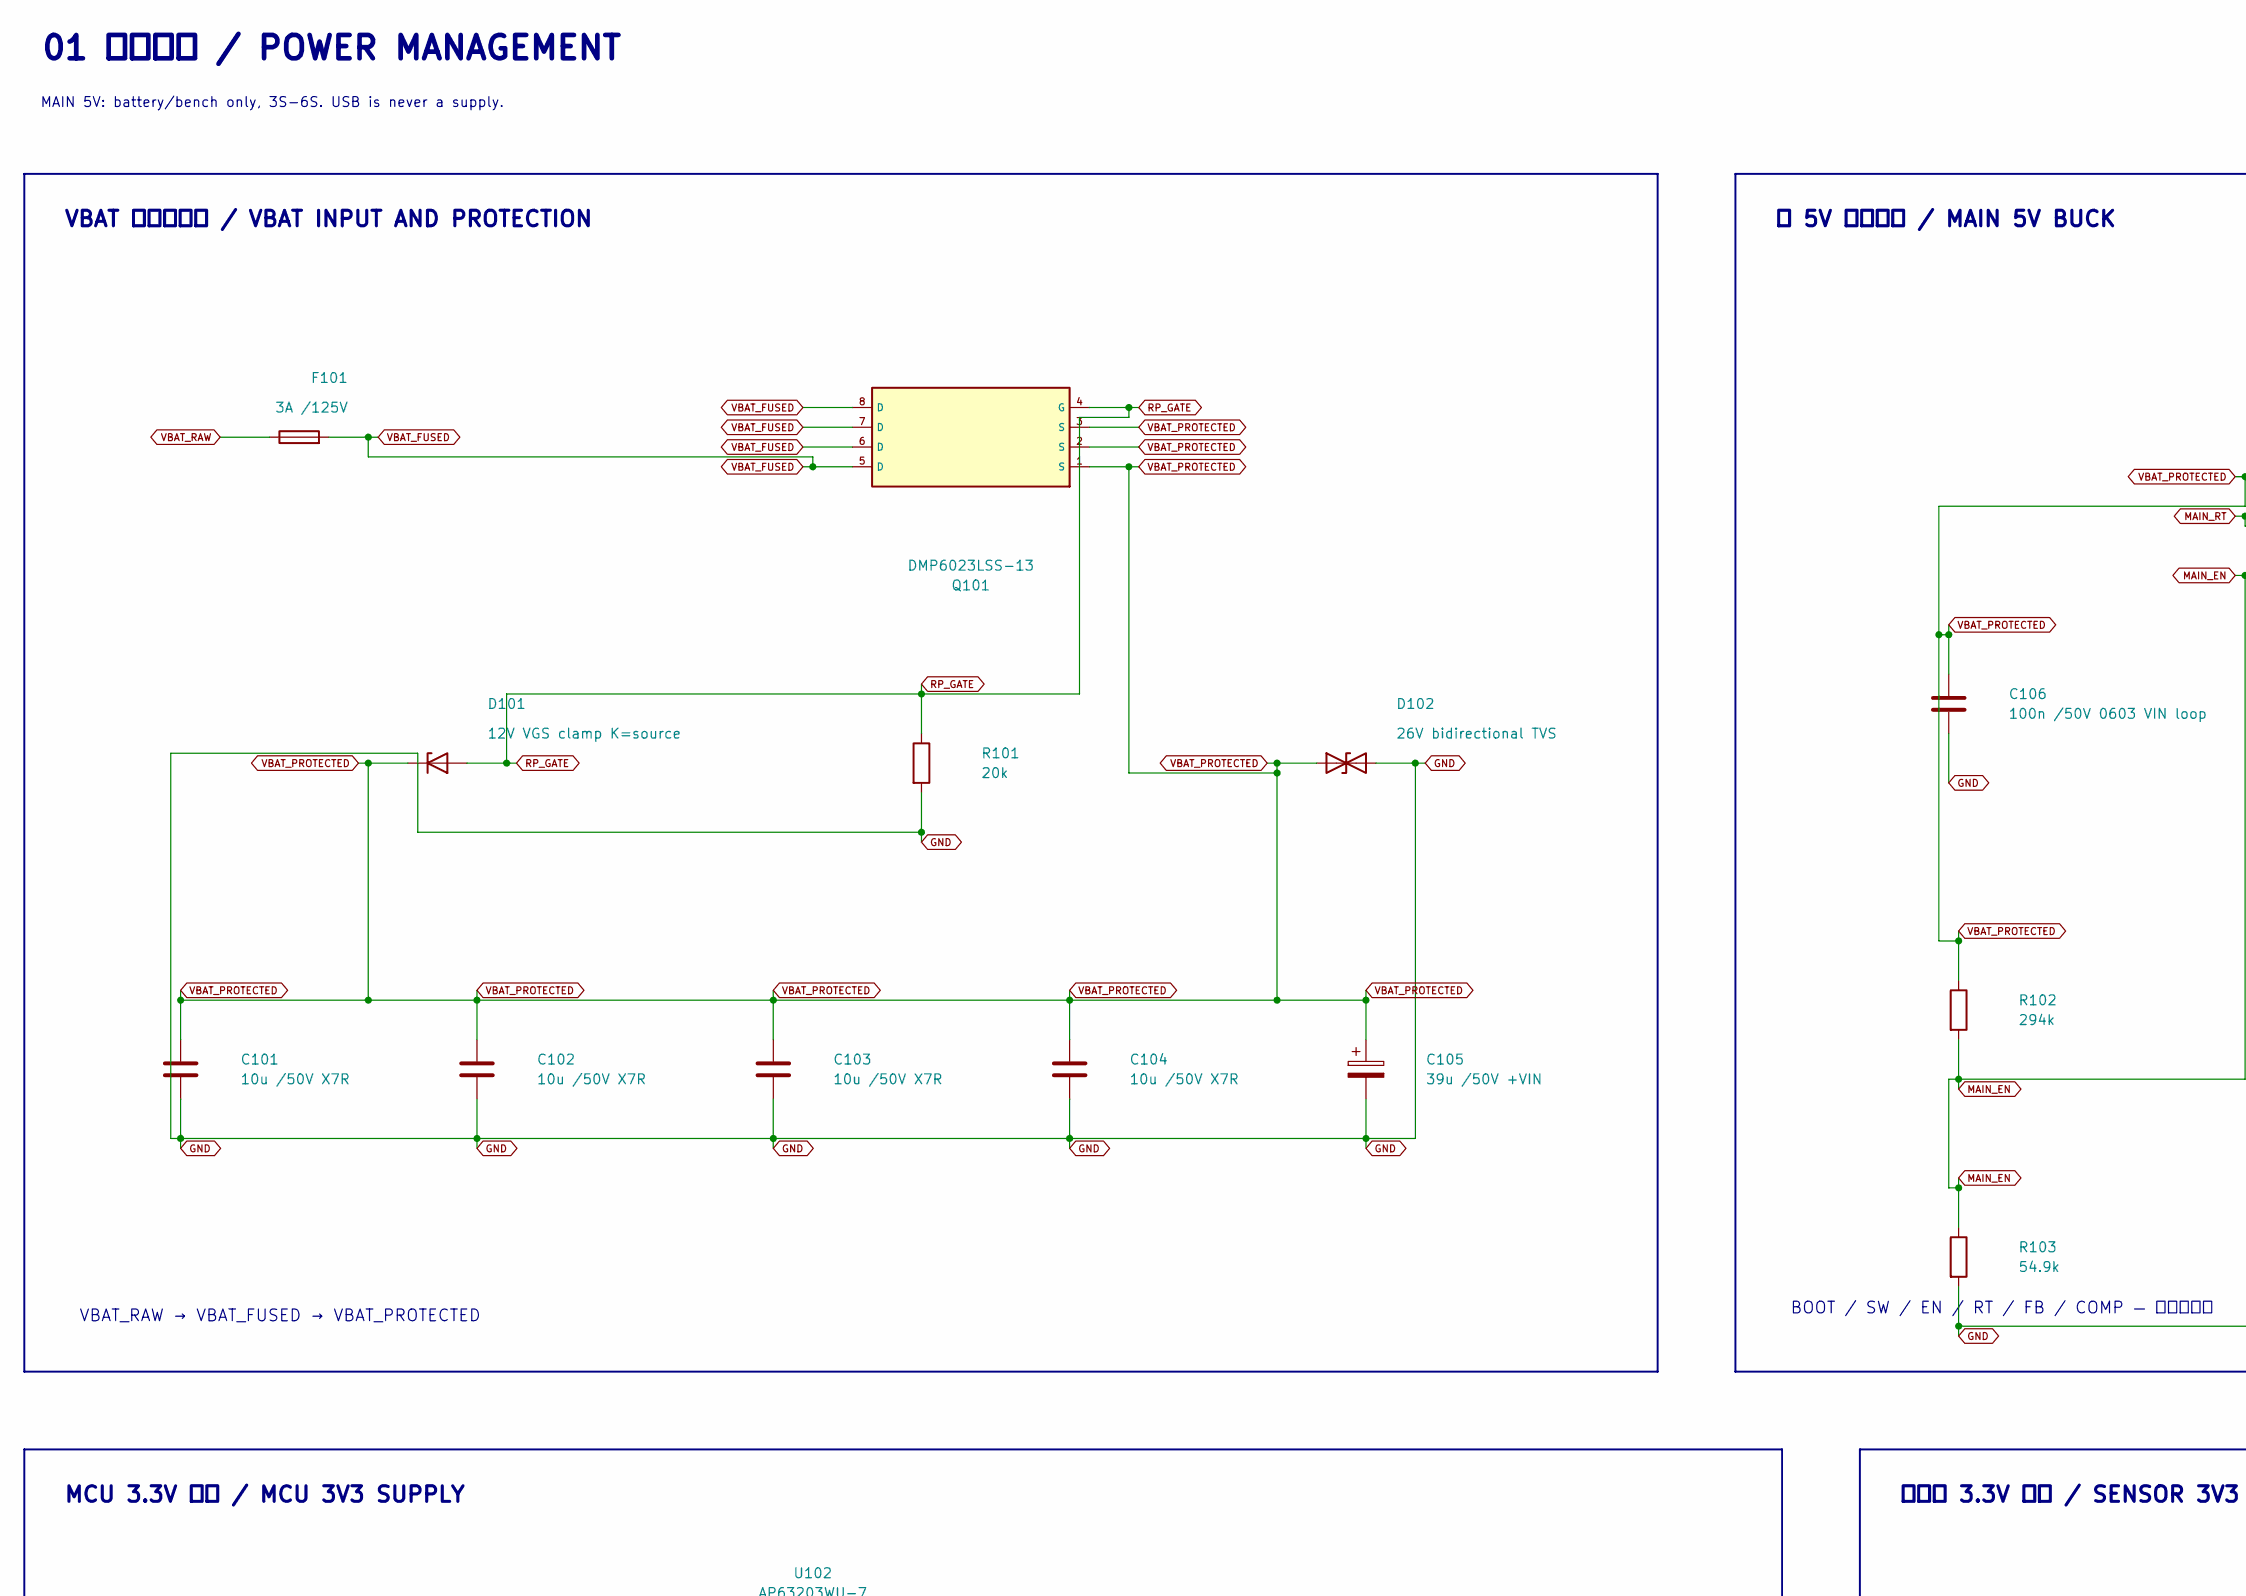
[picture p43: schematic 01_POWER.kicad_sch, part in row 1, column 1]

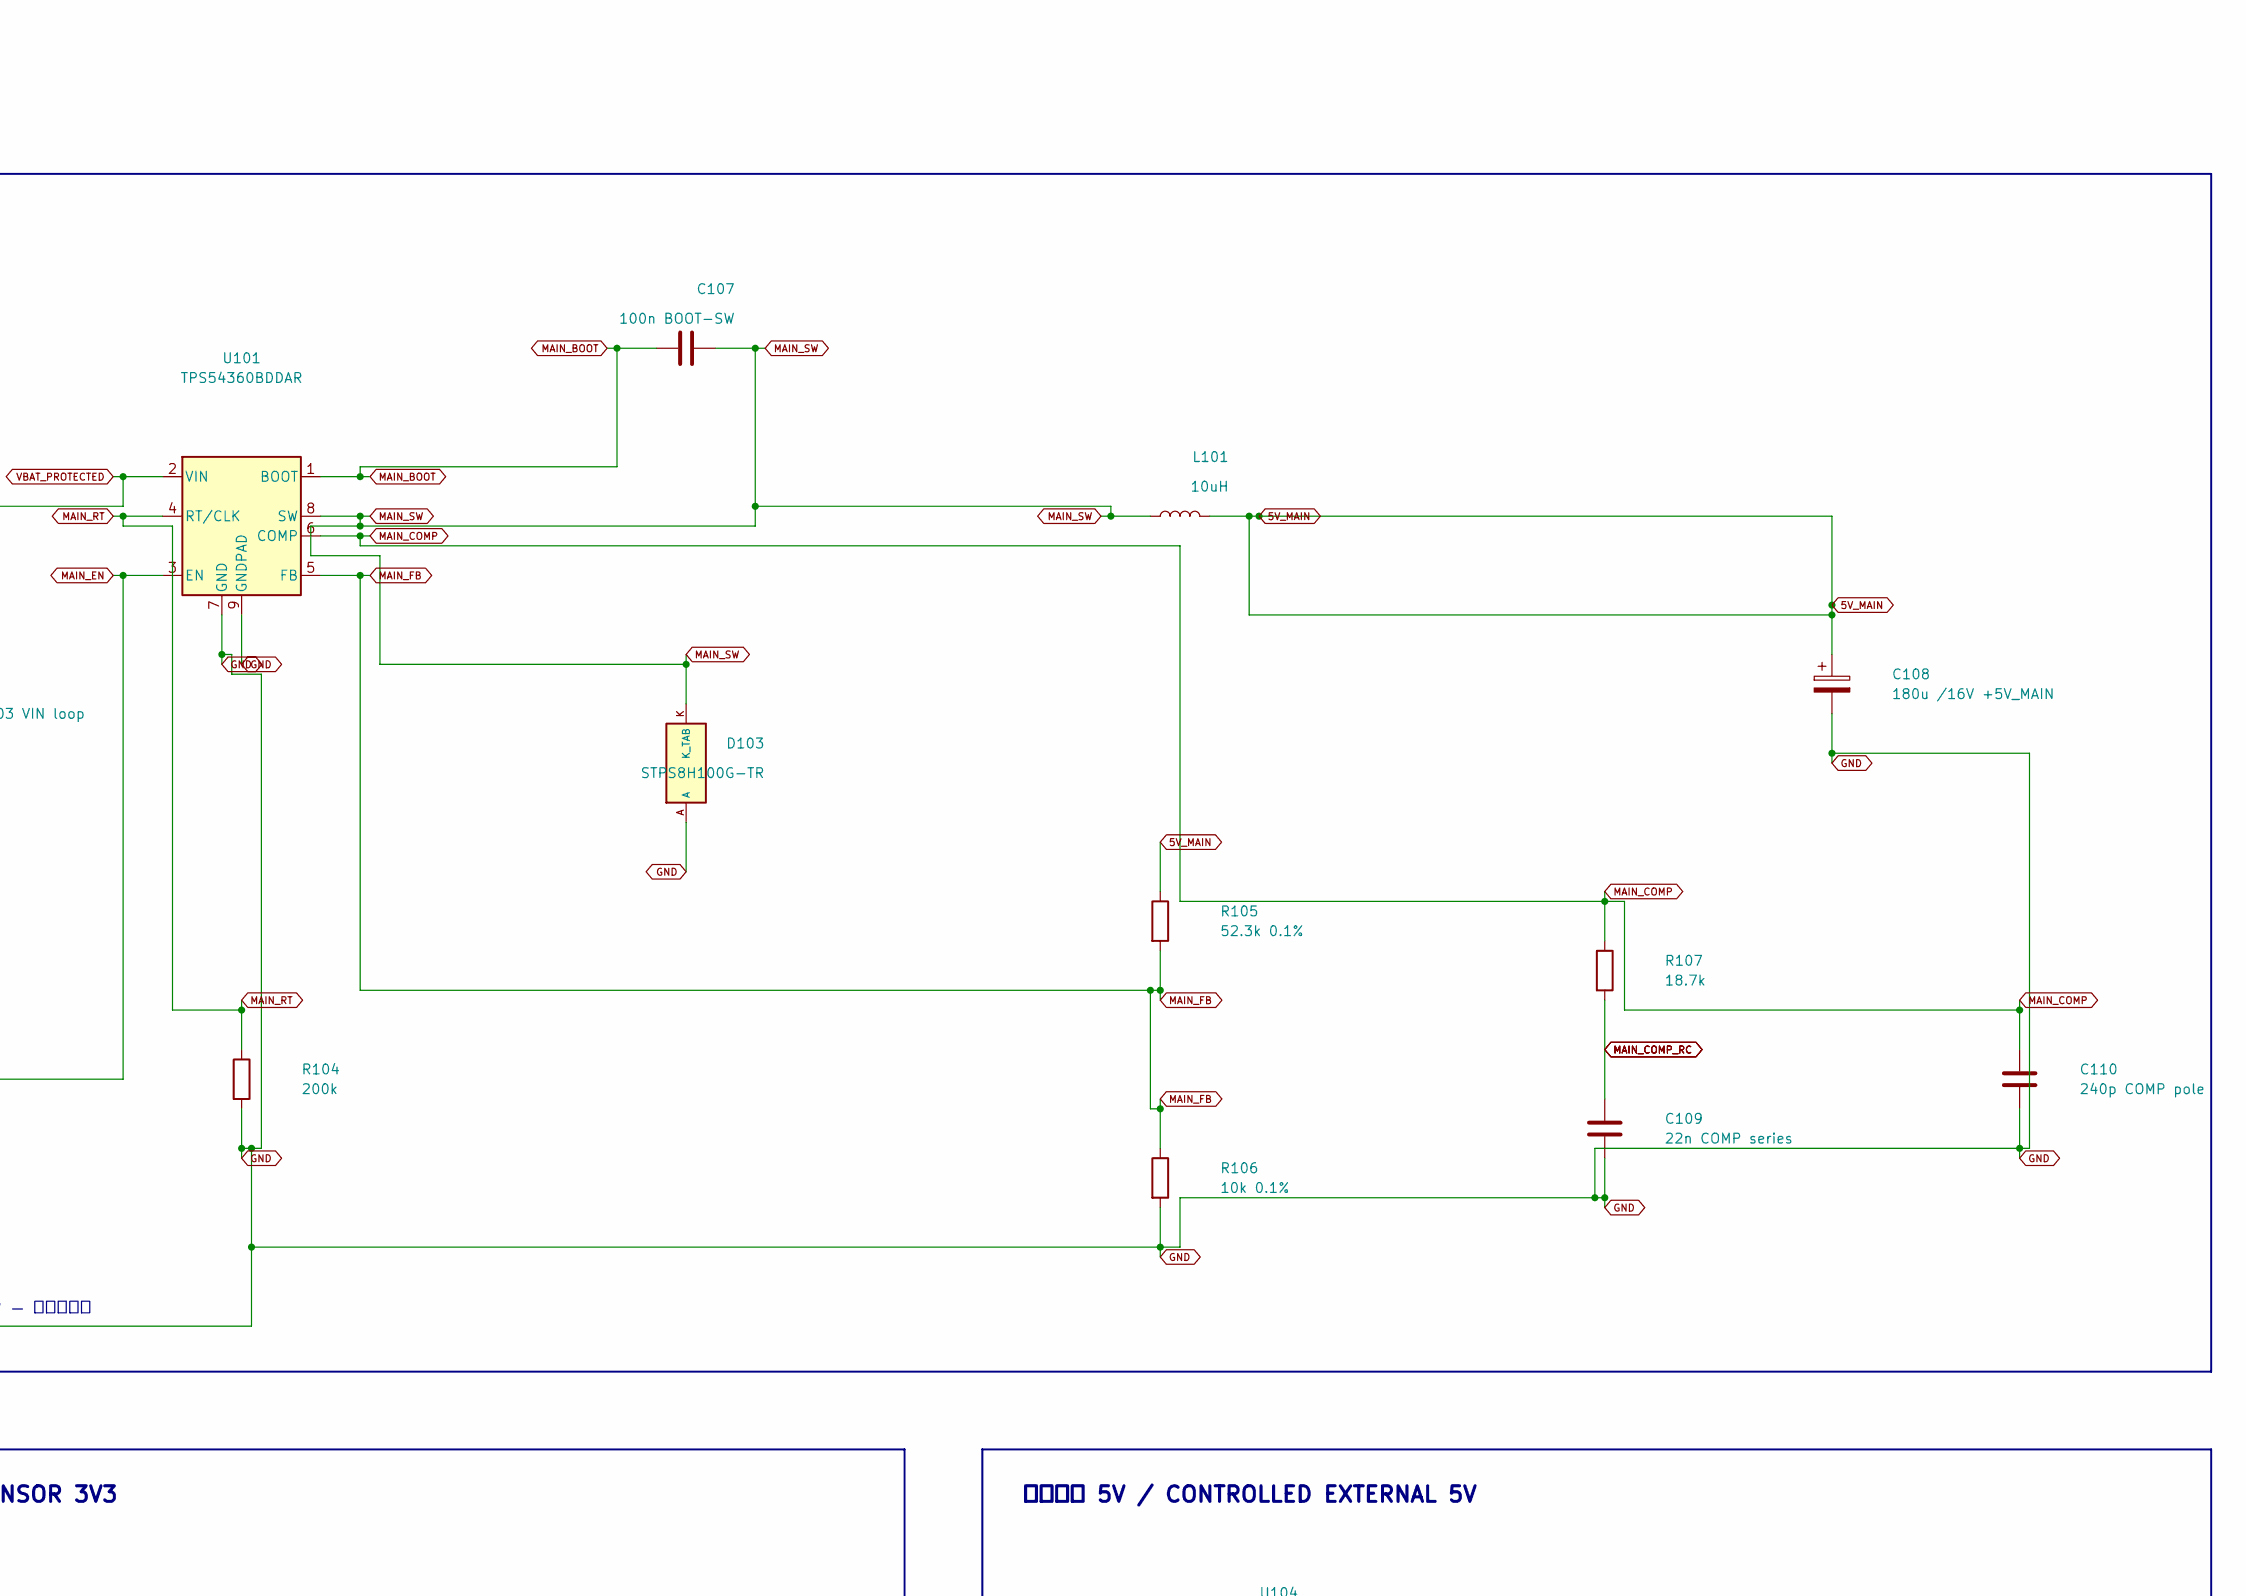
[picture p44: schematic 01_POWER.kicad_sch, part in row 1, column 2]

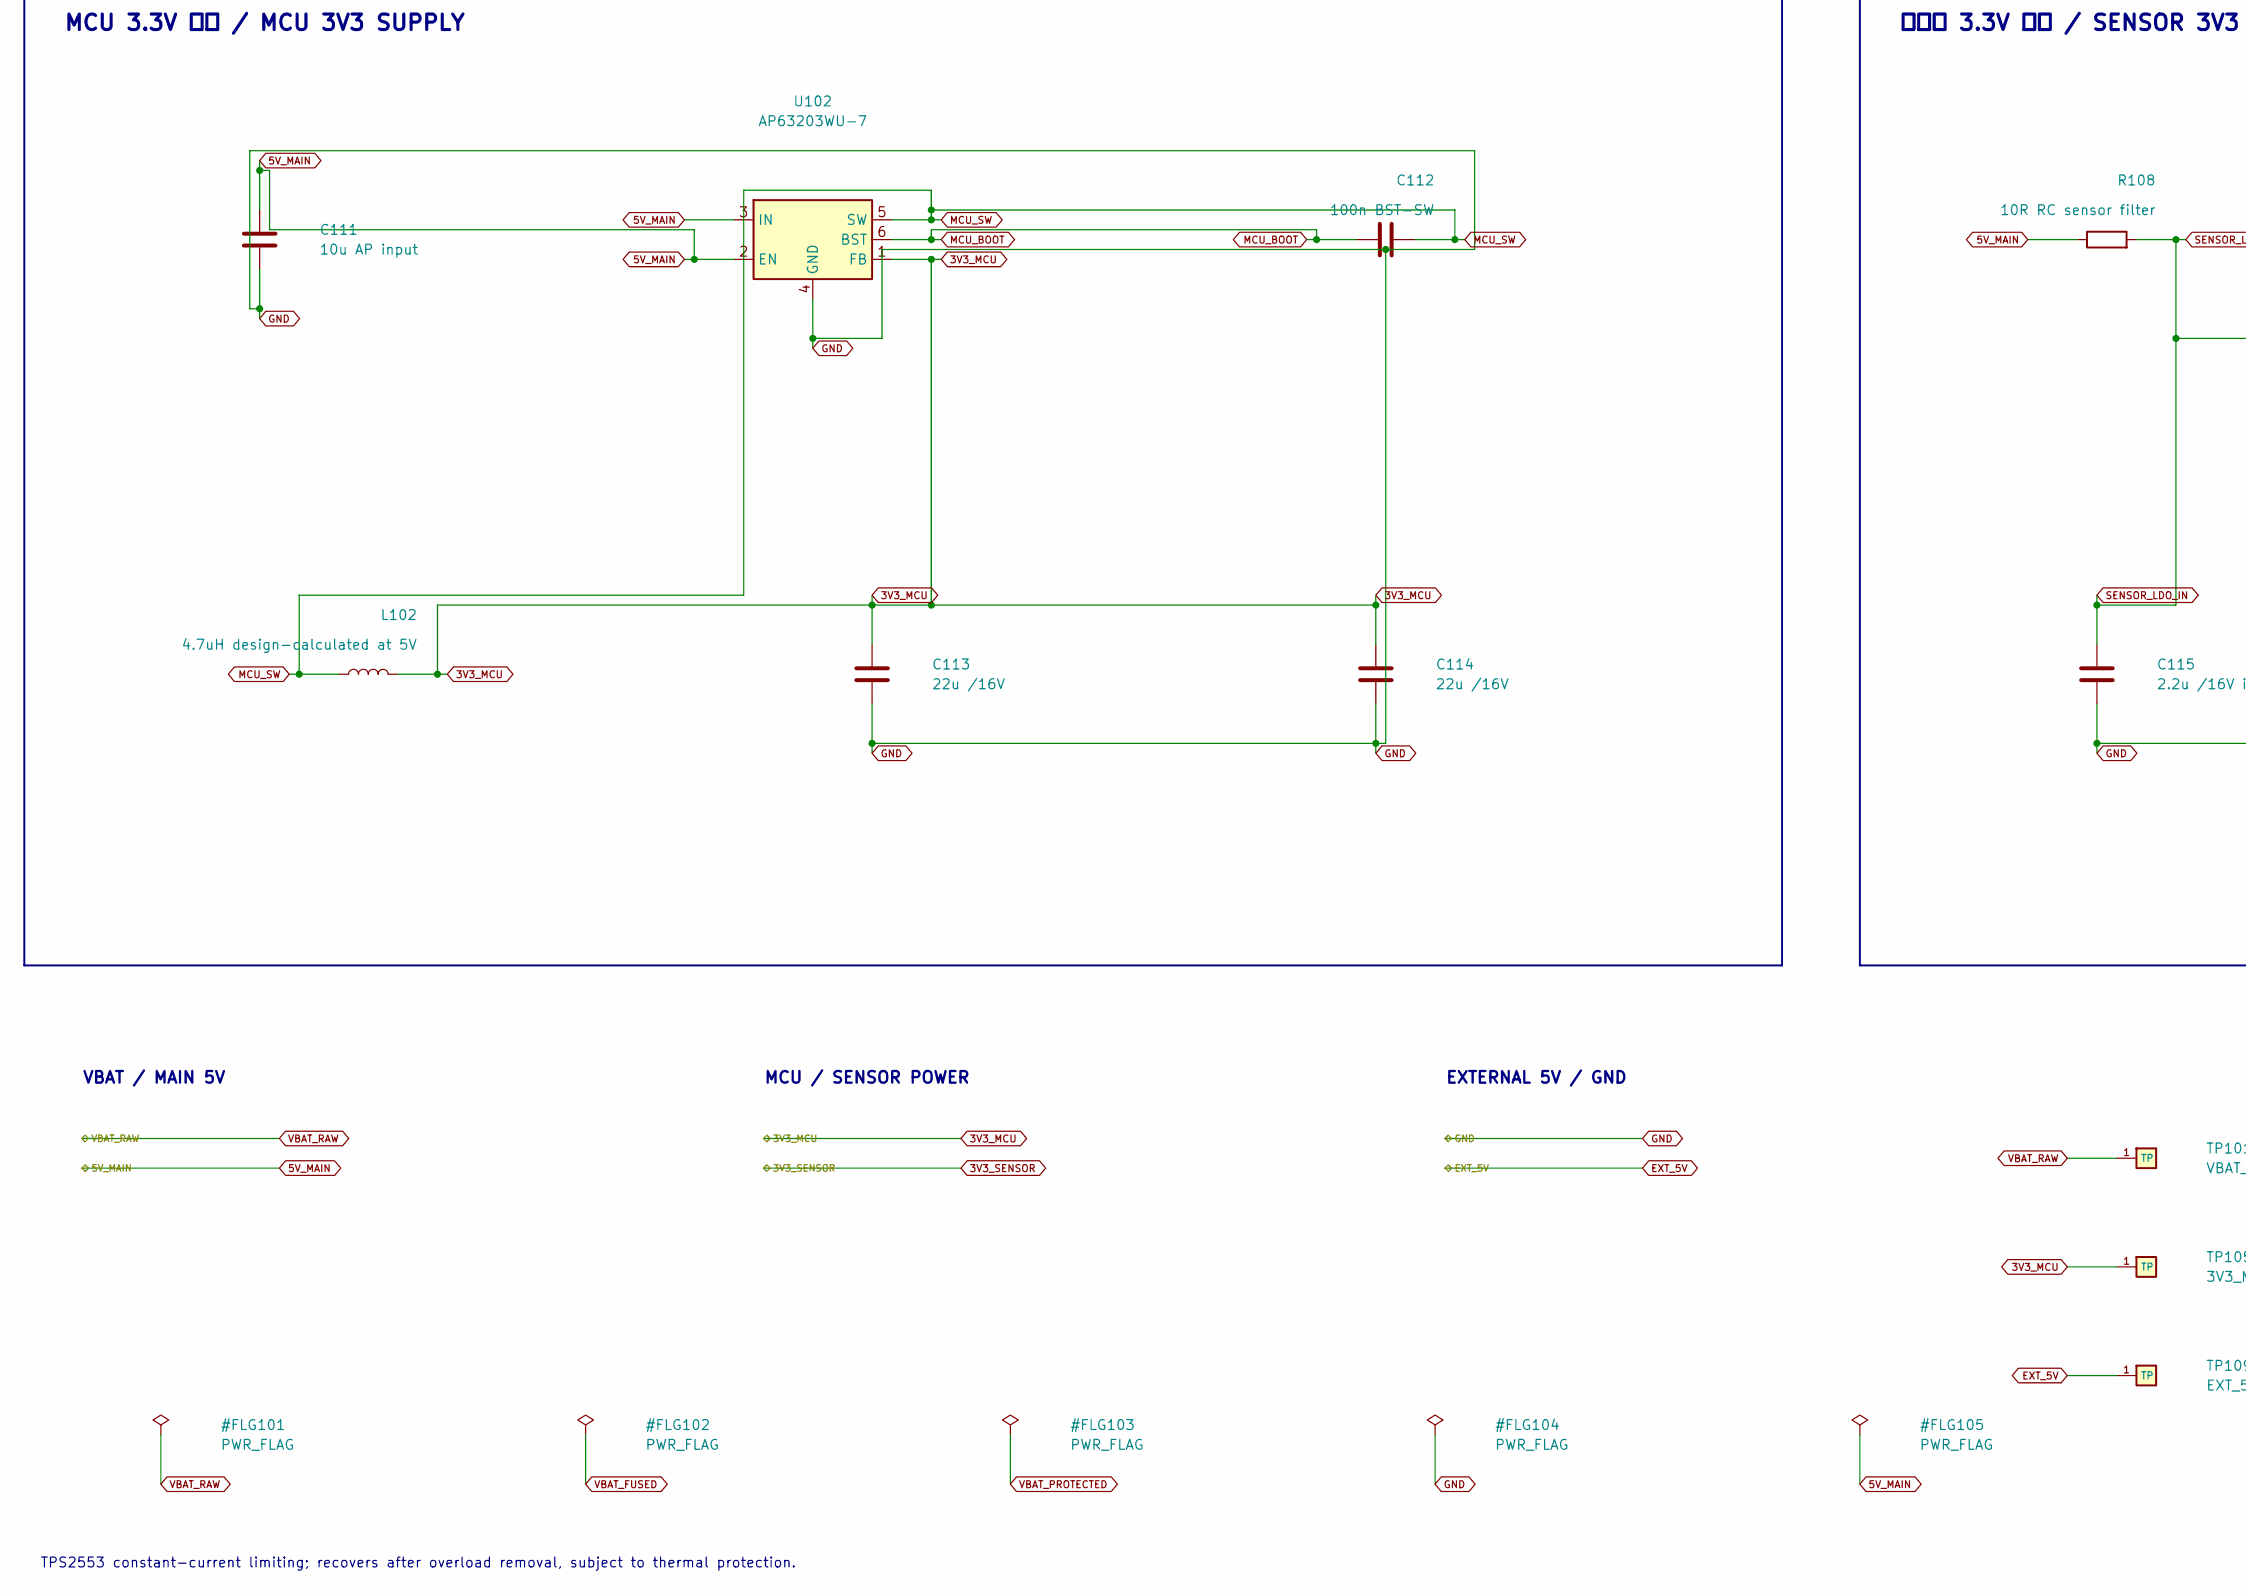
[picture p45: schematic 01_POWER.kicad_sch, part in row 2, column 1]

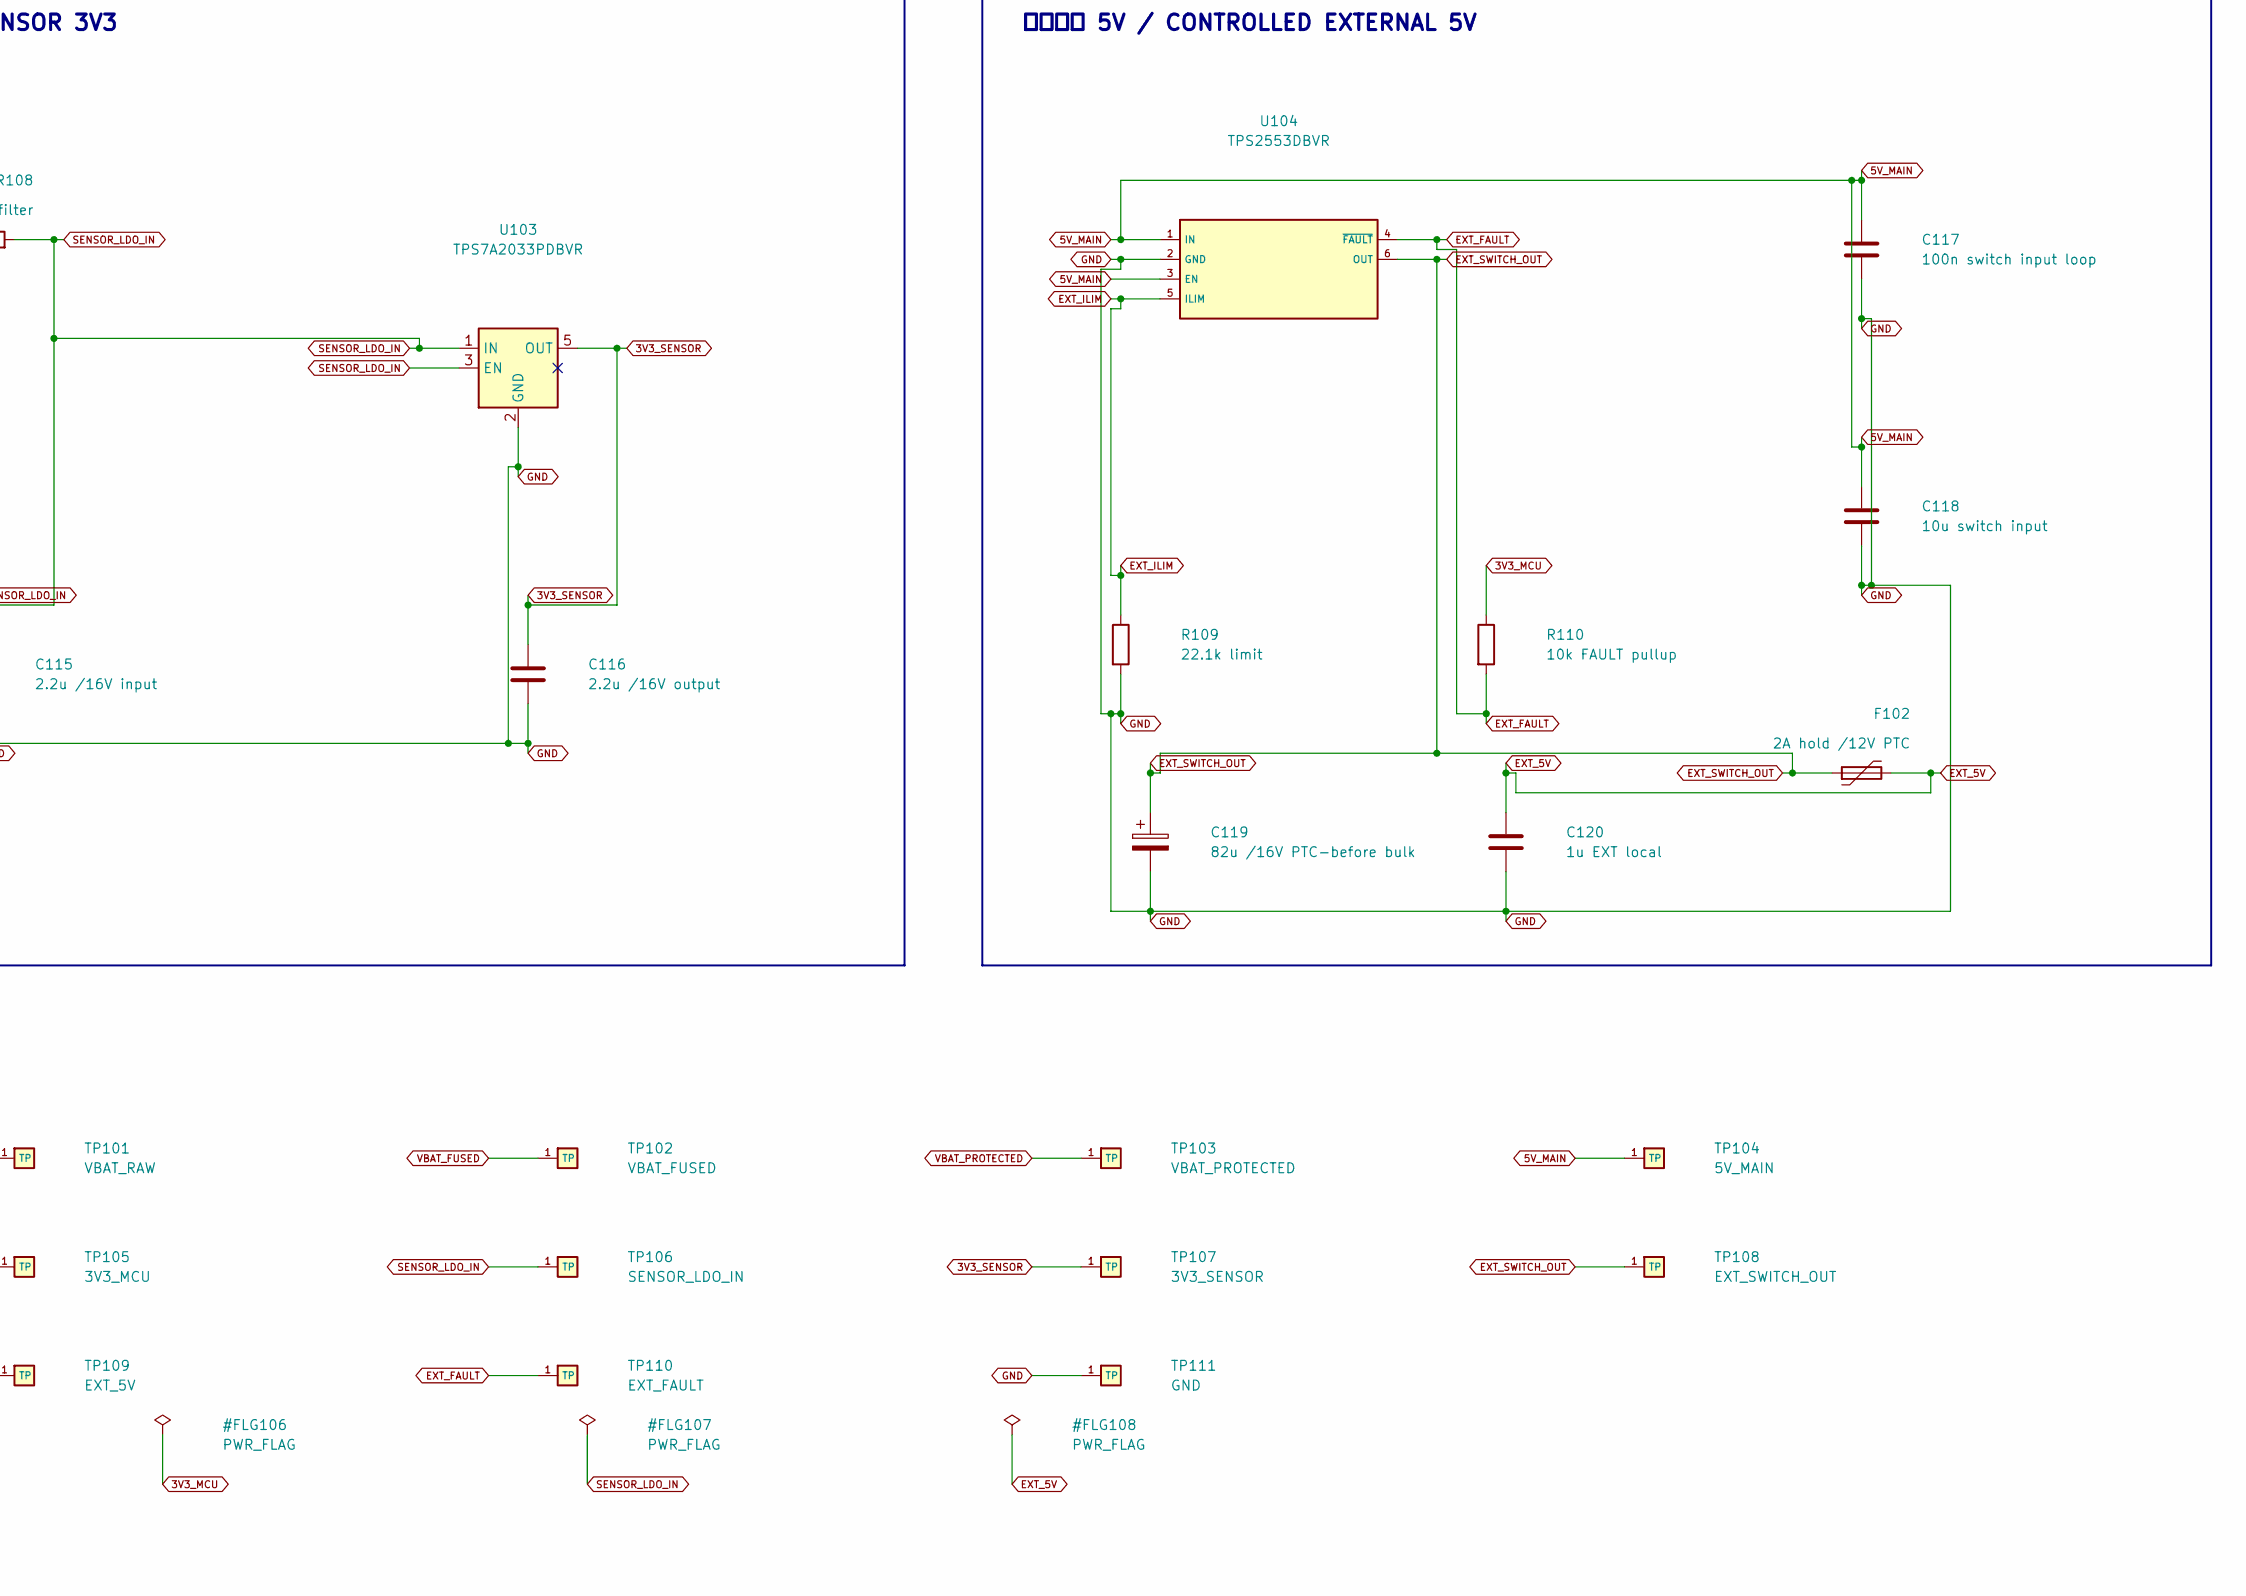
[picture p46: schematic 01_POWER.kicad_sch, part in row 2, column 2]

Parts:
C101, C102, C103, C104: 10u /50V X7R; Official_Capacitor_SMD_C_1210_3225Metric; Tolerance 10%; Voltage Rating >=50V; MPN C1210C106K5RACTU
C105: 39u /50V +VIN; Panasonic_OSCON_E12; MPN 50SVPF39M
C106: 100n /50V 0603 VIN loop; Official_Capacitor_SMD_C_0603_1608Metric; Tolerance 10%; Voltage Rating >=50V; MPN C0603C104K5RACTU
C107: 100n BOOT-SW; Official_Capacitor_SMD_C_0603_1608Metric; Tolerance 10%; Voltage Rating >=50V; MPN C0603C104K5RACTU
C108: 180u /16V +5V_MAIN; Panasonic_OSCON_C6; MPN 16SVPF180M
C109: 22n COMP series; Official_Capacitor_SMD_C_0805_2012Metric; Tolerance 10%; Voltage Rating >=50V; MPN C0805C223K5RACTU
C110: 240p COMP pole; Official_Capacitor_SMD_C_0805_2012Metric; Tolerance 5%; Voltage Rating >=50V; MPN C0805C241J5GACTU
C111: 10u AP input; Official_Capacitor_SMD_C_1210_3225Metric; Tolerance 10%; Voltage Rating >=50V; MPN C1210C106K5RACTU
C112: 100n BST-SW; Official_Capacitor_SMD_C_0603_1608Metric; Tolerance 10%; Voltage Rating >=50V; MPN C0603C104K5RACTU
C113, C114: 22u /16V; Official_Capacitor_SMD_C_1210_3225Metric; Tolerance 10%; Voltage Rating >=16V; MPN C1210C226K4RACTU
C115: 2.2u /16V input; Official_Capacitor_SMD_C_0805_2012Metric; Tolerance 10%; Voltage Rating >=16V; MPN C0805C225K4RACTU
C116: 2.2u /16V output; Official_Capacitor_SMD_C_0805_2012Metric; Tolerance 10%; Voltage Rating >=16V; MPN C0805C225K4RACTU
C117: 100n switch input loop; Official_Capacitor_SMD_C_0603_1608Metric; Tolerance 10%; Voltage Rating >=50V; MPN C0603C104K5RACTU
C118: 10u switch input; Official_Capacitor_SMD_C_1210_3225Metric; Tolerance 10%; Voltage Rating >=50V; MPN C1210C106K5RACTU
C119: 82u /16V PTC-before bulk; Panasonic_OSCON_B6; MPN 16SVPF82M
C120: 1u EXT local; Official_Capacitor_SMD_C_0805_2012Metric; Tolerance 10%; Voltage Rating >=16V; MPN C0805C105K4RACTU
D101: 12V VGS clamp K=source; Official_Diode_SMD_D_SOD-123F; MPN BZT52H-C12,115
D102: 26V bidirectional TVS; Official_Diode_SMD_D_SMB; MPN SMBJ26CA-TR
D103: STPS8H100G-TR; STPS8H100G_D2PAK_A_K_TabK_NoVIP; MPN STPS8H100G-TR
F101: 3A /125V; Official_Fuse_Fuse_Littelfuse-NANO2-451_453; MPN 0451003.MRL
F102: 2A hold /12V PTC; Littelfuse1812L200_12DR; MPN 1812L200/12DR
L101: 10uH; Bourns_SRP1265A; MPN SRP1265A-100M
L102: 4.7uH design-calculated at 5V; Bourns_SRN6045; MPN SRN6045-4R7Y
Q101: DMP6023LSS-13; Official_Package_SO_SOIC-8_3.9x4.9mm_P1.27mm; MPN DMP6023LSS-13
R101: 20k; Official_Resistor_SMD_R_0805_2012Metric; Tolerance 1%; TCR<=100ppm/C; Voltage Rating >=100V; MPN RC0805FR-0720KL
R102: 294k; Official_Resistor_SMD_R_0805_2012Metric; Tolerance 1%; TCR<=100ppm/C; Voltage Rating >=100V; MPN RC0805FR-07294KL
R103: 54.9k; Official_Resistor_SMD_R_0805_2012Metric; Tolerance 1%; TCR<=100ppm/C; Voltage Rating >=100V; MPN RC0805FR-0754K9L
R104: 200k; Official_Resistor_SMD_R_0805_2012Metric; Tolerance 1%; TCR<=100ppm/C; Voltage Rating >=100V; MPN RC0805FR-07200KL
R105: 52.3k 0.1%; Official_Resistor_SMD_R_0805_2012Metric; Tolerance 0.1%; TCR<=25ppm/C; Voltage Rating >=100V; MPN RT0805BRD0752K3L
R106: 10k 0.1%; Official_Resistor_SMD_R_0805_2012Metric; Tolerance 0.1%; TCR<=25ppm/C; Voltage Rating >=100V; MPN RT0805BRD0710KL
R107: 18.7k; Official_Resistor_SMD_R_0805_2012Metric; Tolerance 1%; TCR<=100ppm/C; Voltage Rating >=100V; MPN RC0805FR-0718K7L
R108: 10R RC sensor filter; Official_Resistor_SMD_R_0805_2012Metric; Tolerance 1%; TCR<=100ppm/C; Voltage Rating >=100V; MPN RC0805FR-0710RL
R109: 22.1k limit; Official_Resistor_SMD_R_0805_2012Metric; Tolerance 1%; TCR<=100ppm/C; Voltage Rating >=100V; MPN RC0805FR-0722K1L
R110: 10k FAULT pullup; Official_Resistor_SMD_R_0805_2012Metric; Tolerance 1%; TCR<=100ppm/C; Voltage Rating >=100V; MPN RC0805FR-0710KL
TP101: VBAT_RAW; TP1p5_NoPaste; MPN TP1p5
TP102: VBAT_FUSED; TP1p5_NoPaste; MPN TP1p5
TP103: VBAT_PROTECTED; TP1p5_NoPaste; MPN TP1p5
TP104: 5V_MAIN; TP1p5_NoPaste; MPN TP1p5
TP105: 3V3_MCU; TP1p5_NoPaste; MPN TP1p5
TP106: SENSOR_LDO_IN; TP1p5_NoPaste; MPN TP1p5
TP107: 3V3_SENSOR; TP1p5_NoPaste; MPN TP1p5
TP108: EXT_SWITCH_OUT; TP1p5_NoPaste; MPN TP1p5
TP109: EXT_5V; TP1p5_NoPaste; MPN TP1p5
TP110: EXT_FAULT; TP1p5_NoPaste; MPN TP1p5
TP111: GND; TP1p5_NoPaste; MPN TP1p5
U101: TPS54360BDDAR; TPS54360B_DDA0008B_NoVIP; MPN TPS54360BDDAR
U102: AP63203WU-7; Official_Package_TO_SOT_SMD_TSOT-23-6; MPN AP63203WU-7
U103: TPS7A2033PDBVR; Official_Package_TO_SOT_SMD_SOT-23-5; MPN TPS7A2033PDBVR
U104: TPS2553DBVR; Official_Package_TO_SOT_SMD_SOT-23-6; MPN TPS2553DBVR

Connections:
3V3_MCU: C113.1, C114.1, L102.2, R110.1, TP105.1 (TP_1), U102.1 (FB); also elsewhere on the board
3V3_SENSOR: C116.1, TP107.1 (TP_1), U103.5 (OUT); also elsewhere on the board
5V_MAIN: C108.1, C111.1, C117.1, C118.1, L101.2, R105.1, R108.1, TP104.1 (TP_1), U102.2 (EN), U102.3 (IN), U104.1 (IN), U104.3 (EN)
EXT_5V: C120.1, F102.2, TP109.1 (TP_1); also elsewhere on the board
EXT_FAULT: R110.2, TP110.1 (TP_1), U104.4 (~FAULT)
EXT_ILIM: R109.1, U104.5 (ILIM)
EXT_SWITCH_OUT: C119.1, F102.1, TP108.1 (TP_1), U104.6 (OUT)
GND: C101.2, C102.2, C103.2, C104.2, C105.2, C106.2, C108.2, C109.2, C110.2, C111.2, C113.2, C114.2, C115.2, C116.2, C117.2, C118.2, C119.2, C120.2, D102.2 (A2), D103.A, R101.2, R103.2, R104.2, R106.2, R109.2, TP111.1 (TP_1), U101.7 (GND), U101.9 (GNDPAD), U102.4 (GND), U103.2 (GND), U104.2 (GND); also elsewhere on the board
MAIN_BOOT: C107.1, U101.1 (BOOT)
MAIN_COMP: C110.1, R107.1, U101.6 (COMP)
MAIN_COMP_RC: C109.1, R107.2
MAIN_EN: R102.2, R103.1, U101.3 (EN)
MAIN_FB: R105.2, R106.1, U101.5 (FB)
MAIN_RT: R104.1, U101.4 (RT/CLK)
MAIN_SW: C107.2, D103.K (K_TAB), L101.1, U101.8 (SW)
MCU_BOOT: C112.1, U102.6 (BST)
MCU_SW: C112.2, L102.1, U102.5 (SW)
RP_GATE: D101.2 (A), Q101.4 (G), R101.1
SENSOR_LDO_IN: C115.1, R108.2, TP106.1 (TP_1), U103.1 (IN), U103.3 (EN)
VBAT_FUSED: F101.2, Q101.5 (D), Q101.6 (D), Q101.7 (D), Q101.8 (D), TP102.1 (TP_1)
VBAT_PROTECTED: C101.1, C102.1, C103.1, C104.1, C105.1, C106.1, D101.1 (K), D102.1 (A1), Q101.1 (S), Q101.2 (S), Q101.3 (S), R102.1, TP103.1 (TP_1), U101.2 (VIN); also elsewhere on the board
VBAT_RAW: F101.1, TP101.1 (TP_1); also elsewhere on the board

Notes on the sheet:
MAIN 5V: battery/bench only, 3S-6S. USB is never a supply.
TPS2553 constant-current limiting; recovers after overload removal, subject to thermal protection.
01 电源管理 / POWER MANAGEMENT
VBAT 输入与保护 / VBAT INPUT AND PROTECTION
VBAT_RAW → VBAT_FUSED → VBAT_PROTECTED
主 5V 降压电源 / MAIN 5V BUCK
BOOT / SW / EN / RT / FB / COMP — 原网络保持
MCU 3.3V 电源 / MCU 3V3 SUPPLY
传感器 3.3V 电源 / SENSOR 3V3
受控外部 5V / CONTROLLED EXTERNAL 5V
VBAT / MAIN 5V
MCU / SENSOR POWER
EXTERNAL 5V / GND
