chen123037/X100-Flight-Controller-Edu/hardware/proposals/J401_AMPHENOL_UNAPPROVED/X100_CleanSheet.kicad_pcb

## KiCad design hardware/proposals/J401_AMPHENOL_UNAPPROVED/X100_CleanSheet.kicad_pcb (continued)

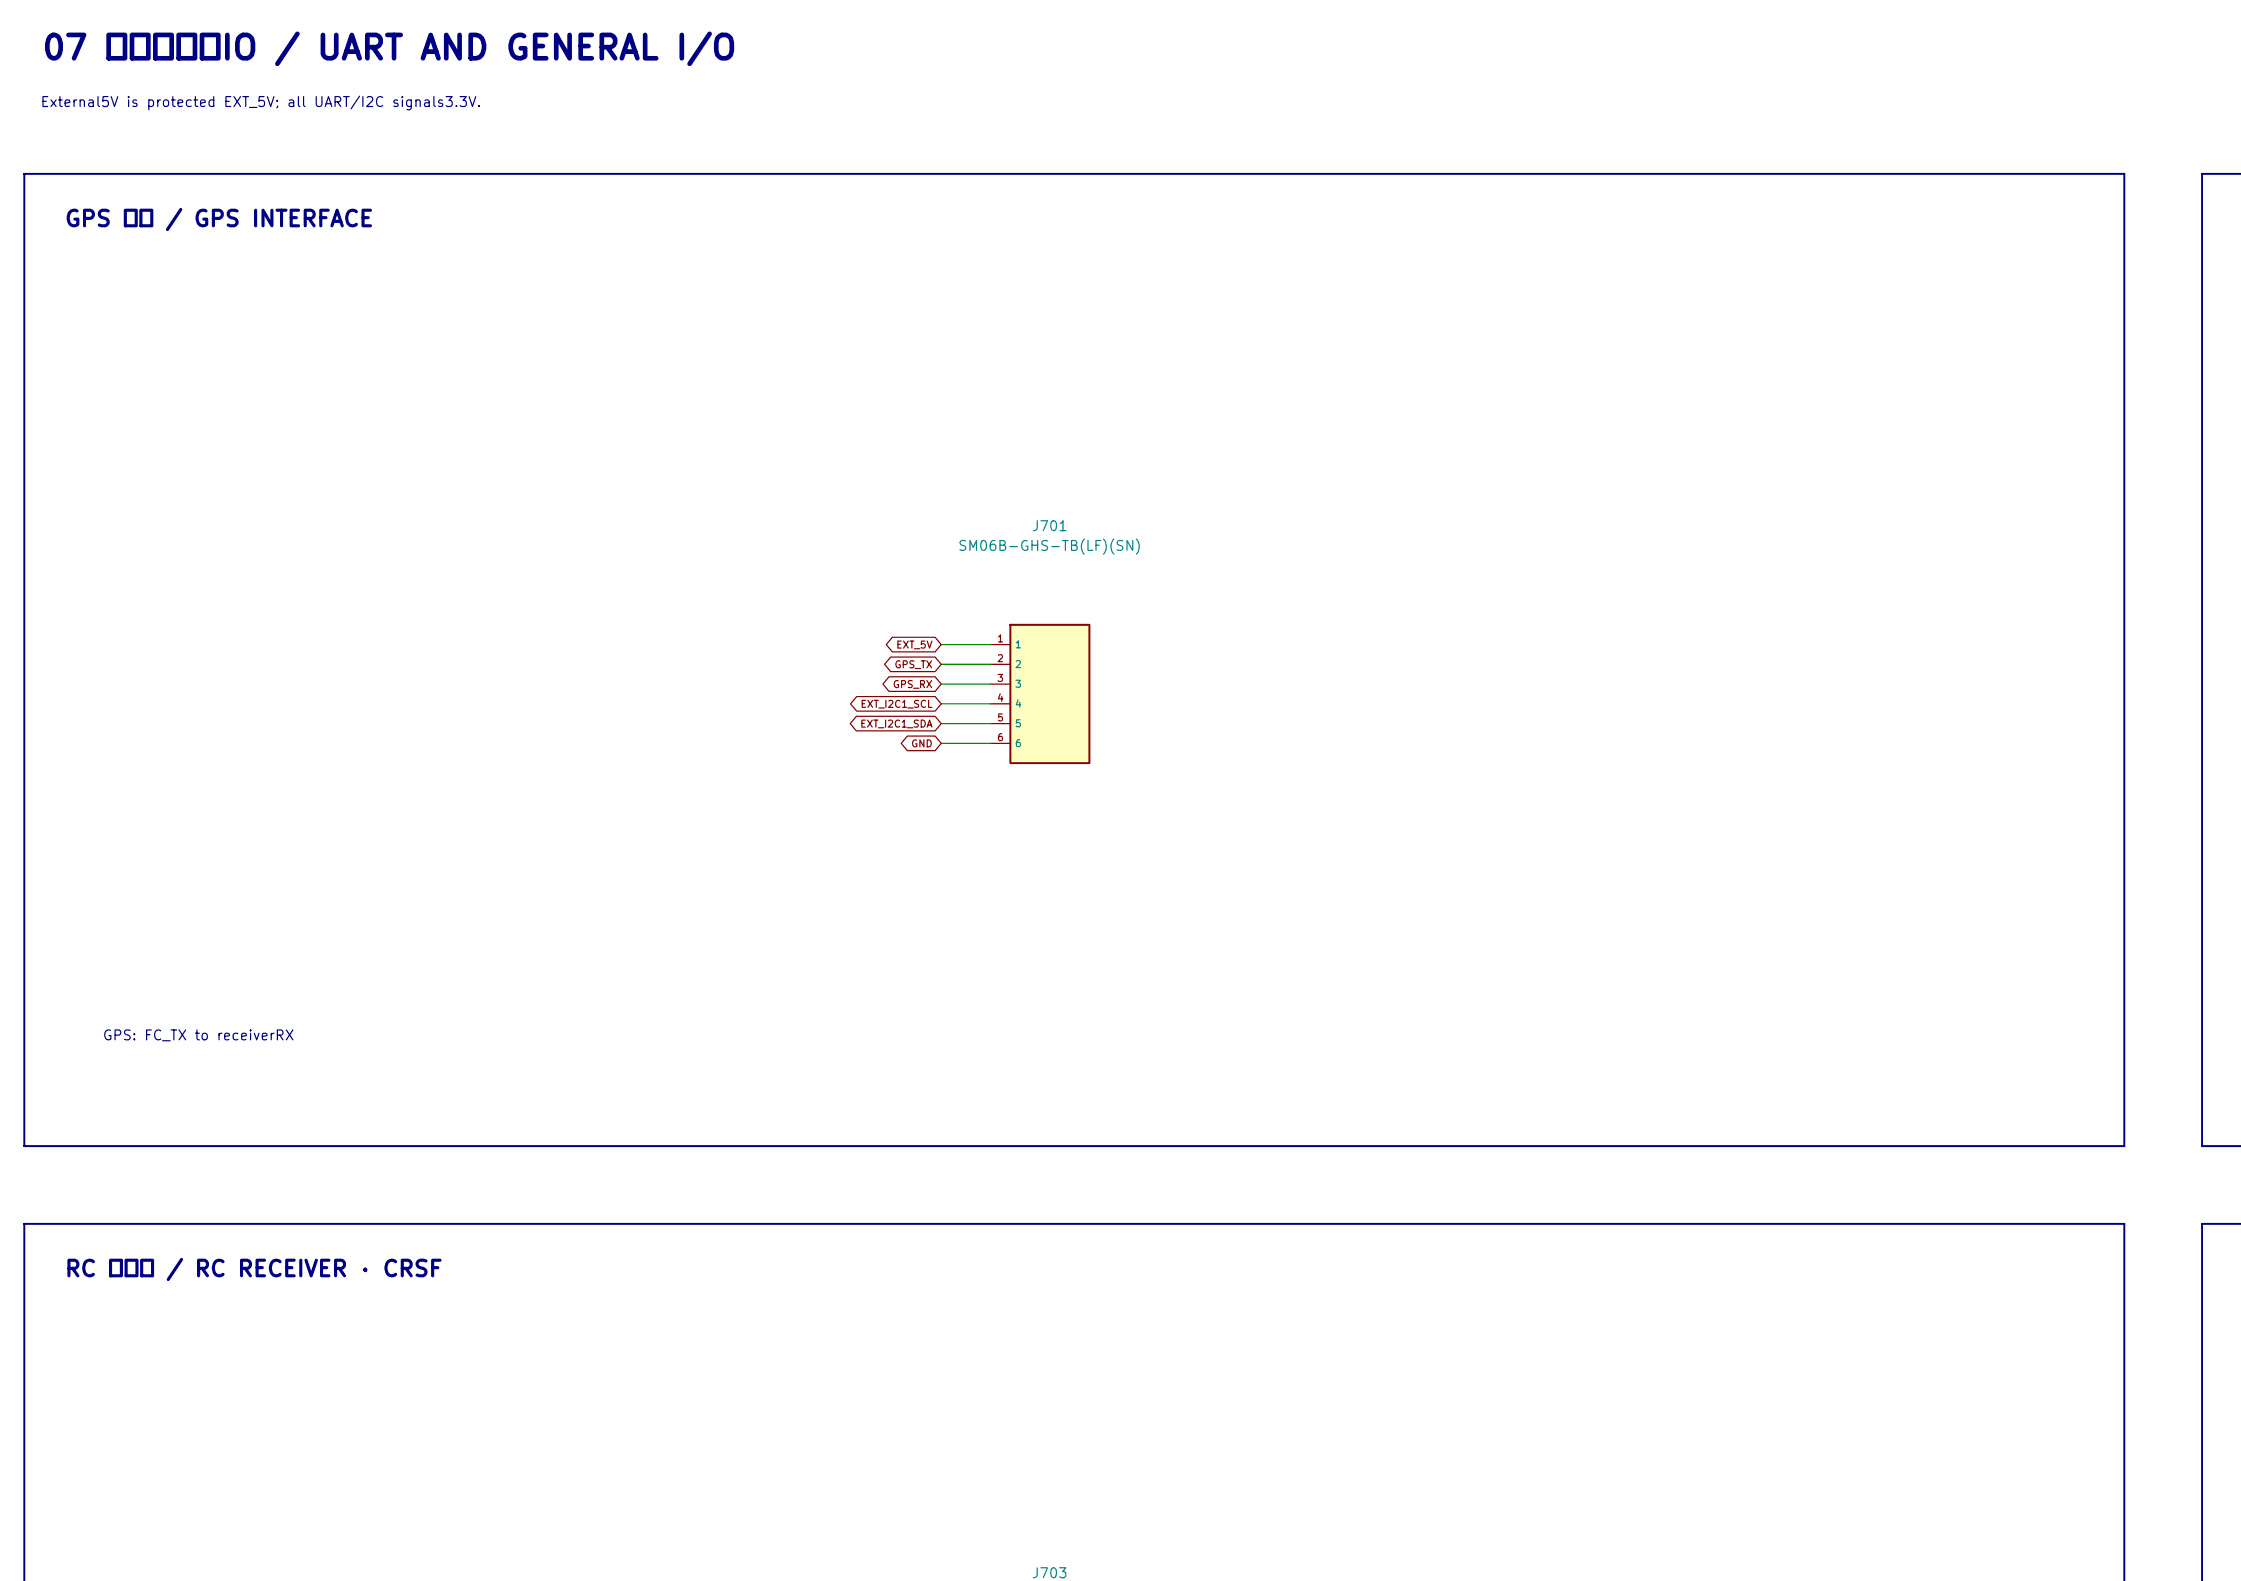
[picture p67: schematic 07_UART_IO.kicad_sch, part in row 1, column 1]

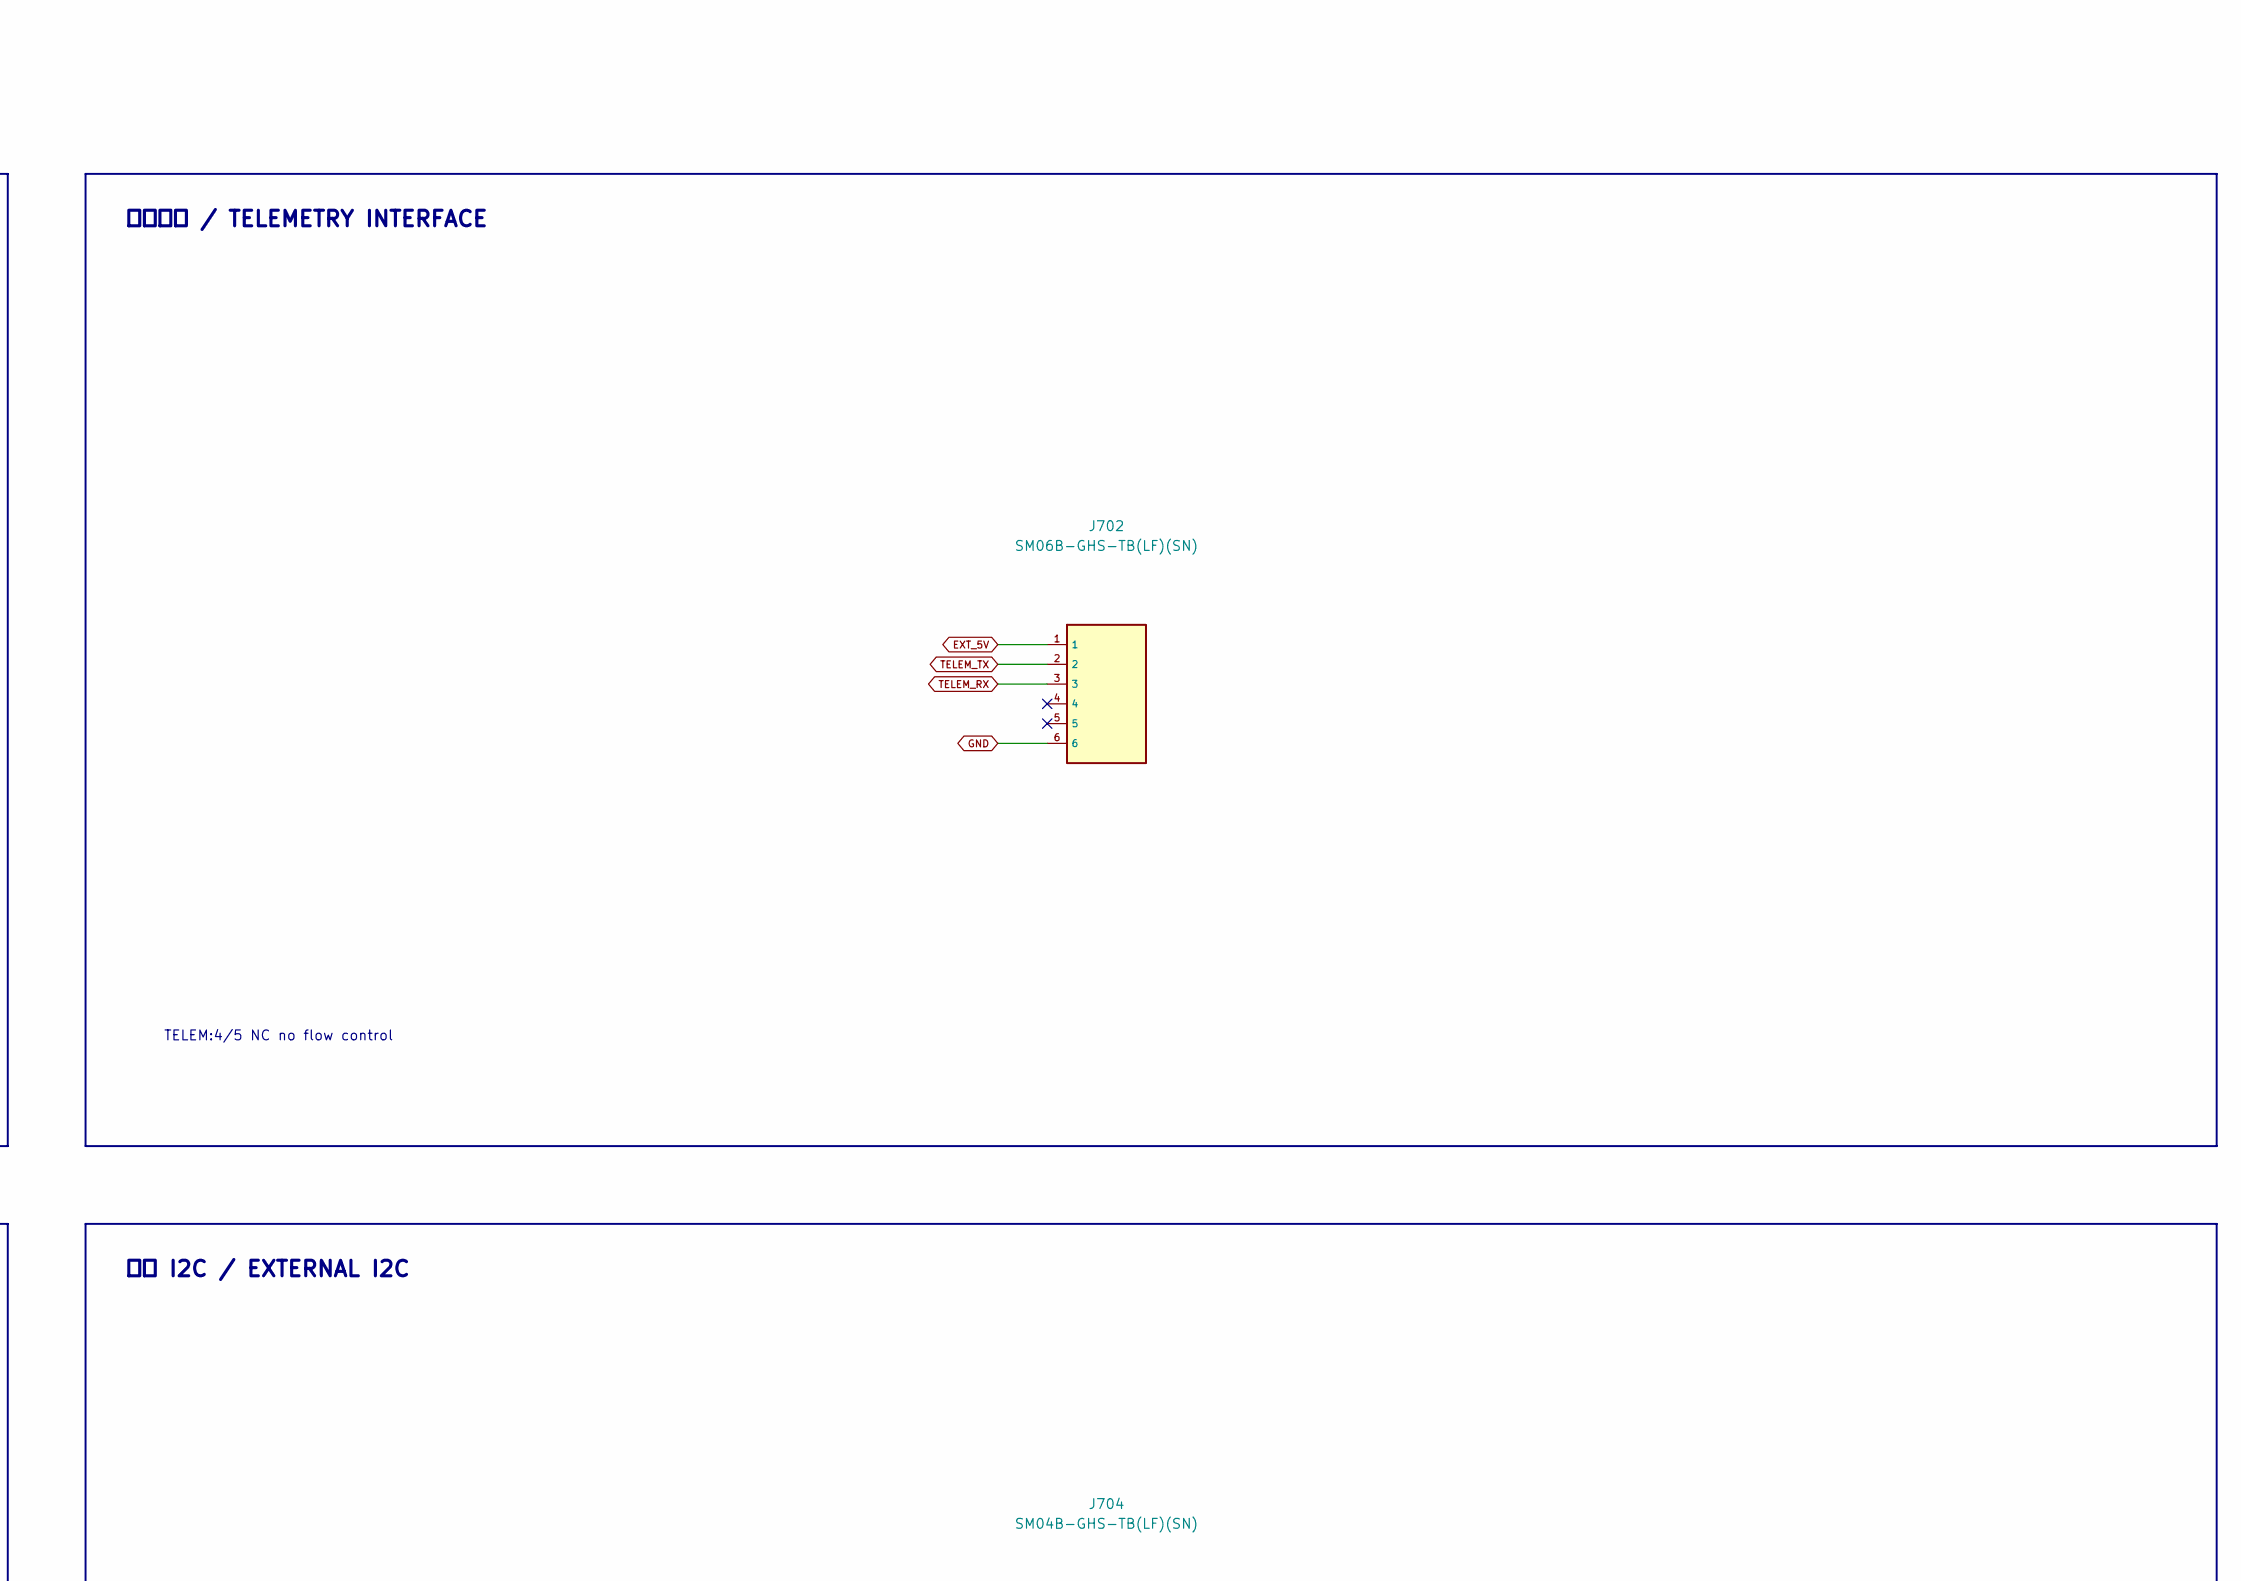
[picture p68: schematic 07_UART_IO.kicad_sch, part in row 1, column 2]

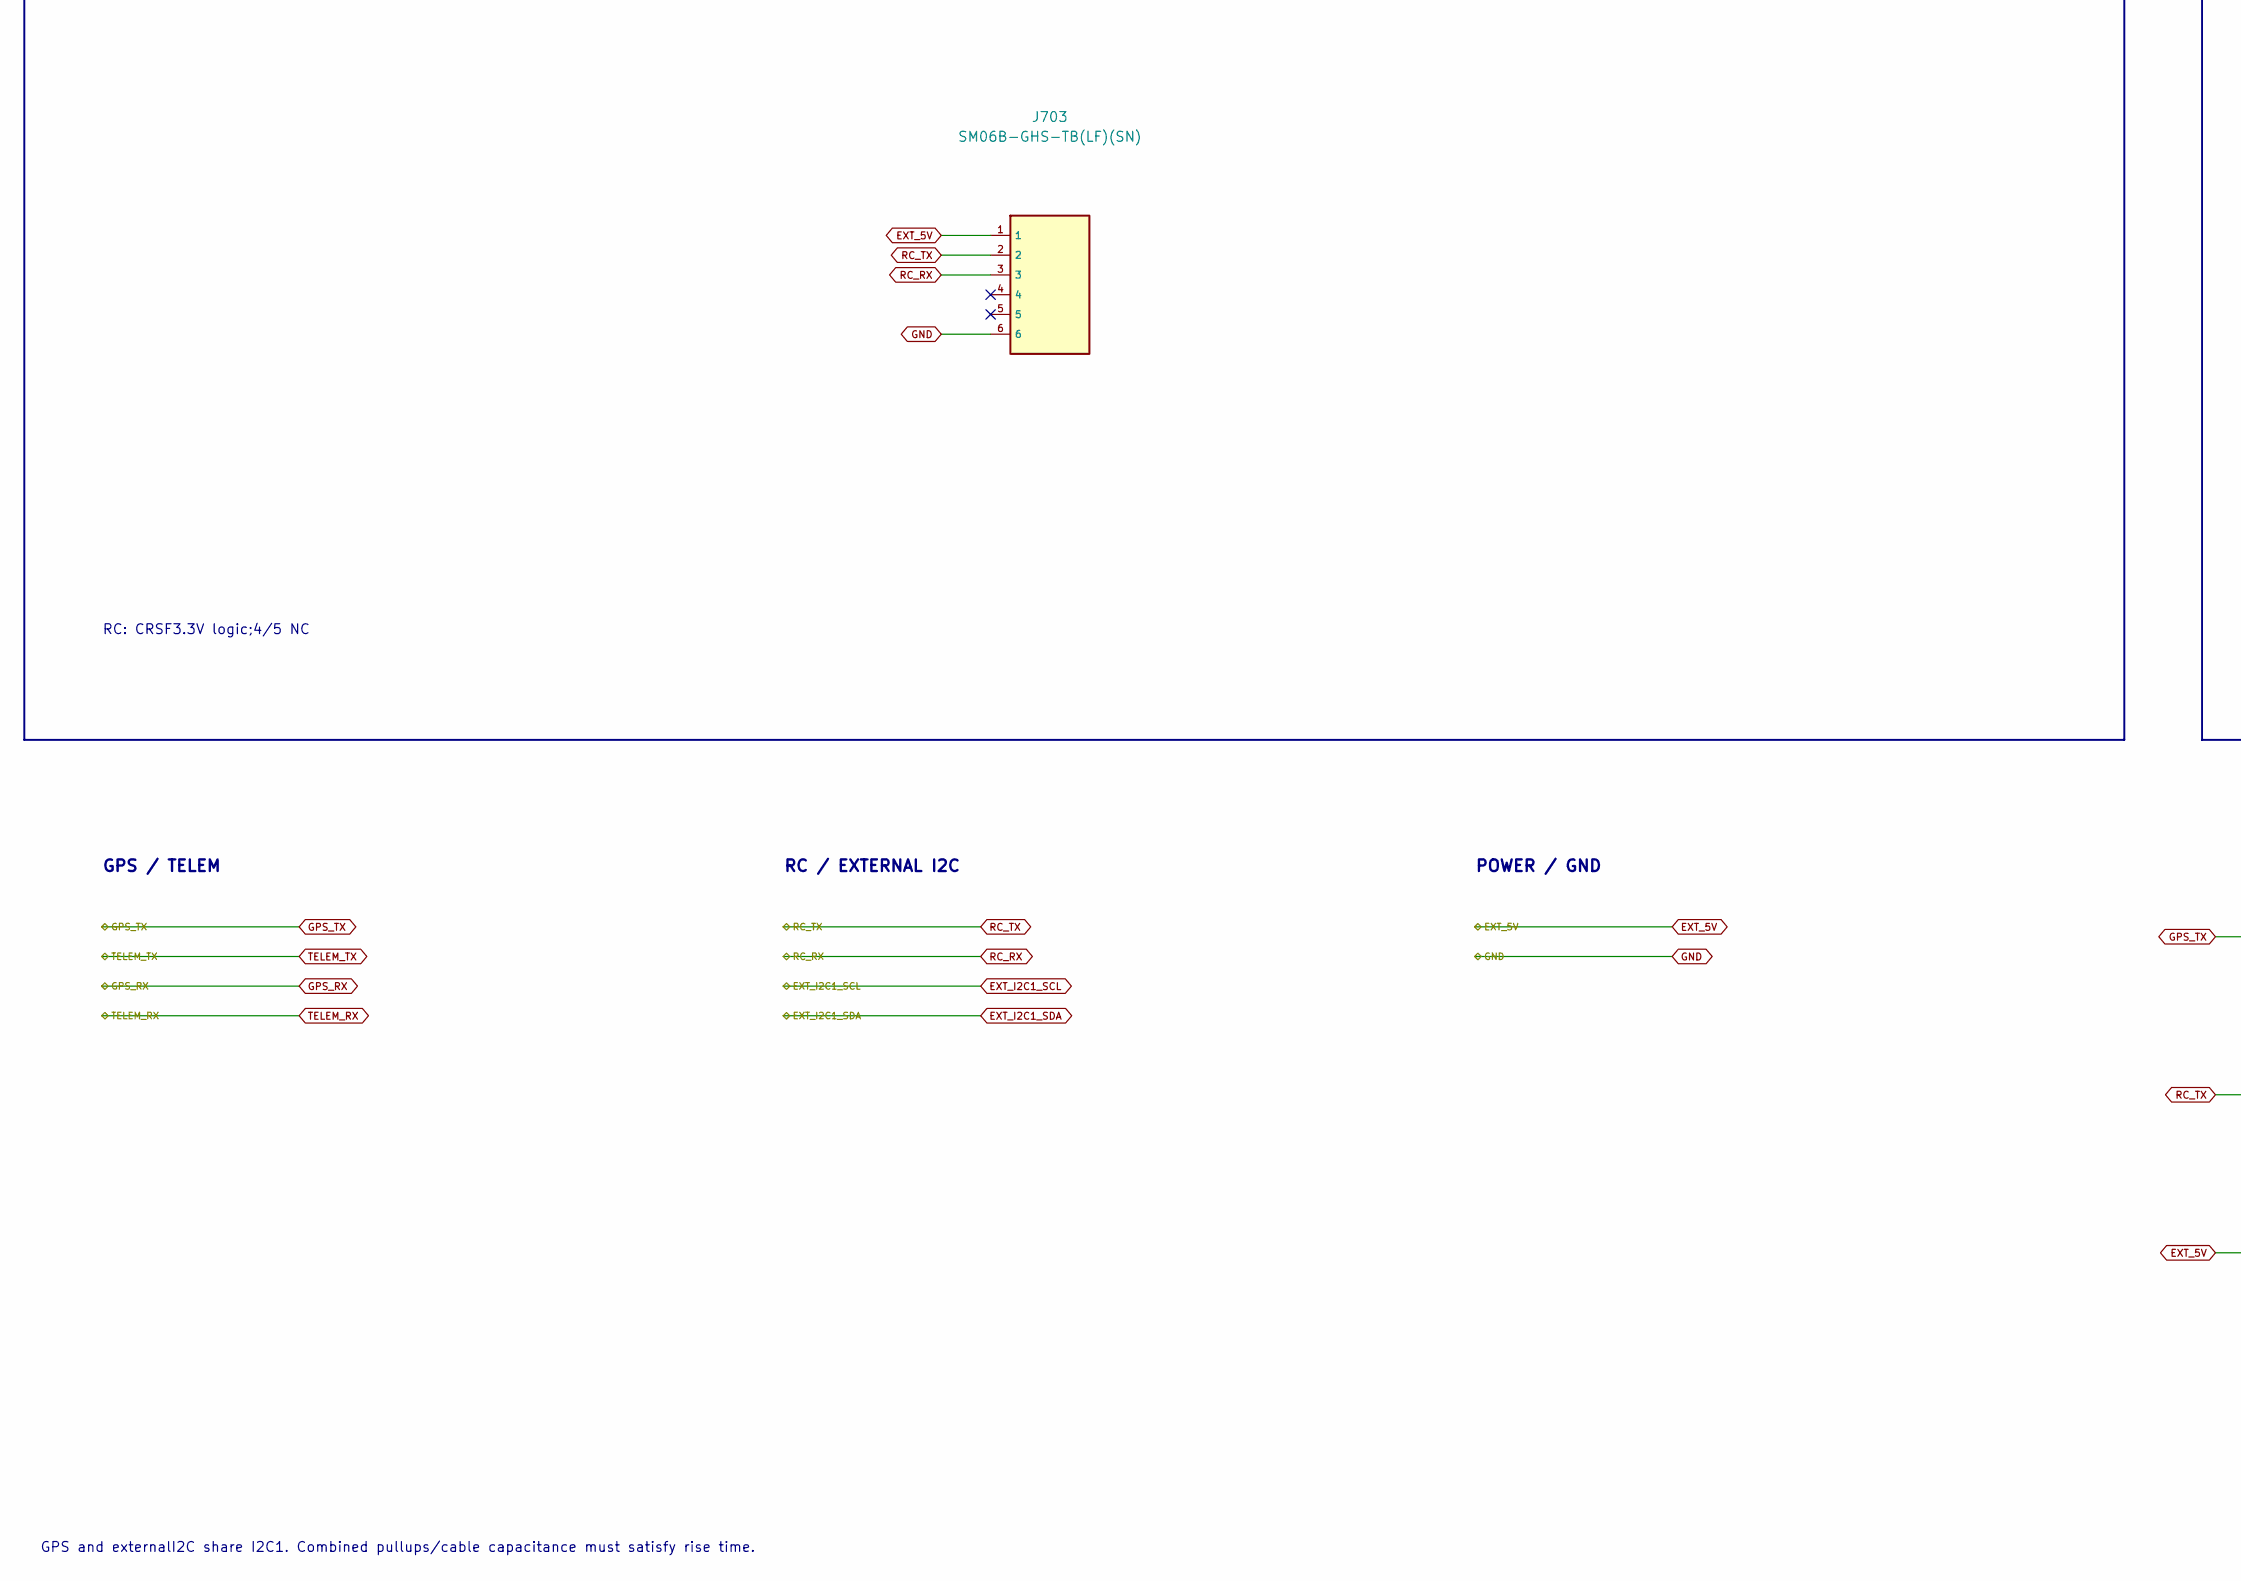
[picture p69: schematic 07_UART_IO.kicad_sch, part in row 2, column 1]

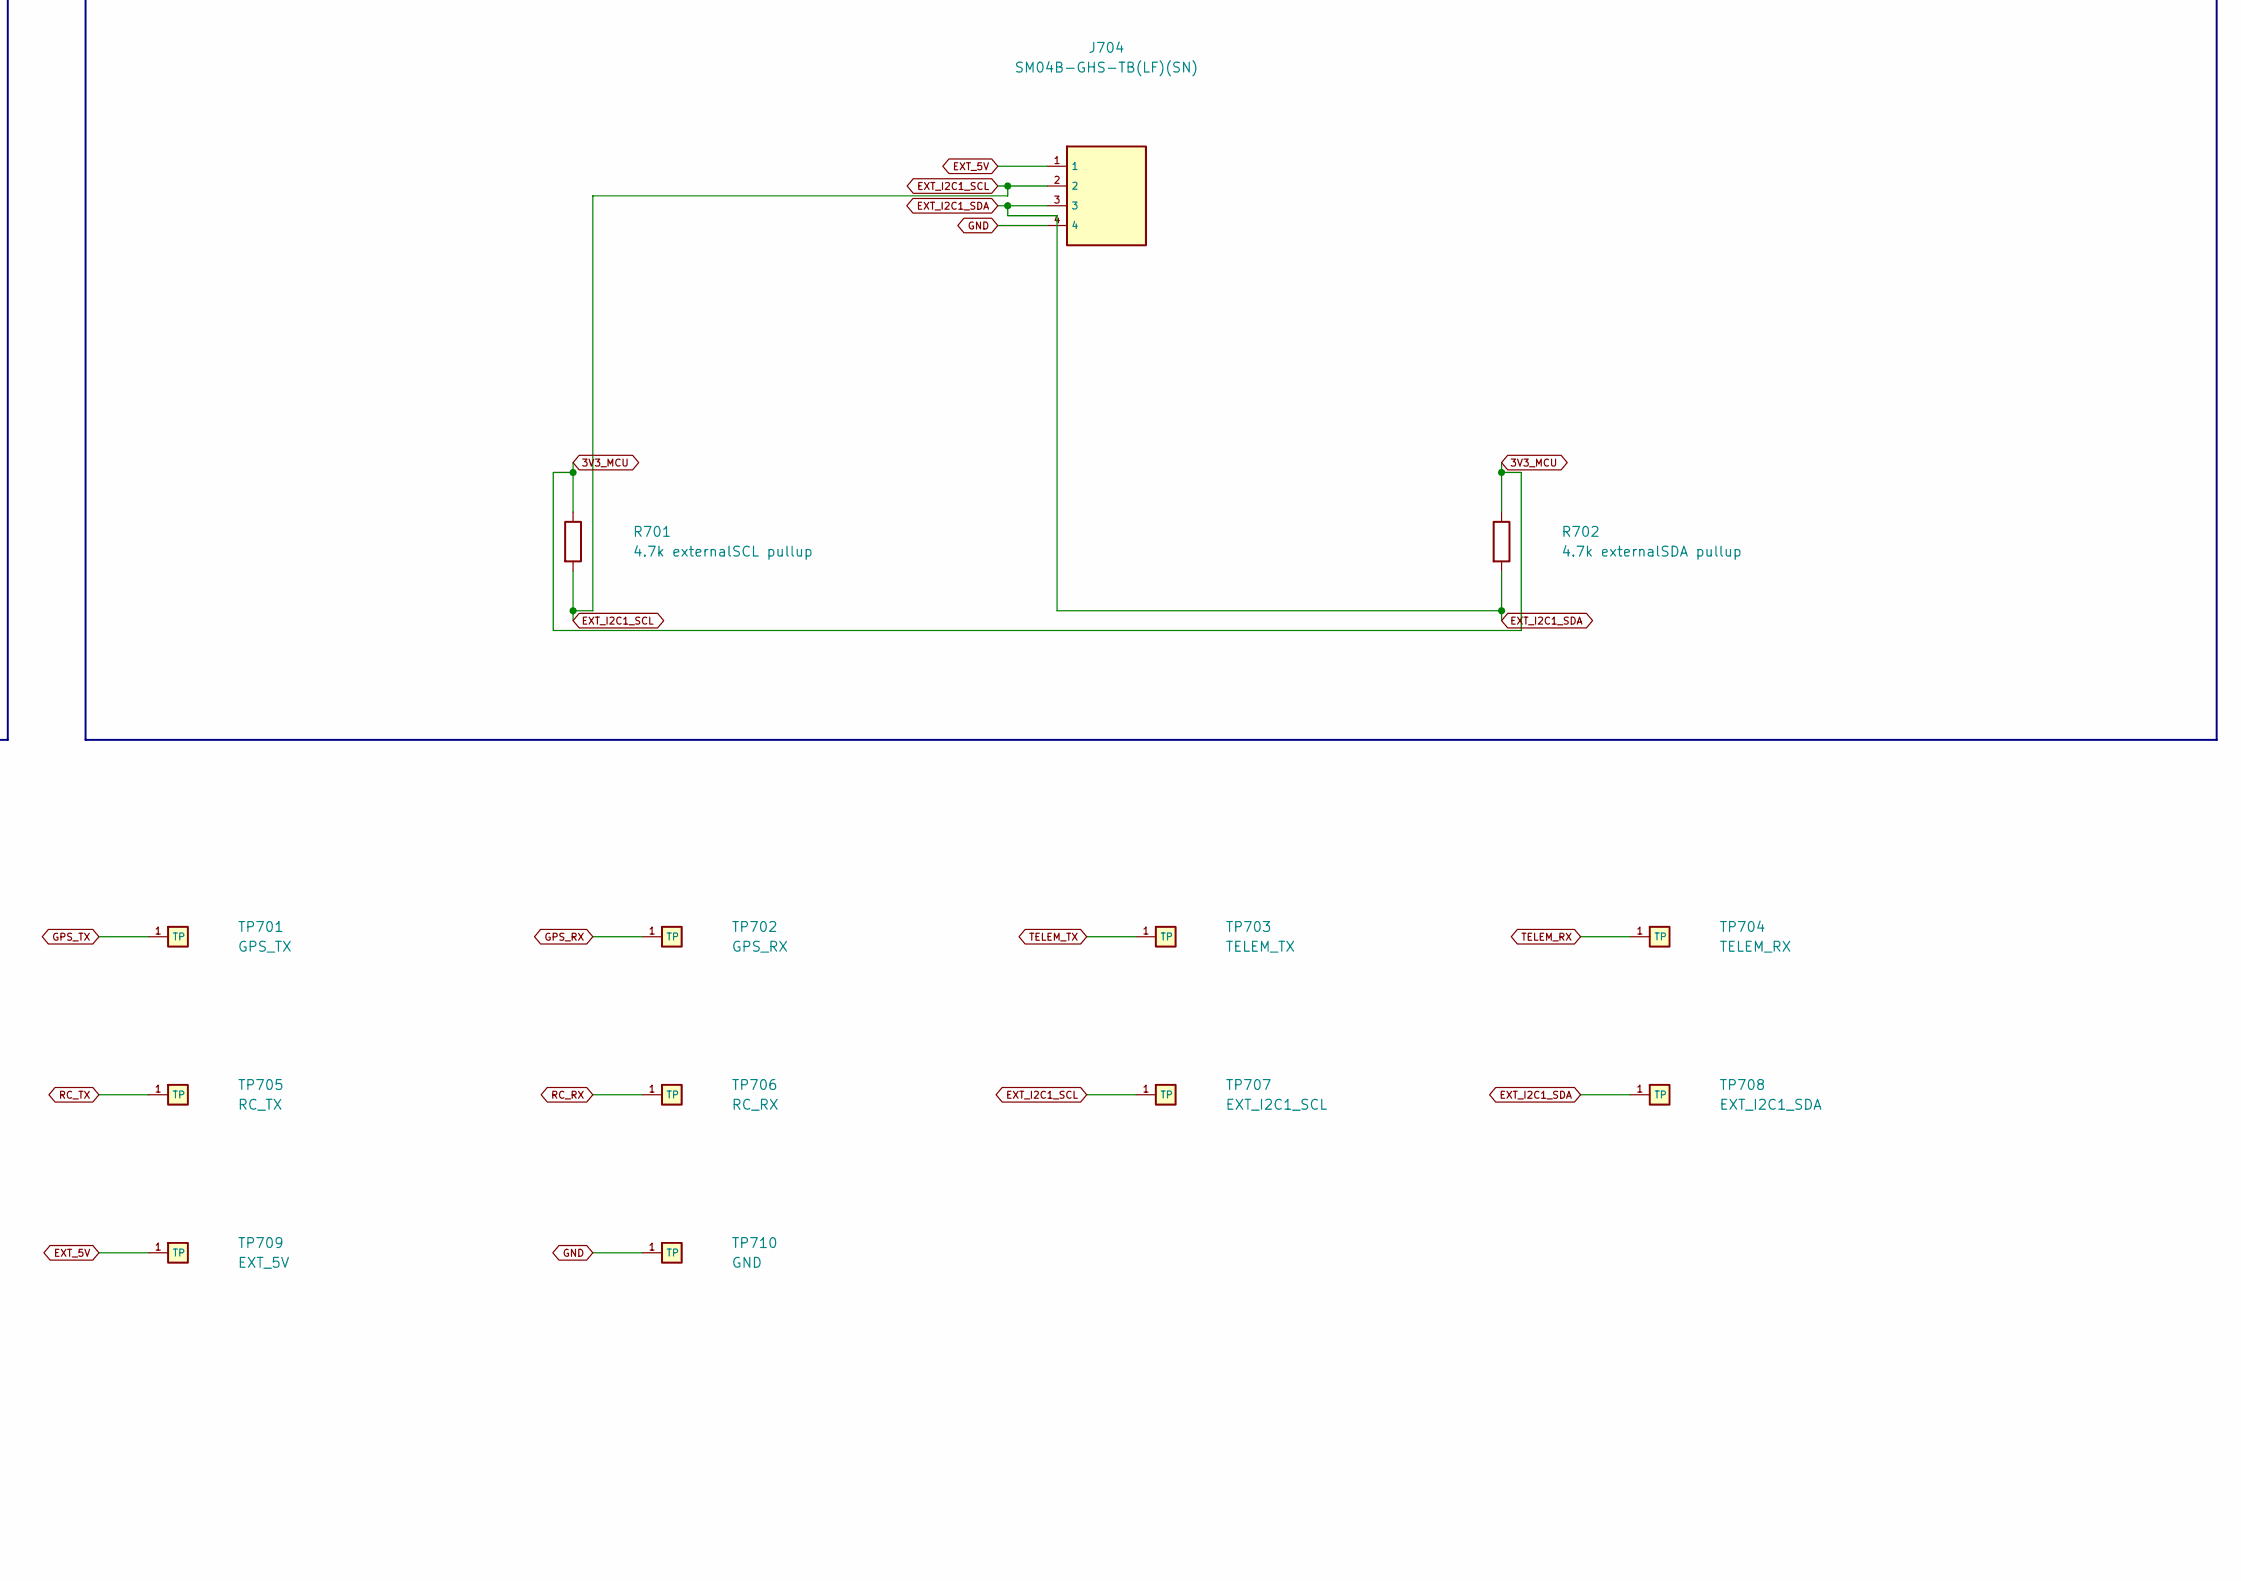
[picture p70: schematic 07_UART_IO.kicad_sch, part in row 2, column 2]

Parts:
J701, J702, J703: SM06B-GHS-TB(LF)(SN); Official_Connector_JST_JST_GH_SM06B-GHS-TB_1x06-1MP_P1.25mm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; MPN SM06B-GHS-TB(LF)(SN)
J704: SM04B-GHS-TB(LF)(SN); Official_Connector_JST_JST_GH_SM04B-GHS-TB_1x04-1MP_P1.25mm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; MPN SM04B-GHS-TB(LF)(SN)
R701: 4.7k externalSCL pullup; Official_Resistor_SMD_R_0805_2012Metric; Tolerance 1%; TCR<=100ppm/C; Voltage Rating >=100V; MPN RC0805FR-074K7L
R702: 4.7k externalSDA pullup; Official_Resistor_SMD_R_0805_2012Metric; Tolerance 1%; TCR<=100ppm/C; Voltage Rating >=100V; MPN RC0805FR-074K7L
TP701: GPS_TX; TP1p5_NoPaste; MPN TP1p5
TP702: GPS_RX; TP1p5_NoPaste; MPN TP1p5
TP703: TELEM_TX; TP1p5_NoPaste; MPN TP1p5
TP704: TELEM_RX; TP1p5_NoPaste; MPN TP1p5
TP705: RC_TX; TP1p5_NoPaste; MPN TP1p5
TP706: RC_RX; TP1p5_NoPaste; MPN TP1p5
TP707: EXT_I2C1_SCL; TP1p5_NoPaste; MPN TP1p5
TP708: EXT_I2C1_SDA; TP1p5_NoPaste; MPN TP1p5
TP709: EXT_5V; TP1p5_NoPaste; MPN TP1p5
TP710: GND; TP1p5_NoPaste; MPN TP1p5

Connections:
3V3_MCU: R701.1, R702.1; also elsewhere on the board
EXT_5V: J701.1, J702.1, J703.1, J704.1, TP709.1 (TP_1); also elsewhere on the board
EXT_I2C1_SCL: J701.4, J704.2, R701.2, TP707.1 (TP_1); also elsewhere on the board
EXT_I2C1_SDA: J701.5, J704.3, R702.2, TP708.1 (TP_1); also elsewhere on the board
GND: J701.6, J702.6, J703.6, J704.4, TP710.1 (TP_1); also elsewhere on the board
GPS_RX: J701.3, TP702.1 (TP_1); also elsewhere on the board
GPS_TX: J701.2, TP701.1 (TP_1); also elsewhere on the board
RC_RX: J703.3, TP706.1 (TP_1); also elsewhere on the board
RC_TX: J703.2, TP705.1 (TP_1); also elsewhere on the board
TELEM_RX: J702.3, TP704.1 (TP_1); also elsewhere on the board
TELEM_TX: J702.2, TP703.1 (TP_1); also elsewhere on the board

Notes on the sheet:
External5V is protected EXT_5V; all UART/I2C signals3.3V.
GPS: FC_TX to receiverRX
TELEM:4/5 NC no flow control
RC: CRSF3.3V logic;4/5 NC
GPS and externalI2C share I2C1. Combined pullups/cable capacitance must satisfy rise time.
07 串口与通用IO / UART AND GENERAL I/O
GPS 接口 / GPS INTERFACE
遥测接口 / TELEMETRY INTERFACE
RC 接收机 / RC RECEIVER · CRSF
外部 I2C / EXTERNAL I2C
GPS / TELEM
RC / EXTERNAL I2C
POWER / GND
