chen123037/X100-Flight-Controller-Edu/hardware/proposals/J401_AMPHENOL_UNAPPROVED/X100_CleanSheet.kicad_pcb

## KiCad design hardware/proposals/J401_AMPHENOL_UNAPPROVED/X100_CleanSheet.kicad_pcb (continued)

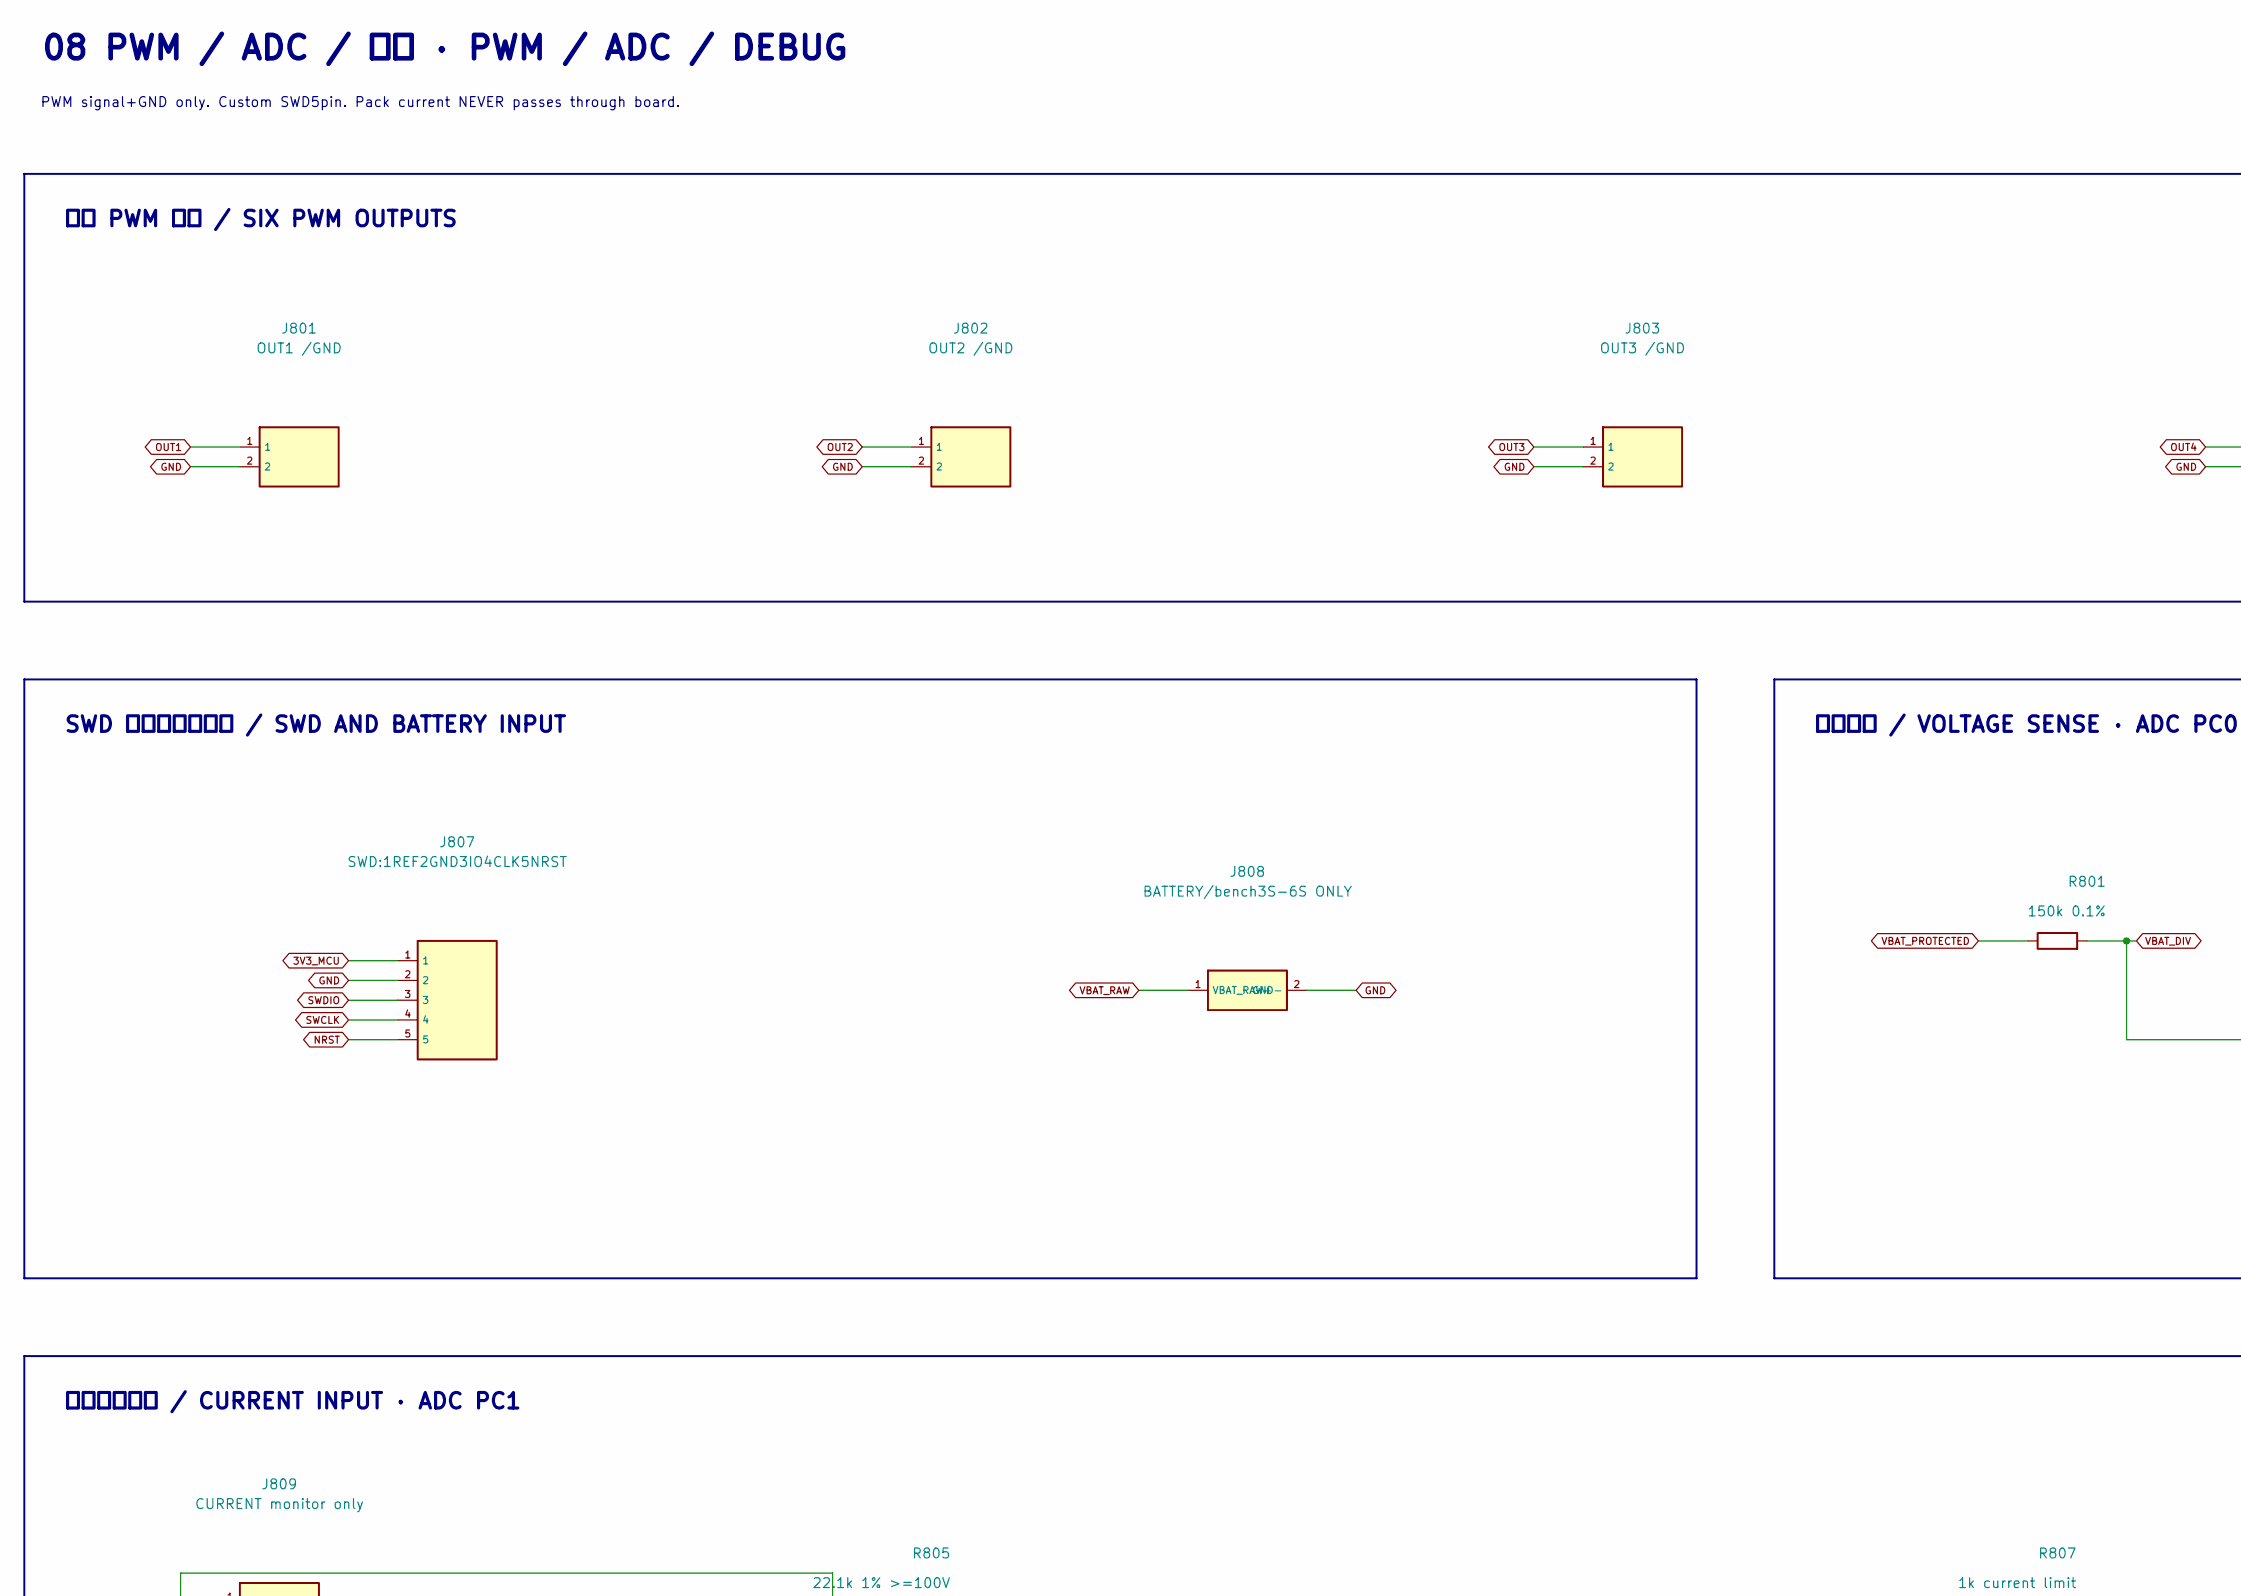
[picture p71: schematic 08_PWM_ADC_DEBUG.kicad_sch, part in row 1, column 1]

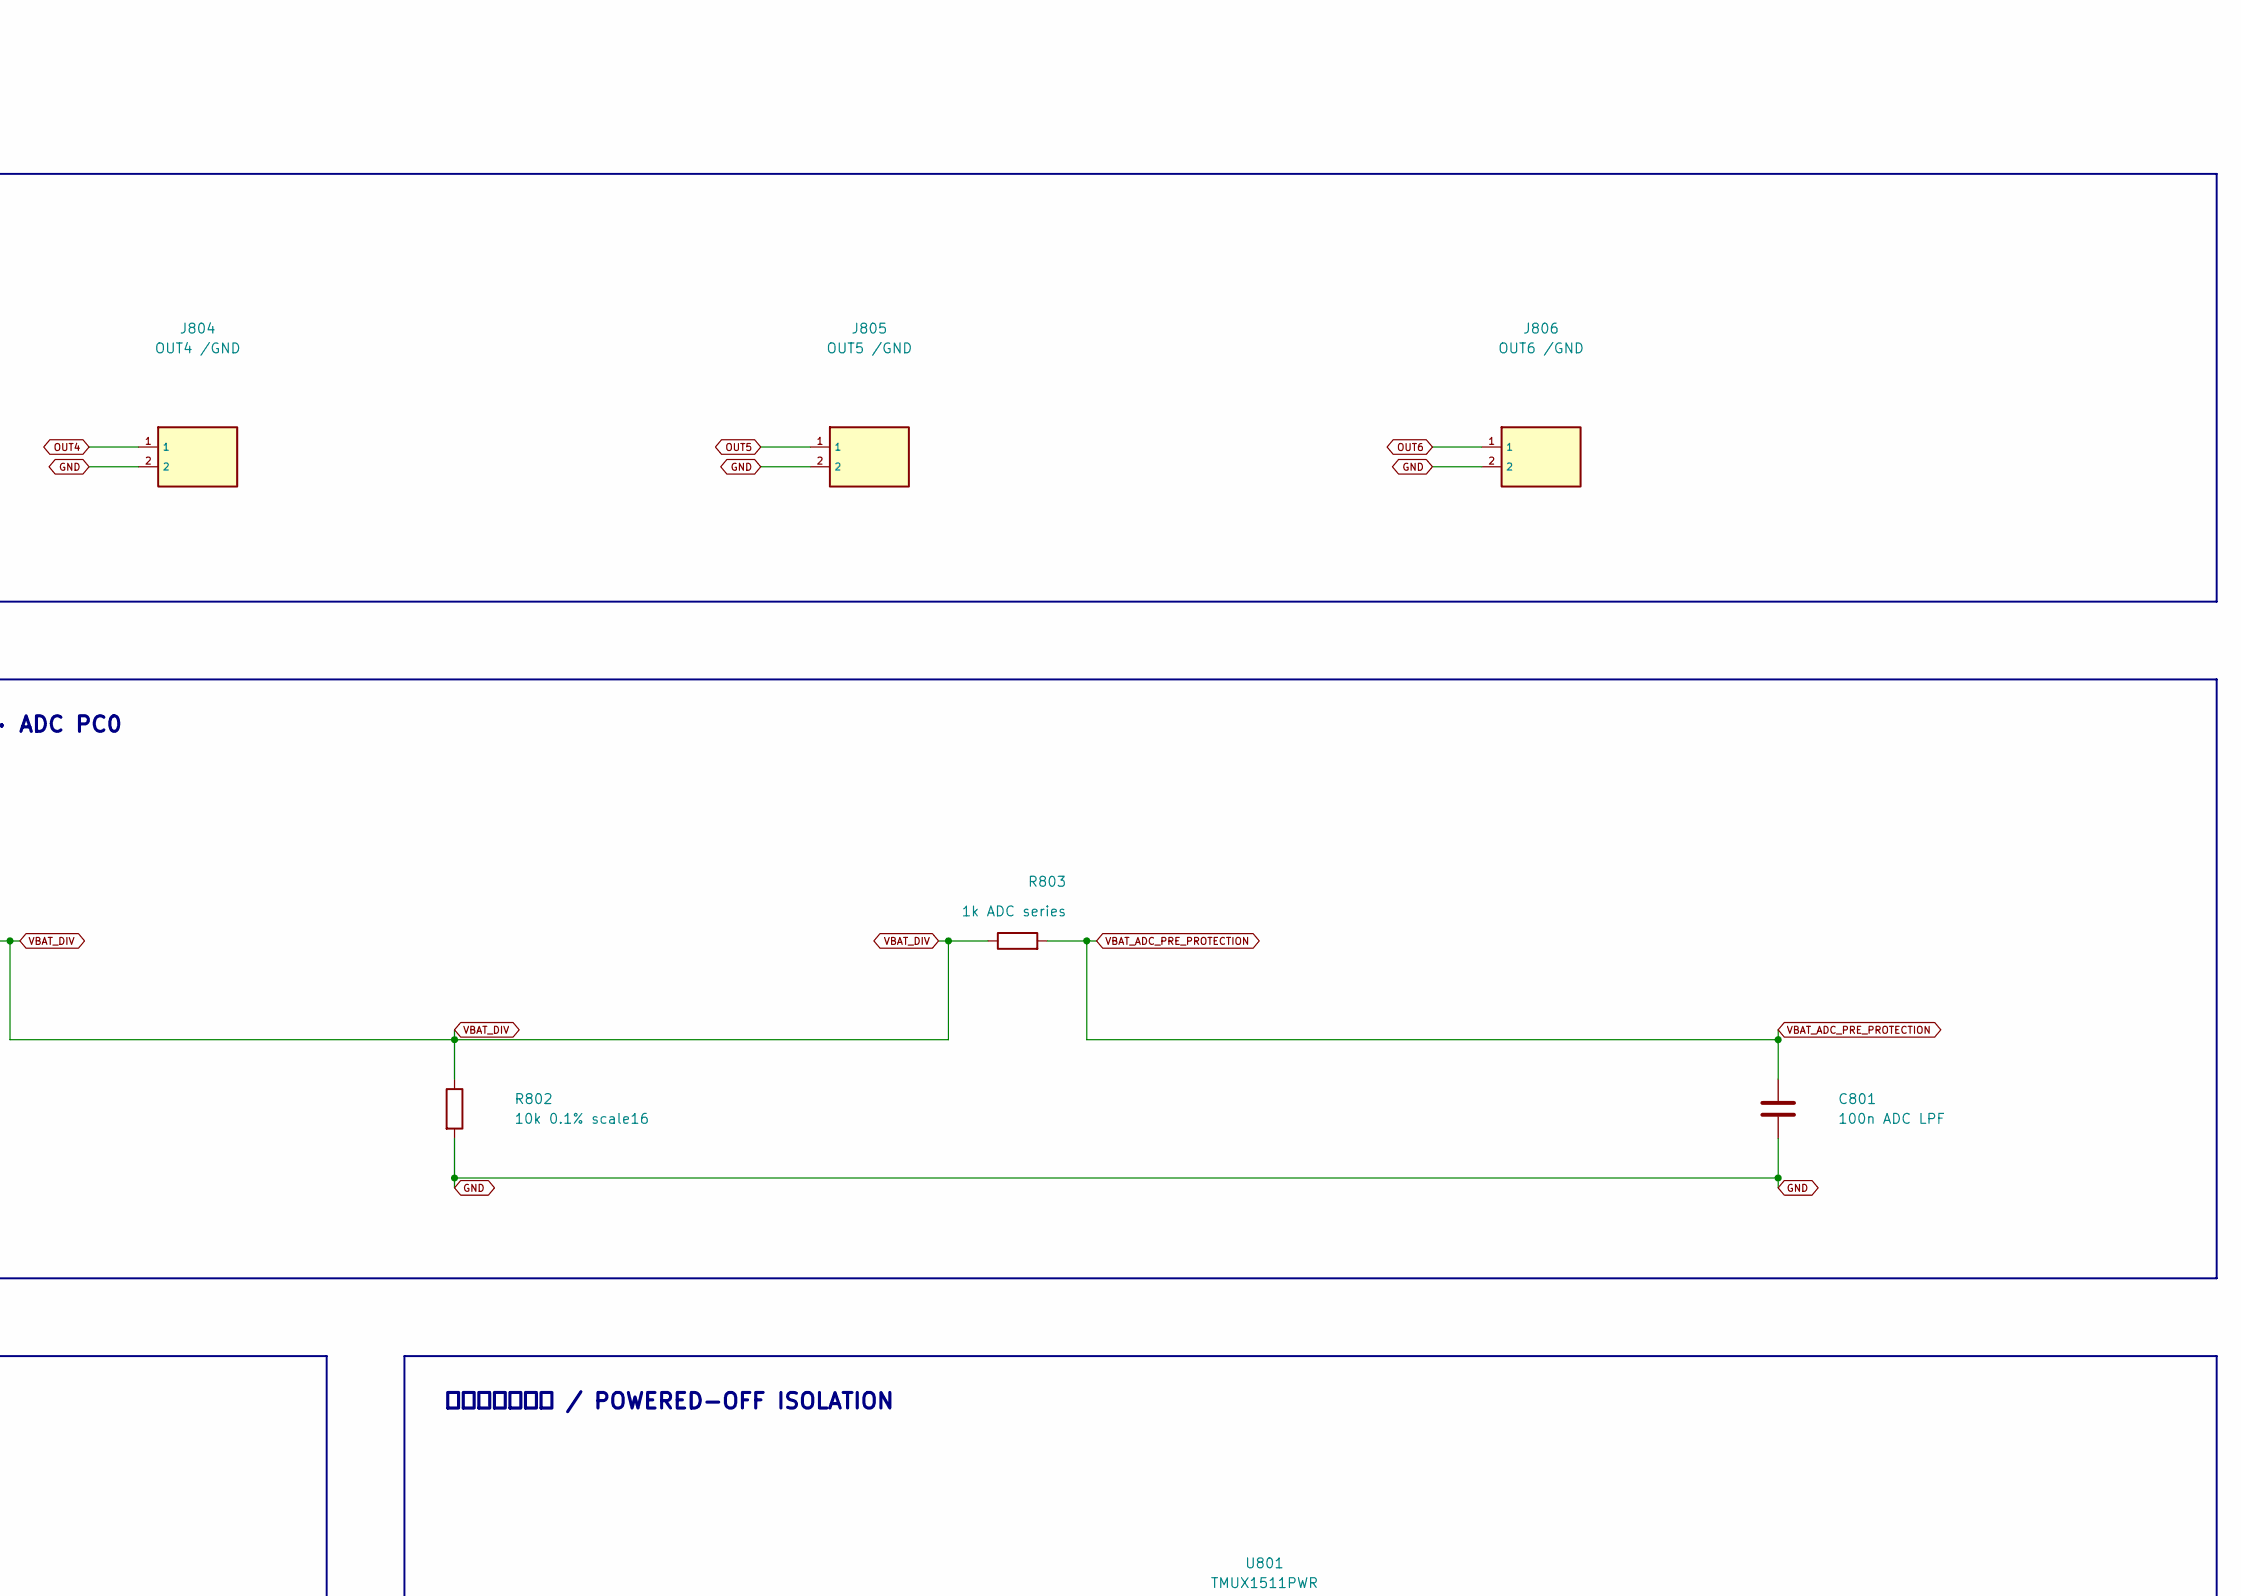
[picture p72: schematic 08_PWM_ADC_DEBUG.kicad_sch, part in row 1, column 2]

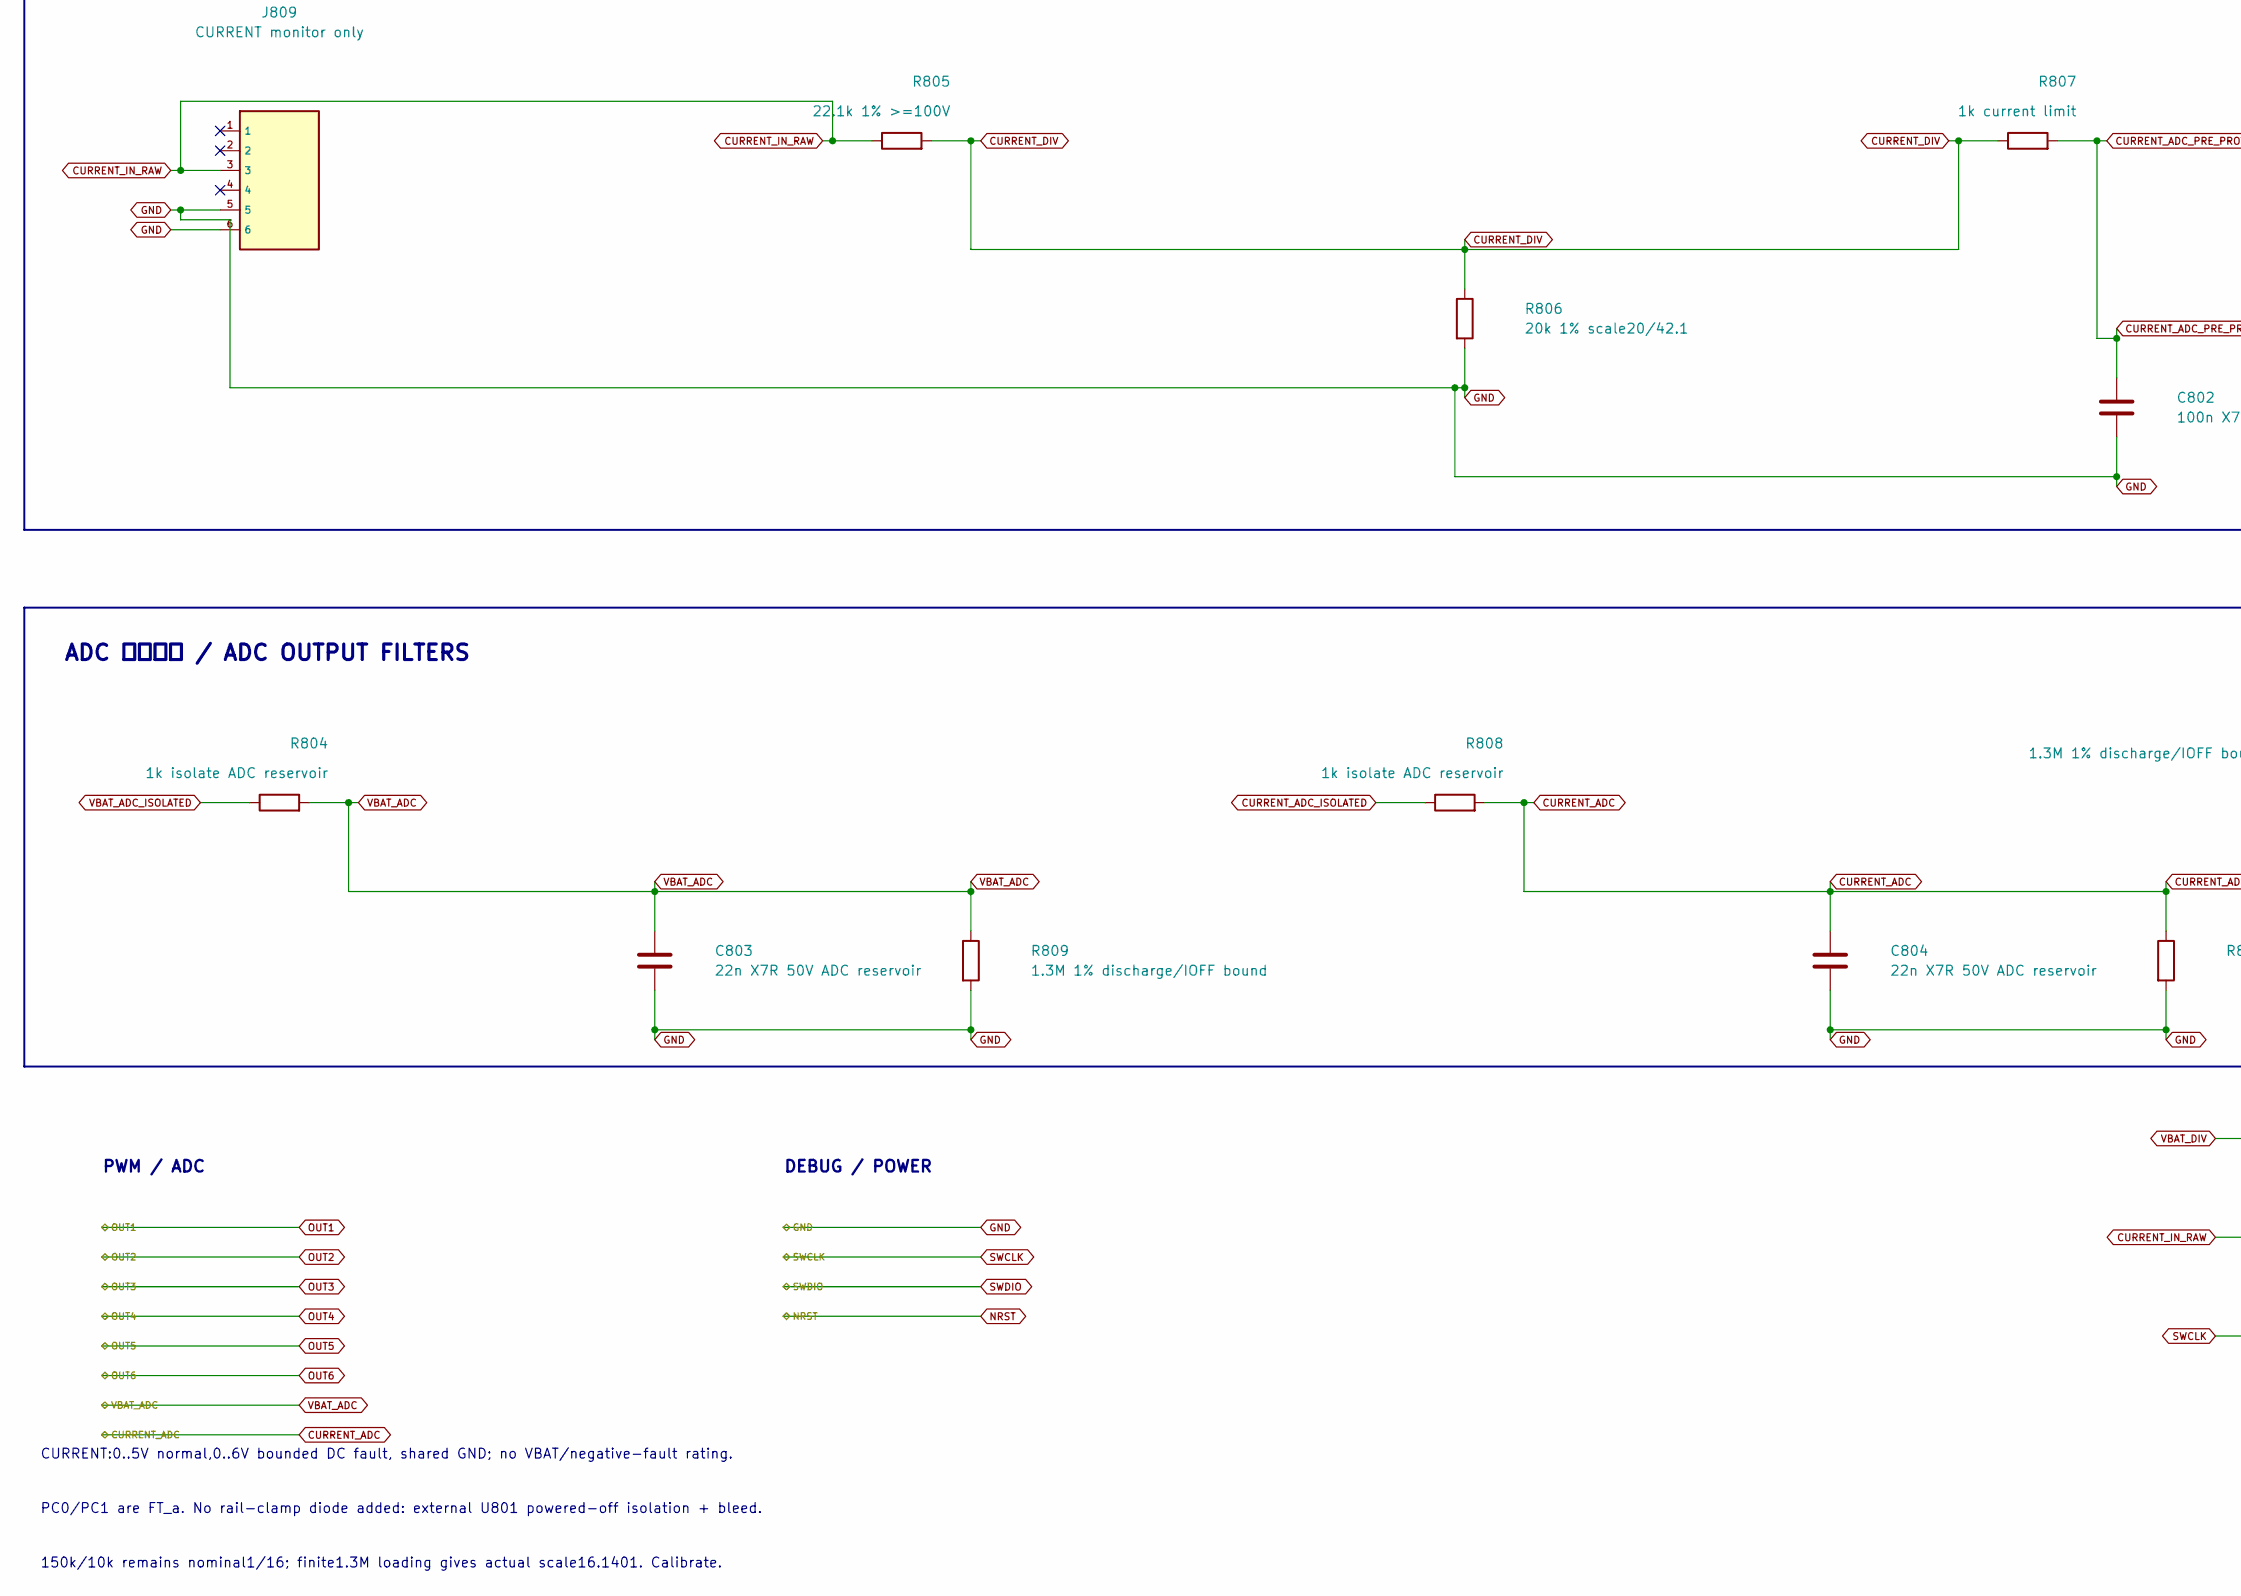
[picture p73: schematic 08_PWM_ADC_DEBUG.kicad_sch, part in row 2, column 1]

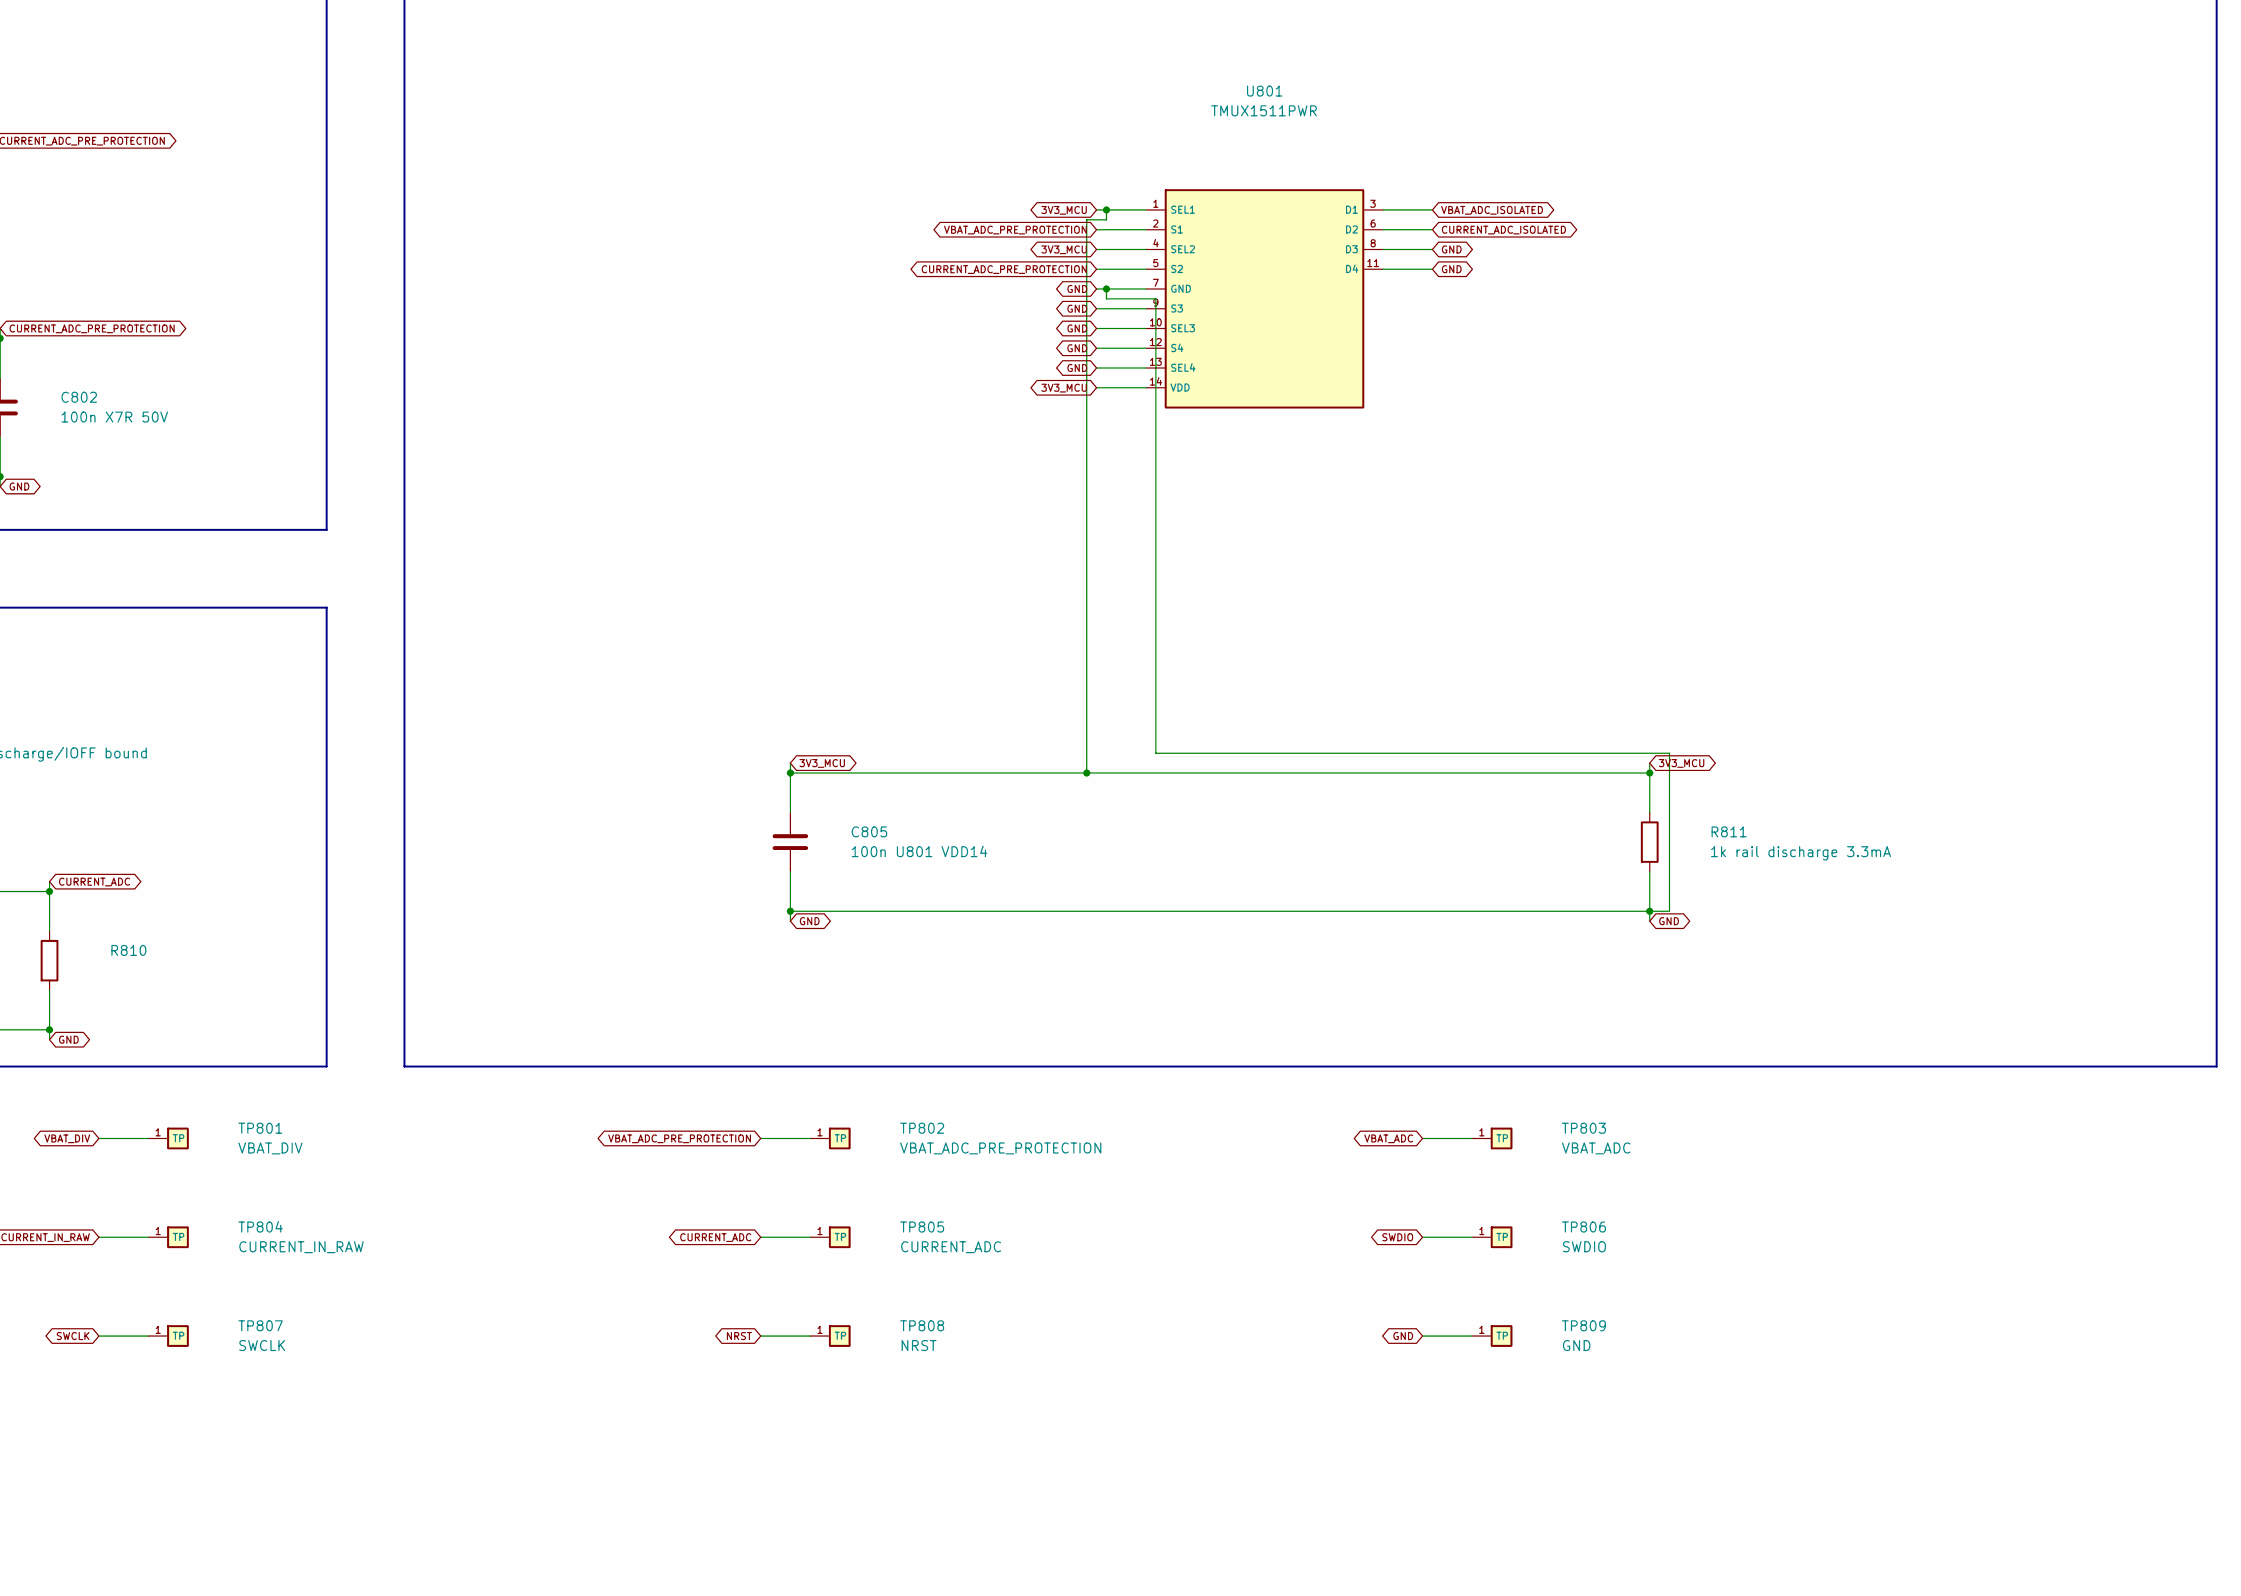
[picture p74: schematic 08_PWM_ADC_DEBUG.kicad_sch, part in row 2, column 2]

Parts:
C801: 100n ADC LPF; Official_Capacitor_SMD_C_0805_2012Metric; Tolerance 10%; Voltage Rating >=50V; MPN C0805C104K5RACTU
C802: 100n X7R 50V; Official_Capacitor_SMD_C_0805_2012Metric; Tolerance 10%; Voltage Rating >=50V; MPN C0805C104K5RACTU
C803, C804: 22n X7R 50V ADC reservoir; Official_Capacitor_SMD_C_0805_2012Metric; Tolerance 10%; Voltage Rating >=50V; MPN C0805C223K5RACTU
C805: 100n U801 VDD14; Official_Capacitor_SMD_C_0603_1608Metric; Tolerance 10%; Voltage Rating >=50V; MPN C0603C104K5RACTU
J801: OUT1 /GND; Samtec_TSW10207GS_1x2_P2p54; MPN TSW-102-07-G-S
J802: OUT2 /GND; Samtec_TSW10207GS_1x2_P2p54; MPN TSW-102-07-G-S
J803: OUT3 /GND; Samtec_TSW10207GS_1x2_P2p54; MPN TSW-102-07-G-S
J804: OUT4 /GND; Samtec_TSW10207GS_1x2_P2p54; MPN TSW-102-07-G-S
J805: OUT5 /GND; Samtec_TSW10207GS_1x2_P2p54; MPN TSW-102-07-G-S
J806: OUT6 /GND; Samtec_TSW10207GS_1x2_P2p54; MPN TSW-102-07-G-S
J807: SWD:1REF2GND3IO4CLK5NRST; Samtec_TSW10507GS_1x5_P2p54; MPN TSW-105-07-G-S
J808: BATTERY/bench3S-6S ONLY; VBAT_PAD_PAIR_V1; MPN VBAT_PAD_PAIR_V1
J809: CURRENT monitor only; Official_Connector_JST_JST_GH_SM06B-GHS-TB_1x06-1MP_P1.25mm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; MPN SM06B-GHS-TB(LF)(SN)
R801: 150k 0.1%; Official_Resistor_SMD_R_0805_2012Metric; Tolerance 0.1%; TCR<=25ppm/C; Voltage Rating >=100V; MPN RT0805BRD07150KL
R802: 10k 0.1% scale16; Official_Resistor_SMD_R_0805_2012Metric; Tolerance 0.1%; TCR<=25ppm/C; Voltage Rating >=100V; MPN RT0805BRD0710KL
R803: 1k ADC series; Official_Resistor_SMD_R_0805_2012Metric; Tolerance 1%; TCR<=100ppm/C; Voltage Rating >=100V; MPN RC0805FR-071KL
R804, R808: 1k isolate ADC reservoir; Official_Resistor_SMD_R_0805_2012Metric; Tolerance 1%; TCR<=100ppm/C; Voltage Rating >=100V; MPN RC0805FR-071KL
R805: 22.1k 1% >=100V; Official_Resistor_SMD_R_0805_2012Metric; Tolerance 1%; TCR<=100ppm/C; Voltage Rating >=100V; MPN RC0805FR-0722K1L
R806: 20k 1% scale20/42.1; Official_Resistor_SMD_R_0805_2012Metric; Tolerance 1%; TCR<=100ppm/C; Voltage Rating >=100V; MPN RC0805FR-0720KL
R807: 1k current limit; Official_Resistor_SMD_R_0805_2012Metric; Tolerance 1%; TCR<=100ppm/C; Voltage Rating >=100V; MPN RC0805FR-071KL
R809, R810: 1.3M 1% discharge/IOFF bound; Official_Resistor_SMD_R_0805_2012Metric; Tolerance 1%; TCR<=100ppm/C; Voltage Rating >=100V; MPN RC0805FR-071M3L
R811: 1k rail discharge 3.3mA; Official_Resistor_SMD_R_0805_2012Metric; Tolerance 1%; TCR<=100ppm/C; Voltage Rating >=100V; MPN RC0805FR-071KL
TP801: VBAT_DIV; TP1p5_NoPaste; MPN TP1p5
TP802: VBAT_ADC_PRE_PROTECTION; TP1p5_NoPaste; MPN TP1p5
TP803: VBAT_ADC; TP1p5_NoPaste; MPN TP1p5
TP804: CURRENT_IN_RAW; TP1p5_NoPaste; MPN TP1p5
TP805: CURRENT_ADC; TP1p5_NoPaste; MPN TP1p5
TP806: SWDIO; TP1p5_NoPaste; MPN TP1p5
TP807: SWCLK; TP1p5_NoPaste; MPN TP1p5
TP808: NRST; TP1p5_NoPaste; MPN TP1p5
TP809: GND; TP1p5_NoPaste; MPN TP1p5
U801: TMUX1511PWR; Official_Package_SO_TSSOP-14_4.4x5mm_P0.65mm; MPN TMUX1511PWR

Connections:
3V3_MCU: C805.1, J807.1, R811.1, U801.1 (SEL1), U801.4 (SEL2), U801.14 (VDD); also elsewhere on the board
CURRENT_ADC: C804.1, R808.2, R810.1, TP805.1 (TP_1); also elsewhere on the board
CURRENT_ADC_ISOLATED: R808.1, U801.6 (D2)
CURRENT_ADC_PRE_PROTECTION: C802.1, R807.2, U801.5 (S2)
CURRENT_DIV: R805.2, R806.1, R807.1
CURRENT_IN_RAW: J809.3, R805.1, TP804.1 (TP_1)
GND: C801.2, C802.2, C803.2, C804.2, C805.2, J801.2, J802.2, J803.2, J804.2, J805.2, J806.2, J807.2, J808.2 (GND-), J809.5, J809.6, R802.2, R806.2, R809.2, R810.2, R811.2, TP809.1 (TP_1), U801.7 (GND), U801.8 (D3), U801.9 (S3), U801.10 (SEL3), U801.11 (D4), U801.12 (S4), U801.13 (SEL4); also elsewhere on the board
NRST: J807.5, TP808.1 (TP_1); also elsewhere on the board
OUT1: J801.1; also elsewhere on the board
OUT2: J802.1; also elsewhere on the board
OUT3: J803.1; also elsewhere on the board
OUT4: J804.1; also elsewhere on the board
OUT5: J805.1; also elsewhere on the board
OUT6: J806.1; also elsewhere on the board
SWCLK: J807.4, TP807.1 (TP_1); also elsewhere on the board
SWDIO: J807.3, TP806.1 (TP_1); also elsewhere on the board
VBAT_ADC: C803.1, R804.2, R809.1, TP803.1 (TP_1); also elsewhere on the board
VBAT_ADC_ISOLATED: R804.1, U801.3 (D1)
VBAT_ADC_PRE_PROTECTION: C801.1, R803.2, TP802.1 (TP_1), U801.2 (S1)
VBAT_DIV: R801.2, R802.1, R803.1, TP801.1 (TP_1)
VBAT_PROTECTED: R801.1; also elsewhere on the board
VBAT_RAW: J808.1 (VBAT_RAW+); also elsewhere on the board

Notes on the sheet:
PWM signal+GND only. Custom SWD5pin. Pack current NEVER passes through board.
CURRENT:0..5V normal,0..6V bounded DC fault, shared GND; no VBAT/negative-fault rating.
PC0/PC1 are FT_a. No rail-clamp diode added: external U801 powered-off isolation + bleed.
150k/10k remains nominal1/16; finite1.3M loading gives actual scale16.1401. Calibrate.
08 PWM / ADC / 调试 · PWM / ADC / DEBUG
六路 PWM 输出 / SIX PWM OUTPUTS
SWD 调试与电池输入 / SWD AND BATTERY INPUT
电压采样 / VOLTAGE SENSE · ADC PC0
电流输入采样 / CURRENT INPUT · ADC PC1
掉电隔离与保持 / POWERED-OFF ISOLATION
ADC 输出滤波 / ADC OUTPUT FILTERS
PWM / ADC
DEBUG / POWER

Board: 4 copper layers, 205 parts (85 on the bottom side), 87 nets, no tracks yet.

Other parts of the board:
H1, H2, H3, H4: MountingHole_4mm
