chen123037/X100-Flight-Controller-Edu/(commit log)

2026-10-13 Initial public teaching baseline: X100 V1 pre-routing
    [01_POWER.kicad_sch, 02_MCU.kicad_sch, 03_SENSORS.kicad_sch, 04_USB.kicad_sch, 05_SD.kicad_sch, 06_CAN.kicad_sch, 07_UART_IO.kicad_sch, 08_PWM_ADC_DEBUG.kicad_sch]
2026-10-13 Complete Chinese public handoff documentation
    [X100_V1_PROCUREMENT_LIST.csv]
2026-10-14 Refactor X100 schematics for readability
    [01_POWER.kicad_sch, 02_MCU.kicad_sch, 03_SENSORS.kicad_sch, 04_USB.kicad_sch, 05_SD.kicad_sch, 06_CAN.kicad_sch, 07_UART_IO.kicad_sch, 08_PWM_ADC_DEBUG.kicad_sch]
2026-10-22 fix(pcb): close J601 clearance and stage unapproved J401 review
    [01_POWER.kicad_sch, 02_MCU.kicad_sch, 03_SENSORS.kicad_sch, 04_USB.kicad_sch, 05_SD.kicad_sch, 06_CAN.kicad_sch, 07_UART_IO.kicad_sch, 08_PWM_ADC_DEBUG.kicad_sch]
2026-10-22 docs(pcb): hold J401 candidate after board-edge and thickness review
    [PCB_READINESS_CHECK.json]
2026-10-22 fix(pcb): apply approved Amphenol J401 with native netlist sync
    [04_USB.kicad_sch, NATIVE_BOM.csv, PCB_READINESS_CHECK.json, X100_CleanSheet.kicad_pcb, X100_V1_BOM.csv, X100_V1_PROCUREMENT_LIST.csv, component_status.csv]
2026-10-22 fix(pcb): improve testpoint clearance and synchronize schematic fields
    [X100_CleanSheet.kicad_pcb]
2026-10-22 保存USB分阶段供电候选、电流预算与首板测试计划
    [01_POWER.kicad_sch, 02_MCU.kicad_sch, 03_SENSORS.kicad_sch, 04_USB.kicad_sch, 05_SD.kicad_sch, 06_CAN.kicad_sch, 07_UART_IO.kicad_sch, 08_PWM_ADC_DEBUG.kicad_sch]
2026-10-22 紧凑测试点保留65处可测性并消除46对courtyard重叠
    [01_POWER.kicad_sch, 02_MCU.kicad_sch, 03_SENSORS.kicad_sch, 04_USB.kicad_sch, 05_SD.kicad_sch, 06_CAN.kicad_sch, 07_UART_IO.kicad_sch, 08_PWM_ADC_DEBUG.kicad_sch]
2026-10-22 准备保持8MHz的Y201紧凑晶体候选及原生检查证据
    [01_POWER.kicad_sch, 02_MCU.kicad_sch, 03_SENSORS.kicad_sch, 04_USB.kicad_sch, 05_SD.kicad_sch, 06_CAN.kicad_sch, 07_UART_IO.kicad_sch, 08_PWM_ADC_DEBUG.kicad_sch]
2026-10-22 按原厂100ppm温漂更正R205候选并重算启动筛查
    [02_MCU.kicad_sch, X100_CleanSheet.kicad_pcb]
2026-10-22 关闭右侧接口间及J703安装孔净空冲突
    [X100_CleanSheet.kicad_pcb]
2026-10-22 消除45对测试点及阻容装配庭院冲突
    [X100_CleanSheet.kicad_pcb]
2026-10-22 调整MCU储能电容与SWD排针释放局部空间
    [X100_CleanSheet.kicad_pcb]
2026-10-22 整体平移MCU局部去耦释放ADC侧布局空间
    [X100_CleanSheet.kicad_pcb]
2026-10-22 提供L101紧凑电感候选并修复候选库SMD属性
    [01_POWER.kicad_sch, 02_MCU.kicad_sch, 03_SENSORS.kicad_sch, 04_USB.kicad_sch, 05_SD.kicad_sch, 06_CAN.kicad_sch, 07_UART_IO.kicad_sch, 08_PWM_ADC_DEBUG.kicad_sch]
2026-10-22 推进USB供电候选门控I2C并恢复独立电源指示
    [01_POWER.kicad_sch, 02_MCU.kicad_sch, 03_SENSORS.kicad_sch, 04_USB.kicad_sch, 05_SD.kicad_sch, 06_CAN.kicad_sch, 07_UART_IO.kicad_sch, 08_PWM_ADC_DEBUG.kicad_sch]
2026-10-22 记录并拒绝存在实体冲突的供电布局试排
2026-10-22 评估合并USB供电候选并保留真实布局与启动边界
    [01_POWER.kicad_sch, 02_MCU.kicad_sch, 03_SENSORS.kicad_sch, 04_USB.kicad_sch, 05_SD.kicad_sch, 06_CAN.kicad_sch, 07_UART_IO.kicad_sch, 08_PWM_ADC_DEBUG.kicad_sch]
2026-10-23 Adopt approved L101 SRP1038A and review actual 5V load
    [01_POWER.kicad_sch, X100_CleanSheet.kicad_pcb, X100_V1_BOM.csv, X100_V1_PROCUREMENT_LIST.csv, component_status.csv]
2026-10-23 Save partial main power copper and ground return checkpoint
    [01_POWER.kicad_sch, 02_MCU.kicad_sch, 03_SENSORS.kicad_sch, 04_USB.kicad_sch, 05_SD.kicad_sch, 06_CAN.kicad_sch, 07_UART_IO.kicad_sch, 08_PWM_ADC_DEBUG.kicad_sch]
2026-10-23 Place complete minimal USB candidate on the 45mm board
    [01_POWER.kicad_sch, 02_MCU.kicad_sch, 03_SENSORS.kicad_sch, 04_USB.kicad_sch, 05_SD.kicad_sch, 06_CAN.kicad_sch, 07_UART_IO.kicad_sch, 08_PWM_ADC_DEBUG.kicad_sch]
2026-10-23 Clear all four 7mm mounting envelopes in the complete USB layout
    [MOUNTING7_RESOLUTION.csv, X100_CleanSheet.kicad_pcb]
2026-10-23 Clear MCU-IMU routing channel in the complete USB candidate
    [MOUNTING7_RESOLUTION.csv, X100_CleanSheet.kicad_pcb]
2026-10-23 Route main Buck controls and ground in the unified X100 candidate
    [X100_CleanSheet.kicad_pcb]
2026-10-23 Connect the X100 protected battery input and verify its copper plane
    [X100_CleanSheet.kicad_pcb]
2026-10-23 Route 5V main distribution and preserve isolated feedback sense
    [X100_CleanSheet.kicad_pcb]
2026-10-23 Route external 5V protection and restore input copper capacity
    [X100_CleanSheet.kicad_pcb]
2026-10-23 Route core power mux and local 3V3 regulator supply
    [X100_CleanSheet.kicad_pcb]
2026-10-23 Route first MCU supply pass and expose remaining power islands
    [X100_CleanSheet.kicad_pcb]
2026-10-23 Connect all MCU VDD and GND with partitioned 3V3 plane
    [X100_CleanSheet.kicad_pcb]
2026-10-24 Route HSE and USB and extend switched SD power
    [X100_CleanSheet.kicad_pcb]
2026-10-25 归档 X100 c8 工程与中文独立评审包
    新增可打开的c8源工程、c7回退、中文PDF/定位图和可下载评审ZIP；同步首页、状态、接手及路线图。
    保留60项源CAD字节和旧正式源；当前仍96项未连接，电源/装配/制造审核未完成，不能下单。
    [01_POWER.kicad_sch, 02_MCU.kicad_sch, 03_SENSORS.kicad_sch, 04_USB.kicad_sch, 05_SD.kicad_sch, 06_CAN.kicad_sch, 07_UART_IO.kicad_sch, 08_PWM_ADC_DEBUG.kicad_sch]
2026-10-31 发布X100六层DFM零危险资料与当前器件采购清单
    归档当前六层V4的61项原生源文件、制造ZIP、真实DFM/ERC/DRC证据和完整下载包。更新当前入口及62种MPN、142件每板用量的淘宝搜索清单。保留整板热审查和实际工厂工艺接受未闭合状态，不合并main、不采购或下单。
    [01_POWER.kicad_sch, 02_MCU.kicad_sch, 03_SENSORS.kicad_sch, 04_USB.kicad_sch, 05_SD.kicad_sch, 06_CAN.kicad_sch, 07_UART_IO.kicad_sch, 08_PWM_ADC_DEBUG.kicad_sch]
2026-10-31 补充62种器件真实商品货源核查及同封装候选
    逐项核对国内立创商品详情的型号、库存、起订量和交期；区分54种自营足量、2种原型代购、5组供货缺口候选及SPL06用户确认淘宝有售。保留访问受限和未核实字段，不改工程、制造输入或原BOM，不采用候选、不下单。
    [62种原型号_已核商品货源.csv, X100_62种器件_实际货源核查.xlsx, 同封装替代候选_未改工程.csv]
